triunex/HPVE-Fallen/hardware/master_carrier/renders/pcb_bottom.png

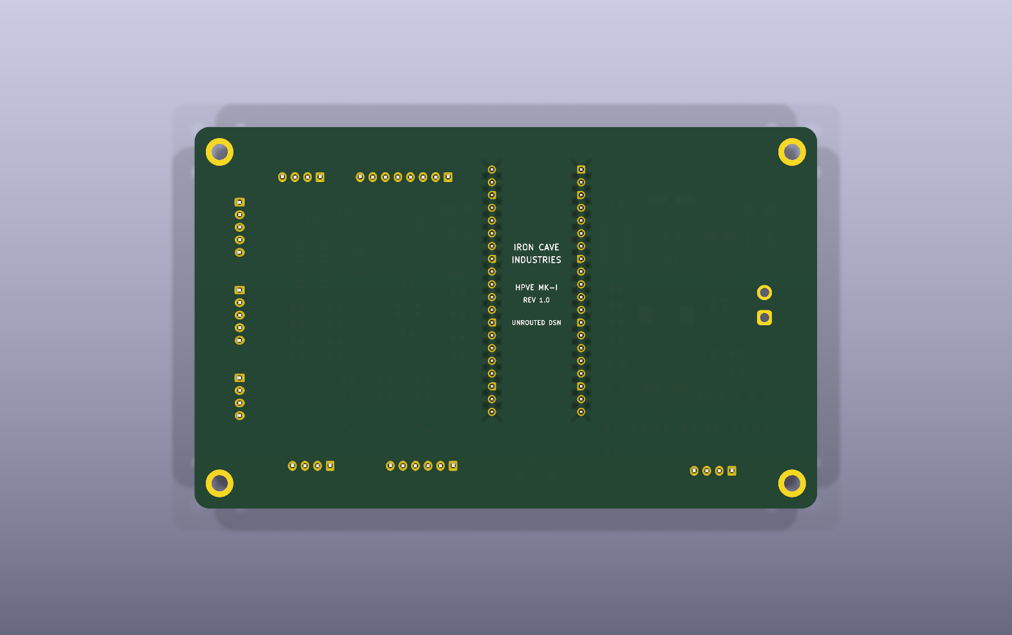
hardware/master_carrier/renders/pcb_bottom.png
