triunex/HPVE-Fallen/hardware/master_carrier/renders/pcb_iso.png

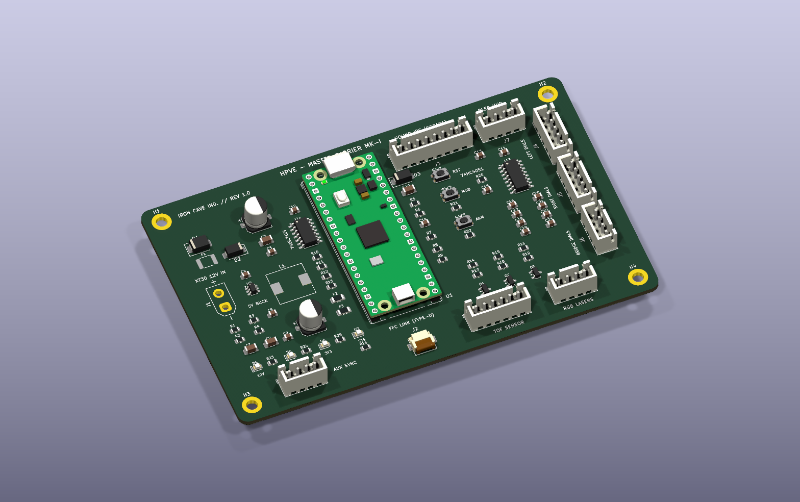
hardware/master_carrier/renders/pcb_iso.png
