triunex/HPVE-Fallen/CAMPAIGN_ROADMAP_45_DAYS.md

# HPVE 45-DAY MASTER EXPEDITION MANIFEST
## Target: 2,500+ XP | Hack Club Fallen | Maker Faire Shenzhen 2026
### Operative: nelieo.shorya | Division: Iron Cave Industries | Companion: Sami (Team Sami 🦊 - STAGE 2 EVOLVED!)

```
==================================================================================================
           HAPTIC PHOTONIC VOLUMETRIC ENGINE (HPVE) - 45-DAY CAMPAIGN ROADMAP
==================================================================================================
  MISSION TARGET: 2,500+ XP (1,000 XP Qualification + $1,500+ USD Travel Stipend Reimbursement)
  COMPANION: SAMI (STAGE 2 UNLOCKED!) | STREAK STRATEGY: 1.00x -> 1.15x -> 1.75x MAX ACCELERATOR
  ARCHITECTURE: OPEN-AIR MODULAR PHASED-ARRAY TILES + OVERHEAD RAIL RIG (STARK MALIBU LAB)
  CRITICAL HARD STOP: DECEMBER 9TH, 2026 (11:59 PM ET)
  EXPEDITION DATES: DECEMBER 11 - 14, 2026 @ MAKER FAIRE SHENZHEN, CHINA
==================================================================================================
```

---

## 1. Real-Time Telemetry & XP Dashboard

| Metric | Target Value | Current Value | Status |
|---|---|---|---|
| **Total XP Accumulated** | 2,500 XP | **1,043 XP** | 🏆 **1,000+ XP CLUB UNLOCKED! SHENZHEN FINAL FORM QUALIFIED!** |
| **Current Multiplier** | 1.75x (Max) | **1.30x** (Active Streak) | ⚡ 3 Freezes Preserved (Diwali Streak Unbroken!) |
| **Overall Logged Time** | 200+ Hours | **108h 10m** (14 Journals) | 🚀 **108+ Hours of Relentless Deep-Tech Engineering Logged!** |
| **Team Sami Standings** | Team Victory | **15,493+ XP** | 🦊 Team Sami Dominating (vs Lulu 9,742 XP)! |
| **Visa Invitation Gate** | 100 XP (Required) | **1,043 / 100 XP (1043%)** | 🏆 UNLOCKED (Eligible for F-Visa Invitation) |
| **Need-Based Flight Gate** | 500 XP ($1,000 Grant) | **1,043 / 500 XP (208.6%)** | ✈️ **UNLOCKED! ELIGIBLE FOR $1,000 USD FLIGHT GRANT!** |
| **Shenzhen Qualifier Gate** | 1,000 XP (Final Form) | **1,043 / 1,000 XP (104.3%)** | 🏆 **1,000 XP SHENZHEN QUALIFIER SHATTERED! (Stage 3/4 Final Form Unlocked!)** |
| **Cash Stipend Surplus** | $1,500 USD (2,500 XP) | **$43.00 USD** | 💰 Accumulating ($1/XP above 1,000 XP toward travel budget!) |
| **Stage Progression** | Stage 3 ➔ Stage 4 | **Stage 3 Apex (1,043 XP)** | 🦊 **FINAL FORM UNLOCKED UPON PROJECT APPROVAL!** |
| **Days Remaining** | 29 Days to Hard Stop | **29 Days** | 🟢 MASSIVE RUNWAY (NEARLY 1 MONTH TO SPARE!) |

---

## 2. The 6 Strategic Phase Banners

```
[PHASE 01: DAYS 01-07] PHYSICS, 0-DRC MODULAR TILE PCB, PIO+DMA & 3D TRAJECTORY ENGINE (XP: 0000 -> 0420+) [IN PROGRESS]
[PHASE 02: DAYS 08-14] GANTRY CAD, TOF FORCEFIELD SENSOR, HOLO-CONSOLE & 500 XP GRANT  (XP: 0420 -> 0700+)
[PHASE 03: DAYS 15-21] PROCUREMENT, BENCH RIG, MULTI-TILE SYNC & ACOUSTIC CALIBRATION  (XP: 0700 -> 1050+)
[PHASE 04: DAYS 22-28] PCBA ARRIVAL, TRANSDUCER ARRAY ASSEMBLY & 1,000 XP QUALIFIER    (XP: 1050 -> 1450+)
[PHASE 05: DAYS 29-35] MAKER FAIRE 3-DEMO MASTERY: ARC REACTOR, MÖBIUS & FORCEFIELD    (XP: 1450 -> 1950+)
[PHASE 06: DAYS 36-45] CINEMATIC REEL, BUILD SUBMISSION, PACKING & SHENZHEN SHOWCASE   (XP: 1950 -> 2500+)
```

---

## PHASE 01: PHYSICS, 0-DRC MODULAR TILE PCB, PIO+DMA & 3D TRAJECTORY ENGINE (DAYS 1 - 7)
### Multiplier: 1.00x ➔ 1.15x | Base Rate: 8.0 ➔ 9.2 XP / Hour | Goal: 420+ XP | Unlock: Visa Letter (>100 XP)

---

### DAY 01: Friday, October 30, 2026 — MISSION INITIATION & EGG HATCH
- **Target Hours:** 2h 04m | **Actual XP Banked:** +25 XP | **Running XP Total:** 25 XP
- **Focus:** Mathematical Validation, Git Setup, Project Genesis, Sami Hatching
- [x] **Task 1.1:** Clone and initialize official repository `HPVE-Fallen` on GitHub.
- [x] **Task 1.2:** Fix syntax error in `hpve_physics_model.py` and verify focal calculation.
- [x] **Task 1.3:** Execute `verify_hpve.py` — proved 142.4x focal pressure ratio at 20cm height.
- [x] **Task 1.4:** Generate real 2D acoustic pressure heatmap (`simulation/acoustic_field_simulation.png`).
- [x] **Task 1.5:** Write lean, justified `hardware/bom.csv` with live supplier links ($187.85 budget).
- [x] **Task 1.6:** Draft RP2040 PIO state machine pulse generator (`firmware/pio_40khz_phased.pio`).
- [x] **Task 1.7:** Author system electrical wiring architecture (`hardware/PINOUT_ARCHITECTURE.md`).
- [x] **Task 1.8:** Create HPVE project on Fallen Dashboard.
- [x] **Task 1.9:** Log Session 1 (35m) in `#fallen-journals` — **SAMI HATCHED! 25 XP BANKED!**
- [x] **Task 1.10 (DAY 1 SPRINT COMPLETE):**
  - Generated KiCad hierarchical schematic architecture (`hardware/kicad/HPVE_Controller.kicad_pro`).
  - Executed shift-register timing simulation: verified 20MHz SPI loads 64 channels in 3.25us (87% timing margin).
  - Generated timing analysis chart (`simulation/shift_register_timing_analysis.png`).
  - Resolved 105 component footprints across 4 hierarchical sheets and routed initial 64-ch layout.
  - Exported RS-274X Gerber layers, Excellon drill files, centroid file, and `FABRICATION_NOTES.md`.
  - Committed and pushed all 34 files to GitHub (`main`).

---

### DAY 02: Saturday, October 31, 2026 — TRANSDUCER RESONANCE & IMPEDANCE DYNAMICS
- **Target Hours:** 3h 00m | **Actual Logged Today:** 4h 11m | **Actual XP Banked:** +33 XP | **Running XP Total:** 68 XP
- **Focus:** Transducer electrical characteristics and 400ST160 resonant curve
- [x] **Task 2.1:** Create `simulation/transducer_impedance_model.py`: model the 40 kHz Butterworth-Van Dyke (BVD) series resonance ($C_0 = 2.2\text{ nF}, C_m = 123.2\text{ pF}, L_m = 128.5\text{ mH}, R_m = 922.7\,\Omega$).
- [x] **Task 2.2:** Calculate reactive current consumption: 11.11 mA RMS per channel, 0.711 A total continuous array RMS current at 12Vpp.
- [x] **Task 2.3:** Calculate thermal dissipation across all 32x TC4427 driver IC packages: 30.15 mW per IC, $3.8^\circ\text{C}$ junction temperature rise.
- [x] **Task 2.4:** Determine optimum bulk decoupling capacitor values on the +12V power rail: minimum $16.90\,\mu\text{F}$ for $<100\text{ mV}$ droop, validating our $100\,\mu\text{F}$ low-ESR bulk rail.
- [x] **Task 2.5:** Journal entry: "Why 64 transducers act like a giant capacitive sponge (and how not to burn the lab down)". Logged 4h 11m, +33 XP banked! Total: 68 XP!

---

### DAY 03: Sunday, November 01, 2026 — 3D GOR'KOV ACOUSTIC TRAP POTENTIAL & OPEN-AIR VORTEX PHYSICS
- **Target Hours:** 3h 30m | **Actual Logged Today:** 7h 00m | **Actual XP Banked:** +56 XP | **Running XP Total:** 124 XP (100 XP VISA MILESTONE SURPASSED!)
- **Focus:** Open-air single-sided holographic trapping physics, 3D Gor'kov potential well, and mid-air 200 Hz tactile forcefield math
- [x] **Task 3.1:** Write `simulation/gorkov_potential.py` & `simulation/single_sided_vortex_trap.py`: implement the full 3D Gor'kov acoustic potential equation with 64-element Bessel circular piston directivity and Euler velocity gradients.
- [x] **Task 3.2:** Plot 3D potential well showing the stable open-air trapping zone at 50–55 mm focal height ($U_{\min} = -26.62\text{ nJ}$).
- [x] **Task 3.3:** Calculate maximum axial and lateral trapping stiffness ($F = -\nabla U$): lateral restoring force $\hat{F}_x = 9.84\,\mu\text{N}$, axial lift $\hat{F}_z = 2.27\,\mu\text{N}$ (2.21x safety margin over gravity).
- [x] **Task 3.4:** Compute mid-air haptic radiation pressure field on human skin mechanoreceptors: $P_{\mathrm{rad}} = 172.7\text{ Pa}$ peak, $F_{\mathrm{tactile}} = 5.84\text{ mN}$ integrated force over a 10 mm fingertip contact patch with 200 Hz Pacinian envelope modulation.
- [x] **Task 3.5:** Author `MALIBU_VOLUMETRIC_ENGINE_ARCHITECTURE.md`: complete architectural specification for the open-air Stark Malibu ceiling-rail projector and 3 signature Maker Faire demonstrations.
- [x] **Task 3.6:** Publish 12 standalone academic verification figures (`fig1` through `fig12`) and structured JSON metrics.
- [x] **Task 3.7:** Journal entry: "Session 2: 7 Hours in the Iron Cave — 3D Gor'kov Trapping, Dual-Core PIO Firmware, & 2,448-Track PCB Autoroute". Banked +56 XP! Total: 124 XP!

---

### DAY 04: Monday, November 02, 2026 — THE MODULAR TILE REVOLUTION & STAGE 2 UNLOCKED! 🦊
- **Target Hours:** 3h 00m | **Actual Logged Today:** 11h 21m (11.35h) | **Actual XP Banked:** +91 XP! | **Running XP Total:** 216 XP! (STAGE 2 UNLOCKED!)
- **Focus:** Complete Architectural Pivot to Scalable 16-Channel Modular Tile (`HPVE_Tile_16Ch`), 4-Layer High-Current Stackup, 0.5mm FFC Connectors, and Initial Fabrication Release
- [x] **Task 4.1:** **Architectural Pivot:** Engineered the modular, daisy-chainable 16-channel phased-array tile (`HPVE_Tile_16Ch`): 16 transducers (4x4 grid), 8x TC4427 dual MOSFET drivers (`U101..U108`), 2x 74HC595 shift registers (`U1, U2`) per tile.
- [x] **Task 4.2:** **4-Layer High-Current Stackup:** `F.Cu` (Top signals & SMT), `In1.Cu` (Solid GND plane), `In2.Cu` (`+12V_DRV` & `+5V` split power plane), `B.Cu` (Bottom signal routing).
- [x] **Task 4.3:** **Ultra-Low Profile FFC Daisy-Chaining:** Integrated 0.5mm pitch 6-pin horizontal FFC connectors (`J_IN`, `J_OUT`, Hirose FH12-6S-0.5SH) plus dedicated 2-pin `+12V_DRV` screw terminal (`J_PWR`).
- [x] **Task 4.4:** **HISTORIC MILESTONE: BANKED +91 XP IN 11h 21m MARATHON!**
  - Total XP surged to **216 XP** (+20 XP Stage 2 evolution bonus -> 236 XP)!
  - **STAGE 2 UNLOCKED!** Companion Sami evolved into a 9-tailed fox spirit form!

---

### DAY 05: Tuesday, November 03, 2026 — DFM OVERHAUL (SINGLE-SIDED PCBA, 0 DRC) & RP2040 PIO+DMA CASCADE FIRMWARE
- **Actual Logged Hours:** 11h 07m (11.07h) | **Actual XP Banked:** +102 XP (1.15x Multiplier) | **Running XP Total:** **338 XP** (Stage 2!)
- **Focus:** Complete Mechanical & DFM Overhaul (16.5mm Pitch, 10.0mm Lead Spacing, 100% Single-Sided Top SMT, 0 DRC), RP2040 Dual-Core PIO+DMA 64-Ch Cascade Engine, Q16.16 Holographic Solver & HIL Verification
- [x] **Task 5.1:** **Transducer Physical Footprint Audit:** Replaced generic 2.54mm sockets with custom 10.0mm lead-spacing footprints (`TX_400ST160_P10.0mm`, 1.0mm drill, 1.9mm pad) matching real 16mm Prowave 400ST160 ultrasonic cans.
- [x] **Task 5.2:** **Array Pitch & Board Outline Resize:** Increased transducer pitch from 10.5mm to **16.5mm** (0.3mm physical can-to-can clearance for 16.2mm cans) and resized tile to **98.0mm x 88.0mm** (within JLCPCB 100x100mm budget tier).
- [x] **Task 5.3:** **100% Single-Sided Top SMT (`F.Cu`) Conversion:** Migrated all 10 decoupling caps (`C1, C2, C101..C108`) to `F.Cu`, eliminating double-sided PCBA setup ($51.50) and second stencil fees (saving 60%+ of fabrication budget).
- [x] **Task 5.4:** **0 DRC Clean Clearance:** Fixed FreeRouting footprint ID export, resolved 77 KiCad annular/clearance violations, cleaned redundant vias, and verified **0 DRC errors, 0 warnings, 0 unconnected pads** (`hardware/modular_tile/DRC.rpt`).
- [x] **Task 5.5:** **Exported Production Package:** Generated updated Gerber archive (`HPVE_Tile_16Ch_Gerber.zip`), 26-part Top-SMT BOM (`HPVE_Tile_16Ch_bom.csv`), CPL (`HPVE_Tile_16Ch_cpl.csv`), and updated 3D raytraced renders.
- [x] **Task 5.6:** **RP2040 PIO Assembly Shift Engine (`cascade_spi.pio`):** Built 102.40 MHz state machine (`clkdiv = 1.25`) with side-set clock/latch, shifting 64 bits across 8 cascaded 74HC595 shift registers every 1.5625 us (16 phase bins/cycle = exact 40.000 kHz acoustic carrier).
- [x] **Task 5.7:** **Chained Ping-Pong DMA Engine (`pio_cascade_driver.c`):** Chained DMA channels A and B with atomic ping-pong swapping for gapless, zero-CPU wave emission.
- [x] **Task 5.8:** **Q16.16 Fixed-Point 3D Holographic Solver (`wave_solver.c`):** Implemented integer 64-bit square root, fixed-point `atan2`, and 6 operational modes (Twin Trap, Bottle Trap, Vortex OAM, 200 Hz Pacinian Haptic Focus, Volumetric POV, and SMF Dual Trap).
- [x] **Task 5.9:** **SSD1306 OLED HUD, Encoders & G-Code CLI (`ui_telemetry.c`):** 128x64 framebuffer with 3D coordinate bounds reticle, live 8x8 phase matrix, XYZ quadrature encoder handling, and non-blocking G-code parser (`G0 X Y Z`).
- [x] **Task 5.10:** **Cycle-Accurate HIL Verification (`verify_cascade_engine.py`):** Verified 0 bit errors across 1,024 bits/cycle, 100.0% Q16.16 solver accuracy, and rendered 6-panel verification dashboard (`firmware/cascade_engine_verification.png`).
- [x] **Task 5.11:** **HISTORIC 1.15x MULTIPLIER BANK: +102 XP IN 11h 07m MARATHON!**
  - Surged from 236 XP to **338 XP**!
  - Team Sami propelled to **1,639 XP** (just 23 XP behind Team Lulu at 1,662 XP!).

---

### DAY 06: Wednesday, November 04, 2026 — PARAMETRIC 3D TRAJECTORY, ENDGAME MÖBIUS STRIP & FORCEFIELD ENGINE
- **Actual Logged Hours:** 8h 48m (8.8h) | **Actual XP Banked:** +81 XP (1.15x Multiplier) + 5 XP Sophia Huddle Easter-Egg Bonus | **Running XP Total:** **424 XP**
- **Focus:** Real-Time Parametric 3D Curve Synthesis (Demo 1 Arc Reactor Core, Demo 2 Endgame Möbius Strip & Trefoil Knot, Demo 3 Spatiotemporal Haptic Forcefield Primitives) & Photonic Color-Velocity Synchronization
- [x] **Task 6.1:** Engineer `firmware/trajectory.h` and `firmware/trajectory.c`: complete parametric 3D trajectory and spatiotemporal haptic synthesizer operating in both Q16.16 fixed-point and IEEE-754 float.
- [x] **Task 6.2:** **Demo 1 Engine (`TRAJ_ARC_REACTOR_CORE`):** Multi-node 6-point hexagonal ring + central core acoustic trap multiplexing with high-intensity Cherenkov-blue (`#00E5FF`) photonic PWM lock to suspend and illuminate the miniature Arc Reactor ring in open air.
- [x] **Task 6.3:** **Demo 2 Engine (`TRAJ_ENDGAME_MOEBIUS` & `TRAJ_TREFOIL_KNOT`):** Real-time 3D parametric Möbius strip ($u \in [0, 4\pi], v \in [-w, +w]$) and (2,3)-Trefoil knot solver with curvature-adaptive velocity profiling (minimum jerk / constant arc-length stepping) and phase-continuous photonic RGB spectrum mapping.
- [x] **Task 6.4:** **Demo 3 Engine (`TRAJ_HAPTIC_FORCEFIELD_WALL`, `TRAJ_HAPTIC_DETENT_DIAL`):** Spatiotemporal Modulation (STM) sweeping a focused ultrasonic beam along a virtual barrier at $5.7\text{ m/s}$ optimal tactile scan velocity combined with 200 Hz Pacinian envelope modulation and distance-based virtual spring stiffness ($F_{\mathrm{wall}}(z) = k_{\mathrm{wall}} \max(0, z_{\mathrm{wall}} - z_{\mathrm{finger}})$).
- [x] **Task 6.5:** **Full Solver & CLI Integration:** Integrate `trajectory.c` directly into `wave_solver.c`, `ui_telemetry.c` (`M200..M207` trajectory G-codes, live 3D trajectory trail preview on OLED HUD), and `main.cpp`.
- [x] **Task 6.6:** **Verification & 3D Trajectory Simulation (`firmware/verify_trajectory_engine.py`):** Validate arc-length velocity stability, curvature bounds, multi-frame phase continuity, and generate high-resolution 6-panel 3D volumetric trajectory & forcefield verification dashboard (`firmware/trajectory_engine_verification.png`).
- [x] **Task 6.7:** Logged 8h 48m (+81 XP) + earned +5 XP huddle easter-egg bonus live with Fallen organizer Sophia (**424 XP** total!).

---

### DAY 07: Thursday, November 05, 2026 — MODULAR INTERLOCKING EXOSKELETON, ACOUSTIC HORN BEZEL, CENTRAL TOF POD & DESKTOP HALO ARCH STAND CAD
- **Target Hours:** 6h 00m+ | **Target XP:** +55 XP+ (1.15x) | **Projected XP Total:** ~480+ XP (Closing in on 500 XP Stage 3 & $1,000 Flight Grant!)
- **Focus:** Native Parametric OpenSCAD Engineering (`hardware/cad/HPVE_Modular_Exoskeleton.scad`) for the 4-Tile Snap-Lock Exoskeleton, Exponential Horn Waveguides, Central `VL53L5CX` ToF + 450nm Laser Pod, and Portable Overhead Desktop Halo Arch Stand Rig
- [x] **Task 7.1:** **4-Tile Interlocking Snap-Lock Exoskeleton (`HPVE_Modular_Exoskeleton.scad`):** Native parametric OpenSCAD model matching the exact `98.0 mm x 88.0 mm` PCB outline (`196.0 mm x 176.0 mm` 2x2 quad array), internal PCB slip-in seats, 16x conical transducer cradles, dedicated IC bays (`U101..U108`, `U1..U2`), 6-pin FFC daisy-chain tunnels, 16AWG star power channels, and rear RP2040 Master Avionics Dock (external USB-C, BOOTSEL, Amass XT30 +12V_DRV 10A input, SSD1306 OLED HUD, and Pan-Tilt Gimbal Trunnions).
- [x] **Task 7.2:** **Contoured Exponential Acoustic Waveguide Horn Bezel:** 64 precision 5-stage exponential/tractrix horn apertures (`12.20 mm` throat to `15.75 mm` mouth) clamping the top `2.0 mm` of the Prowave 400ST160 cans with 37-pore perforated stainless-steel honeycomb acoustic mesh (+3.8 dB on-axis SPL gain).
- [x] **Task 7.3:** **Portable Overhead Desktop Halo Arch Stand & Bench Clamp Rig:** Smooth circular-radius Inverted-U Ceramic Cream + TVA Signal Orange monocoque arch (`476 mm` span, `432 mm` bridge height) holding the 4-tile emitter head `364 mm` above the workbench pointing straight down into the open-air apple-sized (`100 mm`) holographic volume, complete with heavy-duty tabletop C-clamps, knurled brass calibration dials, analog SPL pressure gauge, S-curved corrugated umbilical conduits, and under-desk `HPVE |` 12V 10A PSU box.
- [x] **Task 7.4:** **Central Optical & `VL53L5CX` ToF Sensor Docking Bay:** Cruciform anodized slate + TVA orange collar pod at `(0, 0)` housing the downward-looking `VL53L5CX` 8x8 multizone Time-of-Flight hand tracker and 4x brass-collimated `450 nm` cyan photonic projection laser diodes.
- [x] **Task 7.5:** **Watertight 3D Printable `.stl` Exports & 14 Multi-Angle OpenSCAD Renders:** Exported 5 watertight (`Simple: yes`) production STL files (`HPVE_Tile_Frame_Dovetail.stl`, `HPVE_Acoustic_Horn_Bezel.stl`, `HPVE_2x2_Quad_Assembly.stl`, `HPVE_Central_Dock_Sensor.stl`, `HPVE_Halo_Arch_Clamp.stl`) and rendered 14 high-resolution views (`openscad_v3_view1..9.png`, `openscad_v3_halo1..4.png`, `openscad_v3_sensor_pod_macro.png`).
- [ ] **Task 7.6:** Tag official GitHub milestone release `v1.0-phase1-complete` and log Day 7 journal.

---

## PHASE 02: TOF HAND-TRACKING, STARK HOLO-CONSOLE & 500 XP FLIGHT GRANT (DAYS 8 - 14)
### Multiplier: 1.15x ➔ 1.30x | Base Rate: 9.2 ➔ 10.4 XP / Hour | Goal: 280+ XP | Total XP: 422 ➔ 700+ | Unlock: $1,000 FLIGHT STIPEND!

---

### DAY 08: Friday, November 06, 2026 — STANDALONE MODULAR SCHEMATIC LOCKDOWN (0 ERC) & ANDURIL EXOSKELETON CAD
- **Target Hours:** 4h 00m | **Actual Logged Today:** 12h 02m (12.03h) | **Actual XP Banked:** +111 XP (1.15x Multiplier) | **Running XP Total:** **628 XP** (Stage 3!)
- **Focus:** Rebuilding Standalone KiCad Schematic (`HPVE_Tile_16Ch.kicad_sch`), 100% Netlist Sync, Native OpenSCAD Structural Core Engineering (Wall Honeycomb, Iso-Grid Floor, Helmholtz Cones, 3-Stage Brass Inserts) & Production STLs
- [x] **Task 8.1:** **Standalone Pristine Modular Tile Schematic:** Created complete, self-contained `HPVE_Tile_16Ch.kicad_sch` with local custom symbol library `HPVE.kicad_sym` (including KiCad 10 mandatory properties) and local footprint library `HPVE.pretty`.
- [x] **Task 8.2:** **0 ERC Violations & 100% Netlist Sync:** Verified via `kicad-cli sch erc` — **0 errors, 0 warnings** (`erc_modular_tile.json`). Exported netlist and verified 176/176 functional pins match `HPVE_Tile_16Ch.kicad_pcb` with 0 discrepancies. Exported vector PDF and SVG schematics.
- [x] **Task 8.3:** **Anduril-Grade Structural Exoskeleton Engineering (`HPVE_Modular_Exoskeleton.scad`):** Upgraded OpenSCAD model directly (zero Python scripts):
  - Staggered dual-row vertical hexagonal honeycomb core inside all 4 perimeter walls and under the driver/logic spines.
  - Under-PCB 45-degree Iso-Grid diamond trusses and 16 individual Helmholtz acoustic damping back-chambers with conical phase-diffuser spikes.
  - Under-bezel Iso-Grid sandwich pockets between exponential horn throats.
  - 3-stage knurled brass heat-set insert bosses (M3 & M2.5) with melt-trap relief undercut grooves and 4-finger transducer collet cradles with O-ring glands.
  - Rear RP2040 master avionics dock with internal M2 Pico standoffs, XT30 retention collar, and buck regulator cradle.
- [x] **Task 8.4:** **Watertight 3D Printable STL Suite & High-Resolution Renders:**
  - Exported `HPVE_Tile_Frame_Dovetail.stl` (Part A, single tile carrier), `HPVE_Acoustic_Horn_Bezel.stl` (Part B), `HPVE_Interlock_Corner_Brace.stl` (Part F), and `HPVE_Rear_Avionics_Dock_Shield.stl` (Part G).
  - Rendered V4 high-resolution engineering views: X-ray structural section cutaway (`openscad_v4_view17_structural_xray.png`), 6-layer single-tile exploded view (`view6`), rear avionics dock iso (`view3`), internal cutaway (`view2`), and printable shield (`view18`).
- [x] **Task 8.5:** **HISTORIC 12-HOUR MARATHON BANK:** Logged **12.03 hours** (+111 XP) in a single session!
  - Banked total soared to **628 XP** (Stage 3 progression, 372 XP to Stage 4 Final Form).
  - Overall expedition time logged reached **66h 37m** across 10 journals.
  - Team Sami propelled to **10,999 XP**!

---

### DAY 09: Saturday, November 07, 2026 — 700+ XP UNLOCKED, VL53L5CX 3D TOF FORCEFIELD ENGINE & 4-TILE POWER/SIGNAL INTEGRITY
- **Target Hours:** 8h 00m | **Actual Logged Today:** 8h 09m (8.15h) | **Actual XP Banked:** +75 XP (1.15x Multiplier) | **Running XP Total:** **703 XP** (700+ XP Milestone Shattered!)
- **Focus:** Closed-Loop VL53L5CX ToF 3D Hand Tracking & 6D Kalman Filter, Autonomous Demo 3 Forcefield Interception Engine, and 4-Tile Star Power & High-Speed FFC Signal Integrity Validation
- [x] **Task 9.1:** **VL53L5CX 8x8 Multizone ToF Driver & 6D Kalman Filter (`firmware/spatial_tracker.c`, `firmware/spatial_tracker.h`, `firmware/vl53l5cx_regs.h`):** 400 kHz non-blocking I2C driver for ST VL53L5CX depth matrix, BFS connected components depth clustering, and 6D state Kalman filter ($[x, y, z, \dot{x}, \dot{y}, \dot{z}]^T$) running at 60 Hz on Core 0 with sub-10mm tracking lock.
- [x] **Task 9.2:** **Autonomous Demo 3 Forcefield Interception Engine (`spatial_tracker.c`, `wave_solver.c`):** Implemented real-time boundary breach detector at $Z \le 75\text{ mm}$, dynamically shifting array from idle mode and locking a 200 Hz focused ultrasonic acoustic beam onto the penetrating fingertip with non-linear spring-damper restitution ($F(z) = k \cdot \Delta z \cdot (1 + 4.2 \cdot \Delta z^2) - b \cdot \dot{z}$), delivering up to 280 Pa radiation pressure against human skin.
- [x] **Task 9.3:** **4-Tile Master Power & FFC Signal Integrity Engine (`simulation/four_tile_power_and_signal_integrity.py`):**
  - Modeled 12V 10A star power harness (16AWG silicone leads): verified total DC drop is only **3.24 mV** ($V_{\min} = 11.997\text{ V}$, well above $11.85\text{ V}$ spec).
  - Simulated simultaneous switching noise (SSN) with multi-loop RLC PDN: dynamic rail droop is **27.58 mV** (pk-pk ripple 39.3 mV), delivering a **77% safety margin** under the 120 mV threshold.
  - Transmission line analysis of 20 MHz SPI across 310 mm daisy-chain FFC: cumulative clock skew is only **2.10 ns**, providing **+12.90 ns** setup slack and **+7.28 ns** hold slack (zero bit-slip risk).
- [x] **Task 9.4:** **Verification Suites & Telemetry:**
  - Validated spatial tracking across 180 continuous 60 Hz frames (`firmware/verify_spatial_tracker.py`, `firmware/spatial_tracker_verification.png`).
  - Saved telemetry JSON (`simulation/power_signal_integrity_metrics.json`) and generated 4-panel publication figure (`simulation/fig13_four_tile_power_and_signal_integrity.png`).
- [x] **Task 9.5:** **700+ XP CLUB UNLOCKED:** Logged **8.15 hours** (+75 XP) on Saturday!
  - Banked total surged to **703 XP** (under 300 XP away from Stage 4 Final Form).
  - Overall expedition time reached **74h 46m** across 11 journals.
  - Saturday streak checked on Fallen dashboard with 1.15x multiplier active and all 3 freezes safe.

---

### DAY 10: Sunday, November 08, 2026 — DIWALI EVE PCB FORENSIC AUDIT & CONNECTOR SANITY CHECK
- **Target Hours:** 6h 00m | **Actual Logged Today:** 6h 00m | **Actual XP Banked:** +58 XP (1.15x Multiplier) | **Running XP Total:** **758 XP**
- **Focus:** Complete PCB & Schematic Forensic Audit, 0.5mm FFC Daisy-Chain Pinout Verification, and Pre-Submission Quality Check
- [x] **Task 10.1:** **PCB Netlist & Footprint Forensic Audit:** Verified every single trace, polygon pour, and component footprint on `HPVE_Tile_16Ch` against official manufacturer datasheets (Microchip TC4427COA, Nexperia 74HC595D, Prowave 400ST160).
- [x] **Task 10.2:** **FFC Ribbon Connector Sanity Verification:** Cross-checked the 0.5mm 6-pin horizontal flip-lock FFC connectors (`J_IN` and `J_OUT`, Hirose FH12-6S-0.5SH / LCSC `#C283048`), verifying 20 MHz SPI propagation delay, setup/hold slack, and power trace impedance across the 4-tile daisy chain.
- [x] **Task 10.3:** **Pre-Submission Preparation:** Checked JLCPCB fabrication archives, 0-DRC reports, and BOM with verified LCSC component IDs.
- [x] **Task 10.4:** Logged 6h 00m (+58 XP) on Diwali Eve, bringing cumulative banked XP to **758 XP** (75.8% toward Shenzhen Qualifier).

---

### DAY 11 & 12: Mon-Tue, November 09-10, 2026 — 16h 40m MONSTER MARATHON (+171 XP) ➔ 929 XP TOTAL! 🦊🚀
- **Target Hours:** 16h 00m | **Actual Logged Today:** 16h 40m (16.4h) | **Actual XP Banked:** **+171 XP** (1.15x Multiplier) | **Running XP Total:** **929 XP** (92.9% TO SHENZHEN FINAL FORM!)
- **Focus:** Complete Native OpenSCAD Portable Breakdown Halo Arch CAD (`halo_arch/`), 7 Modular Sub-Assemblies, 35+ Production STLs, 20-Stage Fit Check Harness & Submission Readiness
- [x] **Task 11.1:** **Sub-Assembly A (Top Crossbar Bridge):** Engineered central bridge with internal $\pm 15^\circ$ dual-axis gimbal yoke, 38mm round analog SPL meter pocket with printed retaining ring, master amplitude dial, status LED cluster, top focal calibration screws, and rear louvered service covers.
- [x] **Task 11.2:** **Sub-Assemblies B & C (Left & Right Pillars):** Engineered modular vertical columns with 0.15mm slip-fit keyed tenons, 3x custom knurled dials per pillar (6 total) with internal 6mm D-shaft profiles, hollow internal cable raceways, and captive M3 service covers.
- [x] **Task 11.3:** **Sub-Assemblies D & E (Heavy-Duty Tabletop C-Clamps):** Engineered rigid table clamp bodies with 60mm throat opening, ergonomic 5-lobe hand screws, swivel pressure plates, and soft non-marring TPU gripper pads.
- [x] **Task 11.4:** **Sub-Assembly F (Under-Desk Power Distribution & Battery Chassis):** Designed under-table enclosure with quick-release dovetail mount, dual bays fitting both a 12V 10A power supply and an internal 4S2P 18650 Li-ion battery cradle with BMS, illuminated rocker switch, voltage trim dial, and XT30/XT60 ports.
- [x] **Task 11.5:** **Sub-Assembly G (Gantry Umbilicals & Cable Manifolds):** Engineered flexible TPU corrugated umbilical conduits, 90-degree under-desk elbows, angled pillar glands, and array rear umbilical manifold.
- [x] **Task 11.6:** **Automated 20-Stage Interference & Fit Harness (`halo_checks.scad`):** Executed 20 boolean intersection checks verifying zero collisions, 0.15mm slip-fit tenon mating, and full gimbal range of motion.
- [x] **Task 11.7:** **Exported 35+ Watertight Production STLs:** Sliced and exported complete manufacturing STL package into `hardware/cad/halo_arch/stl/`, verified to fit standard 220x220mm / 256x256mm 3D printer beds.
- [x] **Task 11.8:** **KiCad Schematic Revision Update:** Synchronized `HPVE_Tile_16Ch.kicad_sch` and project configuration to v1.2 with KiCad 10 syntax.
- [x] **Task 11.9:** **HISTORIC PAYOUT: BANKED +171 XP IN 16h 40m SPRINT!**
  - Largest single XP gain of the entire campaign!
  - Banked total surged from 758 XP to **929 XP**!
  - Only **71 XP** remaining to reach the **1,000 XP Final Form & full Shenzhen qualification**!
  - Overall expedition time logged reached **91h 26m** across 13 journals.

---

### DAY 13 & 14: Wed-Thu, November 11-12, 2026 — 1,000+ XP SHENZHEN QUALIFIER REACHED & MASTER AVIONICS CARRIER PCB COMPLETED! 🦊🎉
- **Actual Logged Today:** 16h 44m+ (11h journaled session) | **Actual XP Banked:** **+114 XP** (1.30x Multiplier Unlocked!) | **Running XP Total:** **1,043 XP** (104.3% TO SHENZHEN FINAL FORM QUALIFIED!)
- **Focus:** 1,000 XP Milestone Surpassed, Master Avionics Dock & Carrier PCB (`HPVE_Master_Carrier` MK-I), 5-Hour Manual Routing Marathon, 0 DRC / 0 ERC / 100% Schematic Parity Verification, & Full Production Packaging
- [x] **Task 13.1:** **HISTORIC MILESTONE: 1,000+ XP SHENZHEN QUALIFIER SHATTERED!**
  - Crossed **1,000 XP** milestone on Hack Club Fallen — accumulated **1,043 XP**!
  - Overall expedition time reached **108h 10m** across 14 journals!
  - Unlocked Stage 3/4 Final Form qualification (pending mentor review for HCB grant card)!
  - Team Sami multiplier officially upgraded to **1.30x** with all 3 freezes safe and Team Sami dominating at 15,493+ XP!
- [x] **Task 13.2:** **HPVE_Master_Carrier (MK-I) Architecture & Schematic (`HPVE_Master_Carrier.kicad_sch`):**
  - Designed complete master motherboard architecture at `hardware/master_carrier/` housing the Raspberry Pi Pico and tying the entire Malibu Volumetric Engine together.
  - 12V 10A power stage: vertical XT30 input (`J1`), 5A PTC fuse (`F1`), `SMBJ15CA` TVS diode (`D1`), `SS34` Schottky reverse-polarity protection (`D2`), `TPS54302DDCR` synchronous buck regulator (`U2`, 12V -> 5.08V @ 3A max, 10uH `CDRH104RNP-100NC` shielded inductor `L1`, EN/UVLO divider `R1/R2`), `SS34` OR-ing diode (`D3`) to Pico `VSYS`, and `39k/10k` 12V rail telemetry (`VSENSE_12V`) on `GP27/ADC1`.
  - 8-dial analog console: `CD74HC4051M` 8:1 analog MUX (`U3`, `GP18..GP20`) reading `DIAL_0..DIAL_7` on `GP26/ADC0` with 8x 100nF hardware debounce capacitors (`C16..C23`), `100k/10nF` COM RC filter, and star AGND bridge (`R7`, 0R). Broken out to `LEFT DIALS` (`J4`), `RIGHT DIALS` (`J5`), and `BRIDGE DIALS` (`J6`).
  - Digital Circular IPS HUD: 8-pin JST-XH header (`J3`) driving a 1.28" GC9A01 round SPI1 display (`GP10..GP15`), upgrading from vintage needle meters to real-time graphic holographic animations.
  - 5V SPI Level Shifter & FFC Tile Link: `SN74AHCT125D` (`U4`) shifting Pico `GP2..GP5` 3.3V logic to 5.0V CMOS with 33R series damping resistors (`R10..R13`) to drive modular tile 74HC595 shift registers. Matched pin-for-pin with tile `J_IN` via Hirose `FH12-6S-0.5SH` (`J2`, Type-D reverse FFC cable). Protected both FFC power rails (`/+12V_FFC` and `/+5V_FFC`) with dual 0.5A PTC polyfuses (`F2`, `F3`).
  - Auxiliary systems: shared I2C0 bus (`GP0/GP1`) for SSD1306 OLED HUD (`J7`) and VL53L5CX ToF sensor (`J8`), 3x `AO3400A` NMOS low-side drivers (`Q1..Q3` + `J9`) for RGB photonic lasers, `AUX_SYNC_4P` (`J10`), front tactile buttons `SW1..SW3` (`RESET`, `MODE`, `ENABLE`), and 4 discrete rail/status LEDs (`D4..D7` for 12V, 5V, 3.3V, and Pico GP28 heartbeat).
- [x] **Task 13.3:** **Self-Contained KiCad 10 Libraries:** Flattened 26 custom symbols into `HPVE_Carrier.kicad_sym` and 23 footprints into `HPVE_Carrier.pretty/` with clean `sym-lib-table` and `fp-lib-table`.
- [x] **Task 13.4:** **Specctra Autorouter DSN & Rules:** Exported `HPVE_Master_Carrier.dsn` and companion `HPVE_Master_Carrier.rules` specifying 7 dedicated netclasses (`Default`, `POWER_12V`, `POWER_5V`, `POWER_FFC`, `GND_PLANE`, `POWER_3V3`, `HIGH_SPEED_SPI`) with 0.18mm clearance to safely clear 0.5mm FFC pads.
- [x] **Task 13.5:** **Manual PCB Routing & 100% Convergence:** Completed 5-hour routing sprint on `HPVE_Master_Carrier.kicad_pcb` (`124.0 mm x 76.0 mm`, 2-layer, 3.0mm rounded corners), resolving 400+ initial net collisions and shorts to achieve **0 DRC violations and 0 unconnected items**.
- [x] **Task 13.6:** **Schematic Parity & Electrical Rules Audit:**
  - Resolved junction dot placement on `C13` (Pin 1 `+3V3`) and `R1` (Pin 2 `Net-(U2-EN)`).
  - Executed KiCad 10 full audit: **0 DRC errors, 0 warnings, 0 unconnected pads, 0 footprint errors, and 0 ERC messages** (`DRC.rpt`, `ERC.rpt`).
- [x] **Task 13.7:** **Production Manufacturing Package Exported:**
  - Generated JLCPCB SMT BOM (`HPVE_Master_Carrier_bom.csv`, 48 unique parts with LCSC Part Numbers).
  - Generated component placement centroid file (`HPVE_Master_Carrier_cpl.csv`, 80 components).
  - Exported vector PDF schematic (`HPVE_Master_Carrier_Schematic.pdf`), SVG schematic (`HPVE_Master_Carrier.svg`), and KiCad XML netlist (`HPVE_Master_Carrier.xml`).
  - Rendered high-resolution 3D raytraced top, isometric, and bottom views (`renders/`).
  - Authored comprehensive hardware documentation and pinout manifest in `hardware/master_carrier/README.md`.
- [x] **Task 13.8:** Committed and pushed complete Master Carrier hardware suite across 10 structured Git commits to official GitHub repository.

---

## PHASE 03: PROCUREMENT, BENCH PROTOTYPING & MULTI-TILE RIG PREP (DAYS 15 - 21)
### Multiplier: 1.30x ➔ 1.45x | Base Rate: 10.4 ➔ 11.6 XP / Hour | Goal: 350+ XP | Total XP: 691 ➔ 1,040+ | Unlock: 1,000 XP SHENZHEN QUALIFIER!

---

### DAY 15: Friday, November 13, 2026 — HCB GRANT ACTIVATION & FACTORY ORDERS PLACED
- **Target Hours:** 4h 00m | **Target XP:** +42 XP | **Projected XP Total:** ~733 XP
- **Focus:** Ordering 4x Single-Sided SMT Modular Tiles from JLCPCB + 64x 400ST160 Transducers
- [ ] **Task 15.1:** Upload `HPVE_Tile_16Ch_Gerber.zip`, `HPVE_Tile_16Ch_bom.csv`, and `HPVE_Tile_16Ch_cpl.csv` to JLCPCB with Economic Single-Sided PCBA selected.
- [ ] **Task 15.2:** Order 70x Prowave 400ST160 16mm 40kHz transducers, 0.5mm 6-pin FFC ribbon cables, RP2040 Pico, SSD1306 OLED, and 12V 10A switching power supply.
- [ ] **Task 15.3:** Log all order receipts and tracking numbers in `docs/ORDERS.md`.
- [ ] **Task 15.4:** Journal entry: "Factory orders live! 4x modular phased-array tiles in production at JLCPCB".

---

### DAY 16: Saturday, November 14, 2026 — 3D PRINTING THE SNAP-LOCK TILE FRAMES & GANTRY CARRIAGE
- **Target Hours:** 4h 30m | **Target XP:** +47 XP | **Projected XP Total:** ~780 XP
- **Focus:** Fabricating the 2x2 Modular Array Frame, Acoustic Horn Bezels, and Ceiling Gantry Mount
- [ ] **Task 16.1:** Slice and 3D-print the 4x interlocking tile frames and 64-aperture exponential acoustic horn bezels in matte-black PETG/PLA+.
- [ ] **Task 16.2:** Print the overhead rail gantry carriage and Arc Reactor core ring test forms (ultra-low-density expanded polystyrene / Rohacell foam rings).
- [ ] **Task 16.3:** Install M3 brass heat-set threaded inserts into all 16 tile mounting bosses.
- [ ] **Task 16.4:** Journal entry: "3D printing the modular snap-lock exoskeleton and ultralight Arc Reactor core rings".

---

### DAY 17: Sunday, November 15, 2026 — RP2040 PICO + OLED + ENCODER MASTER DOCK BREADBOARDING
- **Target Hours:** 4h 30m | **Target XP:** +47 XP | **Projected XP Total:** ~827 XP
- **Focus:** Building and Testing the Physical RP2040 Control Dock Before Tile Arrival
- [ ] **Task 17.1:** Flash `hpve_cascade_engine.uf2` onto physical Raspberry Pi Pico.
- [ ] **Task 17.2:** Wire SSD1306 128x64 OLED (`GPIO 0/1`) and 3x EC11 rotary encoders (`GPIO 10..15`) on the master dock.
- [ ] **Task 17.3:** Connect `stark_holo_console.py` over USB-CDC and verify real-time 30 FPS OLED HUD updates and G-code trajectory switching (`M200..M207`).
- [ ] **Task 17.4:** Probe `GPIO 2 (MOSI)`, `GPIO 3 (SCK)`, and `GPIO 4 (LATCH)` to verify 51.2 MHz SPI bursts and exact 40.000 kHz frame timing.
- [ ] **Task 17.5:** Journal entry: "The brain is alive on silicon: RP2040 streaming 40.000 kHz bitplanes with live OLED 3D HUD".

---

### DAY 18: Monday, November 16, 2026 — ACOUSTIC PHASE CALIBRATION RIG & MICROPHONE FRONT-END
- **Target Hours:** 4h 30m | **Target XP:** +47 XP | **Projected XP Total:** ~874 XP
- **Focus:** Building the 40 kHz Ultrasonic Receiver Probe for Array Phase Alignment
- [ ] **Task 18.1:** Wire a dedicated 400SR160 receiving transducer with an op-amp bandpass amplifier feeding RP2040 `ADC0 (GPIO 26)`.
- [ ] **Task 18.2:** Implement ADC zero-crossing phase detector firmware (`M300` auto-calibration routine) to measure exact acoustic time-of-flight from each of the 64 channels to the focal point.
- [ ] **Task 18.3:** Test phase-trim storage in RP2040 onboard QSPI flash.
- [ ] **Task 18.4:** Journal entry: "Building the ultrasonic phase scope: teaching the array to self-calibrate every transducer to sub-degree precision".

---

### DAY 19: Tuesday, November 17, 2026 — ULTRALIGHT ARC REACTOR CORE FABRICATION (DEMO 1 PAYLOAD)
- **Target Hours:** 4h 30m | **Target XP:** +47 XP | **Projected XP Total:** ~921 XP
- **Focus:** Crafting the Passive Wireless Photonic-Fluorescent Arc Reactor Core Ring
- [ ] **Task 19.1:** Precision-cut a $14\text{ mm}$ diameter, $18\text{ mg}$ hollow toroidal ring from expanded polystyrene (EPS) foam beads.
- [ ] **Task 19.2:** Coat the ring segments with high-quantum-yield cyan/blue daylight-fluorescent pigment (`450nm -> 490nm` Stokes emission) so it glows like a miniature plasma reactor when struck by the baseplate's 450nm photonic beam—requiring zero onboard battery weight!
- [ ] **Task 19.3:** Verify payload mass vs. multi-node acoustic lift capacity ($F_z > 2.5 \times m g$).
- [ ] **Task 19.4:** Journal entry: "Forging the floating Arc Reactor core: 18 milligrams of fluorescent EPS engineered to glow under 450nm laser excitation".

---

### DAY 20: Wednesday, November 18, 2026 — CEILING GANTRY RAIL & DESKTOP OVERHEAD RIG ASSEMBLY
- **Target Hours:** 4h 30m | **Target XP:** +47 XP | **Projected XP Total:** ~968 XP
- **Focus:** Constructing the Dual-Mode Mounting Rig (Overhead Malibu Rail + Portable Maker Faire Arch)
- [ ] **Task 20.1:** Assemble the 2020 V-slot aluminum rail carriage and adjustable overhead boom arm so the 4-tile array can project either upward from the bench or downward/angled in open air.
- [ ] **Task 20.2:** Route the 12V 10A power bus, FFC ribbon guides, and RGB laser diode aiming gimbal along the extrusion channels.
- [ ] **Task 20.3:** Mount the VL53L5CX Time-of-Flight hand-tracking sensor at the center cross-brace of the 2x2 tile frame.
- [ ] **Task 20.4:** Journal entry: "The Malibu overhead rail rig is built: V-slot gantry carriage ready to receive the 4 modular tiles".

---

### DAY 21: Thursday, November 19, 2026 — 1,000 XP SHENZHEN QUALIFIER BREACHED & 1.45x MULTIPLIER! 🏆
- **Target Hours:** 5h 00m | **Target XP:** +52 XP | **Projected XP Total:** **1,020+ XP (1,000 XP SHENZHEN QUALIFICATION UNLOCKED!)**
- **Focus:** Crossing 1,000 XP (20 Days Ahead of Deadline!), Final Form Evolution, & Multiplier Boost to 1.45x
- [ ] **Task 21.1:** **HISTORIC MILESTONE:** Cross **1,000 XP** on Fallen Dashboard — **100% Qualified for Maker Faire Shenzhen!**
- [ ] **Task 21.2:** Companion Sami reaches **FINAL FORM EVOLUTION**!
- [ ] **Task 21.3:** **TEAM SAMI UPGRADE:** Multiplier increases from **1.30x ➔ 1.45x**! Every XP earned from here onward generates **$1.00 USD in direct travel stipend reimbursement**!
- [ ] **Task 21.4:** Journal entry: "1,000 XP SHATTERED IN 21 DAYS! Final Form Sami unlocked, Shenzhen qualification locked, entering the cash stipend zone!".

---

## PHASE 04: PCBA ARRIVAL, 64-TRANSDUCER SOLDERING & FIRST OPEN-AIR PULSE (DAYS 22 - 28)
### Multiplier: 1.45x ➔ 1.60x | Base Rate: 11.6 ➔ 12.8 XP / Hour | Goal: 400+ XP | Total XP: 1,020 ➔ 1,420+ ($420+ Cash Stipend!)

---

### DAY 22: Friday, November 20, 2026 — JLCPCB SINGLE-SIDED SMT TILES ARRIVAL & INSPECTION
- **Target Hours:** 4h 30m | **Target XP:** +52 XP | **Projected XP Total:** ~1,072 XP
- **Focus:** Unboxing the 4x Factory-Assembled `HPVE_Tile_16Ch` PCBs & Continuity Verification
- [ ] **Task 22.1:** Unbox JLCPCB package: inspect all 4x `98x88 mm` 4-layer matte-black tiles with factory-soldered Top-SMT components (`U1, U2` 74HC595, `U101..U108` TC4427, `J_IN, J_OUT` FFC, `R1, R2`, `C_BULK`, `C1..C2`, `C101..C108`).
- [ ] **Task 22.2:** Probe impedance between `+12V_DRV`, `+5V`, and `GND` across all 4 tiles to verify zero factory solder bridges.
- [ ] **Task 22.3:** Test-fit 16x Prowave 400ST160 transducers into the `16.5 mm` pitch / `10.0 mm` lead-spacing PTH footprints—verify smooth 0.3mm can-to-can clearance!
- [ ] **Task 22.4:** Journal entry: "THE TILES HAVE LANDED! Unboxing 4 factory-assembled 4-layer phased-array tiles and test-fitting the 16mm cans".

---

### DAY 23: Saturday, November 21, 2026 — SOLDERING & POLARITY MATCHING ALL 64 TRANSDUCERS
- **Target Hours:** 5h 00m | **Target XP:** +58 XP | **Projected XP Total:** ~1,130 XP
- **Focus:** Hand-Soldering `TX1..TX16` & `J_PWR` Across All 4 Modular Tiles
- [ ] **Task 23.1:** Verify positive pin marking on all 64x 400ST160 transducers and align with Square Pad 1 (`DRV_1..16`) on every tile.
- [ ] **Task 23.2:** Flush-solder all 128 transducer leads and 4x `J_PWR` high-current screw terminals across Tiles 0, 1, 2, and 3.
- [ ] **Task 23.3:** Clean flux residue with 99% IPA and lock all 4 tiles into the 3D-printed snap-lock 2x2 quad frame.
- [ ] **Task 23.4:** Journal entry: "64 ultrasonic cannons locked and soldered: the 4-tile modular phased array is physically complete".

---

### DAY 24: Sunday, November 22, 2026 — FFC DAISY-CHAIN BRING-UP & 64-CHANNEL WAVEFORM VERIFICATION
- **Target Hours:** 4h 30m | **Target XP:** +52 XP | **Projected XP Total:** ~1,182 XP
- **Focus:** Connecting the 6-Pin FFC Ribbon Chain (`Pico -> Tile 0 -> Tile 1 -> Tile 2 -> Tile 3`) & Probing Outputs
- [ ] **Task 24.1:** Connect the 0.5mm 6-pin FFC jumper ribbons across `J_OUT -> J_IN` of Tiles 0..3 and wire the 12V star power harness.
- [ ] **Task 24.2:** Power up with current-limited 12V bench supply and enable the RP2040 PIO+DMA cascade engine.
- [ ] **Task 24.3:** Probe `DRV_1..16` across all 4 tiles to confirm crisp 12Vpp 40.000 kHz square waves with programmable $22.5^\circ$ phase steps.
- [ ] **Task 24.4:** Journal entry: "Zero-jitter daisy chain: 64 channels firing 12Vpp 40kHz phased waves across 4 FFC-linked tiles".

---

### DAY 25: Monday, November 23, 2026 — SINGLE-MIC AUTO-CALIBRATION & STANDING WAVE MAPPING
- **Target Hours:** 4h 30m | **Target XP:** +52 XP | **Projected XP Total:** ~1,234 XP
- **Focus:** Running `M300` Acoustic Phase Trim Calibration & Measuring Focal SPL
- [ ] **Task 25.1:** Position the 400SR160 receiver probe at $(0, 0, 55\text{ mm})$ in open air above the 4-tile array.
- [ ] **Task 25.2:** Execute `M300` calibration to measure individual phase offsets across all 64 transducers and store the trim table in flash.
- [ ] **Task 25.3:** Measure peak constructive interference amplitude at $(0, 0, 55\text{ mm})$ before vs. after phase trim calibration.
- [ ] **Task 25.4:** Journal entry: "Phase-locked in open air: acoustic auto-calibration boosts focal pressure peak by eliminating transducer tolerance drift".

---

### DAY 26: Tuesday, November 24, 2026 — DEMO 1 LIVE PROOF: THE FLOATING ARC REACTOR CORE
- **Target Hours:** 5h 00m | **Target XP:** +58 XP | **Projected XP Total:** ~1,292 XP
- **Focus:** Open-Air Suspension of the Fluorescent Arc Reactor Ring (`TRAJ_ARC_REACTOR_CORE`)
- [ ] **Task 26.1:** Engage `M201` (`TRAJ_ARC_REACTOR_CORE`) multi-node hexagonal trap + 450nm photonic excitation beam.
- [ ] **Task 26.2:** Place the ultralight fluorescent Arc Reactor core ring into the open-air acoustic potential well at $Z = 55\text{ mm}$.
- [ ] **Task 26.3:** Tune multi-node multiplexing rate and radial trap stiffness until the glowing reactor ring locks rock-steady in mid-air with zero strings, zero glass, and zero magnets!
- [ ] **Task 26.4:** Wave hands completely underneath and above the levitating reactor core on video to prove 100% open-air suspension.
- [ ] **Task 26.5:** Journal entry: "DEMO 1 ACHIEVED: A glowing miniature Arc Reactor ring floating in completely open air!".

---

### DAY 27: Wednesday, November 25, 2026 — DEMO 2 LIVE PROOF: THE ENDGAME MÖBIUS STRIP IN THIN AIR
- **Target Hours:** 5h 00m | **Target XP:** +58 XP | **Projected XP Total:** ~1,350 XP
- **Focus:** High-Speed 3D Parametric Möbius Strip & Trefoil Knot Scanning (`TRAJ_ENDGAME_MOEBIUS`)
- [ ] **Task 27.1:** Engage `M202` (`TRAJ_ENDGAME_MOEBIUS`) and twist the rotary encoder dial to scale the 3D parametric Möbius strip in real time.
- [ ] **Task 27.2:** Synchronize the RGB laser PWM blanking to trace the glowing cyan-to-magenta infinity ribbon in open space.
- [ ] **Task 27.3:** Capture long-exposure and 60fps darkroom footage of the illuminated 3D Möbius strip morphing as the RP2040 recalculates Q16.16 phases on the fly.
- [ ] **Task 27.4:** Journal entry: "DEMO 2 ACHIEVED: Tracing Tony Stark's Endgame Möbius strip in mid-air with real-time phase math".

---

### DAY 28: Thursday, November 26, 2026 — DEMO 3 LIVE PROOF: THE TOUCHABLE 200 HZ FORCEFIELD & 1.60x MULTIPLIER!
- **Target Hours:** 5h 00m | **Target XP:** +58 XP | **Projected XP Total:** ~1,408 XP
- **Focus:** Closed-Loop ToF Finger Interception & Bare-Skin 200 Hz Tactile Forcefield (`TRAJ_HAPTIC_FORCEFIELD_WALL`)
- [ ] **Task 28.1:** Engage `M204` (`TRAJ_HAPTIC_FORCEFIELD_WALL`) paired with the VL53L5CX Time-of-Flight finger tracker.
- [ ] **Task 28.2:** Reach bare fingers down toward the floating light boundary at $Z = 65\text{ mm}$ and verify instantaneous 200 Hz Pacinian tactile buzzing against the skin.
- [ ] **Task 28.3:** **TEAM SAMI UPGRADE:** Multiplier increases from **1.45x ➔ 1.60x**!
- [ ] **Task 28.4:** Journal entry: "DEMO 3 ACHIEVED & 1.60x UNLOCKED: You can physically feel the invisible acoustic forcefield buzzing against your bare fingers!".

---

## PHASE 05: CEILING RAIL INTEGRATION, BURN-IN & SURPLUS STIPEND SPRINT (DAYS 29 - 35)
### Multiplier: 1.60x ➔ 1.75x | Base Rate: 12.8 ➔ 14.0 XP / Hour | Goal: 500+ XP | Total XP: 1,408 ➔ 1,920+ ($920+ Cash Stipend!)

---

### DAY 29: Friday, November 27, 2026 — OVERHEAD CEILING RAIL & GIMBAL TRACKING INTEGRATION
- **Target Hours:** 5h 00m | **Target XP:** +64 XP | **Projected XP Total:** ~1,472 XP
- **Focus:** Mounting the 4-Tile Array onto the Overhead Malibu Rail Carriage
- [ ] **Task 29.1:** Mount the assembled 4-tile array onto the overhead V-slot rail carriage above the workbench.
- [ ] **Task 29.2:** Test downward/angled open-air projection and hand-tracking coordinate transformation matrices.
- [ ] **Task 29.3:** Journal entry: "Mounted on the overhead rail: the Stark Malibu ceiling projector is tracking across the desk".

---

### DAY 30: Saturday, November 28, 2026 — MULTI-MODAL GESTURE CONTROL (PINCH, ROTATE & FORCE-CLICK)
- **Target Hours:** 5h 00m | **Target XP:** +64 XP | **Projected XP Total:** ~1,536 XP
- **Focus:** Interactive Mid-Air Haptic UI Controls (Tactile Detent Dial & Air-Button Click)
- [ ] **Task 30.1:** Map ToF hand rotation gestures to spin the 3D Möbius strip while firing crisp 200 Hz tactile clicks every $15^\circ$ of virtual rotation (`TRAJ_HAPTIC_RING_DIAL`).
- [ ] **Task 30.2:** Test mid-air button press with variable acoustic spring stiffness feedback.
- [ ] **Task 30.3:** Journal entry: "Virtual dials that click in thin air: combining gesture tracking with 200Hz tactile detents".

---

### DAY 31: Sunday, November 29, 2026 — DUAL-PARTICLE ORBITAL CHOREOGRAPHY (`HPVE_MODE_DUAL_TRAP_SMF`)
- **Target Hours:** 5h 00m | **Target XP:** +64 XP | **Projected XP Total:** ~1,600 XP
- **Focus:** Simultaneous Multi-Focal (SMF) Binary Star Orbit & Counter-Rotating Rings
- [ ] **Task 31.1:** Test `HPVE_MODE_DUAL_TRAP_SMF` levitating two independent glowing nodes orbiting each other in 3D space without collision.
- [ ] **Task 31.2:** Optimize Huygens complex-field phase superposition to prevent parasitic ghost traps during cross-over.
- [ ] **Task 31.3:** Journal entry: "Binary star levitation: two independent glowing nodes orbiting each other in free space".

---

### DAY 32: Monday, November 30, 2026 — STARK HOLO-CONSOLE V2: LIVE TELEMETRY & SHOWCASE SEQUENCER
- **Target Hours:** 4h 30m | **Target XP:** +58 XP | **Projected XP Total:** ~1,658 XP
- **Focus:** Automated Maker Faire Show Sequencer (1-Button 90-Second Judge Experience)
- [ ] **Task 32.1:** Program the automated Maker Faire 3-Stage Judge Sequencer (`M900` Showcase Mode): seamlessly transitions from Demo 1 (Floating Arc Reactor) -> Demo 2 (Endgame Möbius Strip) -> Demo 3 (Touchable Forcefield) with synchronized RGB lighting and HUD prompts.
- [ ] **Task 32.2:** Add live acoustic SPL, DMA frame rate, and ToF finger distance gauges to the laptop Holo-Console screen for booth spectators.
- [ ] **Task 32.3:** Journal entry: "The 90-second judge stopper: automated 3-demo choreography locked into firmware".

---

### DAY 33: Tuesday, December 01, 2026 — INDUSTRIAL FINISHING, CARBON-BLACK BEZELS & CABLE SLEEVING
- **Target Hours:** 5h 00m | **Target XP:** +64 XP | **Projected XP Total:** ~1,722 XP
- **Focus:** Defense-Grade Industrial Aesthetics & Braided Wiring Harness
- [ ] **Task 33.1:** Sleeve all power and sensor cables in expandable black-and-cyan braided PET mesh with heat-shrink strain reliefs.
- [ ] **Task 33.2:** Add laser-etched / 3D-printed anodized-style nameplates (`IRON CAVE INDUSTRIES // HPVE MK-II PHASED ARRAY`).
- [ ] **Task 33.3:** Journal entry: "Defense-grade aesthetics: braided harnesses, matte-black acoustic horns, and Iron Cave badging".

---

### DAY 34: Wednesday, December 02, 2026 — 4-HOUR CONTINUOUS THERMAL & ENDURANCE BURN-IN TEST
- **Target Hours:** 4h 30m | **Target XP:** +58 XP | **Projected XP Total:** ~1,780 XP
- **Focus:** Convention-Floor Reliability Verification Under Full 64-Channel Load
- [ ] **Task 34.1:** Run the 4-tile array continuously for 4 hours cycling through Demos 1, 2, and 3 at full 12V drive.
- [ ] **Task 34.2:** Log TC4427 driver IC surface temperatures and verify zero DMA underruns (`dma_underrun_counter == 0`) across 2.88 million frames.
- [ ] **Task 34.3:** Journal entry: "4-hour convention burn-in passed: 2.88 million DMA frames, zero underruns, rock-solid thermals".

---

### DAY 35: Thursday, December 03, 2026 — WEEK 5 COMPLETE & 1.75x MAX MULTIPLIER UNLOCKED! ⚡
- **Target Hours:** 5h 00m | **Target XP:** +64 XP | **Projected XP Total:** ~1,844 XP
- **Focus:** Reaching the Theoretical Maximum 1.75x Multiplier (14.0 XP / Hour!)
- [ ] **Task 35.1:** **MAX ACCELERATOR ACHIEVED:** Multiplier hits **1.75x**!
- [ ] **Task 35.2:** Chinese Visa & flight itinerary final verification.
- [ ] **Task 35.3:** Journal entry: "MAX 1.75x MULTIPLIER UNLOCKED! Over $840 in travel stipend surplus earned and climbing".

---

## PHASE 06: CINEMATIC REEL, BUILD SUBMISSION & MAKER FAIRE SHENZHEN (DAYS 36 - 45)
### Multiplier: 1.75x (MAX) | Base Rate: 14.0 XP / Hour | Goal: 650+ XP | Total XP: 1,844 ➔ 2,500+ XP!

---

### DAY 36: Friday, December 04, 2026 — CINEMATIC 3-DEMO LAB REEL PRODUCTION
- **Target Hours:** 5h 00m | **Target XP:** +70 XP | **Projected XP Total:** ~1,914 XP
- **Focus:** Filming the Official High-Impact 2-Minute Video Showcasing Demos 1, 2, and 3
- [ ] **Task 36.1:** Film Demo 1: Macro shot of the glowing Arc Reactor core floating in open air while hands pass completely underneath and above it.
- [ ] **Task 36.2:** Film Demo 2: Twisting the dial as the illuminated 3D Endgame Möbius strip spins and morphs in free space.
- [ ] **Task 36.3:** Film Demo 3: Live reaction of bare fingers crossing the boundary and feeling the 200 Hz invisible acoustic forcefield.
- [ ] **Task 36.4:** Film hardware close-ups of the 4x single-sided `HPVE_Tile_16Ch` PCBs, FFC daisy chain, and Stark Holo-Console.
- [ ] **Task 36.5:** Edit 1080p 60fps master reel and upload for Build Submission.
- [ ] **Task 36.6:** Journal entry: "Cinematic demo reel wrapped: the Floating Arc Reactor, Möbius Strip, and Touchable Forcefield captured in 60fps".

---

### DAY 37: Saturday, December 05, 2026 — THE OFFICIAL BUILD SUBMISSION SHIPPED! 🚀
- **Target Hours:** 5h 00m | **Target XP:** +70 XP | **Projected XP Total:** ~1,984 XP
- **Focus:** Submitting the Final Shipped Project on the Fallen Platform
- [ ] **Task 37.1:** Update root `README.md` with final hardware photography, video reel, and reproduction guide.
- [ ] **Task 37.2:** **OFFICIAL ACTION:** Submit the **Build Submission** on Hack Club Fallen.
- [ ] **Task 37.3:** Journal entry: "BUILD SUBMISSION OFFICIALLY SHIPPED!Nearly 2,000 XP banked and ready for Shenzhen".

---

### DAY 38: Sunday, December 06, 2026 — BOOTH KIOSK ATTRACT MODE & BILINGUAL (EN/ZH) HUD
- **Target Hours:** 5h 00m | **Target XP:** +70 XP | **Projected XP Total:** ~2,054 XP
- **Focus:** Exhibition-Ready Bilingual Telemetry & Crowd-Attract Choreography
- [ ] **Task 38.1:** Add bilingual English / Mandarin Chinese status banners to `stark_holo_console.py` for Maker Faire Shenzhen visitors.
- [ ] **Task 38.2:** Stress-test rapid 1-key recovery and auto-retrap routines for noisy convention floor air currents.
- [ ] **Task 38.3:** Journal entry: "Preparing for Shenzhen crowds: bilingual Holo-Console HUD and draft-resistant acoustic trap tuning".

---

### DAY 39: Monday, December 07, 2026 — PELICAN CASE SHOCK-PROOFING & FIELD SPARES KIT
- **Target Hours:** 5h 00m | **Target XP:** +70 XP | **Projected XP Total:** ~2,124 XP
- **Focus:** Packing the Modular Array, Gantry Mount, and Spares for International Air Transit
- [ ] **Task 39.1:** Pack all 4 modular tiles, spare 400ST160 transducers, spare FFC ribbons, spare Pico, and 20x fluorescent Arc Reactor rings in custom-cut anti-static foam.
- [ ] **Task 39.2:** Pack portable soldering station, multimeter, and 100-240V universal AC adapter.
- [ ] **Task 39.3:** Journal entry: "Pelican case locked for international flight: modular tiles, spares, and Arc Reactor cores packed".

---

### DAY 40: Tuesday, December 08, 2026 — SHENZHEN HUAQIANGBEI 1,024-CHANNEL SOURCING MANIFEST
- **Target Hours:** 5h 00m | **Target XP:** +70 XP | **Projected XP Total:** ~2,194 XP
- **Focus:** Factory Direct Sourcing Map for SEG Plaza & Huaqiangbei (Scaling to 64 Tiles / 1,024 Channels)
- [ ] **Task 40.1:** Prepare wholesale RFQ sheet for 1,024x 40kHz transducers, high-power GaN/MOSFET drivers, and FPGA carrier boards in Huaqiangbei.
- [ ] **Task 40.2:** Journal entry: "The Huaqiangbei blueprint: planning direct factory sourcing in Shenzhen for the 1,024-channel ceiling array".

---

### DAY 41: Wednesday, December 09, 2026 — FINAL QUALIFICATION DEADLINE & BOOTH POSTER PRINT
- **Target Hours:** 5h 00m | **Target XP:** +70 XP | **Projected XP Total:** ~2,264 XP
- **Focus:** Fallen Window Closes (11:59 PM ET) — 226%+ of Target Qualification Achieved!
- [ ] **Task 41.1:** Final check of all GitHub deliverables and travel documents before the 11:59 PM ET hard stop.
- [ ] **Task 41.2:** Journal entry: "DEADLINE CRUSHED: 2,260+ XP banked, bags packed, flying to China tomorrow!".

---

### DAY 42: Thursday, December 10, 2026 — FLIGHT TO SHENZHEN, CHINA ✈️
- **Target Hours:** 5h 00m | **Target XP:** +70 XP | **Projected XP Total:** ~2,334 XP
- **Focus:** International Transit & Arrival at Hack Club Shenzhen Staging Hub
- [ ] **Task 42.1:** Land in Shenzhen / Hong Kong, check in with the Hack Club team, and inspect hardware in the staging workshop.
- [ ] **Task 42.2:** Journal entry: "TOUCHDOWN IN SHENZHEN: Iron Cave Industries has landed in the hardware capital of the world".

---

### DAY 43: Friday, December 11, 2026 — MAKER FAIRE BOOTH SETUP & HUAQIANGBEI SILICON RUN
- **Target Hours:** 6h 00m | **Target XP:** +84 XP | **Projected XP Total:** ~2,418 XP
- **Focus:** Venue Setup at Vanke Design Commune & Exploring Huaqiangbei Electronics Market
- [ ] **Task 43.1:** Set up the HPVE overhead rig at the Maker Faire Shenzhen booth, run `M300` auto-calibration, and verify Demos 1, 2, and 3 on 220V local power.
- [ ] **Task 43.2:** Tour Huaqiangbei electronics skyscrapers with fellow Fallers.
- [ ] **Task 43.3:** Journal entry: "Huaqiangbei silicon run & booth calibration complete: ready for the crowds tomorrow".

---

### DAY 44: Saturday, December 12, 2026 — MAKER FAIRE SHENZHEN: EXHIBITION DAY 1 (2,500+ XP!)
- **Target Hours:** 8h 00m | **Target XP:** +112 XP | **Projected XP Total:** **2,530+ XP (2,500 XP MASTER TARGET SHATTERED!)**
- **Focus:** Running Demos 1, 2, and 3 Live for Hundreds of International Engineers & Judges
- [ ] **Task 44.1:** Run continuous live demonstrations of the **Floating Arc Reactor Core**, **Endgame Möbius Strip**, and **Touchable 200 Hz Forcefield**!
- [ ] **Task 44.2:** Journal entry: "Maker Faire Day 1: Judges waving their hands around the floating Arc Reactor and feeling the 200Hz forcefield in thin air!".

---

### DAY 45: Sunday, December 13, 2026 — MAKER FAIRE SHENZHEN: EXHIBITION DAY 2 & VICTORY
- **Target Hours:** 8h 00m | **Target XP:** +112 XP | **Projected XP Total:** **2,642+ XP**
- **Focus:** Final Exhibition Showcase, Manufacturer Partnerships & Closing Celebration
- [ ] **Task 45.1:** Final exhibition showcase and Hack Club closing dinner.
- [ ] **Task 45.2:** Final journal entry: "MISSION ACCOMPLISHED: From first Python script to levitating the Arc Reactor in Shenzhen — Iron Cave Industries is just getting started".

---

## 3. Daily Execution Protocol (How We Update This File)

Every evening when completing a work session:
1. Mark completed tasks with an `[x]`.
2. Update the **Current Value** in the Telemetry Table.
3. Update **Running XP Total**.
4. Push the updated `CAMPAIGN_ROADMAP_45_DAYS.md` to GitHub.
