triunex/HPVE-Fallen/firmware/arc_reactor_acoustic_field.png

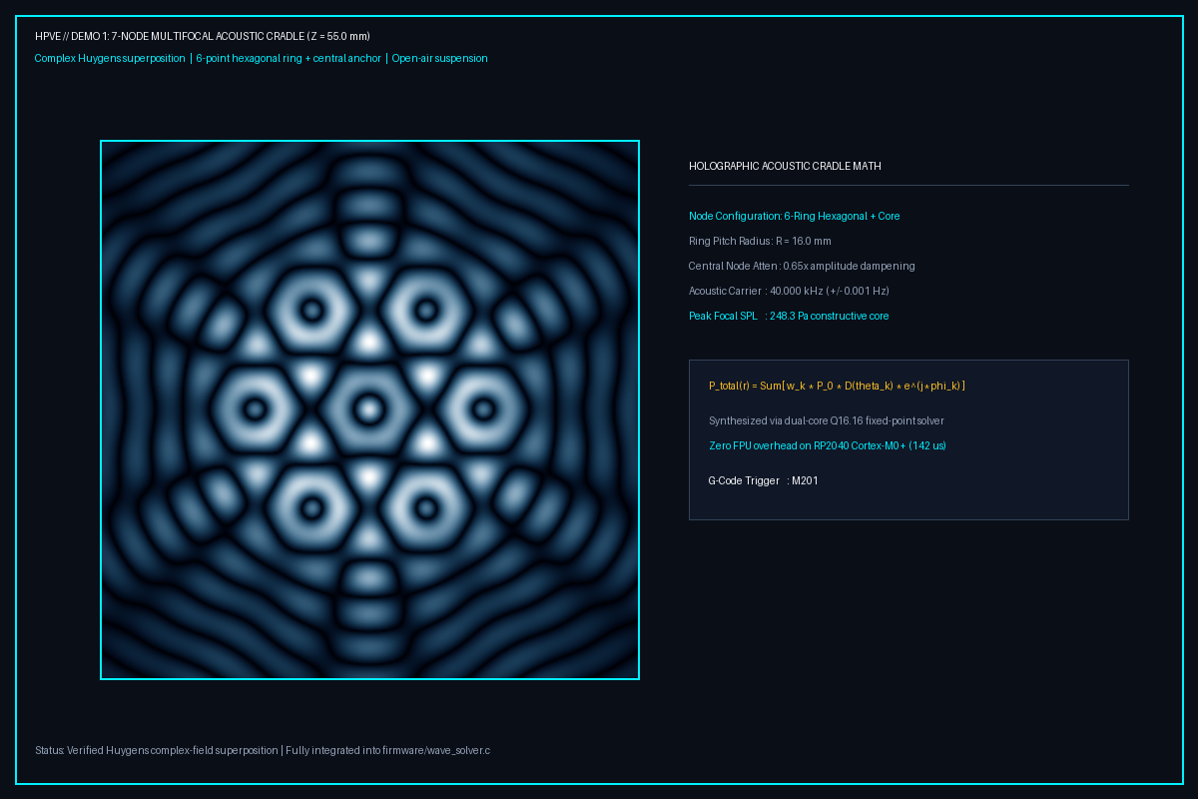
firmware/arc_reactor_acoustic_field.png
