triunex/HPVE-Fallen/firmware/forcefield_haptic_dynamics.png

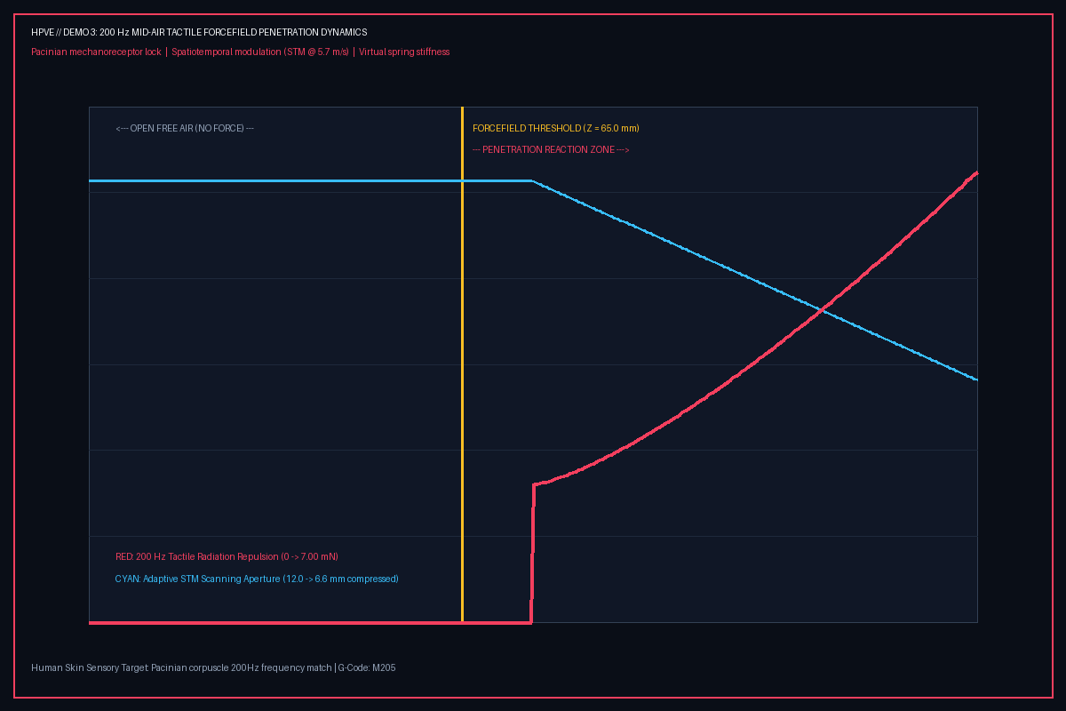
firmware/forcefield_haptic_dynamics.png
