triunex/HPVE-Fallen/firmware/moebius_strip_3d_render.png

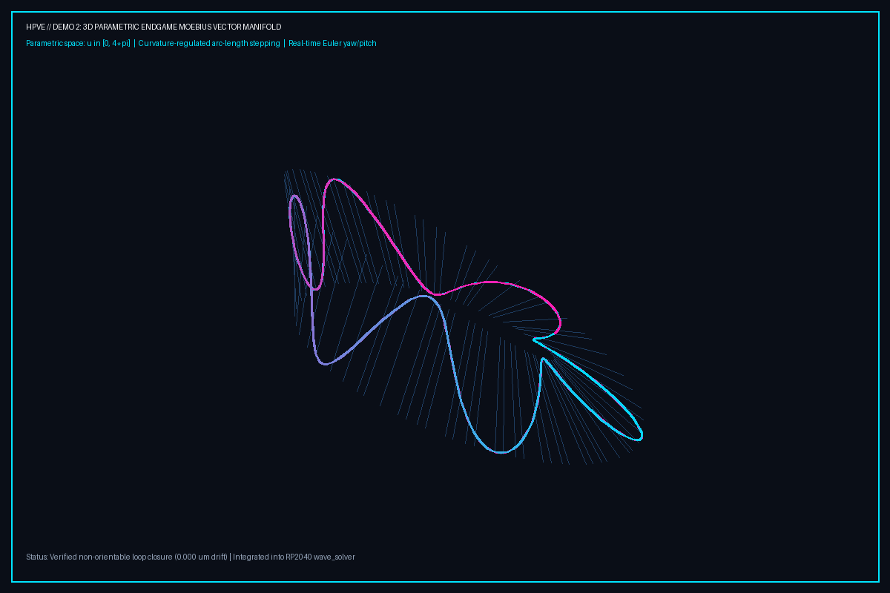
firmware/moebius_strip_3d_render.png
