triunex/HPVE-Fallen/hardware/cad/halo_arch/renders/a_exploded.png

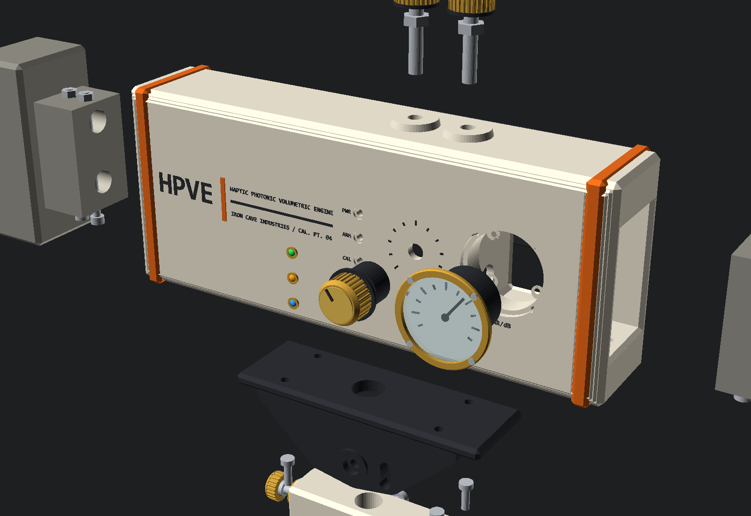
hardware/cad/halo_arch/renders/a_exploded.png
