triunex/HPVE-Fallen/hardware/cad/halo_arch/renders/a_face_macro.png

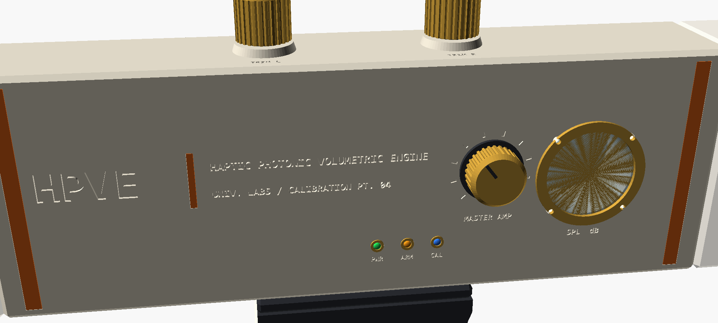
hardware/cad/halo_arch/renders/a_face_macro.png
