triunex/HPVE-Fallen/hardware/cad/halo_arch/renders/a_face_macro_zoom.png

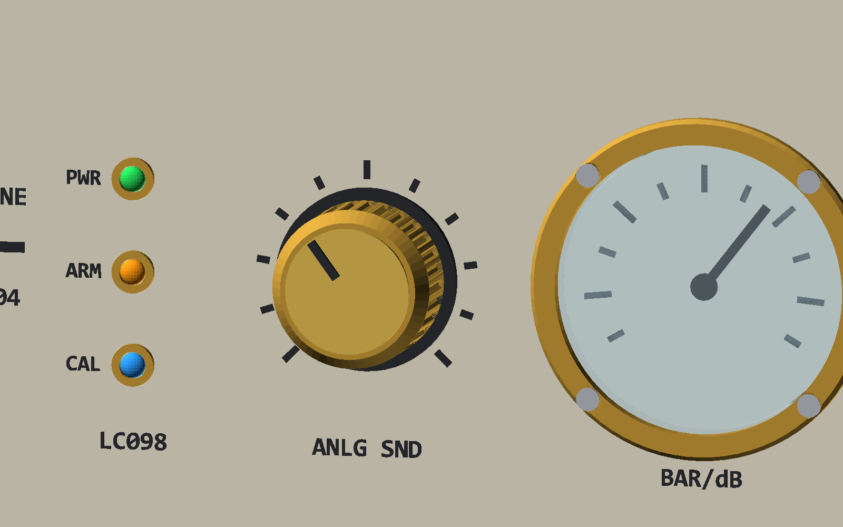
hardware/cad/halo_arch/renders/a_face_macro_zoom.png
