triunex/HPVE-Fallen/hardware/cad/halo_arch/renders/a_front_ortho.png

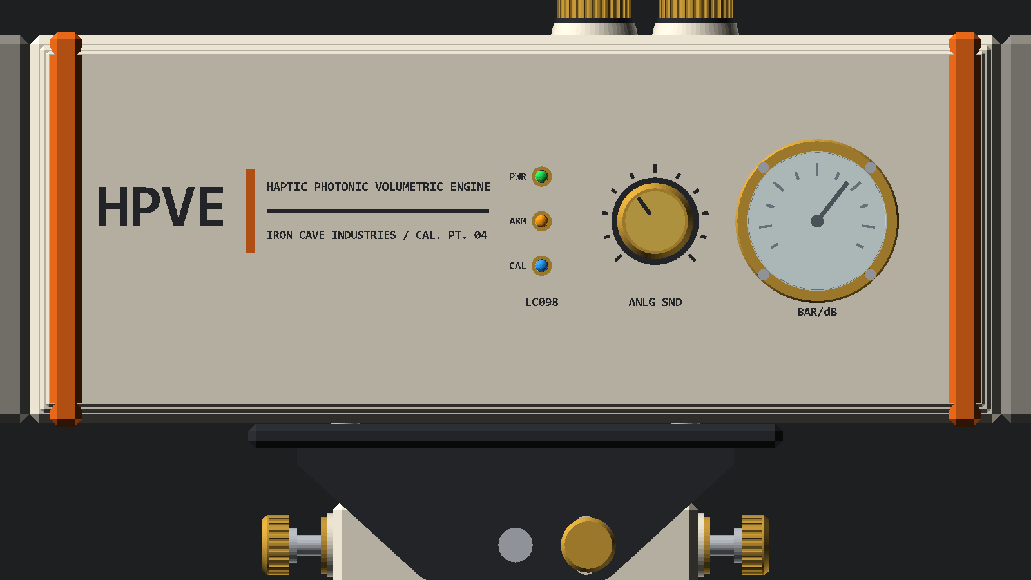
hardware/cad/halo_arch/renders/a_front_ortho.png
