triunex/HPVE-Fallen/hardware/cad/halo_arch/renders/a_gauge_section.png

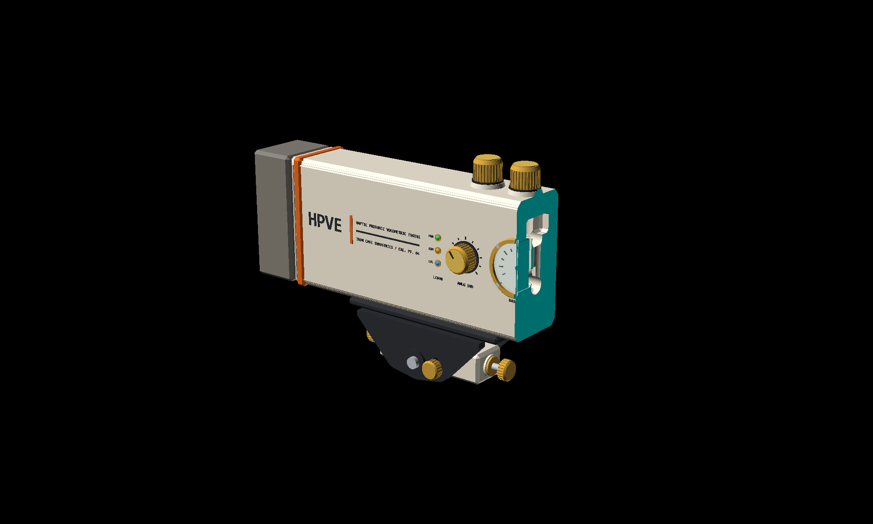
hardware/cad/halo_arch/renders/a_gauge_section.png
