triunex/HPVE-Fallen/hardware/cad/halo_arch/renders/a_inside_front_wall_holes.png

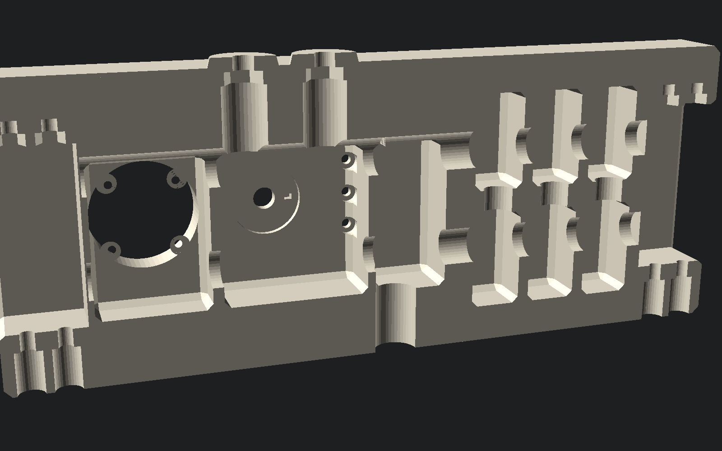
hardware/cad/halo_arch/renders/a_inside_front_wall_holes.png
