triunex/HPVE-Fallen/hardware/cad/halo_arch/renders/a_inside_xray_hardware.png

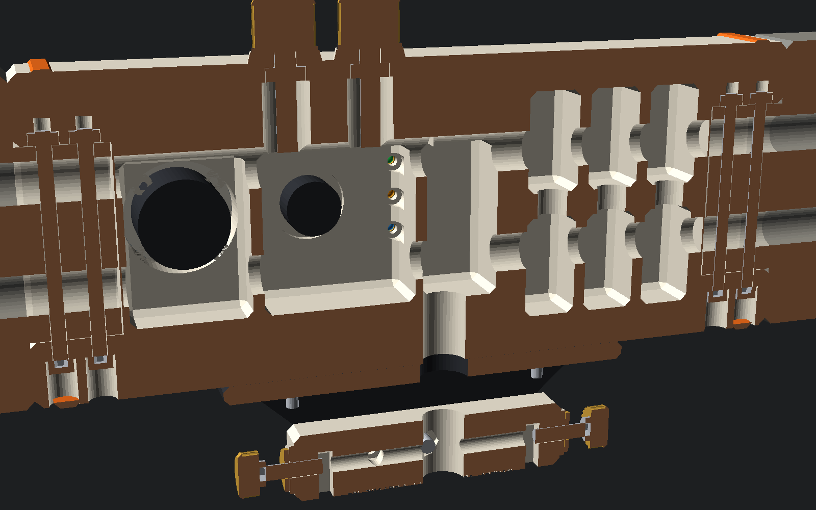
hardware/cad/halo_arch/renders/a_inside_xray_hardware.png
