triunex/HPVE-Fallen/hardware/cad/halo_arch/renders/a_iso_front.png

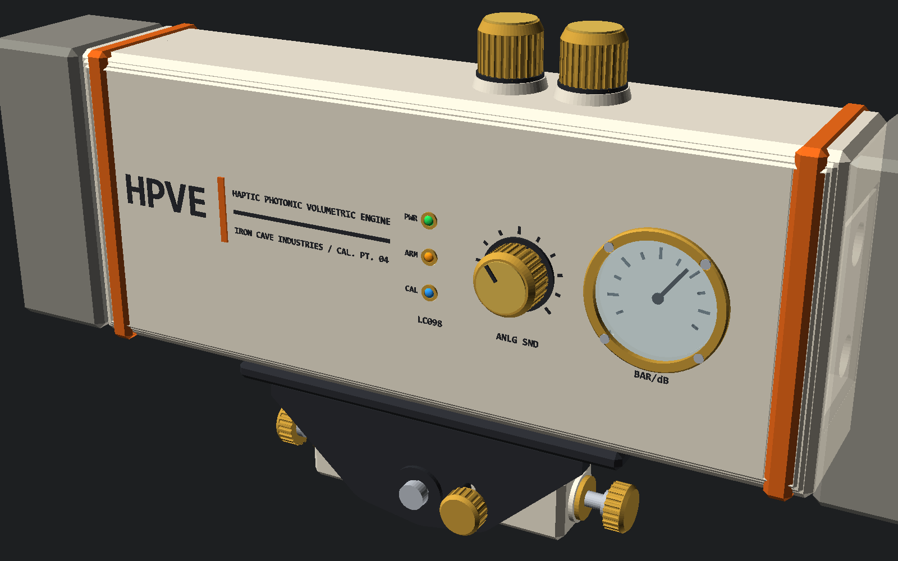
hardware/cad/halo_arch/renders/a_iso_front.png
