triunex/HPVE-Fallen/hardware/cad/halo_arch/renders/a_iso_rear.png

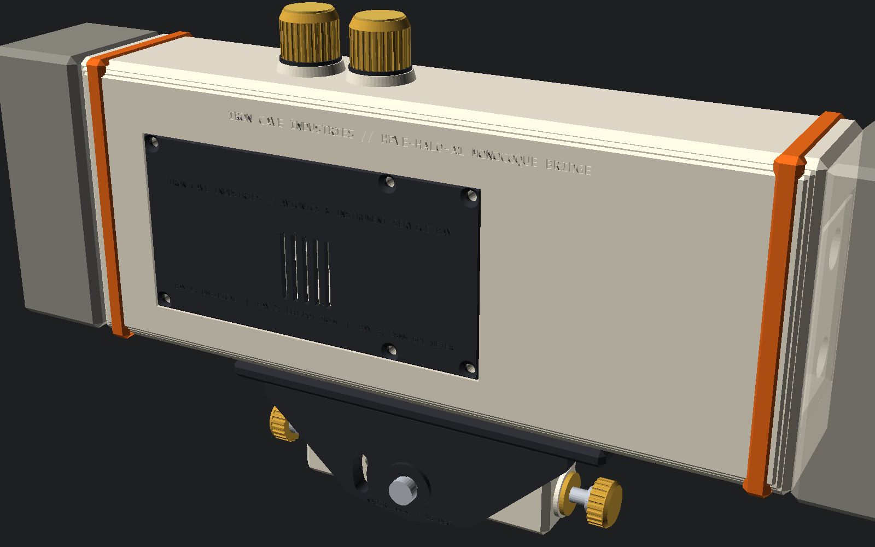
hardware/cad/halo_arch/renders/a_iso_rear.png
