triunex/HPVE-Fallen/hardware/cad/halo_arch/renders/a_rear_open_service_bay.png

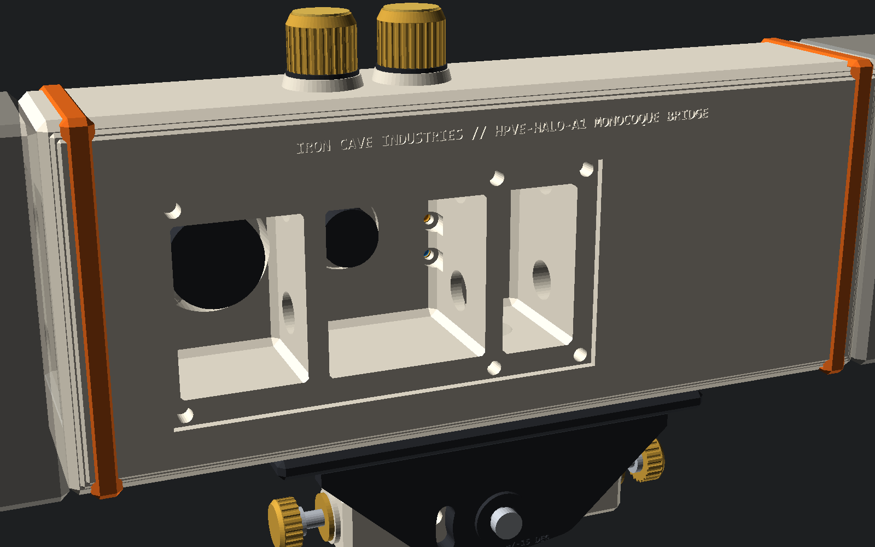
hardware/cad/halo_arch/renders/a_rear_open_service_bay.png
