triunex/HPVE-Fallen/hardware/cad/halo_arch/renders/a_section_body_truss.png

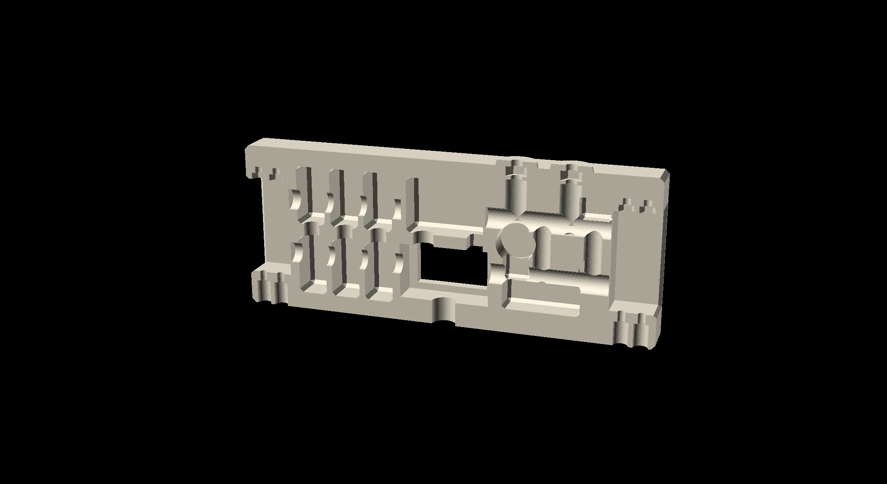
hardware/cad/halo_arch/renders/a_section_body_truss.png
