triunex/HPVE-Fallen/hardware/cad/halo_arch/renders/a_section_y0.png

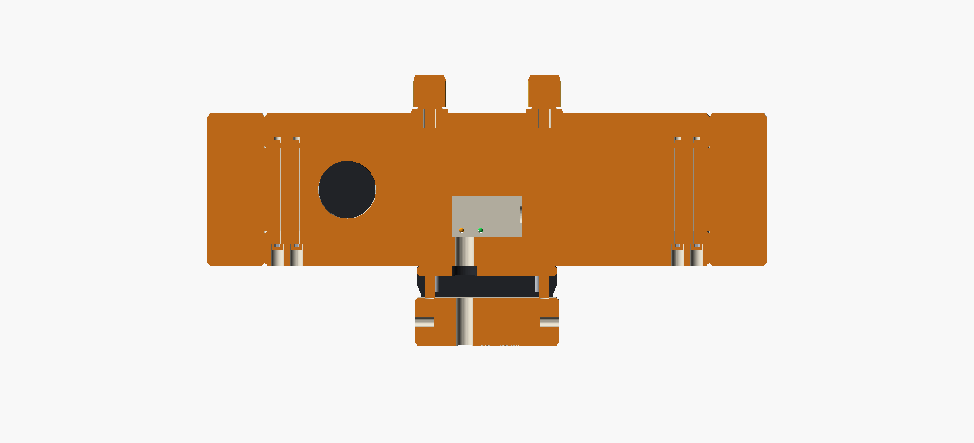
hardware/cad/halo_arch/renders/a_section_y0.png
