triunex/HPVE-Fallen/hardware/cad/halo_arch/renders/a_section_y0_iso.png

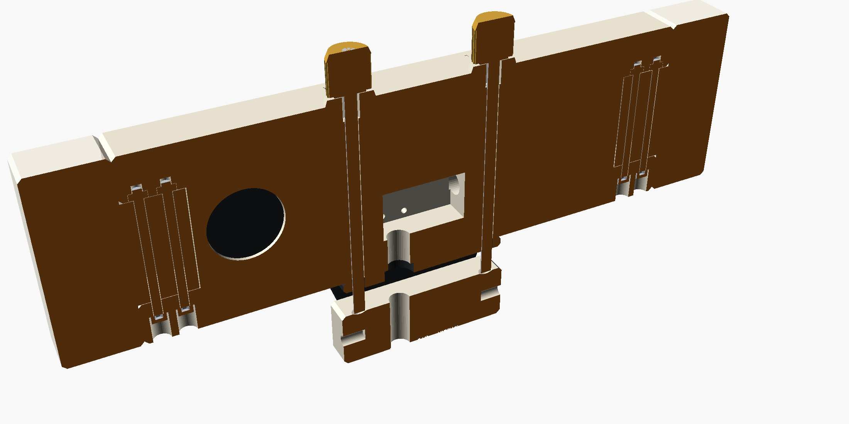
hardware/cad/halo_arch/renders/a_section_y0_iso.png
