triunex/HPVE-Fallen/hardware/cad/halo_arch/renders/bc_pillar_exploded.png

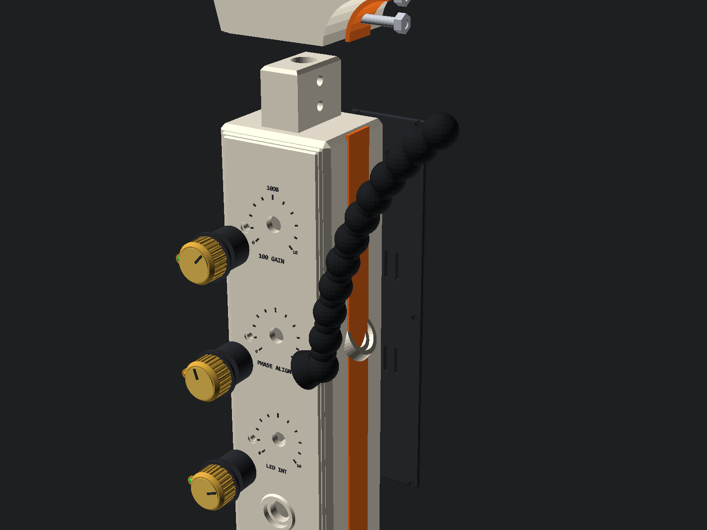
hardware/cad/halo_arch/renders/bc_pillar_exploded.png
