triunex/HPVE-Fallen/hardware/cad/halo_arch/renders/bc_pillar_inside_holes.png

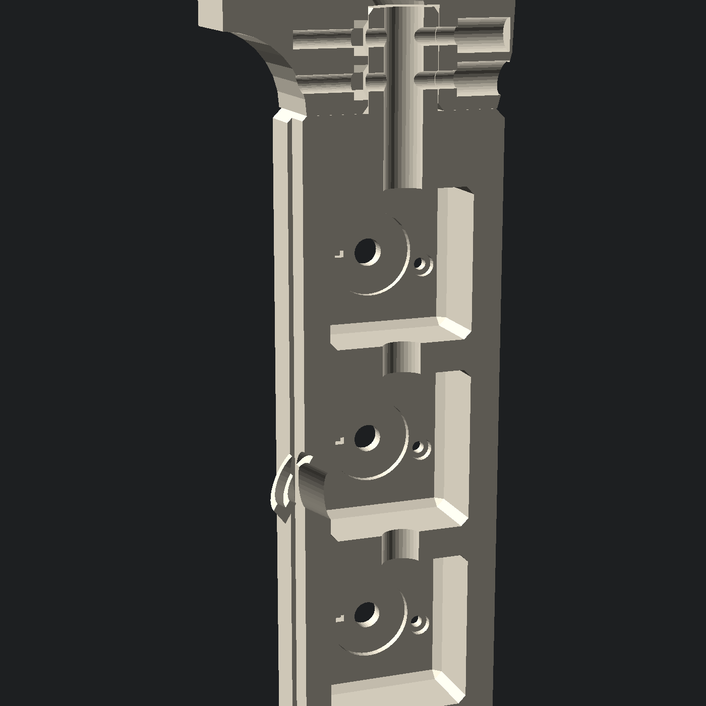
hardware/cad/halo_arch/renders/bc_pillar_inside_holes.png
