triunex/HPVE-Fallen/hardware/cad/halo_arch/renders/bc_pillar_macro_front.png

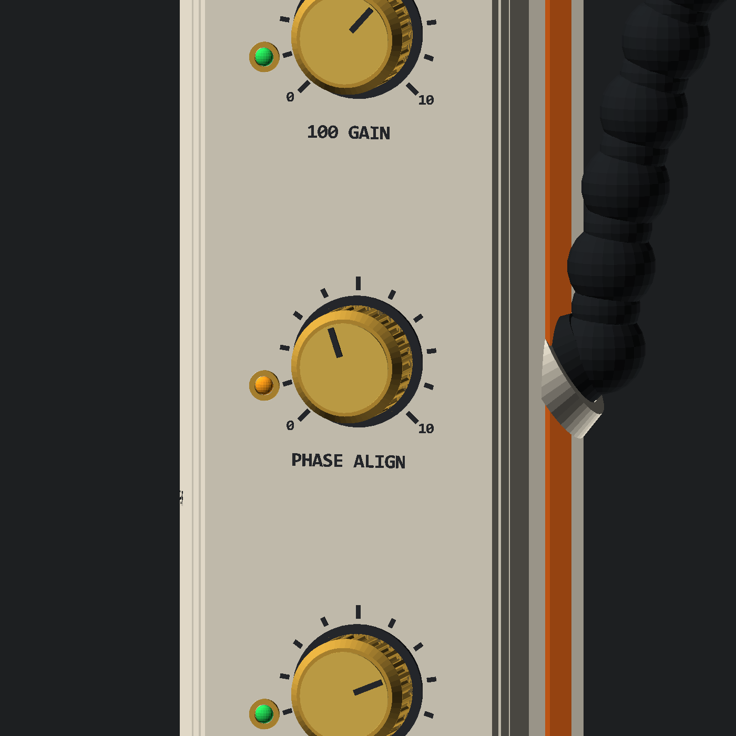
hardware/cad/halo_arch/renders/bc_pillar_macro_front.png
