triunex/HPVE-Fallen/hardware/cad/halo_arch/renders/bc_pillar_rear_open_bays.png

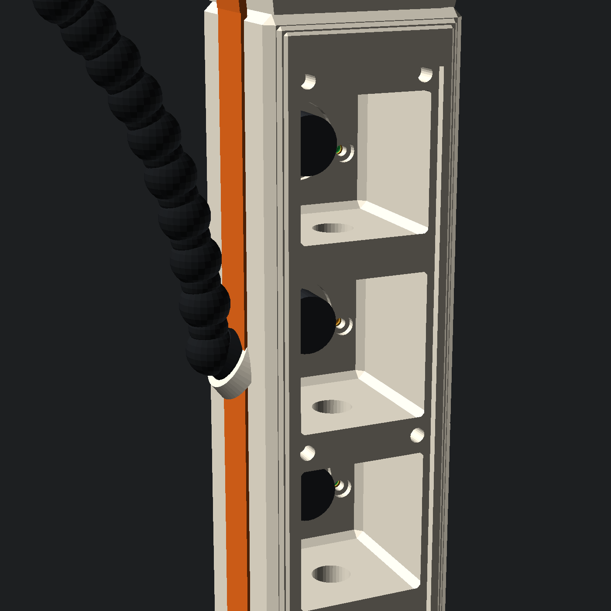
hardware/cad/halo_arch/renders/bc_pillar_rear_open_bays.png
