triunex/HPVE-Fallen/hardware/cad/halo_arch/renders/bc_pillar_xray_cutaway.png

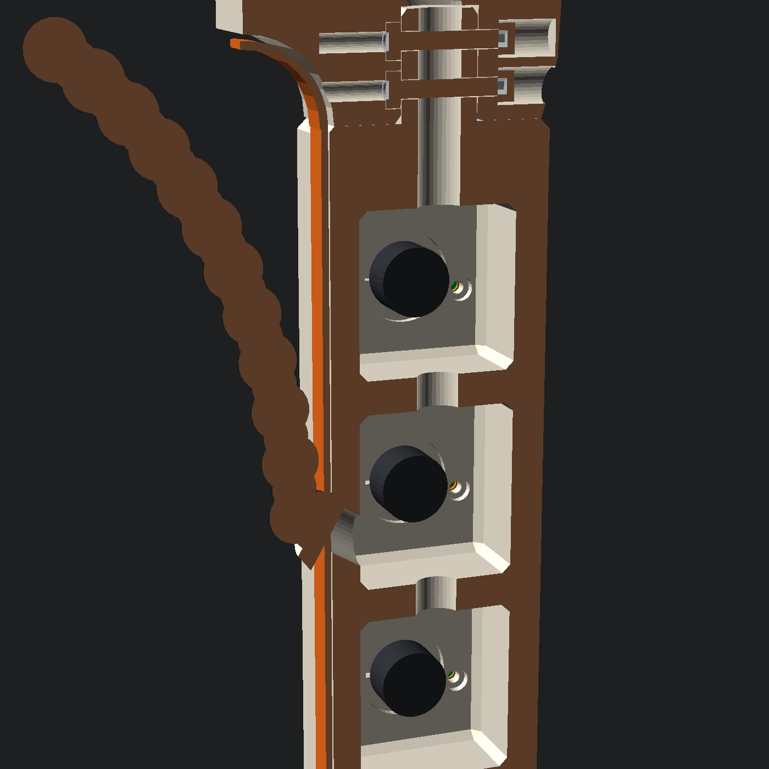
hardware/cad/halo_arch/renders/bc_pillar_xray_cutaway.png
