triunex/HPVE-Fallen/hardware/cad/halo_arch/renders/bc_upper_arch_hero.png

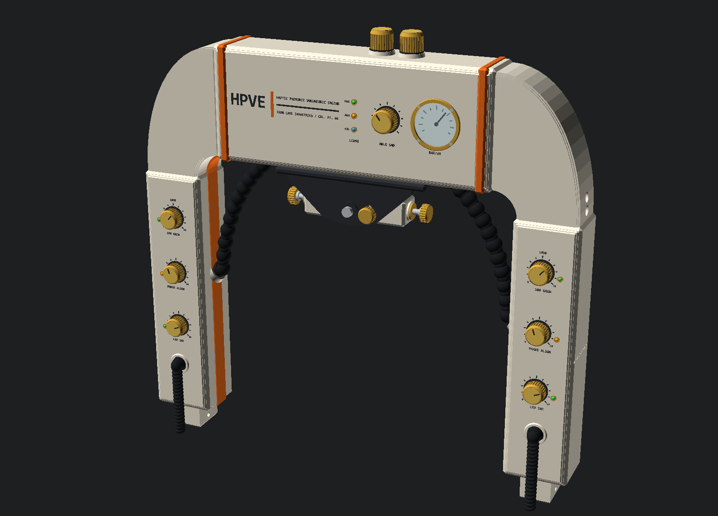
hardware/cad/halo_arch/renders/bc_upper_arch_hero.png
