triunex/HPVE-Fallen/hardware/cad/halo_arch/renders/bc_upper_arch_ortho.png

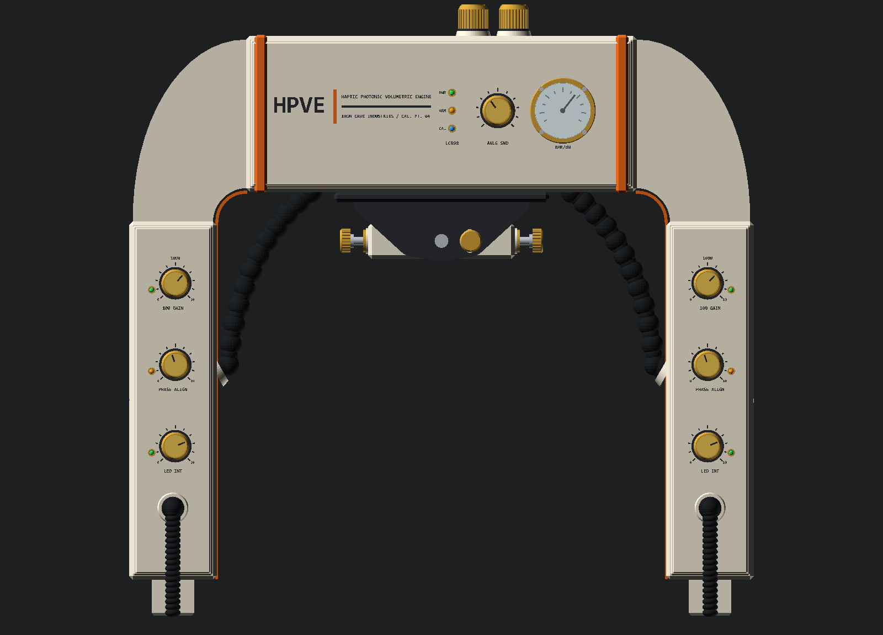
hardware/cad/halo_arch/renders/bc_upper_arch_ortho.png
