triunex/HPVE-Fallen/hardware/cad/halo_arch/renders/de_clamp_exploded.png

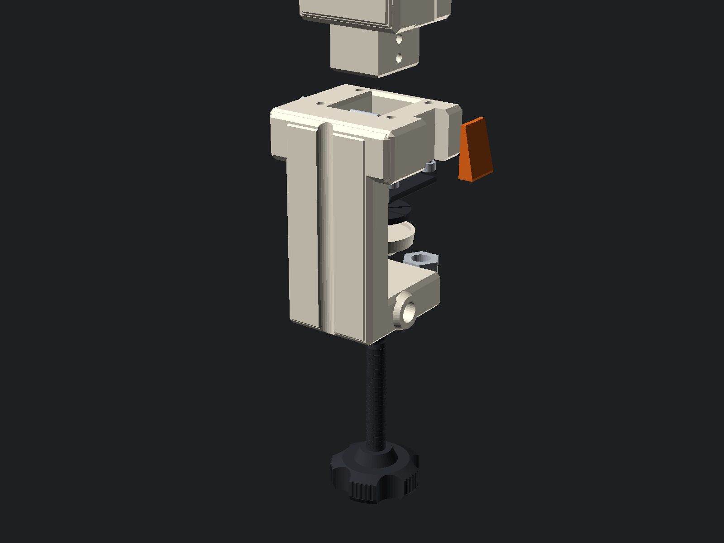
hardware/cad/halo_arch/renders/de_clamp_exploded.png
