triunex/HPVE-Fallen/hardware/cad/halo_arch/renders/de_clamp_inside_holes.png

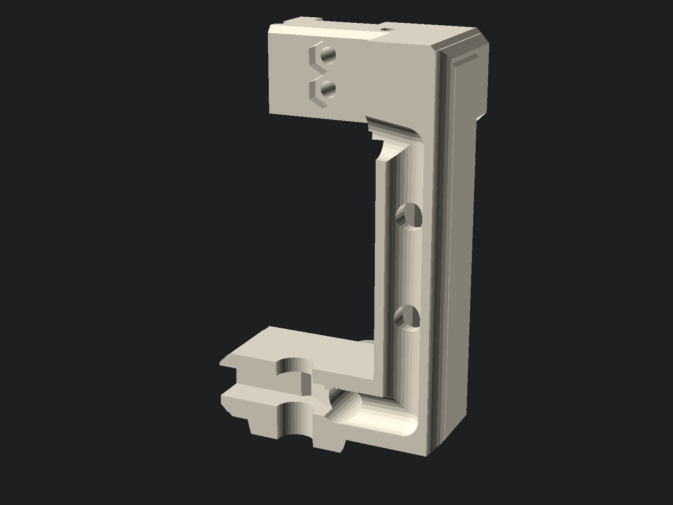
hardware/cad/halo_arch/renders/de_clamp_inside_holes.png
