triunex/HPVE-Fallen/hardware/cad/halo_arch/renders/de_clamp_macro.png

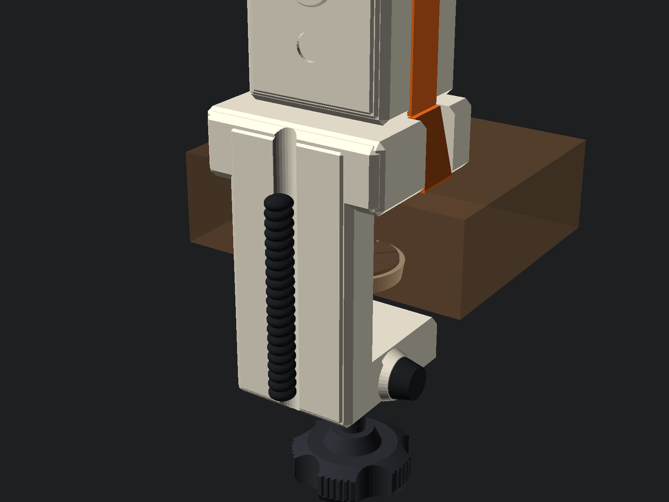
hardware/cad/halo_arch/renders/de_clamp_macro.png
