triunex/HPVE-Fallen/hardware/cad/halo_arch/renders/de_clamp_xray_cutaway.png

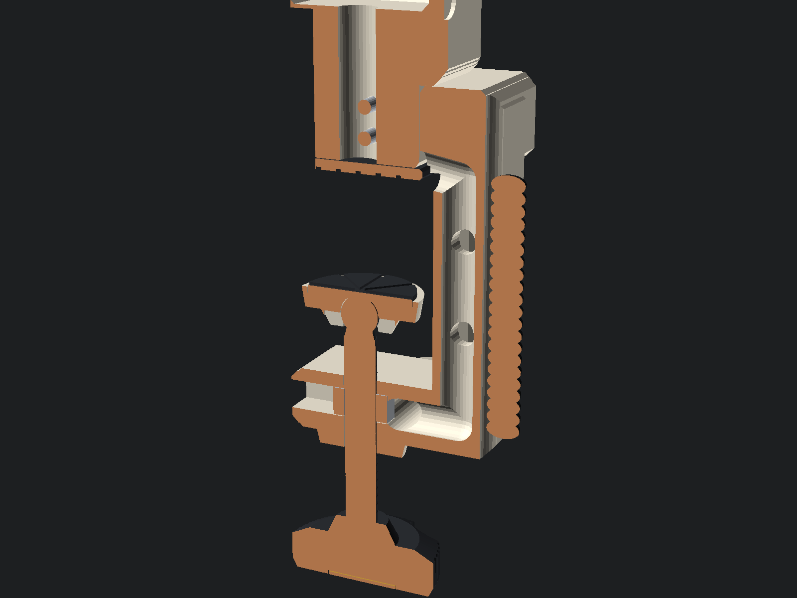
hardware/cad/halo_arch/renders/de_clamp_xray_cutaway.png
