triunex/HPVE-Fallen/hardware/cad/halo_arch/renders/de_full_arch_hero.png

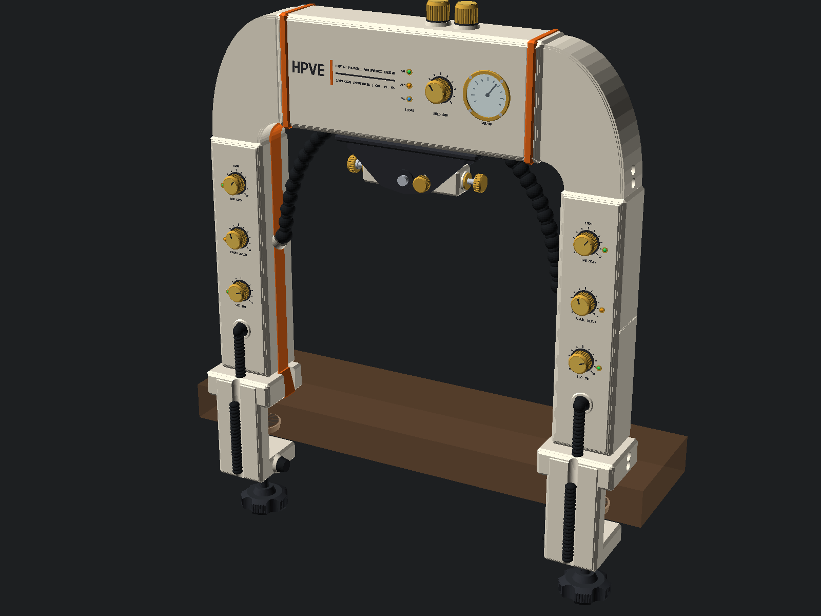
hardware/cad/halo_arch/renders/de_full_arch_hero.png
