triunex/HPVE-Fallen/hardware/cad/halo_arch/renders/de_full_arch_ortho.png

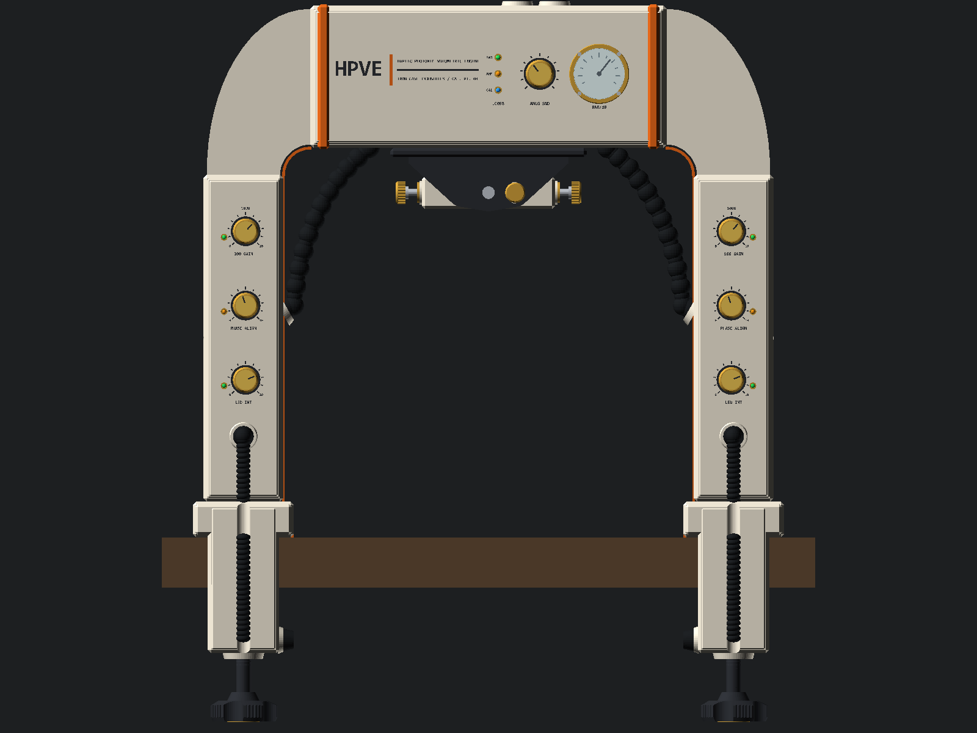
hardware/cad/halo_arch/renders/de_full_arch_ortho.png
