triunex/HPVE-Fallen/hardware/cad/halo_arch/renders/f_full_arch_hero.png

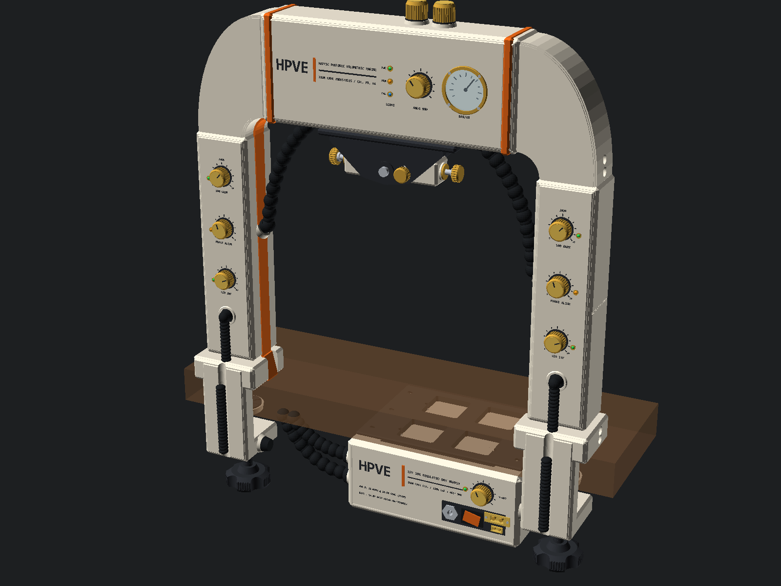
hardware/cad/halo_arch/renders/f_full_arch_hero.png
