triunex/HPVE-Fallen/hardware/cad/halo_arch/renders/f_psu_exploded.png

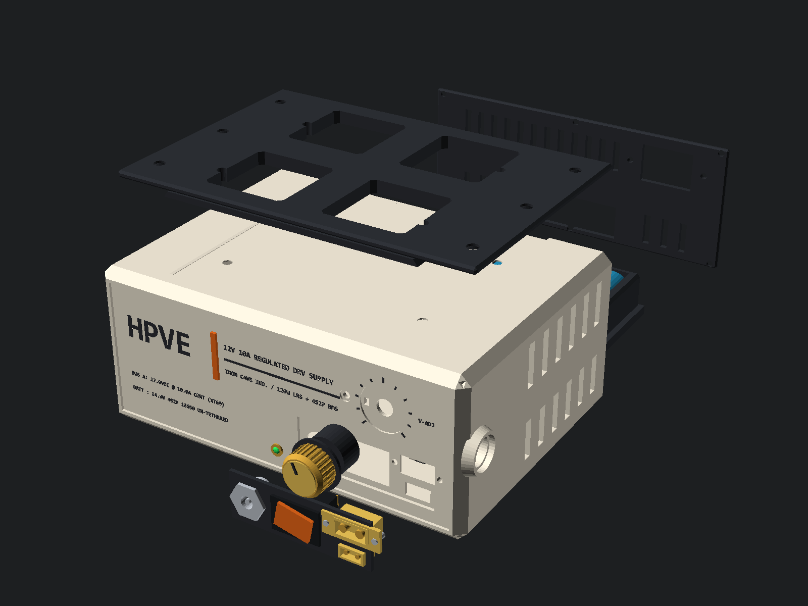
hardware/cad/halo_arch/renders/f_psu_exploded.png
