triunex/HPVE-Fallen/hardware/cad/halo_arch/renders/f_psu_inside_holes.png

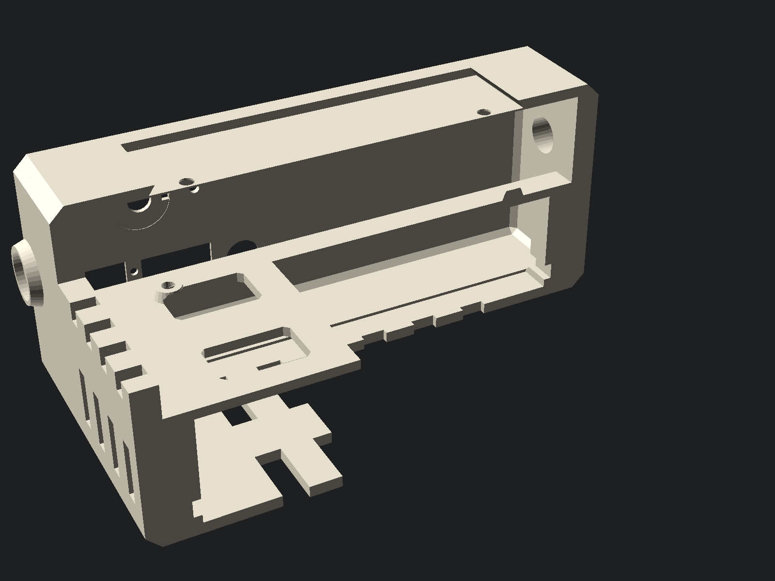
hardware/cad/halo_arch/renders/f_psu_inside_holes.png
