triunex/HPVE-Fallen/hardware/cad/halo_arch/renders/f_psu_macro_hero.png

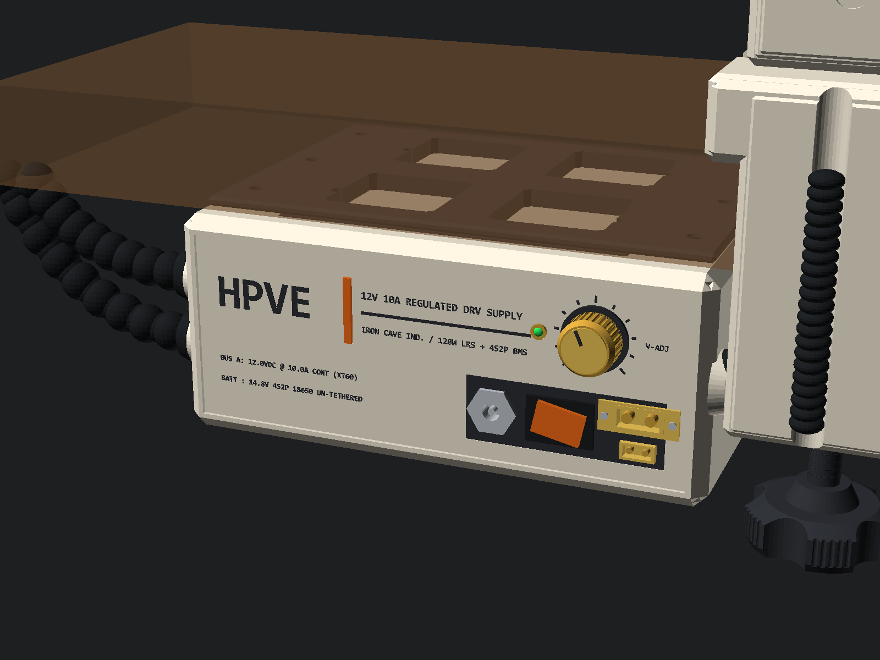
hardware/cad/halo_arch/renders/f_psu_macro_hero.png
