triunex/HPVE-Fallen/hardware/cad/halo_arch/renders/f_psu_rear_open_cradle.png

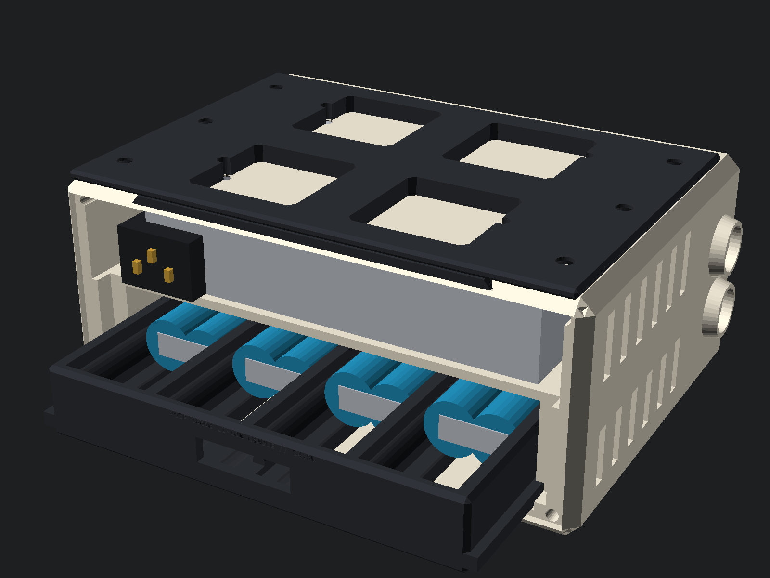
hardware/cad/halo_arch/renders/f_psu_rear_open_cradle.png
