triunex/HPVE-Fallen/hardware/cad/halo_arch/renders/f_psu_xray_cutaway.png

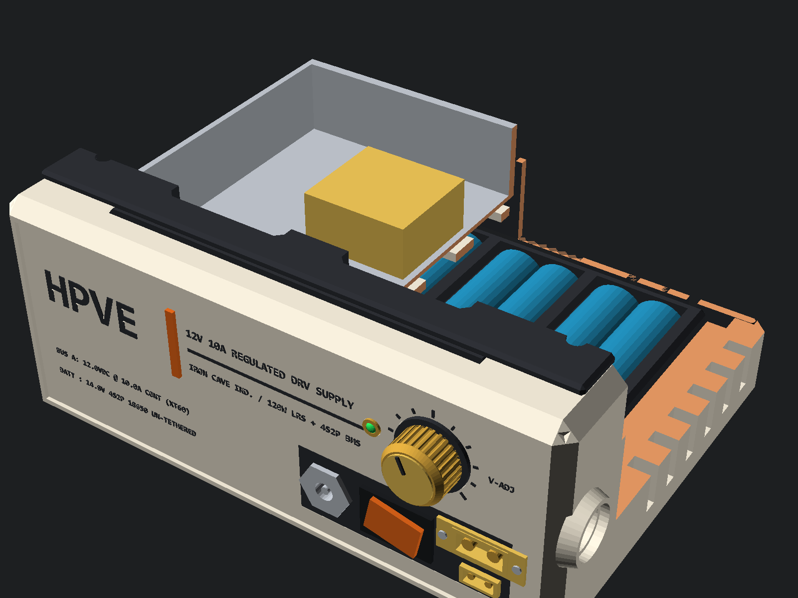
hardware/cad/halo_arch/renders/f_psu_xray_cutaway.png
