triunex/HPVE-Fallen/hardware/cad/halo_arch/renders/g_complete_system_hero.png

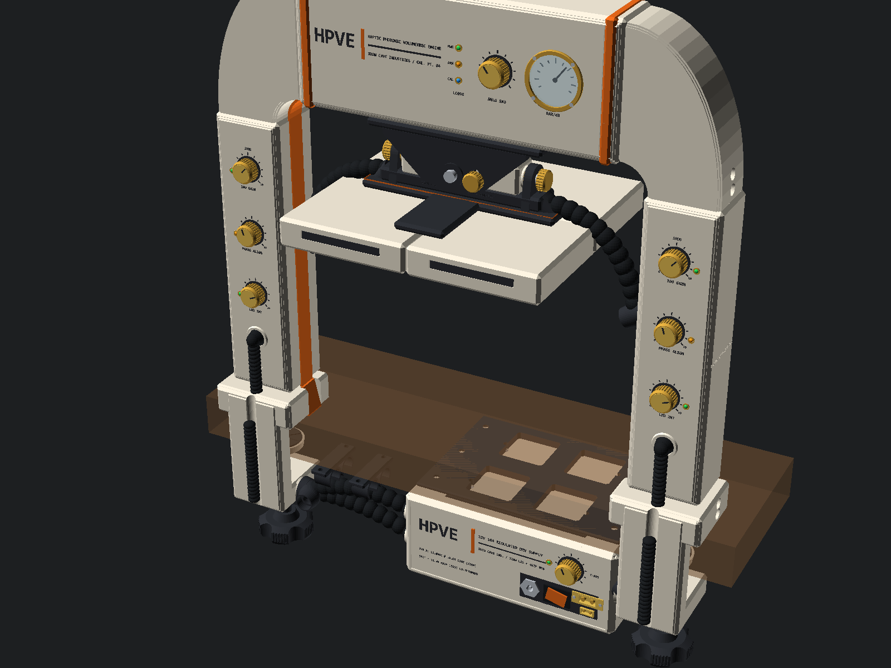
hardware/cad/halo_arch/renders/g_complete_system_hero.png
