triunex/HPVE-Fallen/hardware/cad/halo_arch/renders/g_complete_system_ortho.png

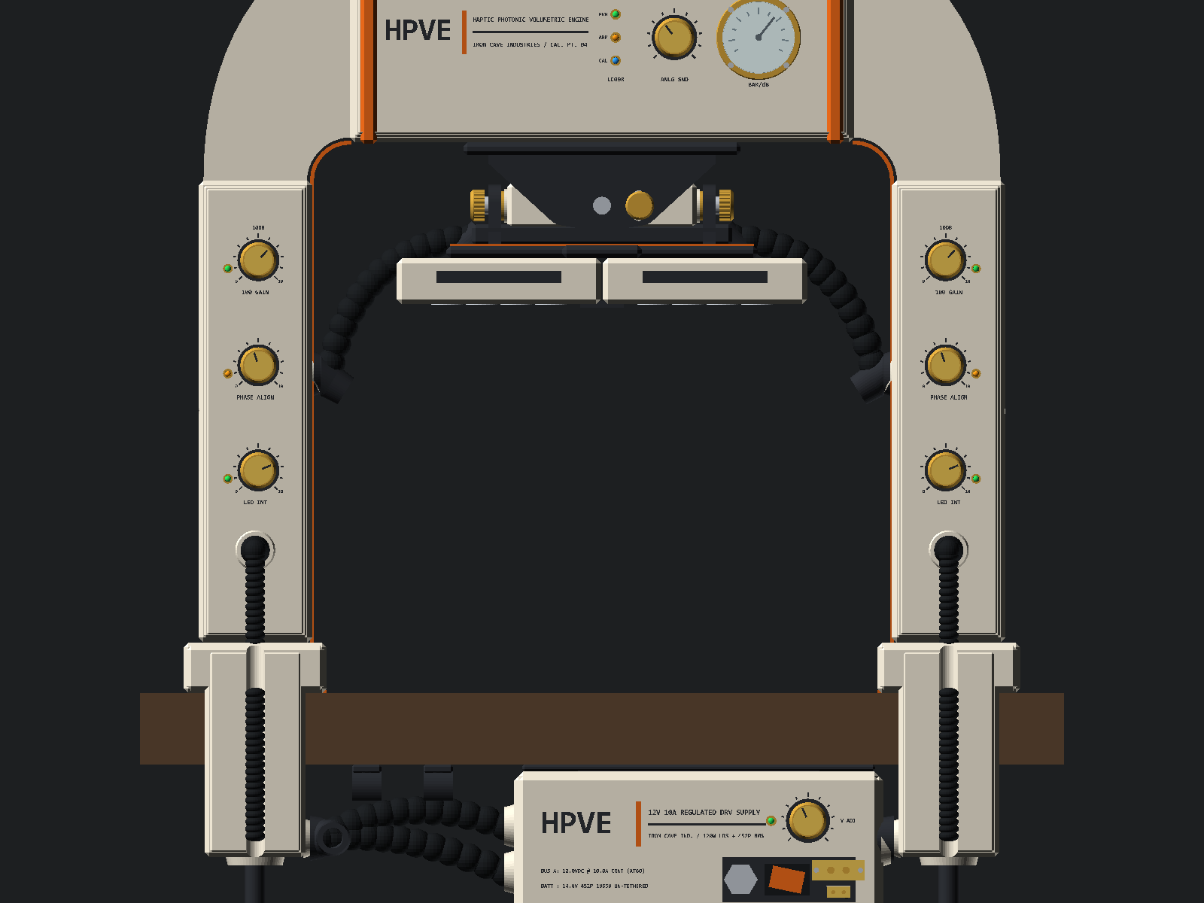
hardware/cad/halo_arch/renders/g_complete_system_ortho.png
