triunex/HPVE-Fallen/hardware/cad/halo_arch/renders/g_exploded_view.png

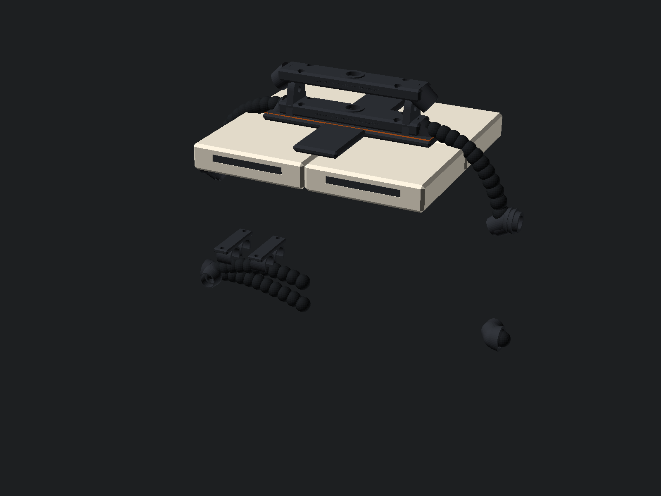
hardware/cad/halo_arch/renders/g_exploded_view.png
