triunex/HPVE-Fallen/hardware/cad/halo_arch/renders/g_gantry_xray_wire_routing.png

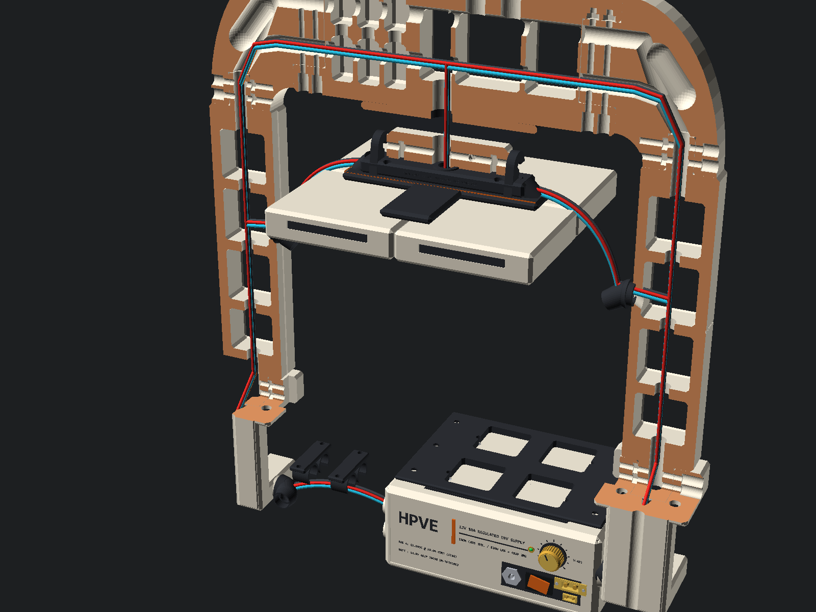
hardware/cad/halo_arch/renders/g_gantry_xray_wire_routing.png
