triunex/HPVE-Fallen/hardware/cad/halo_arch/renders/g_overhead_umbilicals_macro.png

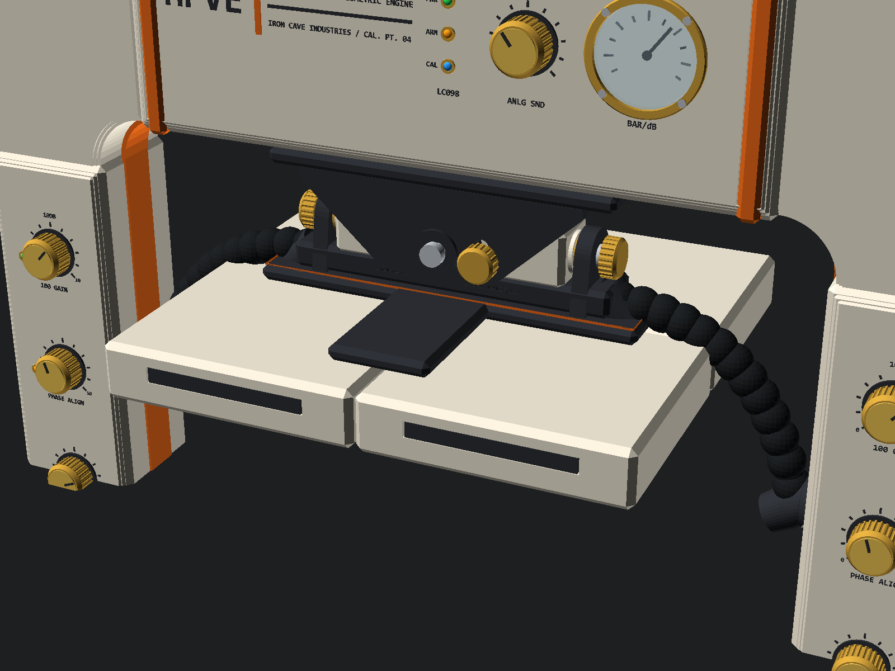
hardware/cad/halo_arch/renders/g_overhead_umbilicals_macro.png
