triunex/HPVE-Fallen/hardware/cad/halo_arch/renders/g_underdesk_link_macro.png

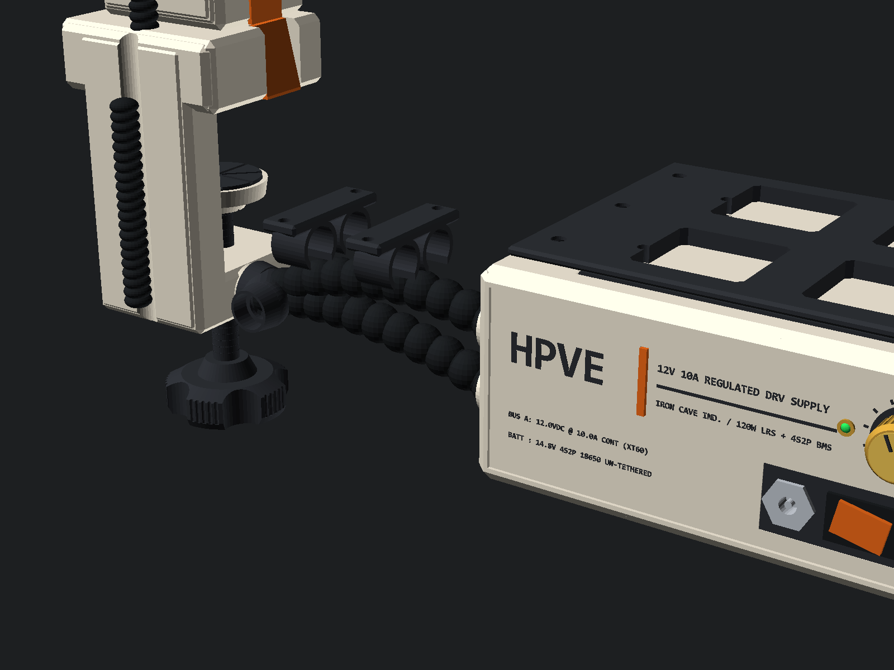
hardware/cad/halo_arch/renders/g_underdesk_link_macro.png
