triunex/HPVE-Fallen/hardware/cad/openscad_v3_halo1_front_hero.png

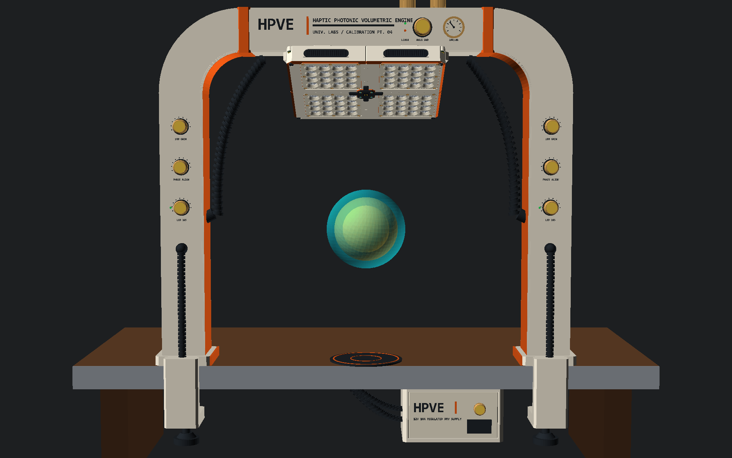
hardware/cad/openscad_v3_halo1_front_hero.png
