triunex/HPVE-Fallen/hardware/cad/openscad_v3_halo2_iso_quarter.png

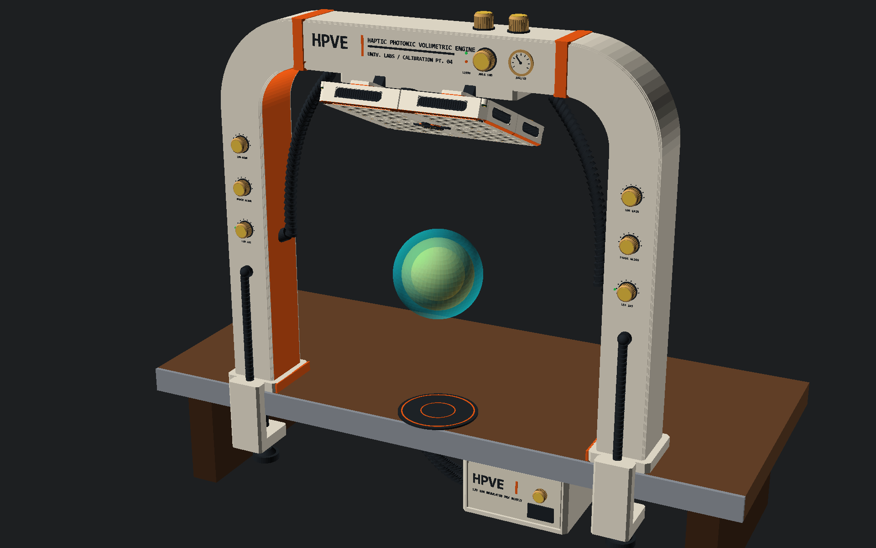
hardware/cad/openscad_v3_halo2_iso_quarter.png
