triunex/HPVE-Fallen/hardware/cad/openscad_v3_halo3_low_upward_emitter.png

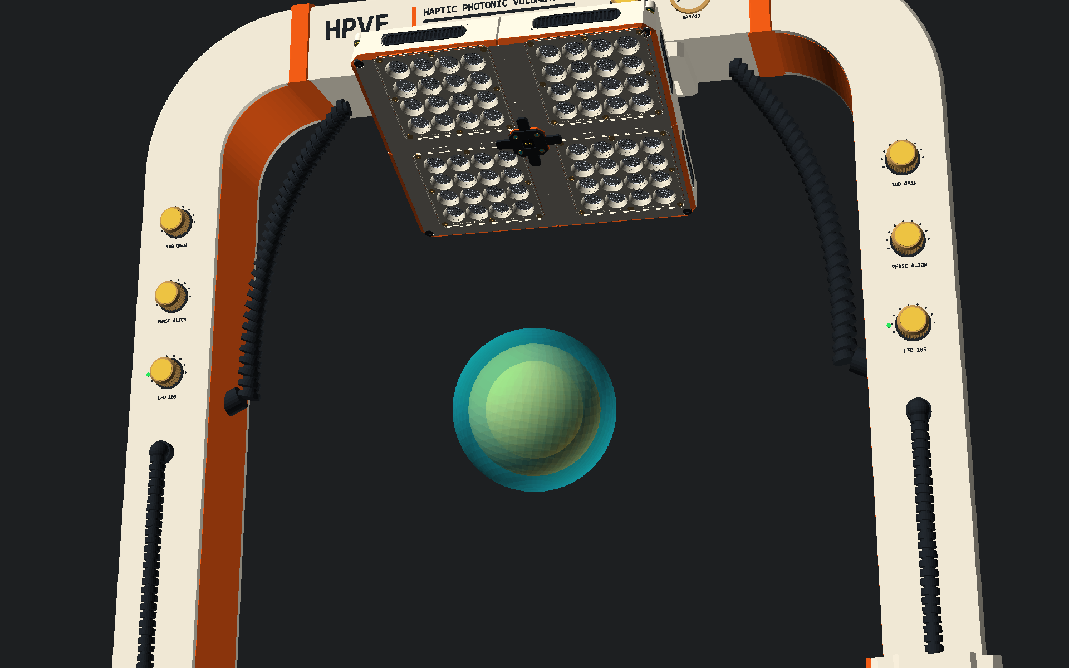
hardware/cad/openscad_v3_halo3_low_upward_emitter.png
