triunex/HPVE-Fallen/hardware/cad/openscad_v3_halo4_rear_gimbal_psu.png

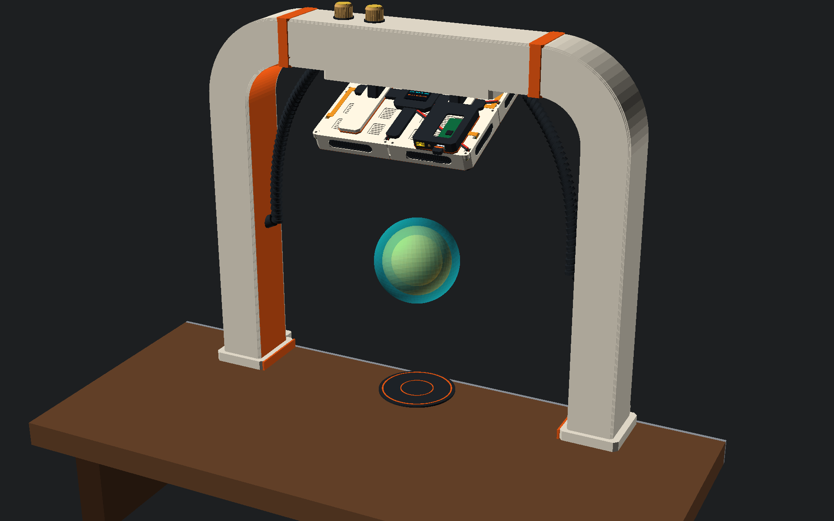
hardware/cad/openscad_v3_halo4_rear_gimbal_psu.png
