triunex/HPVE-Fallen/hardware/cad/openscad_v3_sensor_pod_macro.png

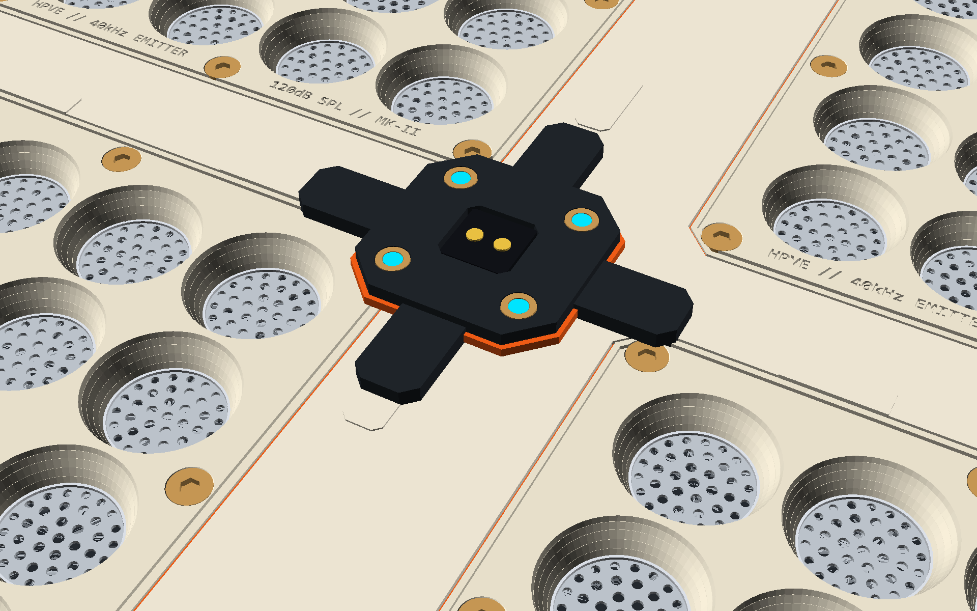
hardware/cad/openscad_v3_sensor_pod_macro.png
