triunex/HPVE-Fallen/hardware/cad/openscad_v3_view1_hero_iso.png

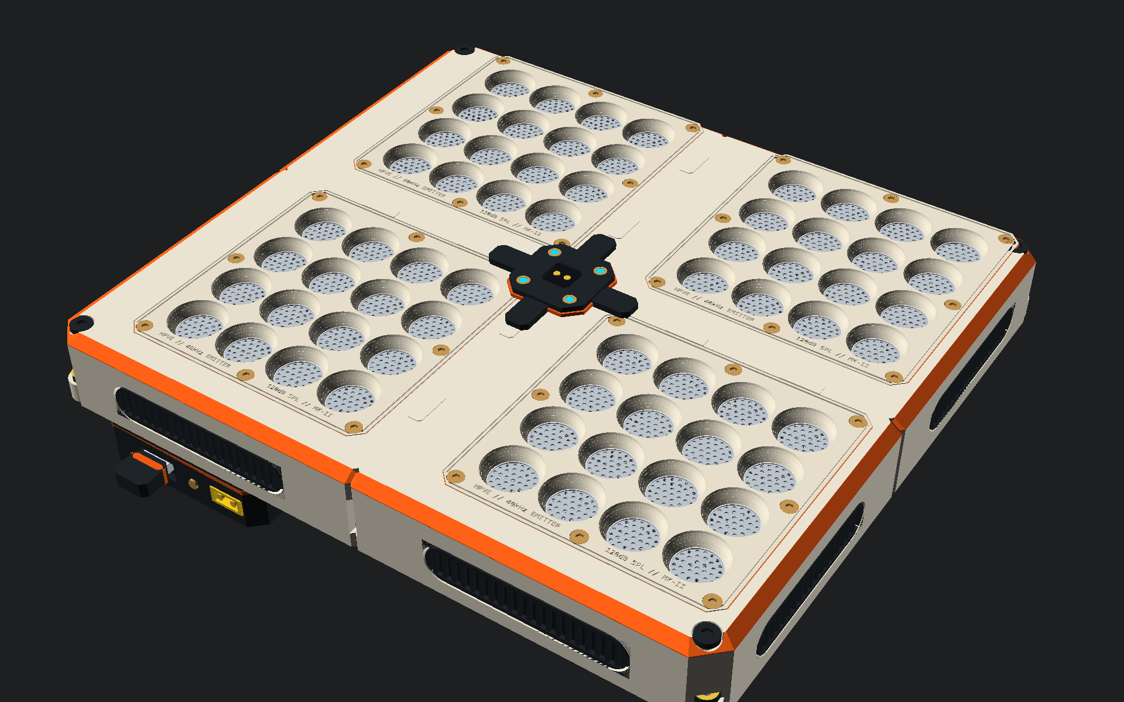
hardware/cad/openscad_v3_view1_hero_iso.png
