triunex/HPVE-Fallen/hardware/cad/openscad_v3_view2_top_ortho.png

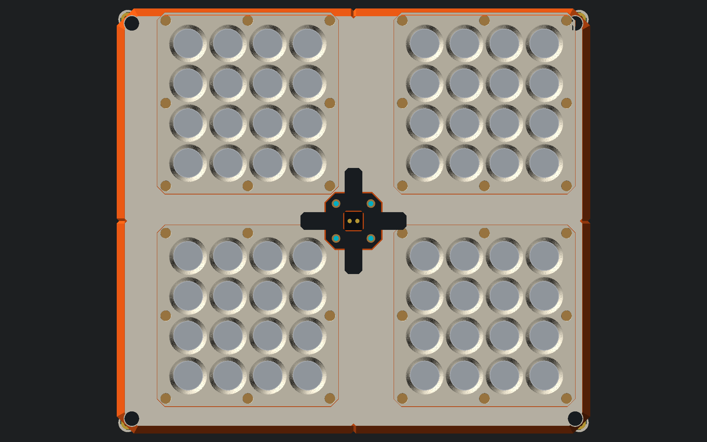
hardware/cad/openscad_v3_view2_top_ortho.png
