triunex/HPVE-Fallen/hardware/cad/openscad_v3_view3_internal_pcb_ffc_cutaway.png

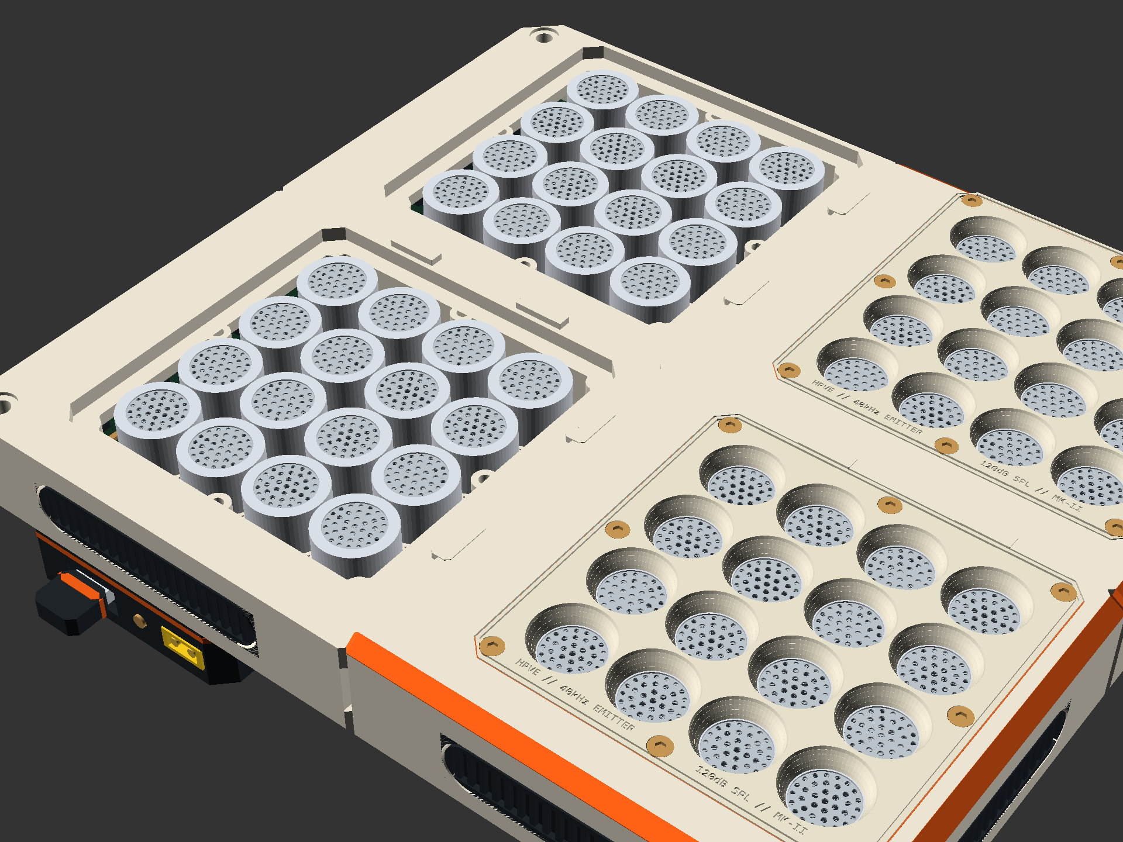
hardware/cad/openscad_v3_view3_internal_pcb_ffc_cutaway.png
