triunex/HPVE-Fallen/hardware/cad/openscad_v3_view4_rear_pico_avionics_iso.png

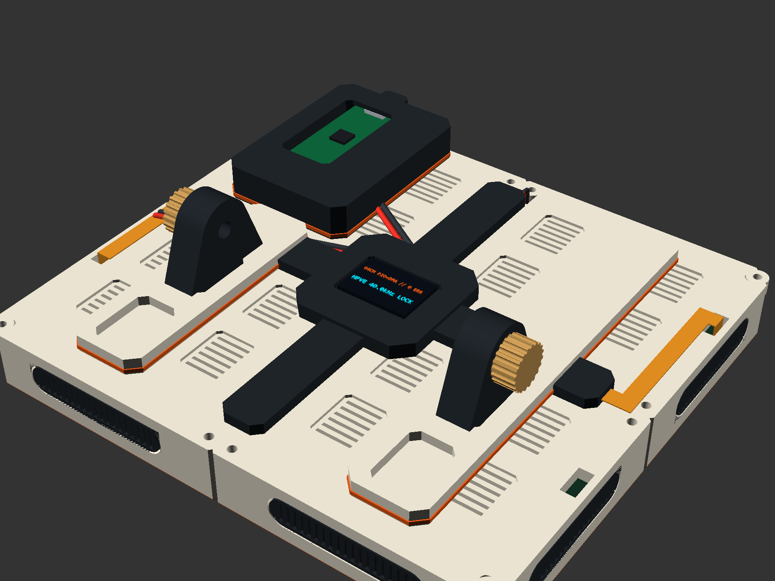
hardware/cad/openscad_v3_view4_rear_pico_avionics_iso.png
