triunex/HPVE-Fallen/hardware/cad/openscad_v3_view5_rear_backplane_ortho.png

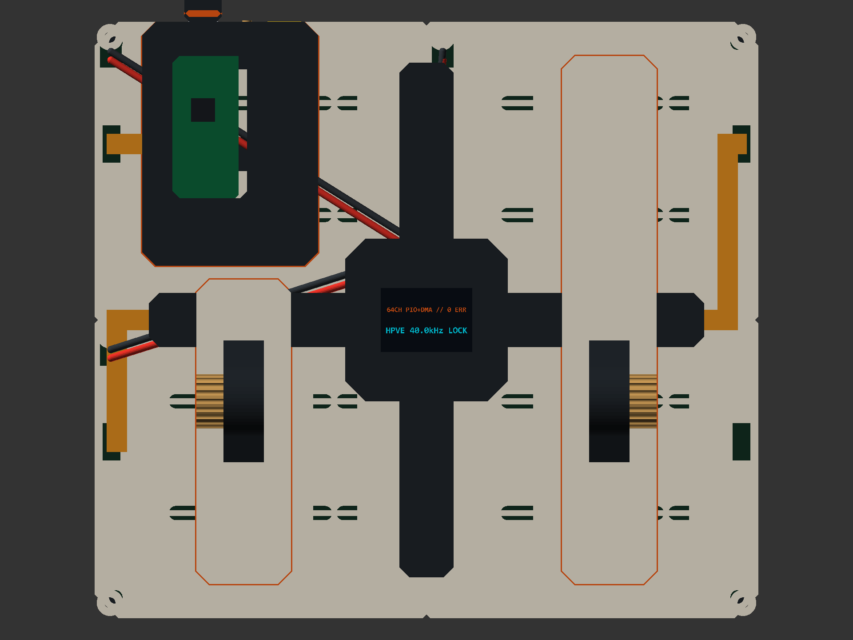
hardware/cad/openscad_v3_view5_rear_backplane_ortho.png
