triunex/HPVE-Fallen/hardware/cad/openscad_v3_view6_external_usbc_xt30_ports.png

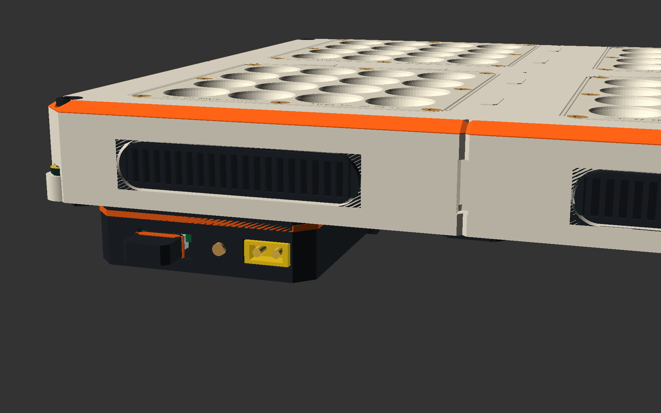
hardware/cad/openscad_v3_view6_external_usbc_xt30_ports.png
