triunex/HPVE-Fallen/hardware/cad/openscad_v3_view7_single_tile_exploded.png

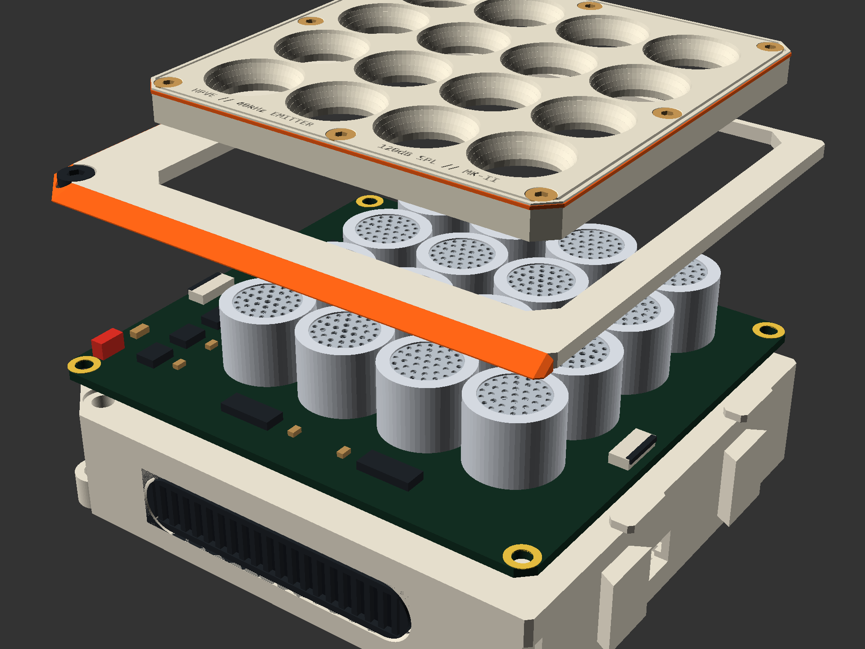
hardware/cad/openscad_v3_view7_single_tile_exploded.png
