triunex/HPVE-Fallen/hardware/cad/openscad_v3_view8_full_quad_exploded.png

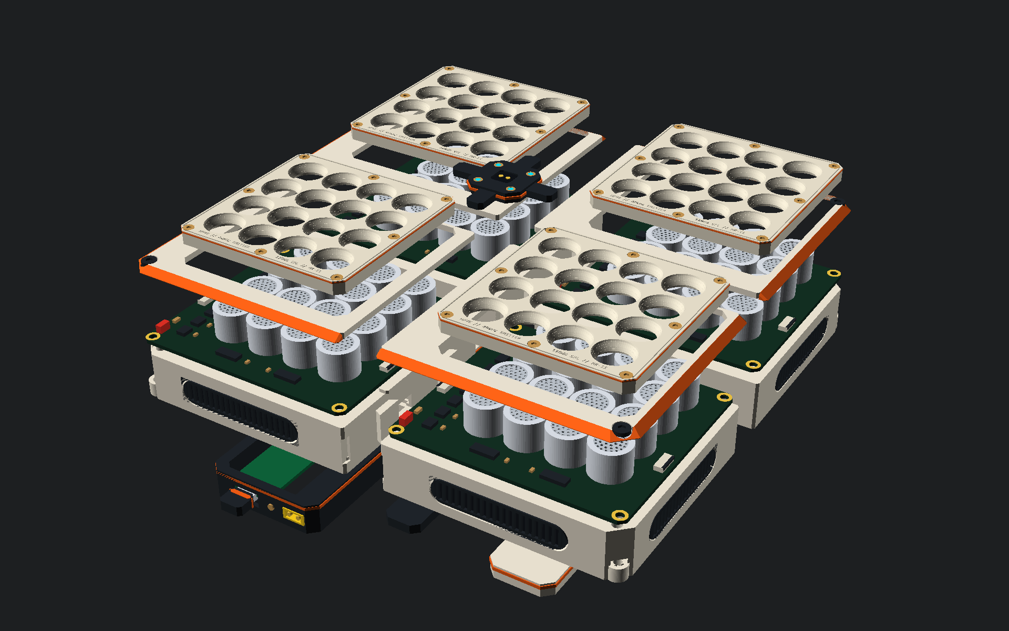
hardware/cad/openscad_v3_view8_full_quad_exploded.png
