triunex/HPVE-Fallen/hardware/cad/openscad_v4_view2_internal_cutaway.png

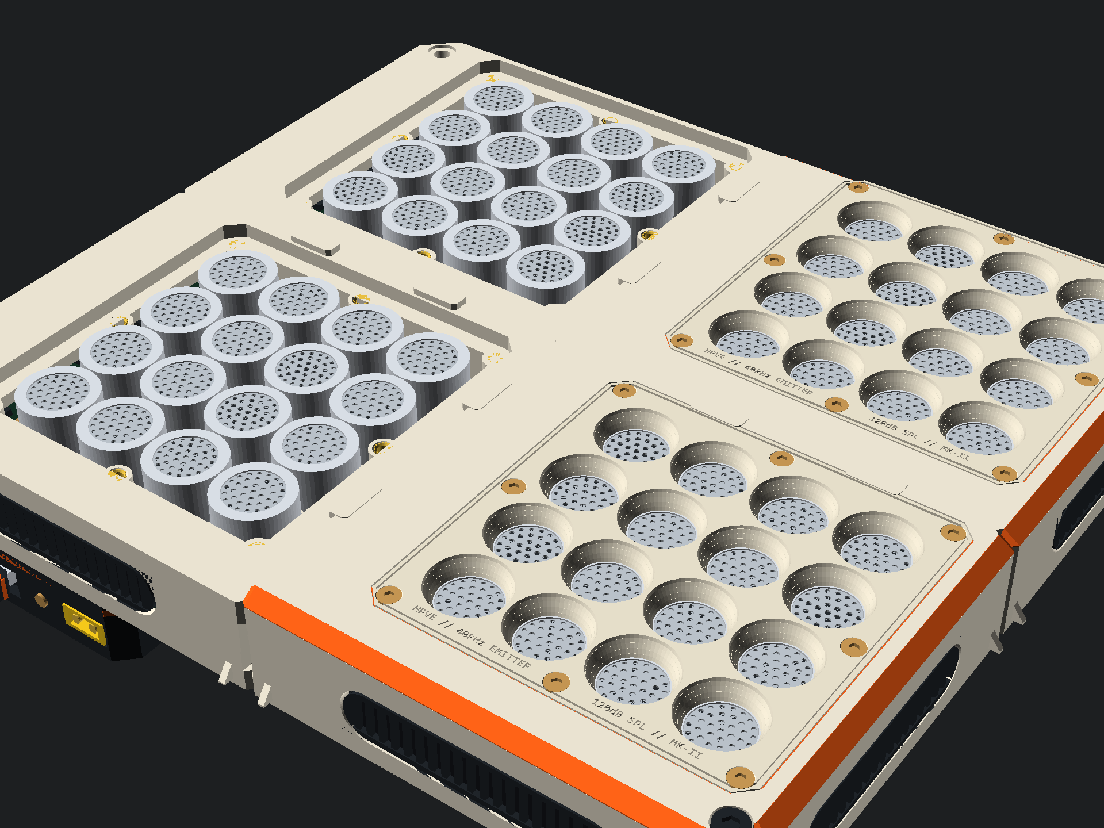
hardware/cad/openscad_v4_view2_internal_cutaway.png
