triunex/HPVE-Fallen/hardware/cad/openscad_v4_view3_rear_avionics_iso.png

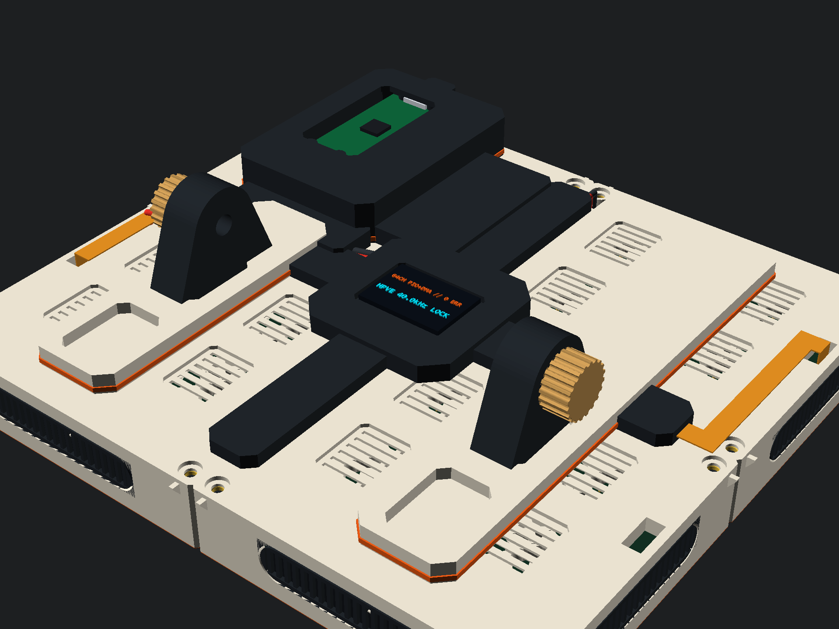
hardware/cad/openscad_v4_view3_rear_avionics_iso.png
