triunex/HPVE-Fallen/hardware/cad/openscad_v4_view6_single_tile_exploded.png

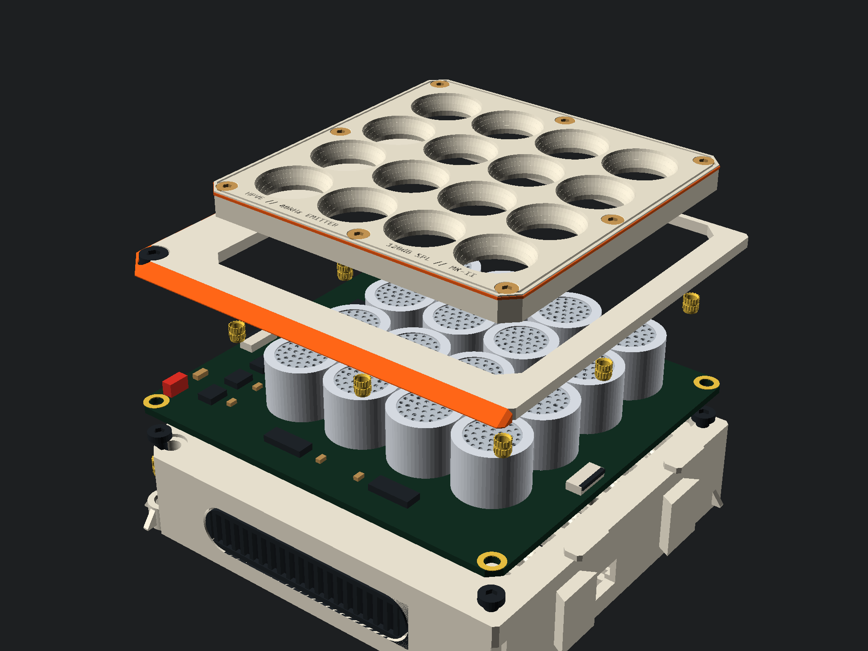
hardware/cad/openscad_v4_view6_single_tile_exploded.png
