triunex/HPVE-Fallen/hardware/cad/openscad_v4_view17_structural_xray.png

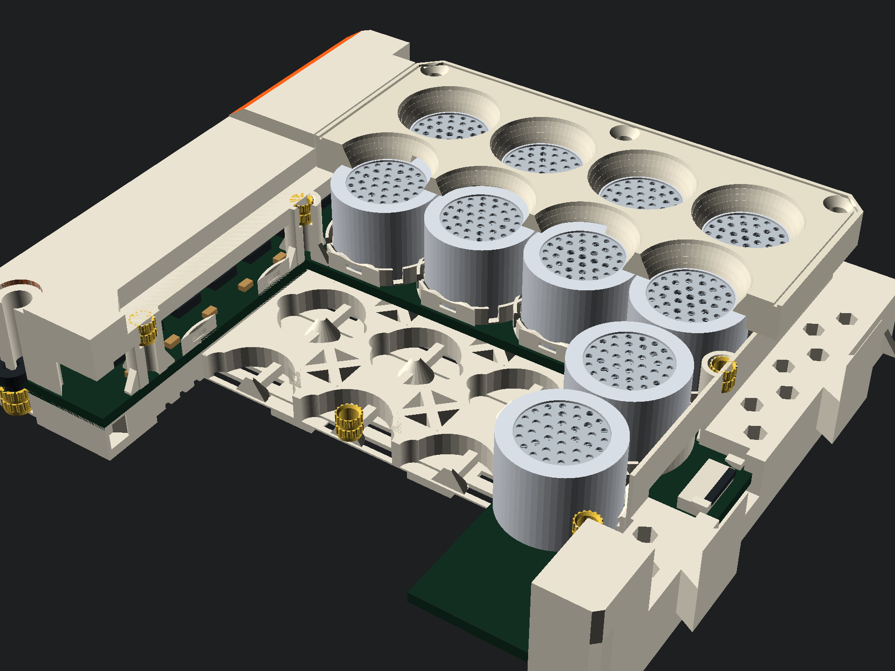
hardware/cad/openscad_v4_view17_structural_xray.png
