triunex/HPVE-Fallen/hardware/cad/openscad_v4_view18_avionics_shield_stl.png

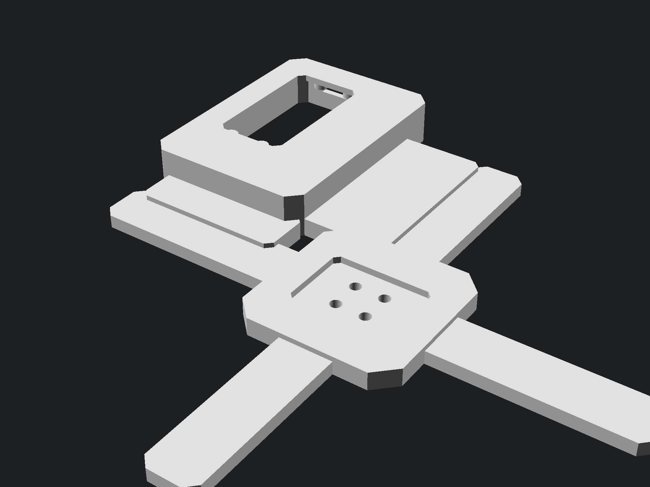
hardware/cad/openscad_v4_view18_avionics_shield_stl.png
