triunex/HPVE-Fallen/hardware/cad/openscad_v5_view0_quad_emitter_hero.png

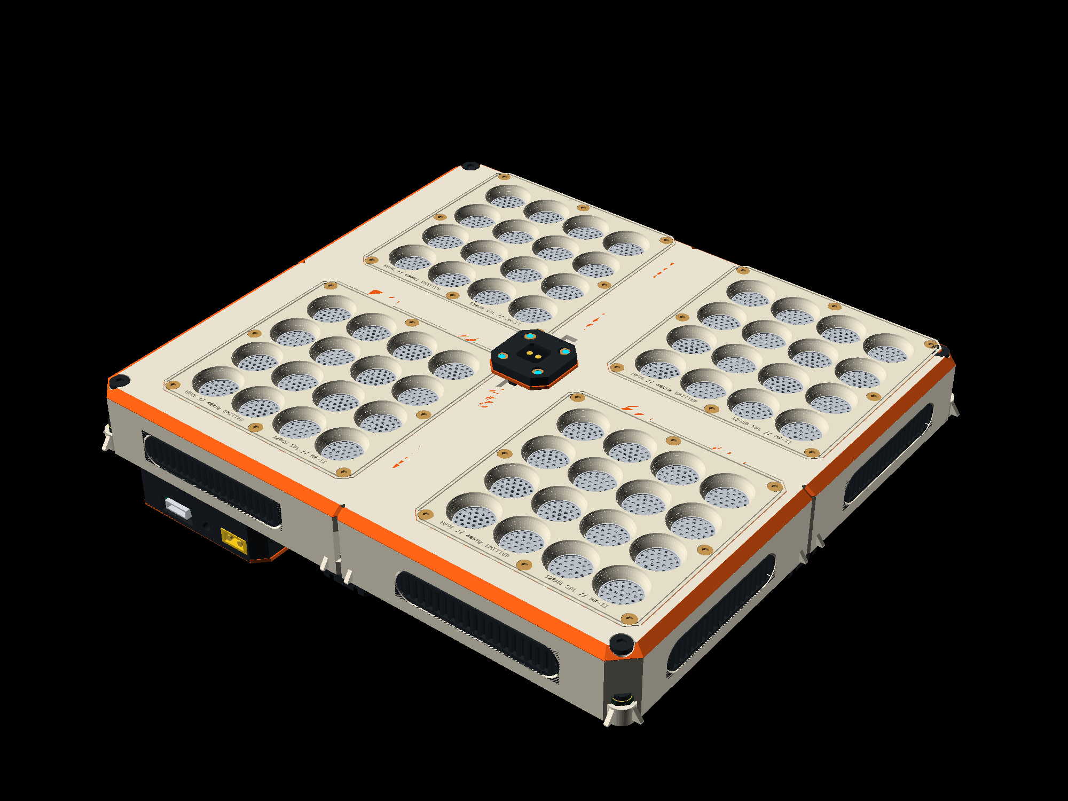
hardware/cad/openscad_v5_view0_quad_emitter_hero.png
