triunex/HPVE-Fallen/hardware/cad/openscad_v5_view3_rear_12bolt_gimbal.png

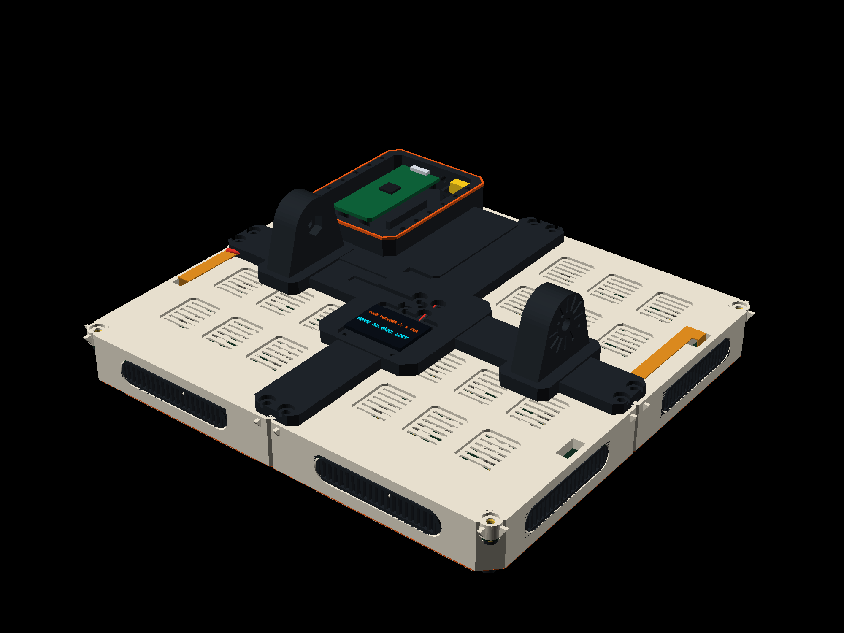
hardware/cad/openscad_v5_view3_rear_12bolt_gimbal.png
