triunex/HPVE-Fallen/hardware/cad/openscad_v5_view17_structural_xray.png

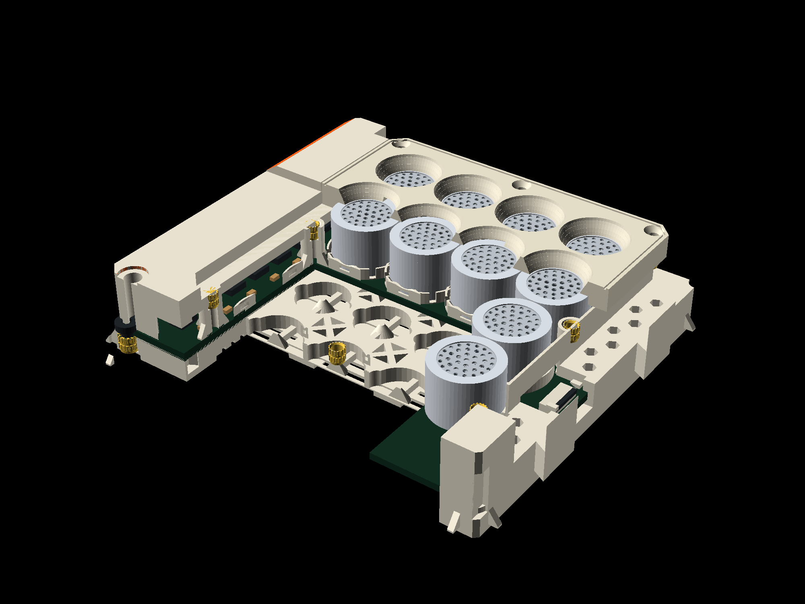
hardware/cad/openscad_v5_view17_structural_xray.png
