triunex/HPVE-Fallen/hardware/cad/openscad_view_1_iso_quad_array.png

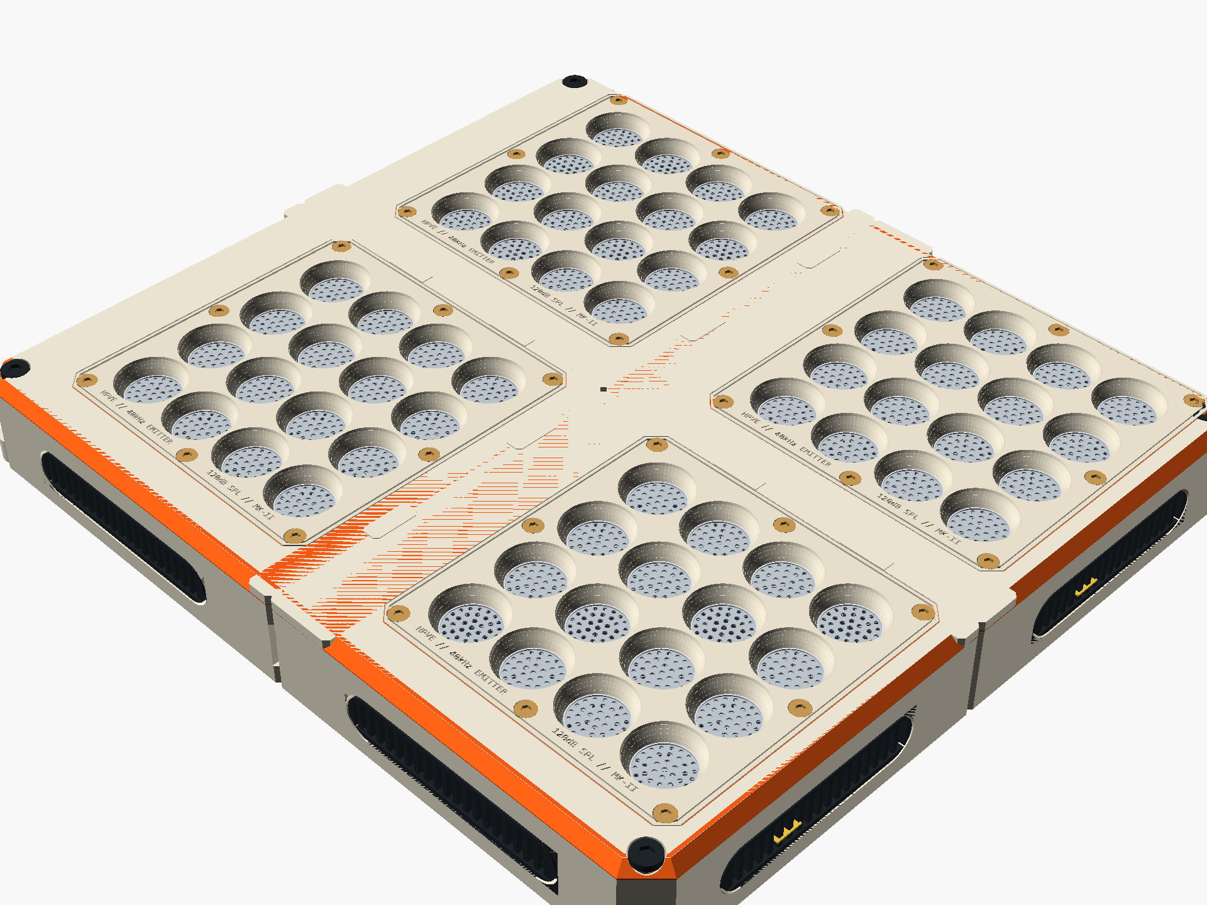
hardware/cad/openscad_view_1_iso_quad_array.png
