triunex/HPVE-Fallen/hardware/cad/openscad_view_2_top_orthographic.png

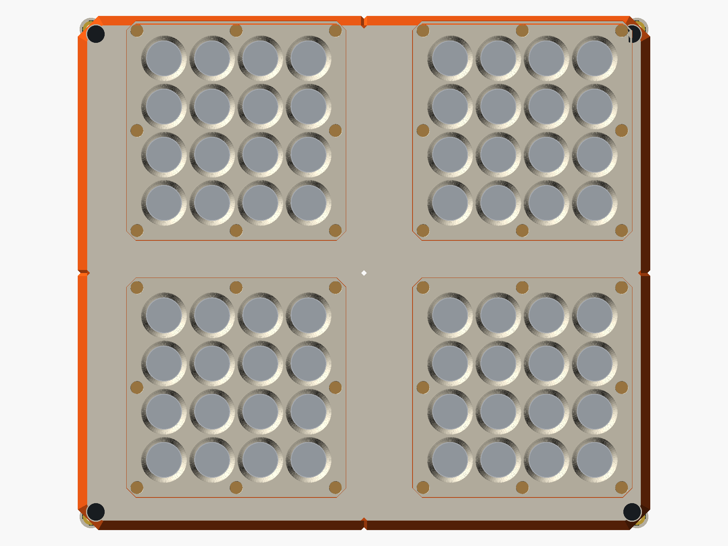
hardware/cad/openscad_view_2_top_orthographic.png
