triunex/HPVE-Fallen/hardware/cad/openscad_view_3_bottom_underbody.png

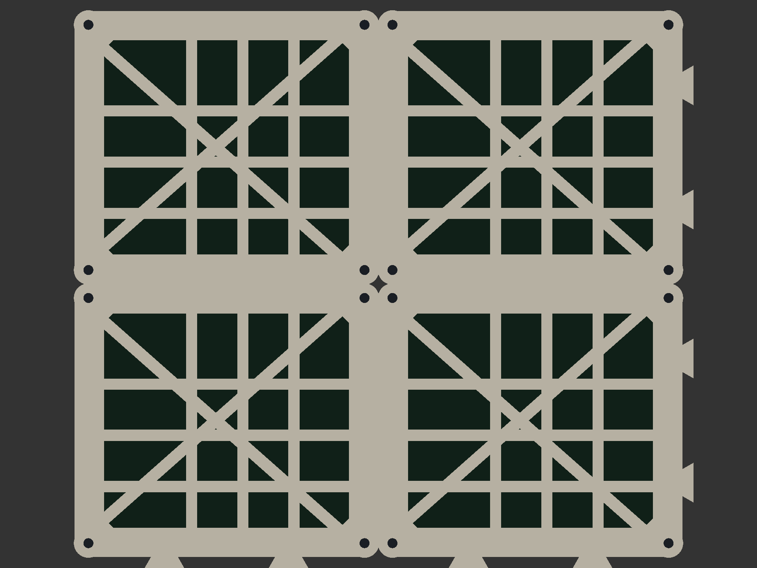
hardware/cad/openscad_view_3_bottom_underbody.png
