triunex/HPVE-Fallen/hardware/cad/openscad_view_3_internal_pcb_cutaway.png

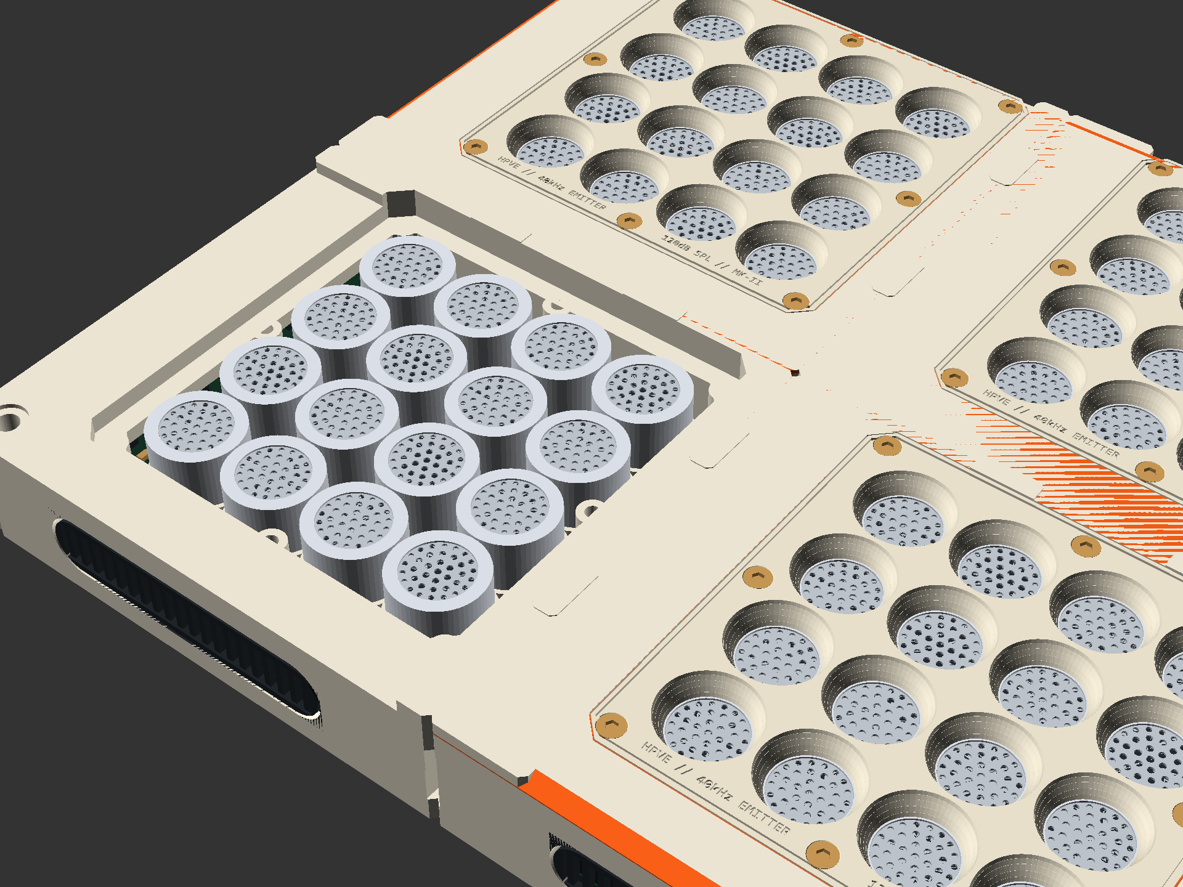
hardware/cad/openscad_view_3_internal_pcb_cutaway.png
