triunex/HPVE-Fallen/hardware/cad/openscad_view_4_halo_arch_mount_rear.png

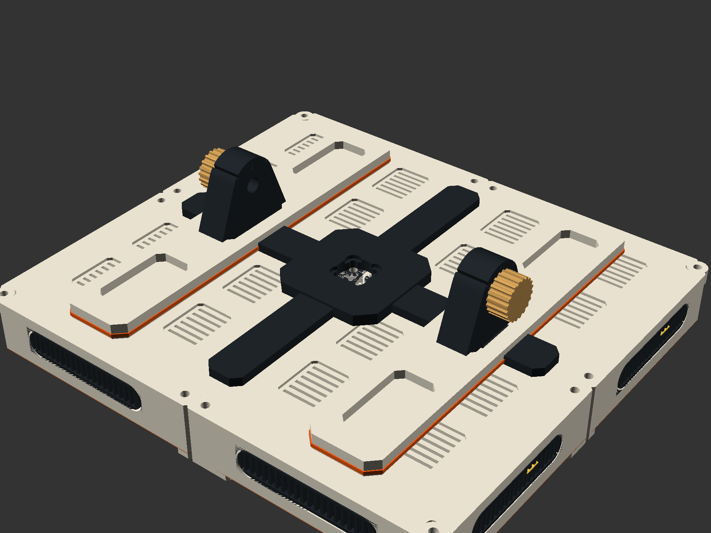
hardware/cad/openscad_view_4_halo_arch_mount_rear.png
