triunex/HPVE-Fallen/hardware/cad/openscad_view_4_side_elevation.png

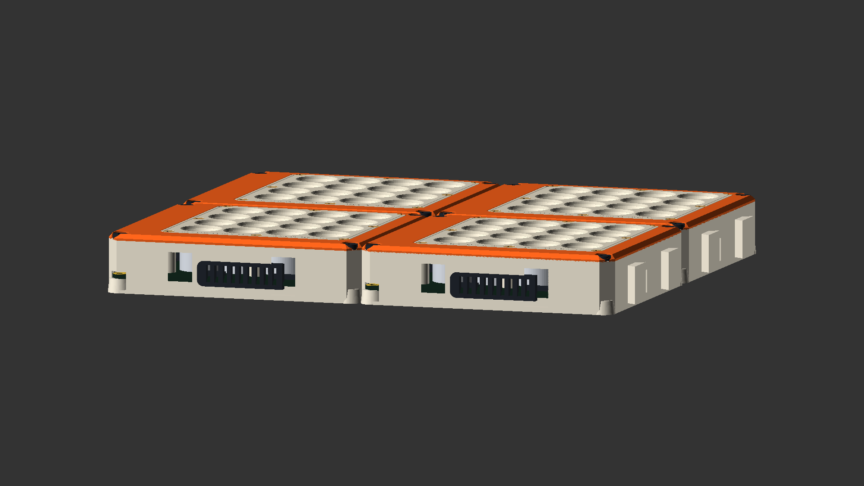
hardware/cad/openscad_view_4_side_elevation.png
