triunex/HPVE-Fallen/hardware/cad/openscad_view_6_single_tile_iso.png

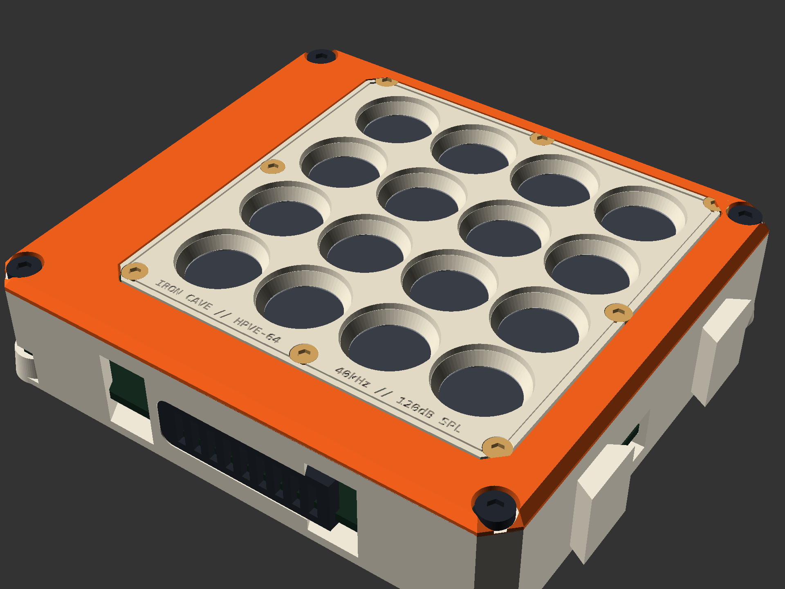
hardware/cad/openscad_view_6_single_tile_iso.png
