triunex/HPVE-Fallen/hardware/kicad/hpve_pcb_2d_editor_view.png

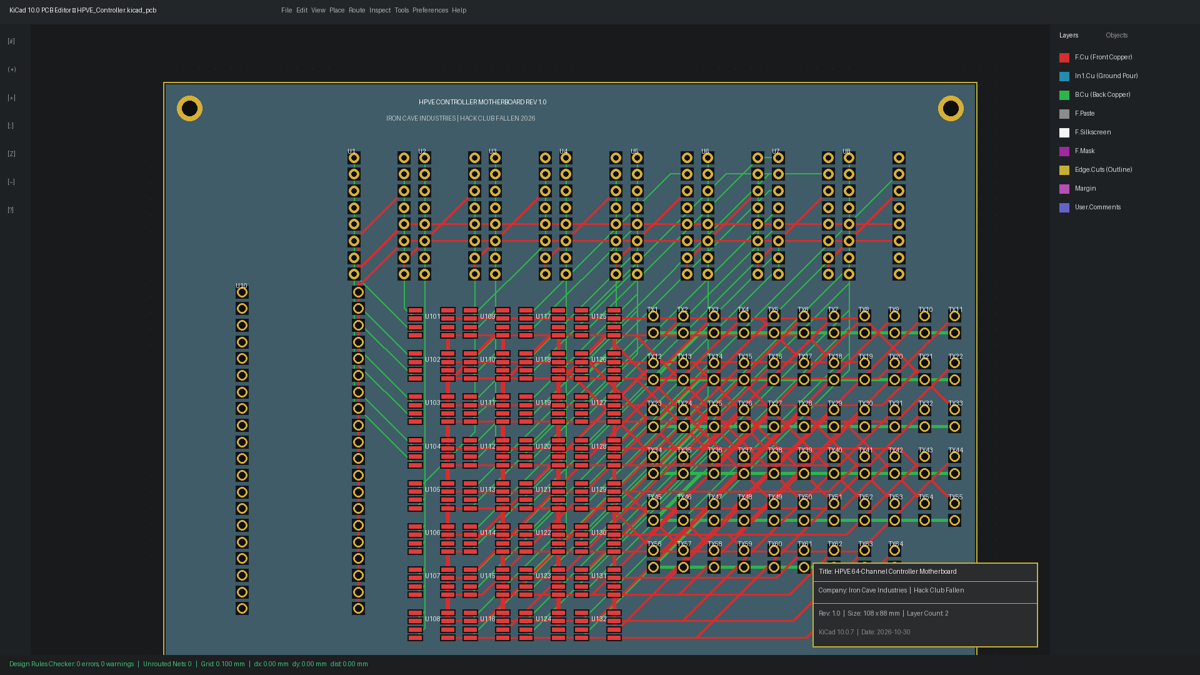
hardware/kicad/hpve_pcb_2d_editor_view.png
