triunex/HPVE-Fallen/hardware/kicad/hpve_pcb_routed_3d.png

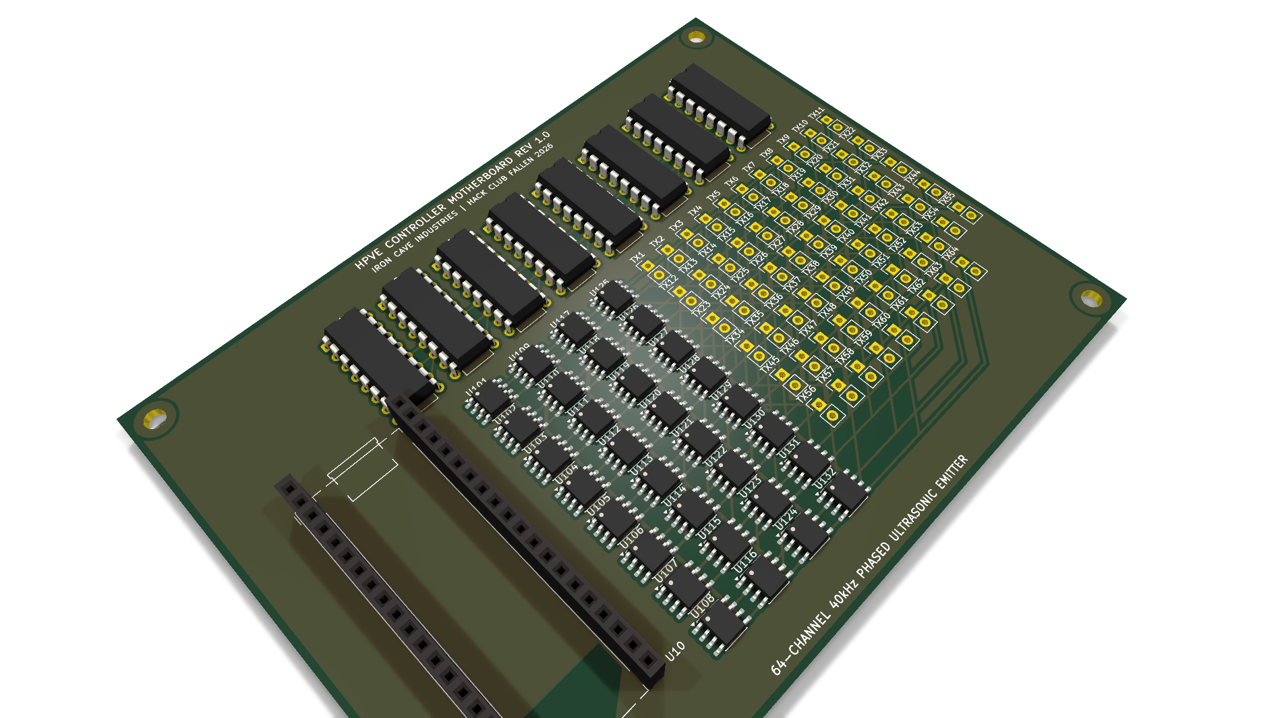
hardware/kicad/hpve_pcb_routed_3d.png
