triunex/HPVE-Fallen/hardware/kicad/hpve_pcb_routed_top.png

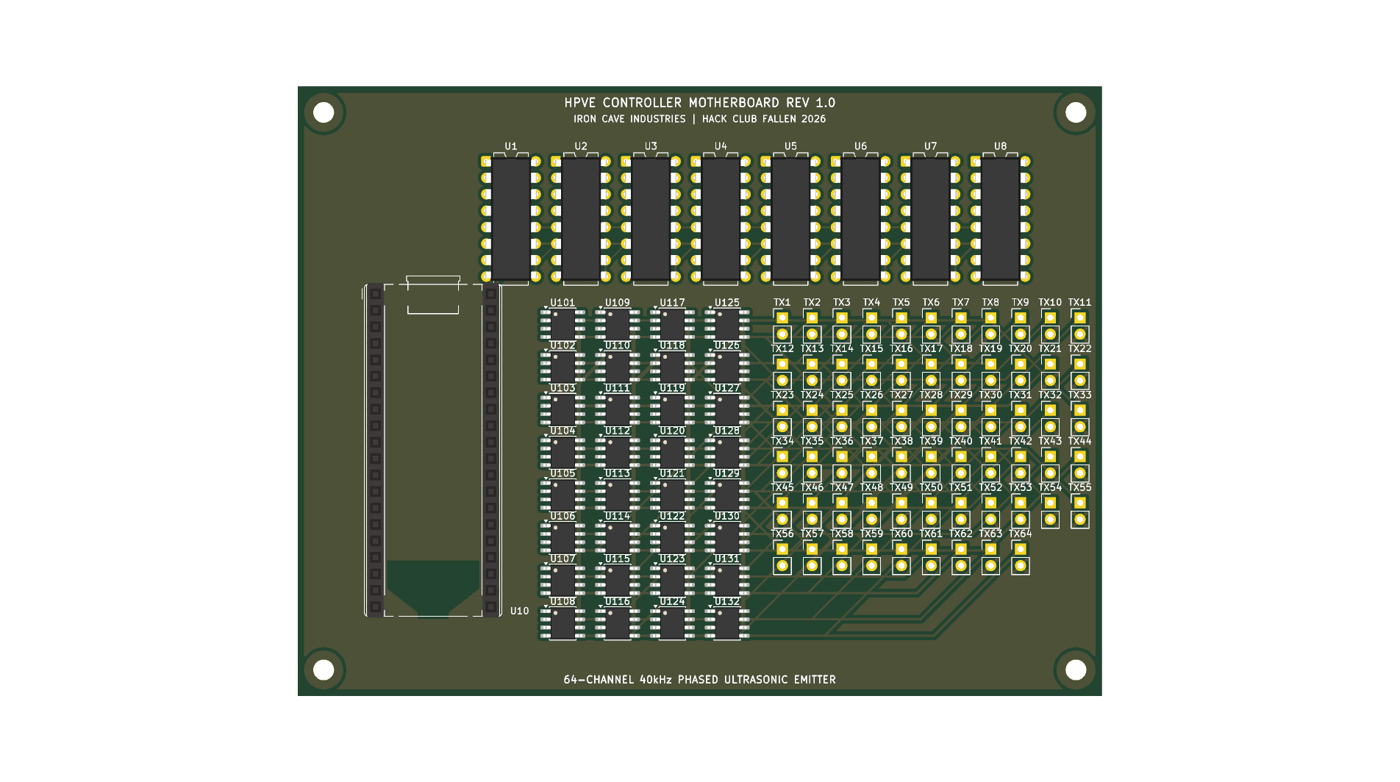
hardware/kicad/hpve_pcb_routed_top.png
