triunex/HPVE-Fallen/hardware/master_carrier/renders/pcb_top.png

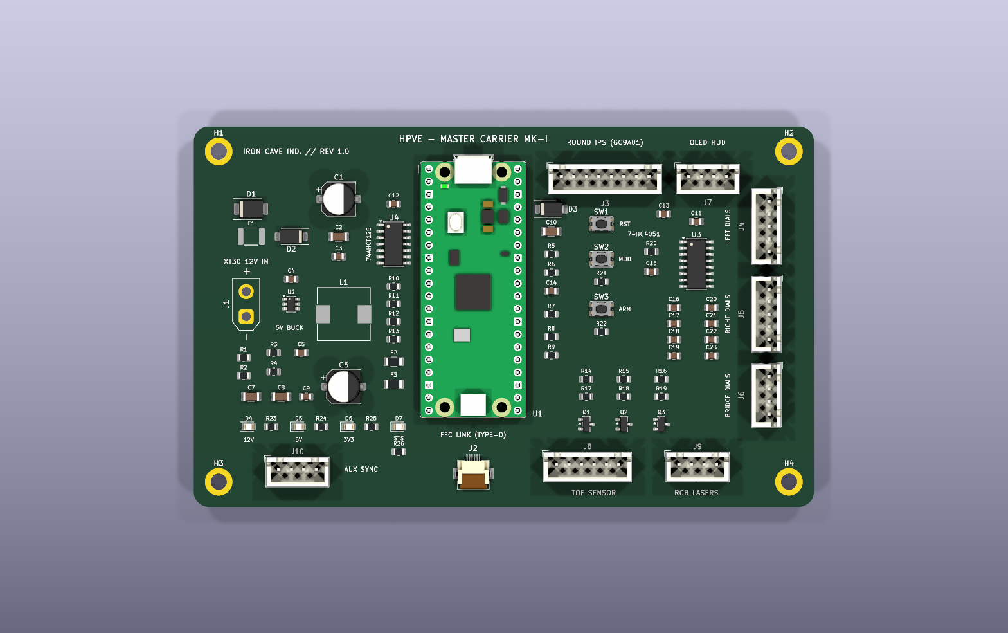
hardware/master_carrier/renders/pcb_top.png
