triunex/HPVE-Fallen/hardware/modular_tile/render_3d_iso.png

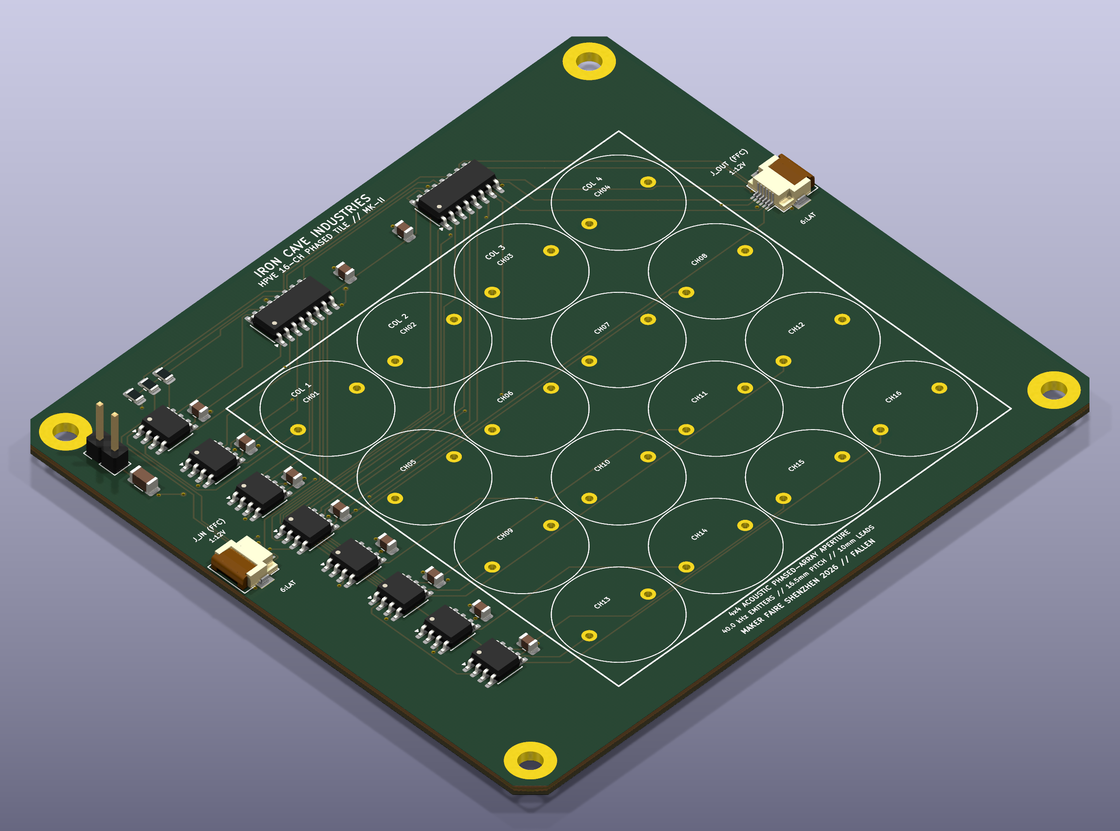
hardware/modular_tile/render_3d_iso.png
