triunex/HPVE-Fallen/hardware/modular_tile/render_3d_with_transducers.png

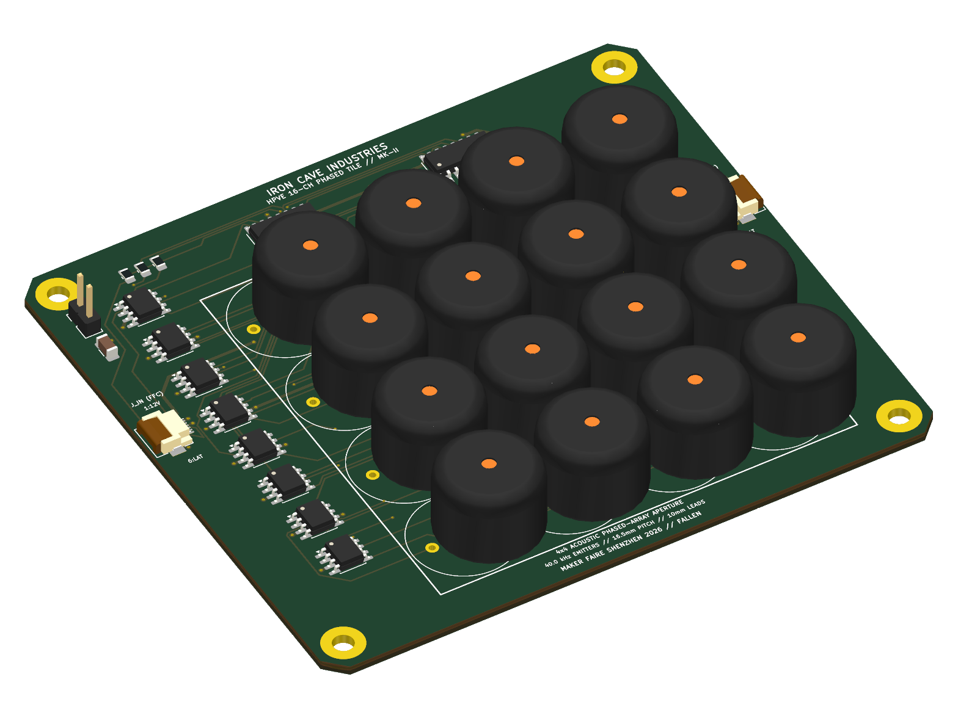
hardware/modular_tile/render_3d_with_transducers.png
