triunex/HPVE-Fallen/hardware/modular_tile/render_bottom.png

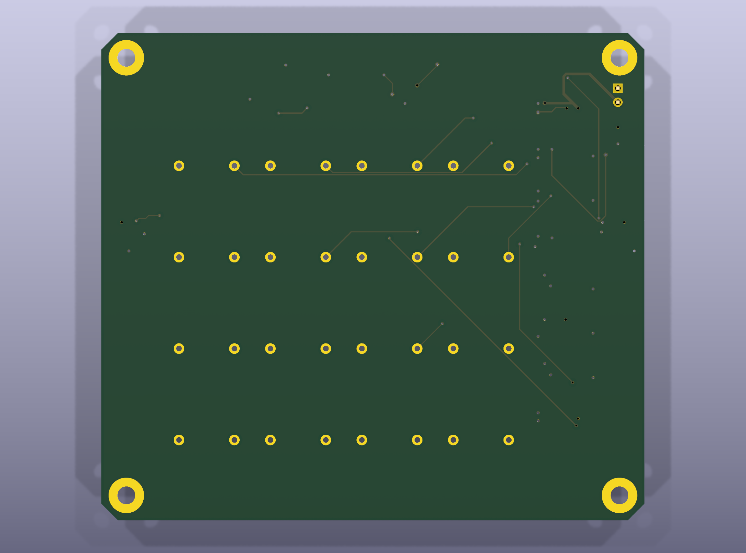
hardware/modular_tile/render_bottom.png
