triunex/HPVE-Fallen/hardware/modular_tile/render_top.png

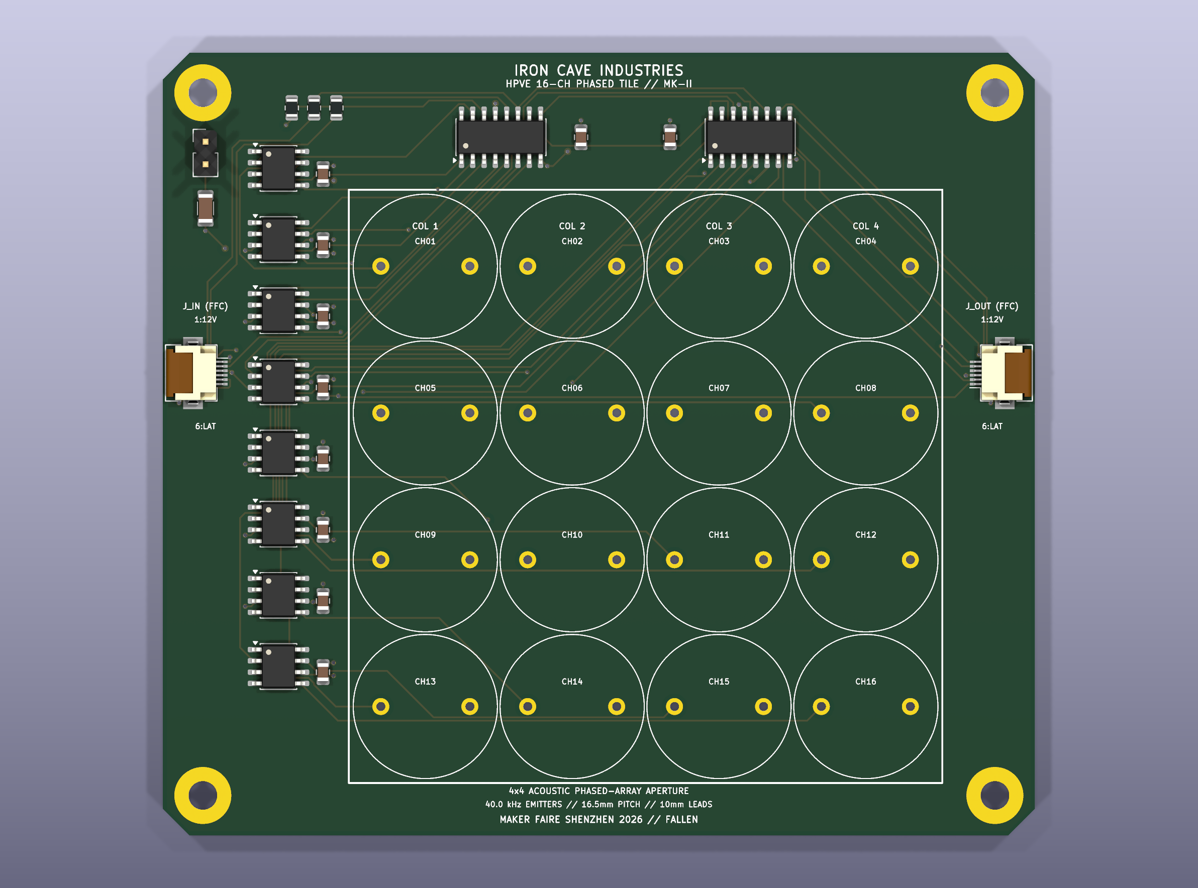
hardware/modular_tile/render_top.png
