triunex/HPVE-Fallen/simulation/acoustic_field_simulation.png

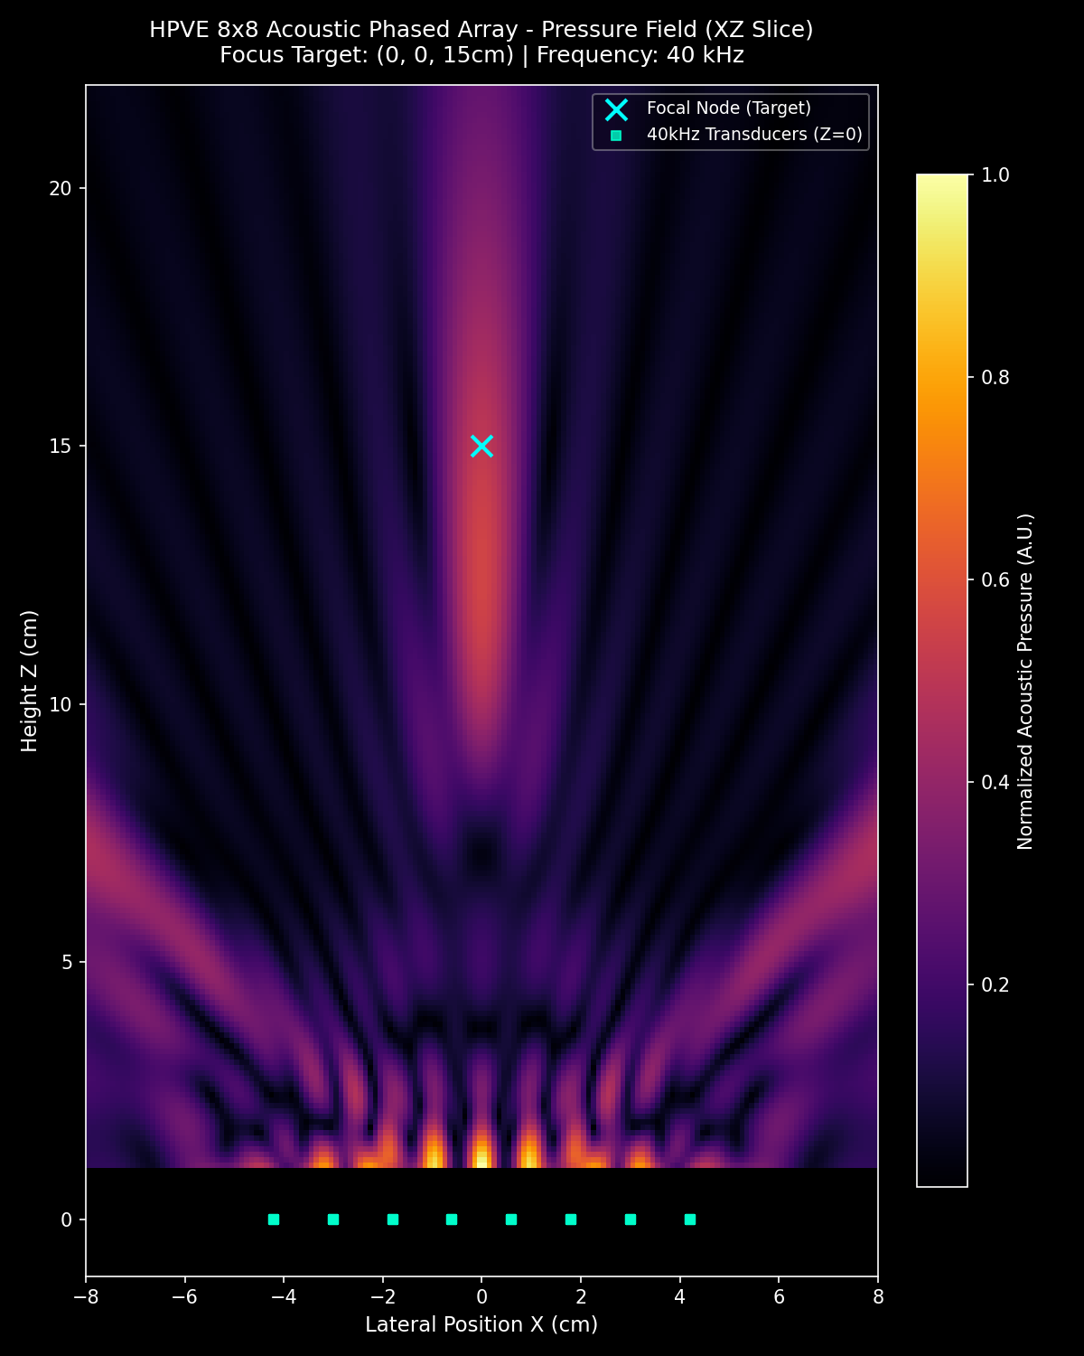
simulation/acoustic_field_simulation.png
