triunex/HPVE-Fallen/simulation/fig1_dynamic_switching_transients.png

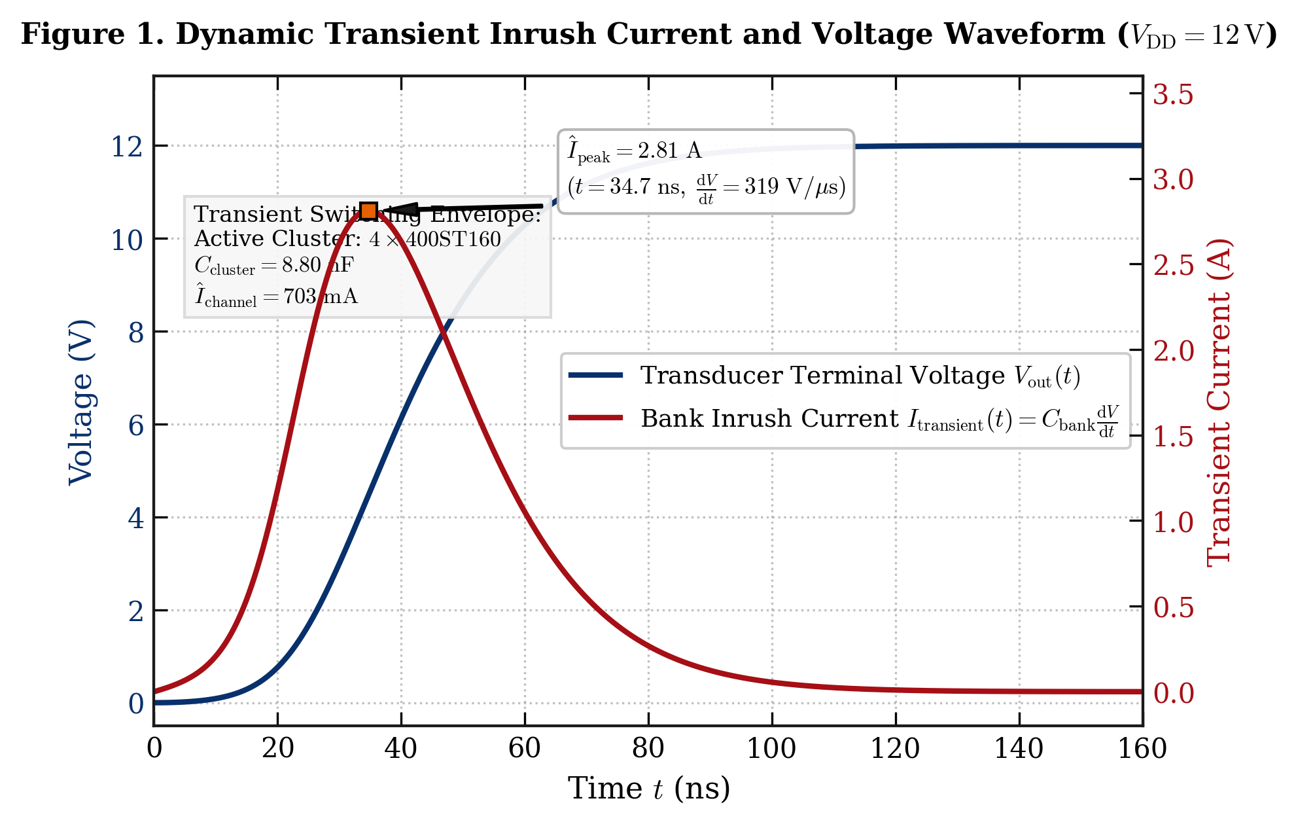
simulation/fig1_dynamic_switching_transients.png
