triunex/HPVE-Fallen/simulation/fig2_power_decoupling_rail_droop.png

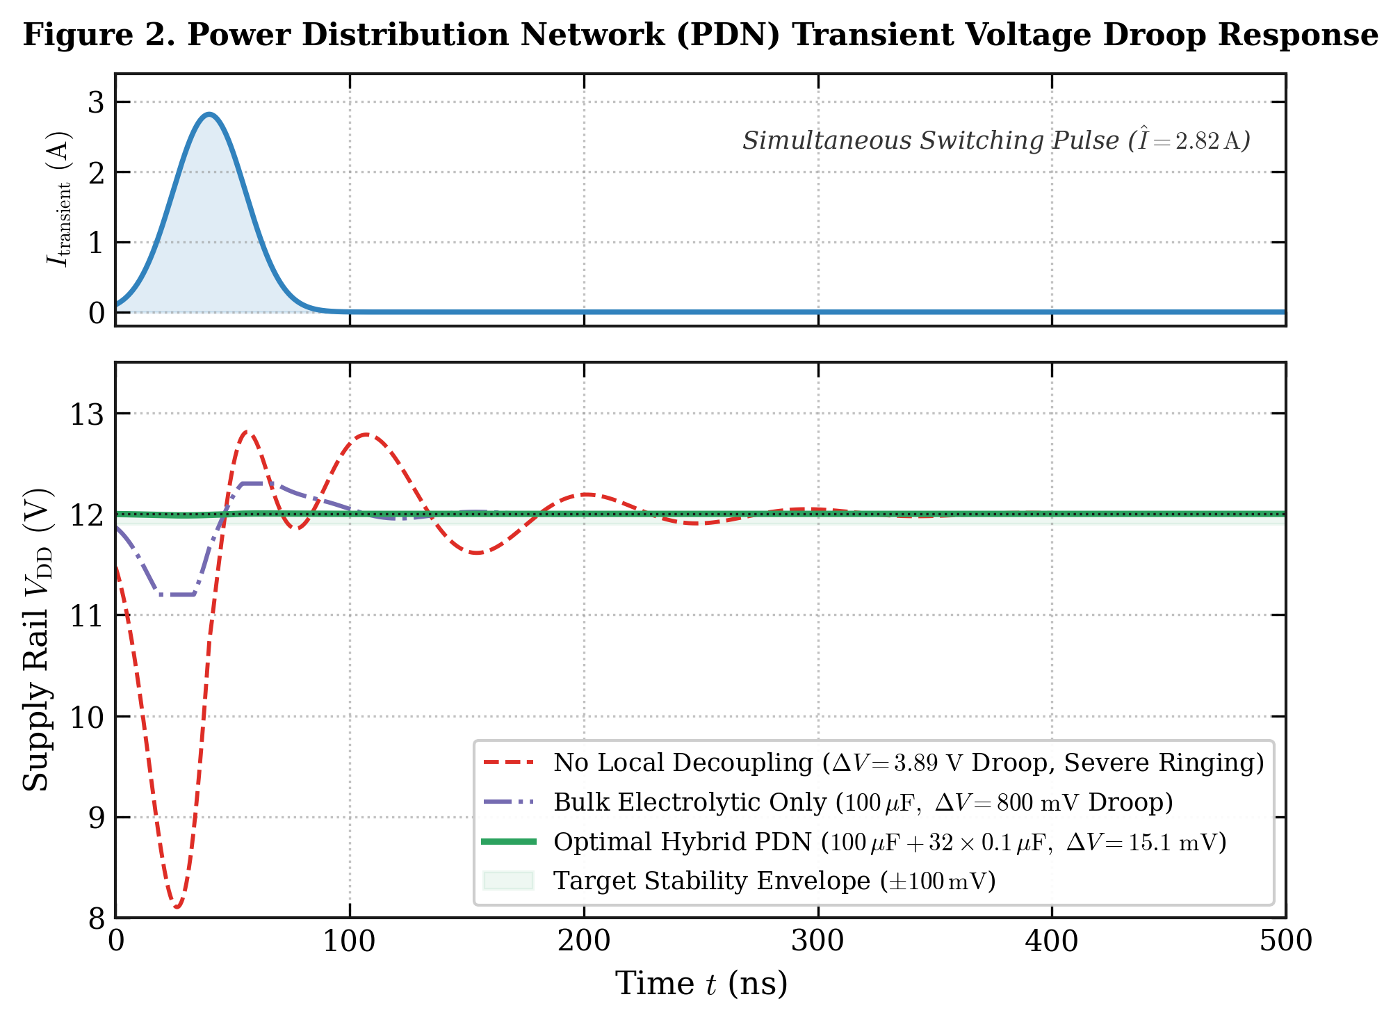
simulation/fig2_power_decoupling_rail_droop.png
