triunex/HPVE-Fallen/simulation/fig3_tc4427_thermal_dissipation_map.png

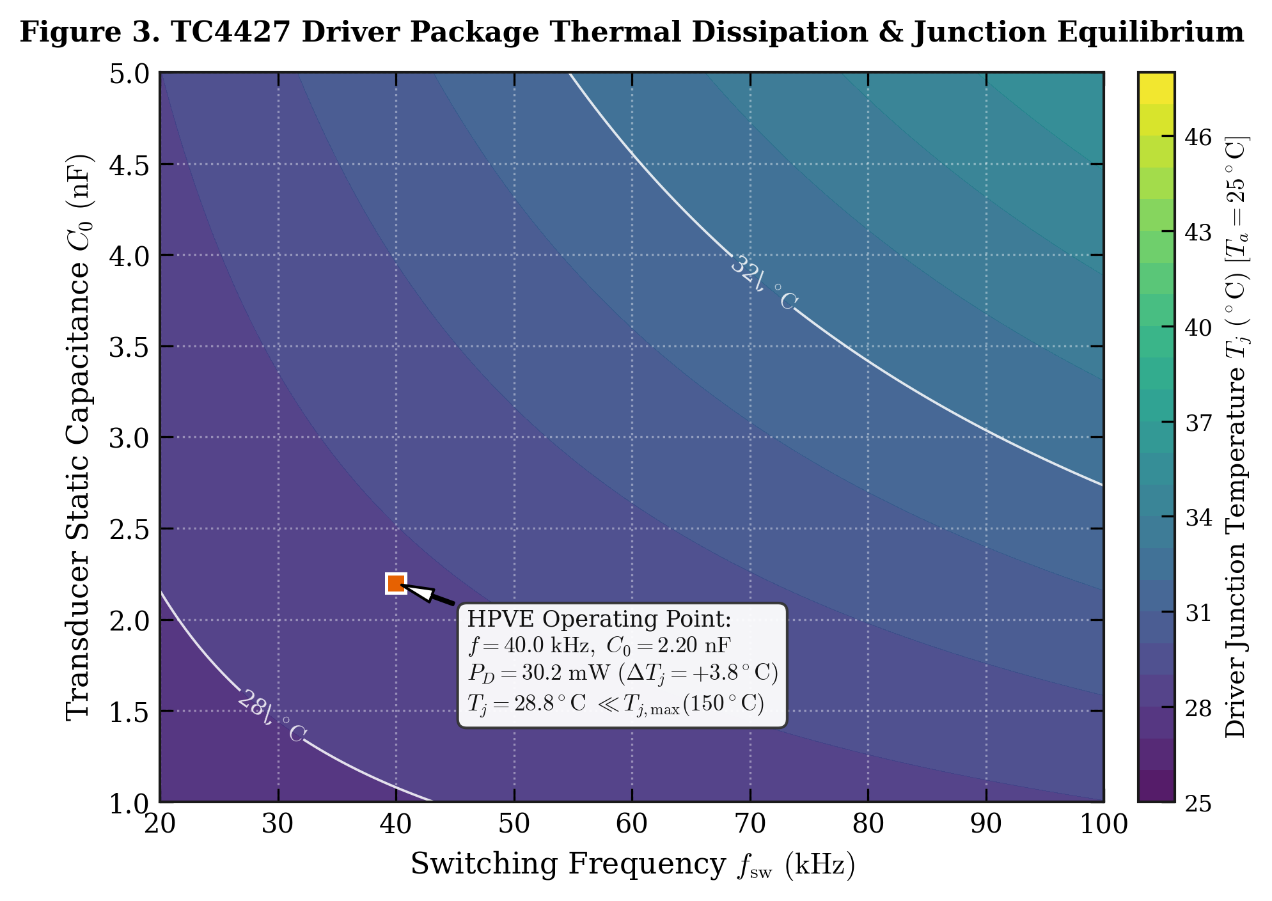
simulation/fig3_tc4427_thermal_dissipation_map.png
