triunex/HPVE-Fallen/simulation/fig4_pio_phase_delay_timing.png

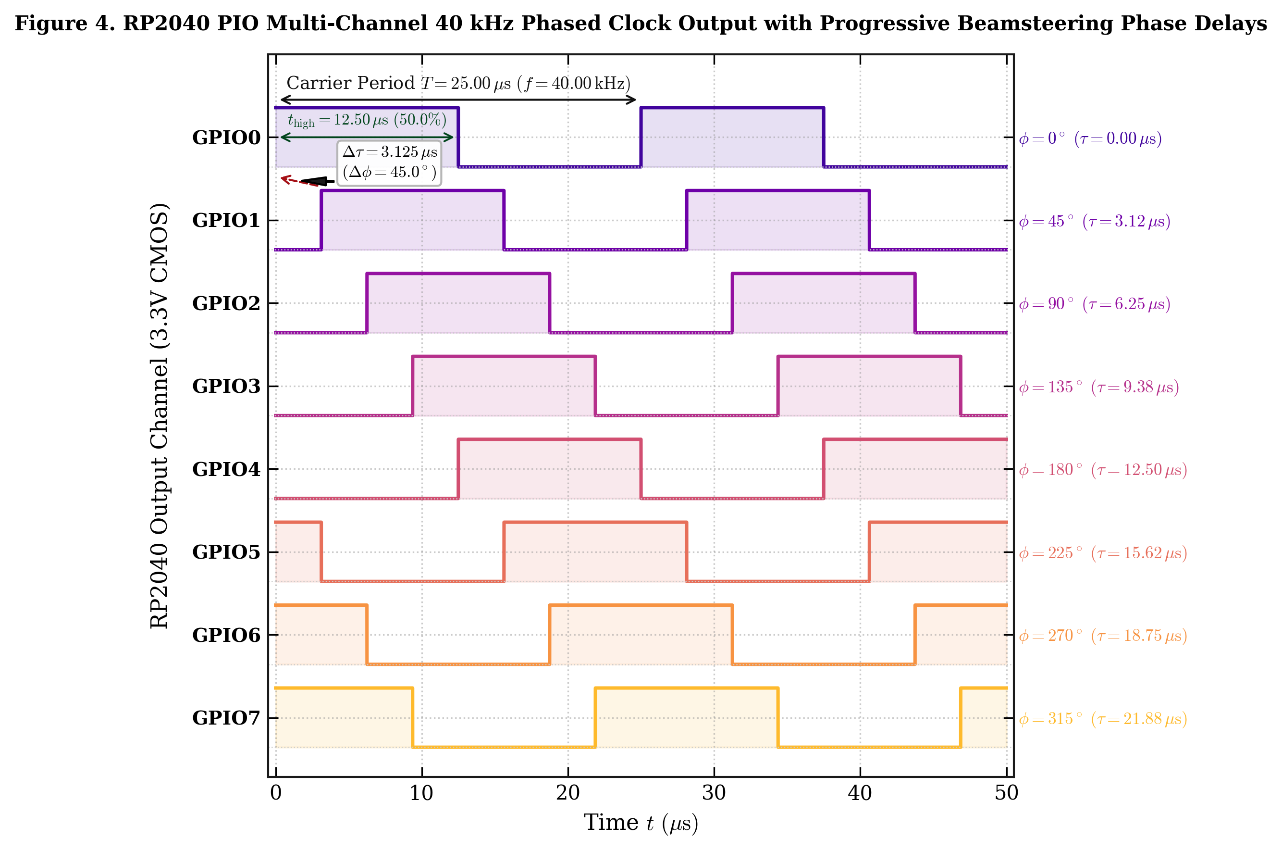
simulation/fig4_pio_phase_delay_timing.png
