triunex/HPVE-Fallen/simulation/fig5_gorkov_3d_potential_well.png

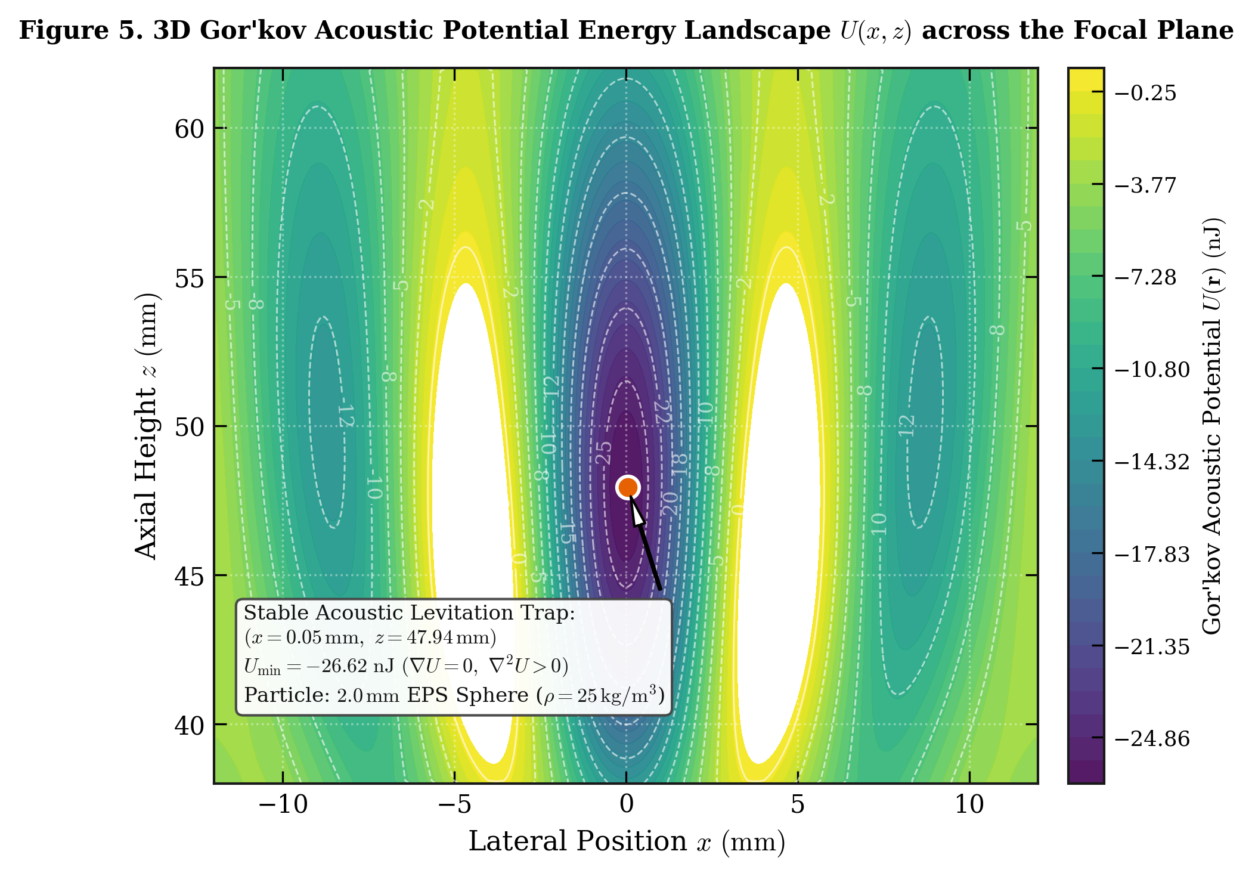
simulation/fig5_gorkov_3d_potential_well.png
