triunex/HPVE-Fallen/simulation/fig6_acoustic_levitation_forces.png

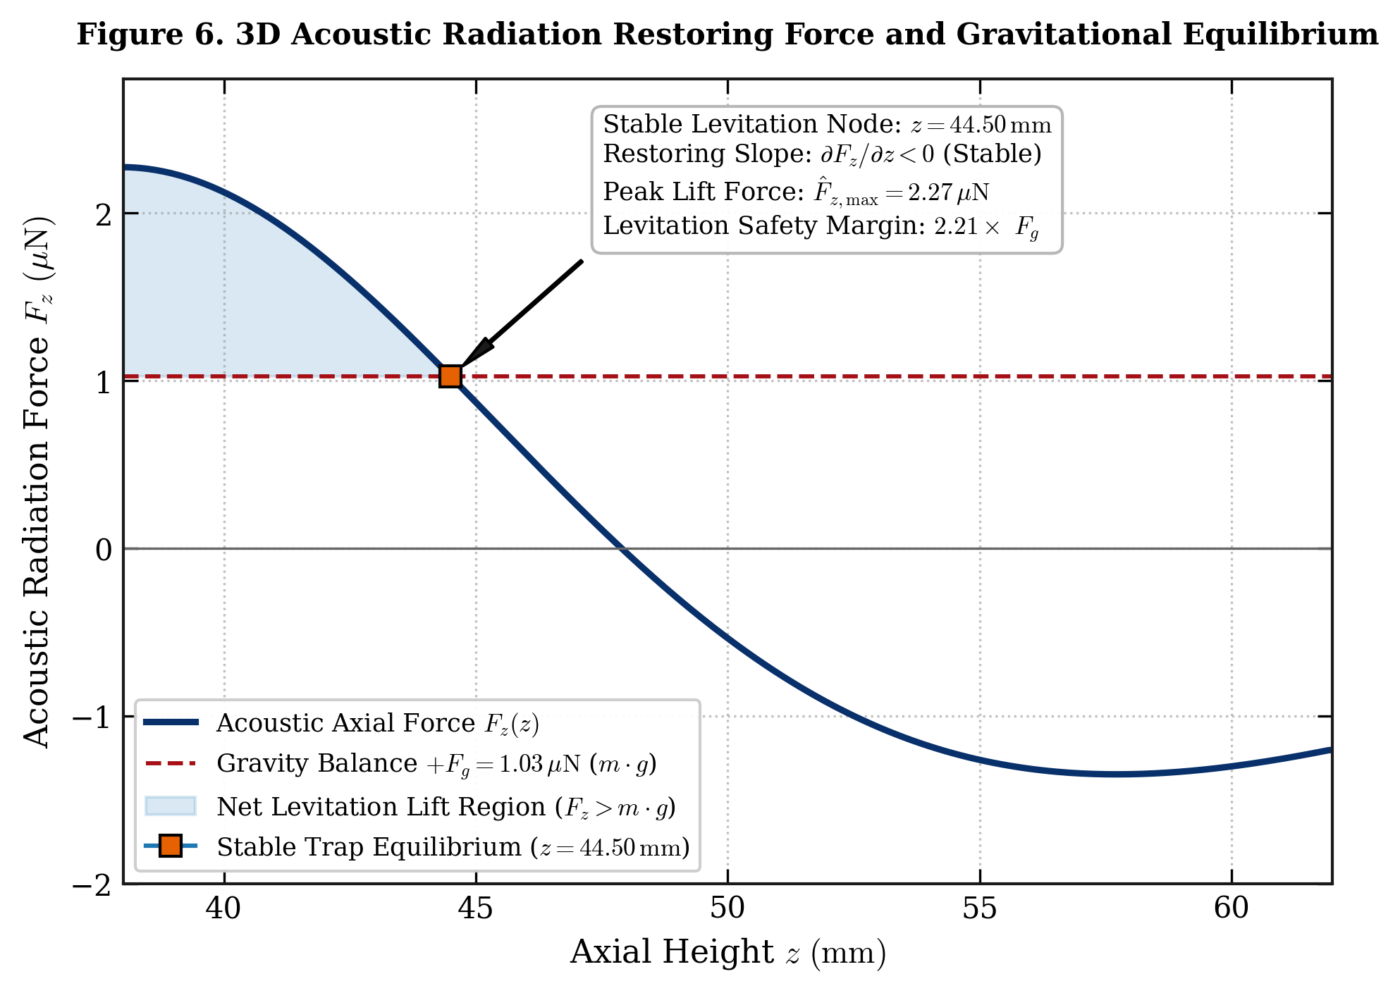
simulation/fig6_acoustic_levitation_forces.png
