triunex/HPVE-Fallen/simulation/fig8_haptic_tactile_radiation_profile.png

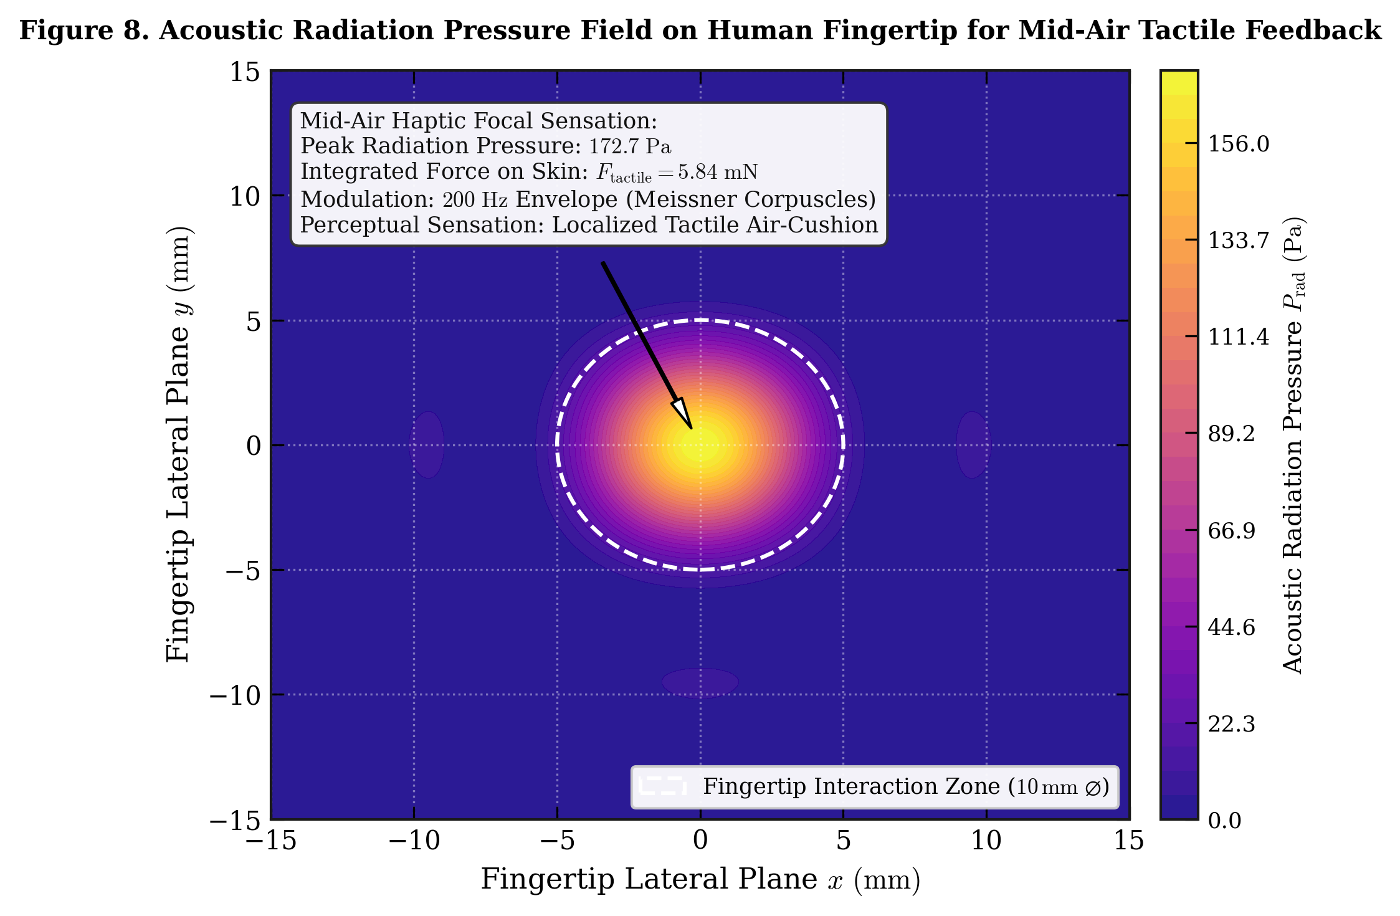
simulation/fig8_haptic_tactile_radiation_profile.png
