triunex/HPVE-Fallen/simulation/fig9_downward_vortex_pressure_bottle.png

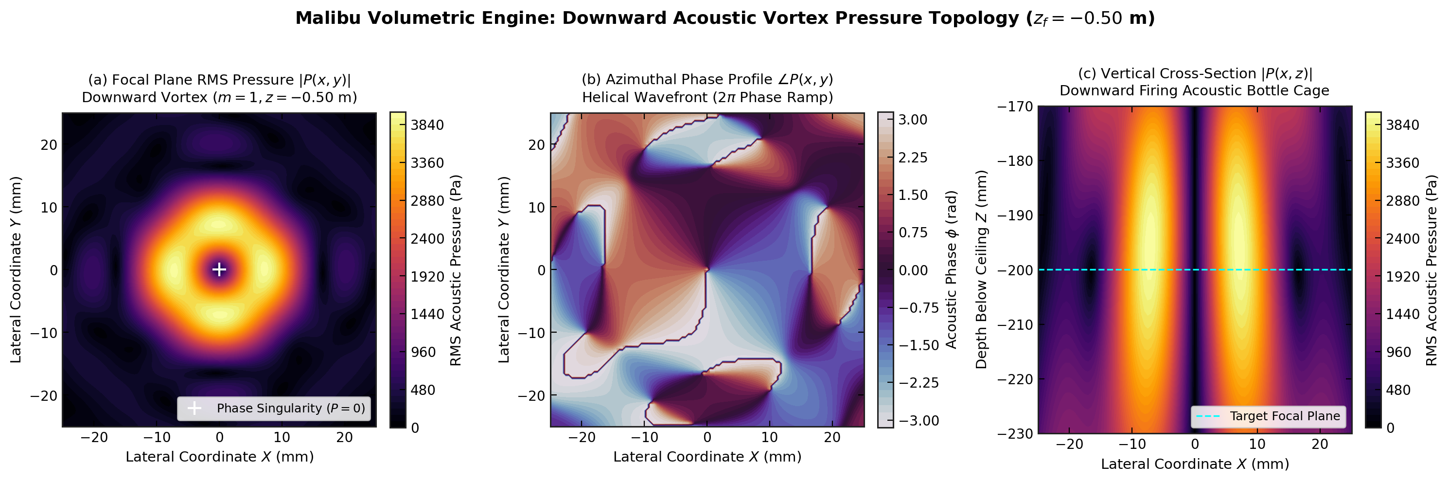
simulation/fig9_downward_vortex_pressure_bottle.png
