triunex/HPVE-Fallen/simulation/fig10_downward_vortex_gorkov_well.png

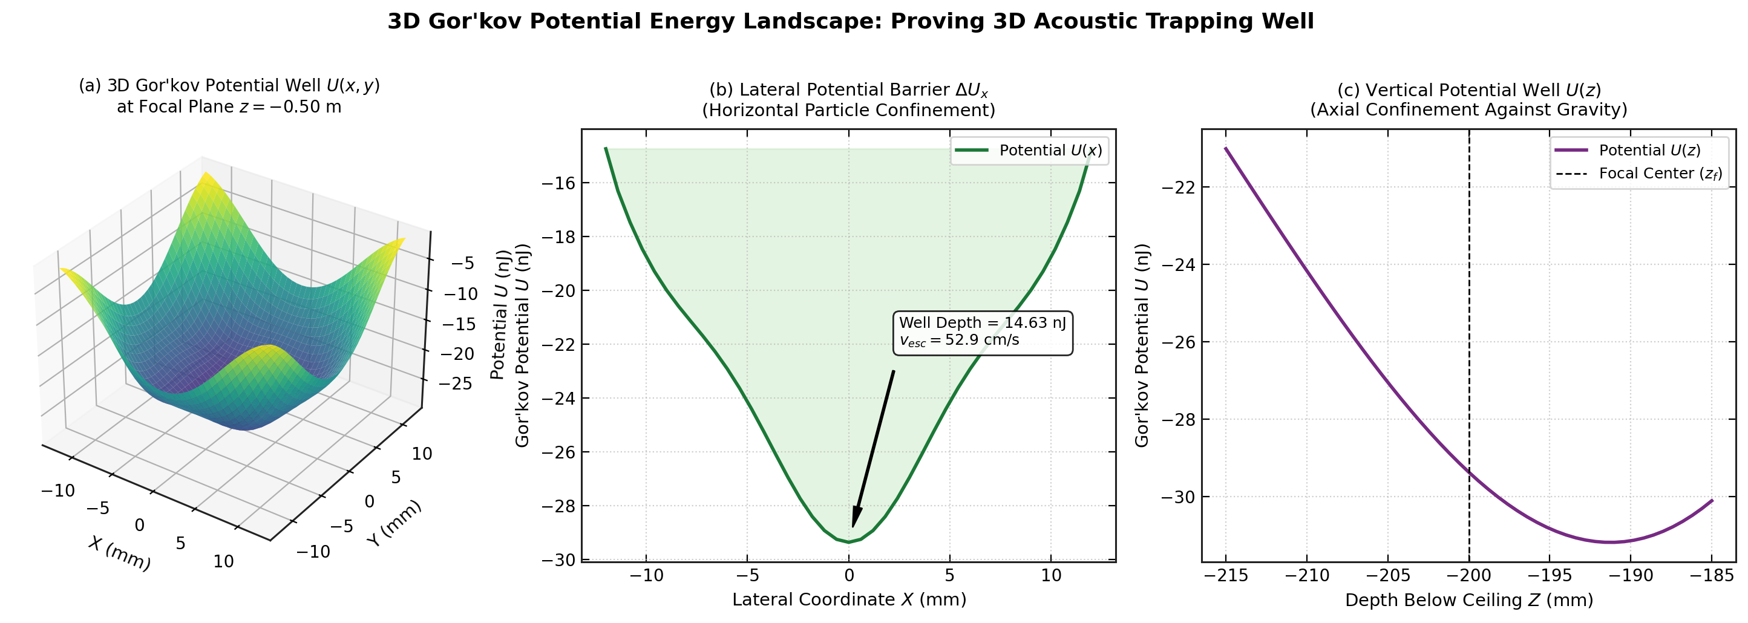
simulation/fig10_downward_vortex_gorkov_well.png
