triunex/HPVE-Fallen/simulation/fig11_downward_radiation_forces.png

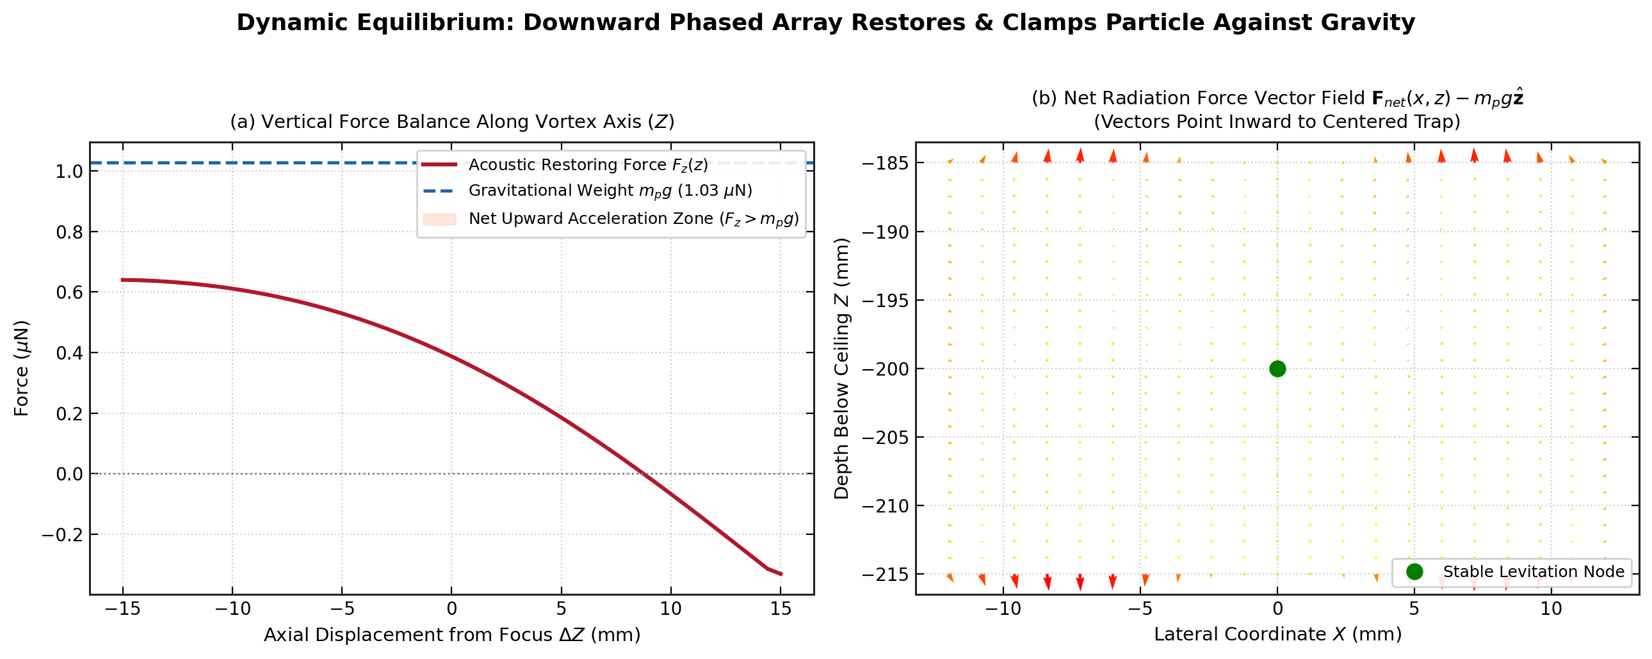
simulation/fig11_downward_radiation_forces.png
