triunex/HPVE-Fallen/simulation/fig12_vortex_vs_twintrap_comparison.png

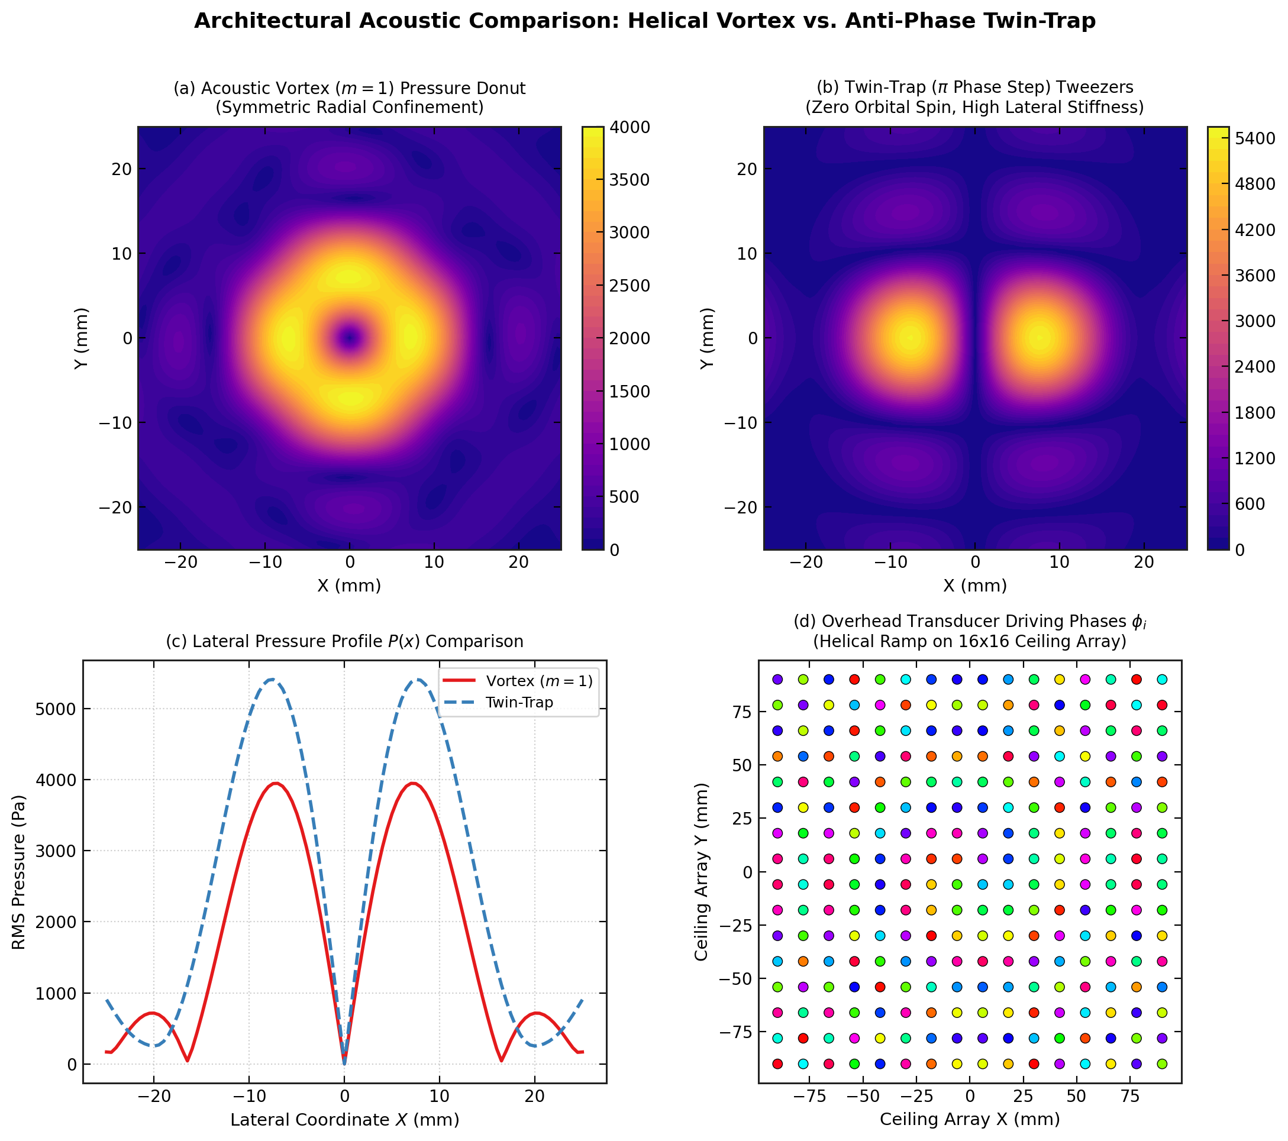
simulation/fig12_vortex_vs_twintrap_comparison.png
