triunex/HPVE-Fallen/simulation/fig13_four_tile_power_and_signal_integrity.png

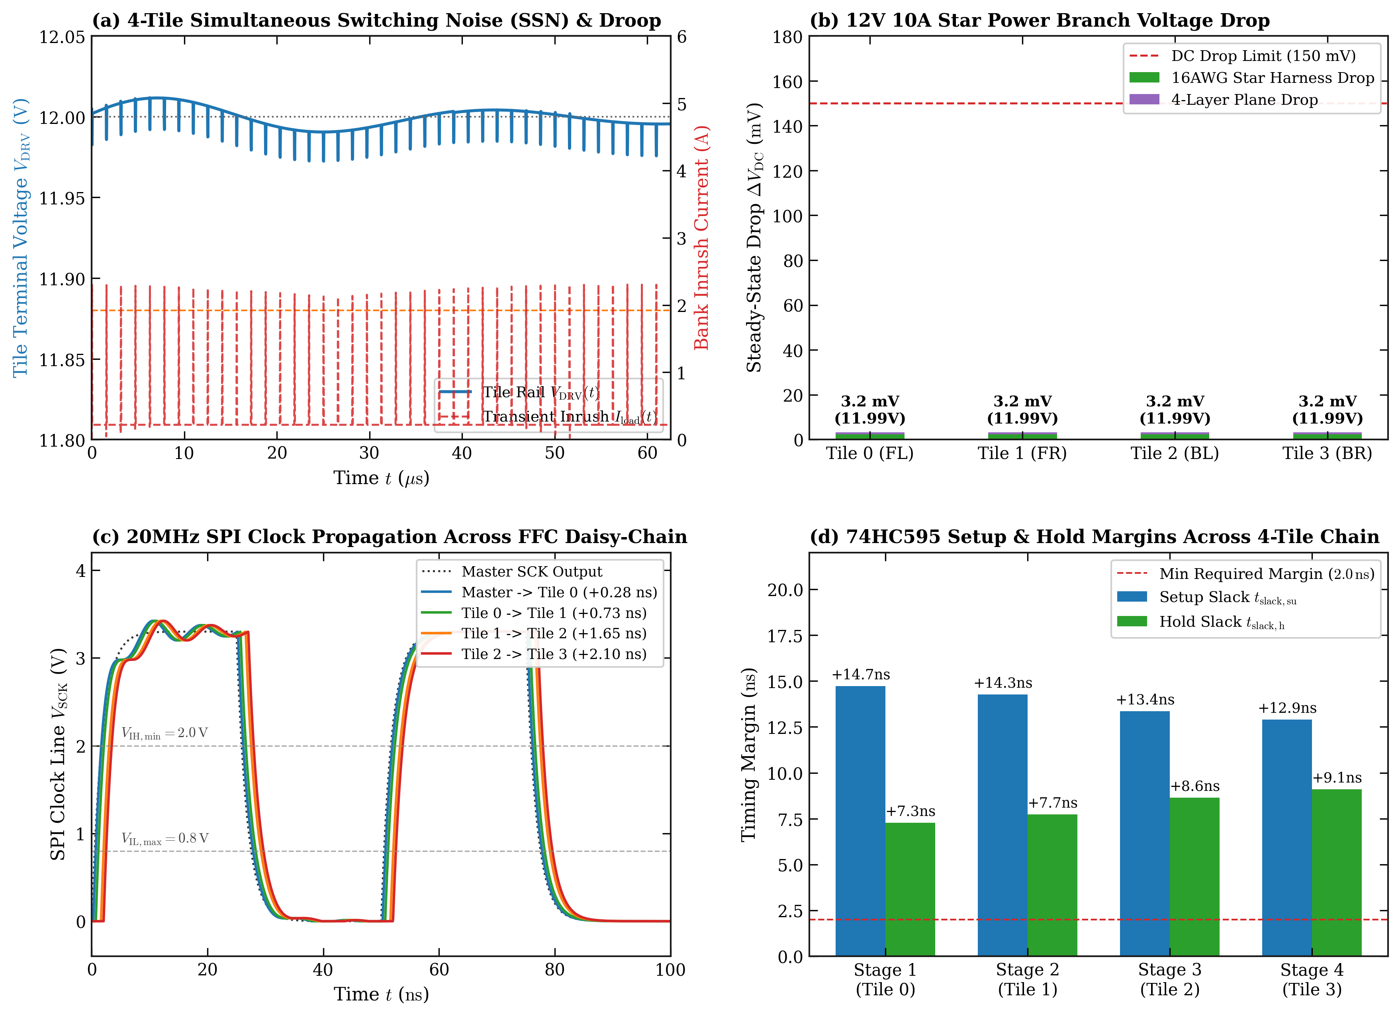
simulation/fig13_four_tile_power_and_signal_integrity.png
