triunex/HPVE-Fallen/simulation/shift_register_timing_analysis.png

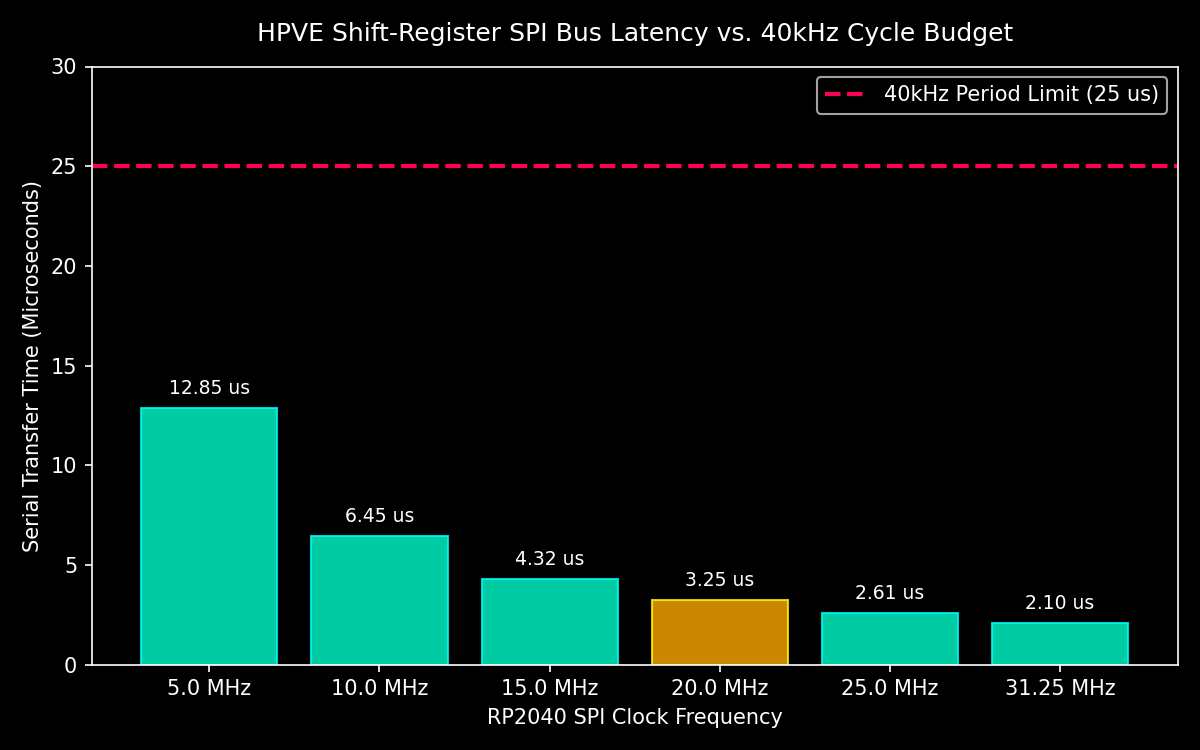
simulation/shift_register_timing_analysis.png
