triunex/HPVE-Fallen/simulation/transducer_bvd_resonance_analysis.png

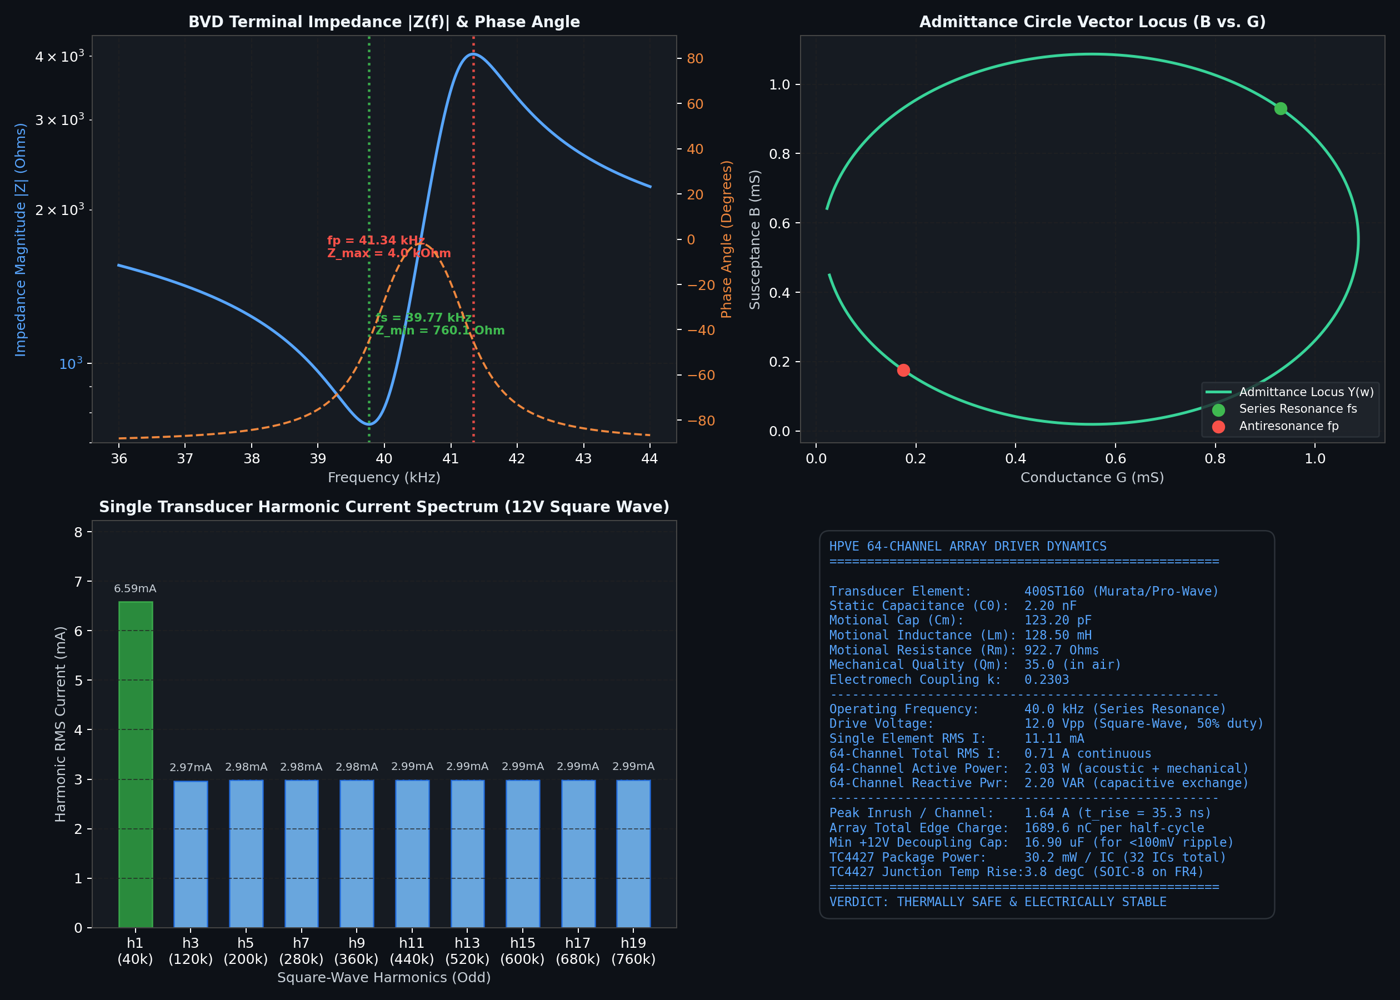
simulation/transducer_bvd_resonance_analysis.png
