triunex/HPVE-Fallen/hardware/HPVE_Tile_16Ch_bom.csv

Comment | Designator | Footprint | LCSC Part #
74HC595D SOIC-16 Shift Register | U1,U2 | SOIC-16_3.9x9.9mm_P1.27mm | C5947
TC4427EOA SOIC-8 Dual Driver | U101,U102,U103,U104,U105,U106,U107,U108 | SOIC-8_3.9x4.9mm_P1.27mm | C636891
0.1uF 50V X7R Ceramic 0805 | C1,C2 | C_0805_2012Metric | C49678
0.1uF 50V X7R Ceramic 0805 | C101,C102,C103,C104,C105,C106,C107,C108 | C_0805_2012Metric | C49678
10uF 25V X7R Ceramic MLCC 1206 | C_BULK | C_1206_3216Metric | C15850
33R 1% 0805 Resistor | R1,R2,R3 | R_0805_2012Metric | C17631
0.5mm FFC 6-Pin Horizontal Connector | J_IN,J_OUT | Hirose_FH12-6S-0.5SH_1x06-1MP_P0.50mm_Horizontal
400ST160 Transducer Female Socket 1x02 | TX1,TX2,TX3,TX4,TX5,TX6,TX7,TX8,TX9,TX10,TX11,TX12,TX13,TX14,TX15,TX16 | PinSocket_1x02_P2.54mm_Vertical
AUX 12V/GND Header 1x02 P2.54mm | J_PWR | PinHeader_1x02_P2.54mm_Vertical
