triunex/HPVE-Fallen/hardware/master_carrier/HPVE_Master_Carrier_bom.csv

Comment | Designator | Footprint | Qty | LCSC Part # | MPN
100uF_35V | C1 | CP_Elec_6.3x7.7 | 1 | C128836 | RVT1V101M0607
10uF_25V | C10,C2 | C_1206_3216Metric | 2 | C13585 | CL31A106KAHNNNE
100nF | C11,C12,C13,C14,C16,C17,C18,C19,C20,C21,C22,C23,C3,C4,C9 | C_0805_2012Metric | 15 | C49678 | CL21B104KBCNNNC
10nF | C15 | C_0805_2012Metric | 1 | C1710 | CL21B103KBANNNC
100pF | C5 | C_0805_2012Metric | 1 | C1791 | CL21C101JBANNNC
100uF_16V | C6 | CP_Elec_6.3x7.7 | 1 | C128835 | RVT1C101M0607
22uF_16V | C7,C8 | C_1206_3216Metric | 2 | C12891 | CL31A226KOHNNNE
SMBJ15CA | D1 | D_SMB | 1 | C116756 | SMBJ15CA
SS34 | D2,D3 | D_SMA | 2 | C8678 | SS34
LED_12V_AMB | D4 | LED_0805_2012Metric | 1 | C2296 | LED_12V_AMB
LED_5V_GRN | D5 | LED_0805_2012Metric | 1 | C2297 | LED_5V_GRN
LED_3V3_CYN | D6 | LED_0805_2012Metric | 1 | C2293 | LED_3V3_CYN
LED_STAT_ORG | D7 | LED_0805_2012Metric | 1 | C2295 | LED_STAT_ORG
5A_PTC | F1 | Fuse_1812_4532Metric | 1 | C69682 | 1812L500/24DR
0.5A_PTC | F2,F3 | Fuse_1206_3216Metric | 2 | C369168 | SMD1206P050TF
XT30_12V_IN | J1 | AMASS_XT30UPB-M_1x02_P5.0mm_Vertical | 1 | C2913283 | AMASS-XT30UPB-M
AUX_SYNC_4P | J10 | JST_XH_B4B-XH-A_1x04_P2.50mm_Vertical | 1 | C158012 | B4B-XH-A
FH12-6S-0.5SH | J2 | Hirose_FH12-6S-0.5SH_1x06-1MP_P0.50mm_Horizontal | 1 | C424667 | FH12-6S-0.5SH(55)
GC9A01_ROUND_IPS | J3 | JST_XH_B8B-XH-A_1x08_P2.50mm_Vertical | 1 | C71698 | B8B-XH-A
LEFT_DIALS_5P | J4 | JST_XH_B5B-XH-A_1x05_P2.50mm_Vertical | 1 | C173752 | B5B-XH-A
RIGHT_DIALS_5P | J5 | JST_XH_B5B-XH-A_1x05_P2.50mm_Vertical | 1 | C173752 | B5B-XH-A
BRIDGE_DIALS_4P | J6 | JST_XH_B4B-XH-A_1x04_P2.50mm_Vertical | 1 | C158012 | B4B-XH-A
SSD1306_OLED_4P | J7 | JST_XH_B4B-XH-A_1x04_P2.50mm_Vertical | 1 | C158012 | B4B-XH-A
VL53L5CX_6P | J8 | JST_XH_B6B-XH-A_1x06_P2.50mm_Vertical | 1 | C158014 | B6B-XH-A
RGB_LASERS_4P | J9 | JST_XH_B4B-XH-A_1x04_P2.50mm_Vertical | 1 | C158012 | B4B-XH-A
10uH_6.5A | L1 | L_10.4x10.4_H4.8 | 1 | C169395 | CDRH104RNP-100NC
AO3400A | Q1,Q2,Q3 | SOT-23 | 3 | C20917 | AO3400A
100k_1% | R1,R3 | R_0805_2012Metric | 2 | C17407 | 0805W8F1003T5E
33R | R10,R11,R12,R13 | R_0805_2012Metric | 4 | C17630 | 0805W8F330JT5E
100R | R14,R15,R16 | R_0805_2012Metric | 3 | C17408 | 0805W8F1000T5E
10k | R17,R18,R19,R21,R22 | R_0805_2012Metric | 5 | C17414 | 0805W8F1002T5E
22k_1% | R2 | R_0805_2012Metric | 1 | C17560 | 0805W8F2202T5E
100k | R20 | R_0805_2012Metric | 1 | C17407 | 0805W8F1003T5E
4.7k | R23 | R_0805_2012Metric | 1 | C17673 | 4.7k
1k | R24 | R_0805_2012Metric | 1 | C17513 | 1k
470R | R25,R26 | R_0805_2012Metric | 2 | C17710 | 470R
13.3k_1% | R4 | R_0805_2012Metric | 1 | C17451 | 0805W8F1332T5E
39k_1% | R5 | R_0805_2012Metric | 1 | C17651 | 0805W8F3902T5E
10k_1% | R6 | R_0805_2012Metric | 1 | C17414 | 0805W8F1002T5E
0R_STAR_GND | R7 | R_0805_2012Metric | 1 | C17477 | 0805W8F0000T5E
4.7k | R8,R9 | R_0805_2012Metric | 2 | C17673 | 0805W8F4701T5E
SW_RESET | SW1 | SW_Push_1P1T_NO_CK_KMR2 | 1 | C115356 | KMR231GLFS
SW_MODE | SW2 | SW_Push_1P1T_NO_CK_KMR2 | 1 | C115356 | KMR231GLFS
SW_ENABLE | SW3 | SW_Push_1P1T_NO_CK_KMR2 | 1 | C115356 | KMR231GLFS
RaspberryPi_Pico | U1 | RaspberryPi_Pico_Common_THT | 1 |  | RPI-PICO
TPS54302DDCR | U2 | SOT-23-6 | 1 | C314440 | TPS54302DDCR
CD74HC4051M | U3 | SOIC-16_3.9x9.9mm_P1.27mm | 1 | C7430 | CD74HC4051M96
SN74AHCT125D | U4 | SOIC-14_3.9x8.7mm_P1.27mm | 1 | C5440 | SN74AHCT125DR
