triunex/HPVE-Fallen/hardware/modular_tile/production/HPVE_Tile_16Ch_bom.csv

Comment | Designator | Footprint | LCSC Part #
0.1uF 50V X7R 0805 | C1,C2,C101,C102,C103,C104,C105,C106,C107,C108 | C_0805_2012Metric | C49678
10uF 25V X5R/X7R 1206 | C_BULK | C_1206_3216Metric | C15850
FH12-6S-0.5SH(55) FFC 6P 0.5mm horizontal | J_IN,J_OUT | Hirose_FH12-6S-0.5SH_1x06-1MP_P0.50mm_Horizontal | C283048
33R 1% 0805 | R1,R2,R3 | R_0805_2012Metric | C17631
74HC595D SOIC-16 Shift Register | U1,U2 | SOIC-16_3.9x9.9mm_P1.27mm | C5947
TC4427EOA SOIC-8 Dual MOSFET Driver | U101,U102,U103,U104,U105,U106,U107,U108 | SOIC-8_3.9x4.9mm_P1.27mm | C636891
