triunex/HPVE-Fallen/hardware/cad/halo_arch/renders/g_bare_parts_inside_cutaway.png

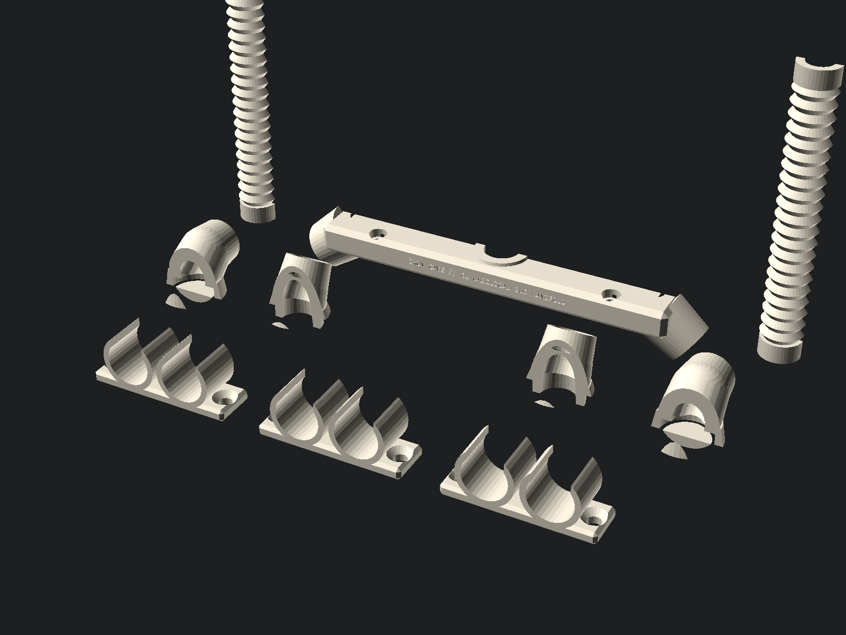
hardware/cad/halo_arch/renders/g_bare_parts_inside_cutaway.png
