triunex/HPVE-Fallen/hardware/cad/HPVE_2x2_Quad_Assembly.stl

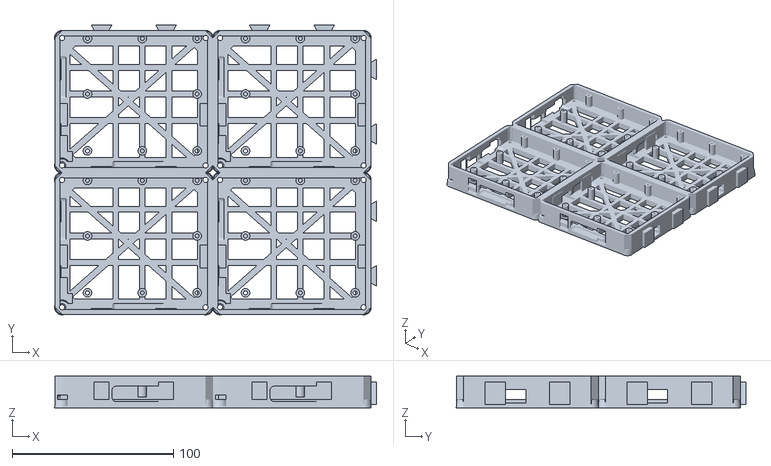
[picture p97: CAD file, 2026-11-05]
hardware/cad/HPVE_2x2_Quad_Assembly.stl
199.7 x 179.7 x 19.8
