triunex/HPVE-Fallen/hardware/cad/halo_arch/stl/HPVE_Halo_F5_PSU_Knurled_Dial_And_Orange_Trim_Set.stl

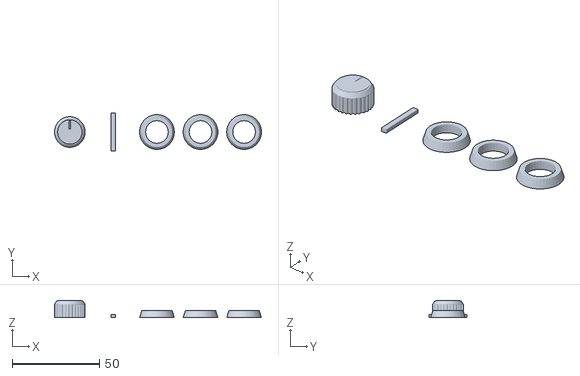
[picture p98: CAD file, 2026-11-10]
hardware/cad/halo_arch/stl/HPVE_Halo_F5_PSU_Knurled_Dial_And_Orange_Trim_Set.stl
118.8 x 21.6 x 10.0
