triunex/HPVE-Fallen/hardware/cad/HPVE_Rear_Avionics_Dock_Shield.stl

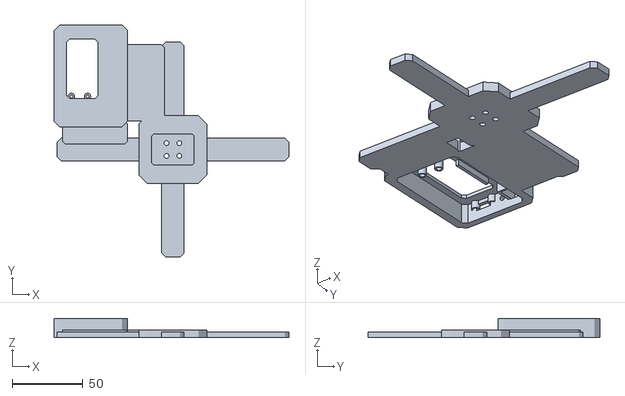
[picture p99: CAD file, 2026-11-05]
hardware/cad/HPVE_Rear_Avionics_Dock_Shield.stl
166.0 x 164.0 x 13.5
