triunex/HPVE-Fallen/hardware/cad/print_shop_stls/10_Halo_Arch_Right_Pillar_x1.stl

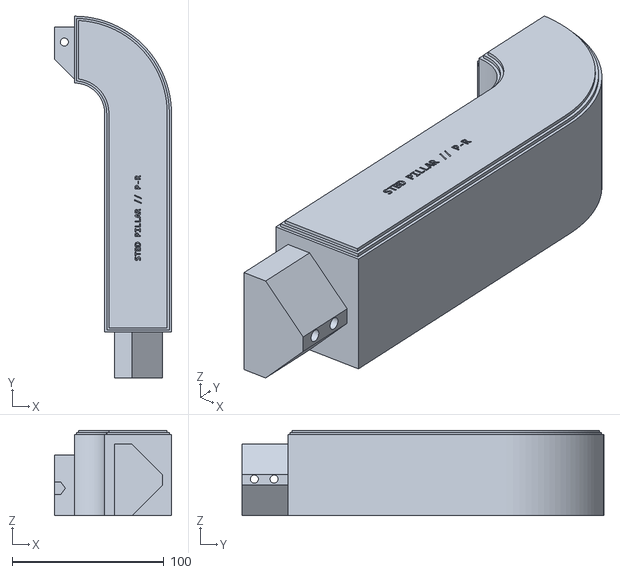
[picture p100: CAD file, 2026-11-10]
hardware/cad/print_shop_stls/10_Halo_Arch_Right_Pillar_x1.stl
77.0 x 238.0 x 56.0
