triunex/HPVE-Fallen/hardware/cad/halo_arch/stl/HPVE_Halo_A2_Dock_Yoke.stl

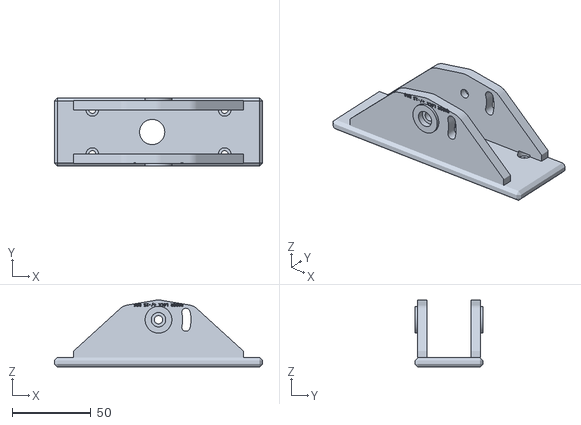
[picture p101: CAD file, 2026-11-10]
hardware/cad/halo_arch/stl/HPVE_Halo_A2_Dock_Yoke.stl
132.0 x 43.0 x 42.5
