triunex/HPVE-Fallen/hardware/cad/HPVE_Tile_Frame_Dovetail.stl

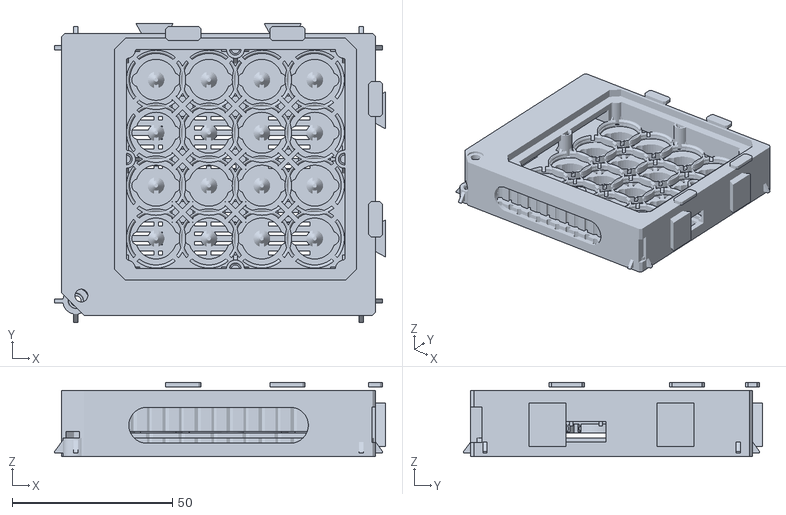
[picture p102: CAD file, 2026-11-05]
hardware/cad/HPVE_Tile_Frame_Dovetail.stl
103.3 x 93.3 x 23.2
