triunex/HPVE-Fallen/hardware/cad/print_shop_stls/06_Rear_Avionics_Gimbal_Backplane_x1.stl

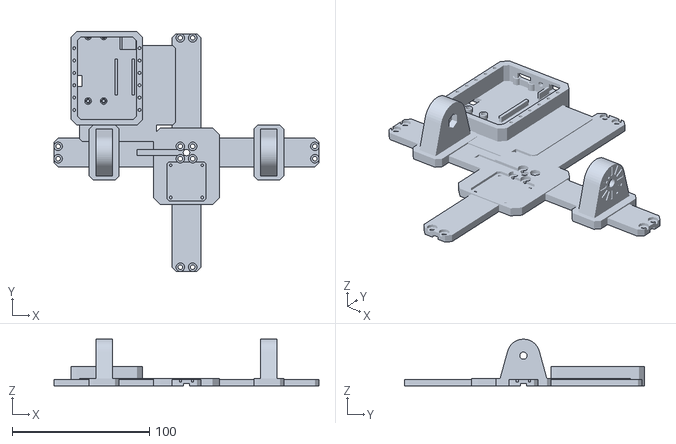
[picture p103: CAD file, 2026-11-10]
hardware/cad/print_shop_stls/06_Rear_Avionics_Gimbal_Backplane_x1.stl
193.0 x 174.5 x 34.0
