triunex/HPVE-Fallen/hardware/cad/halo_arch/stl/HPVE_Halo_G1_Array_Rear_Umbilical_Manifold.stl

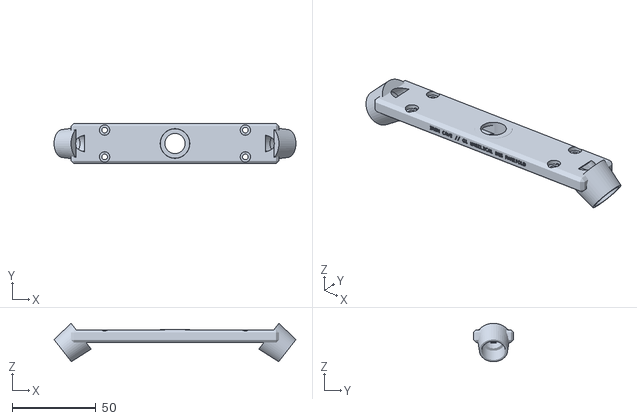
[picture p104: CAD file, 2026-11-10]
hardware/cad/halo_arch/stl/HPVE_Halo_G1_Array_Rear_Umbilical_Manifold.stl
144.4 x 24.0 x 22.9
