triunex/HPVE-Fallen/hardware/cad/HPVE_Interlock_Corner_Brace.stl

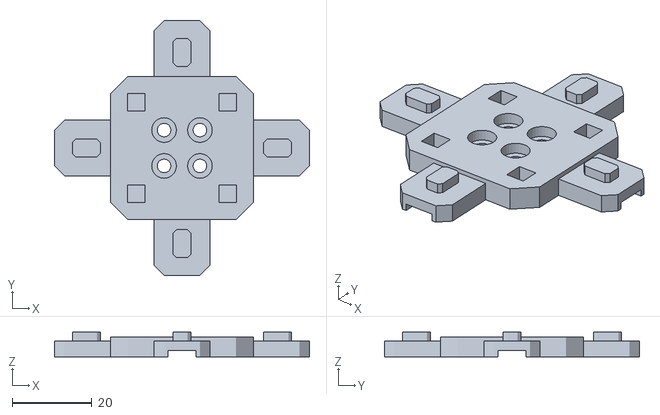
[picture p105: CAD file, 2026-11-05]
hardware/cad/HPVE_Interlock_Corner_Brace.stl
64.0 x 64.0 x 6.20
