triunex/HPVE-Fallen/hardware/cad/print_shop_stls/11_Halo_Arch_Top_Bridge_x1.stl

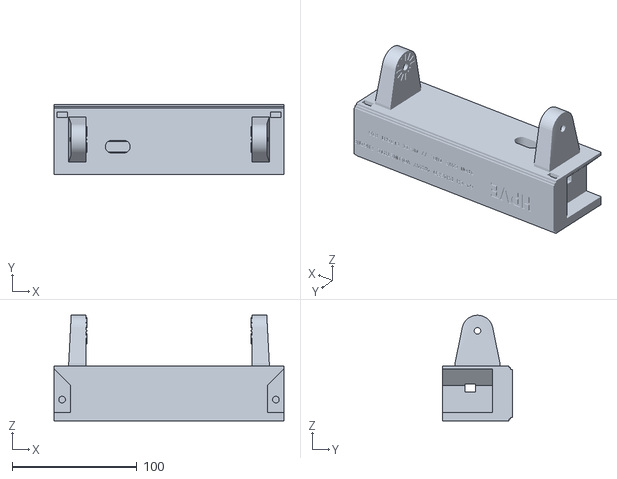
[picture p106: CAD file, 2026-11-10]
hardware/cad/print_shop_stls/11_Halo_Arch_Top_Bridge_x1.stl
184.0 x 56.0 x 84.5
