triunex/HPVE-Fallen/hardware/cad/halo_arch/stl/HPVE_Halo_G5_TPU_Corrugated_Umbilical_Conduits_Set.stl

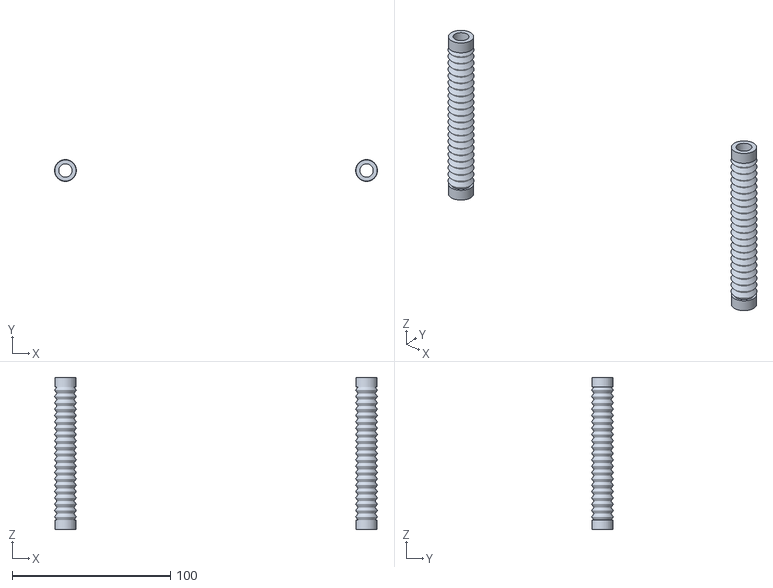
[picture p107: CAD file, 2026-11-10]
hardware/cad/halo_arch/stl/HPVE_Halo_G5_TPU_Corrugated_Umbilical_Conduits_Set.stl
203.8 x 13.8 x 96.0
