triunex/HPVE-Fallen/hardware/cad/HPVE_Acoustic_Horn_Bezel.stl

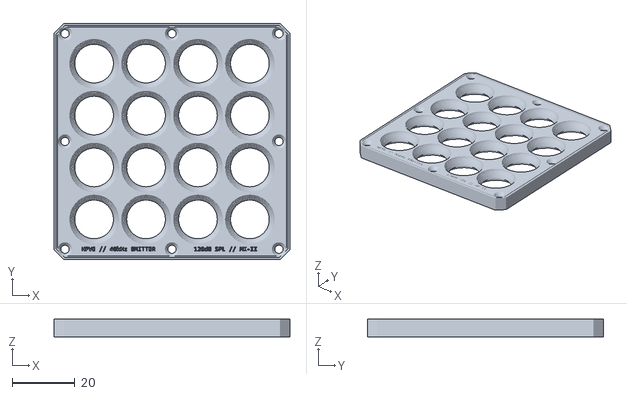
[picture p108: CAD file, 2026-11-05]
hardware/cad/HPVE_Acoustic_Horn_Bezel.stl
75.0 x 75.0 x 5.60
