triunex/HPVE-Fallen/hardware/cad/print_shop_stls/01_Tile_Frame_Q0_FrontLeft_x1.stl

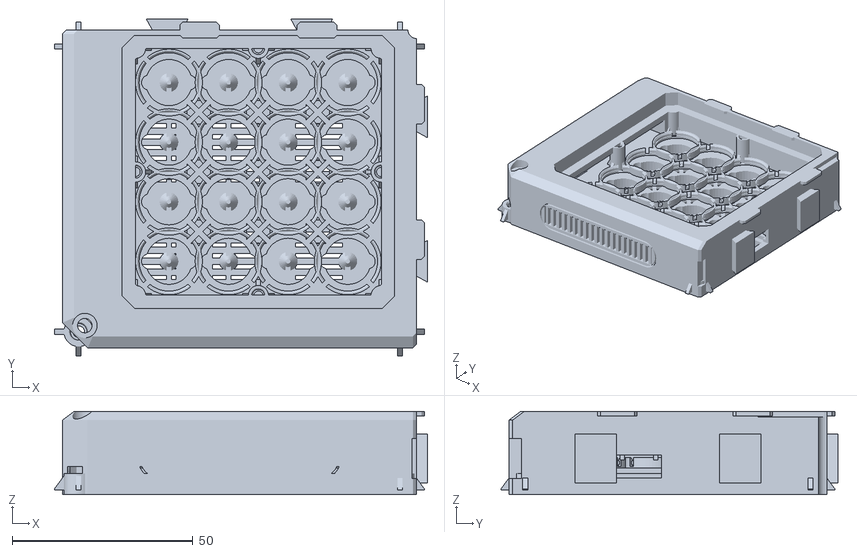
[picture p109: CAD file, 2026-11-10]
hardware/cad/print_shop_stls/01_Tile_Frame_Q0_FrontLeft_x1.stl
103.3 x 93.3 x 23.0
