triunex/HPVE-Fallen/hardware/cad/halo_arch/stl/HPVE_Halo_B4_Left_Pillar_3x_Knurled_Dials_Set.stl

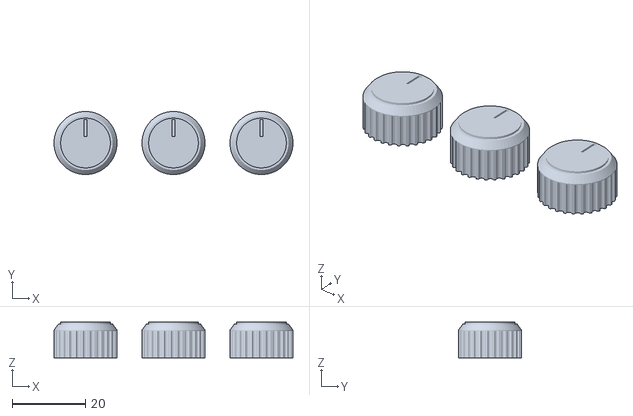
[picture p110: CAD file, 2026-11-10]
hardware/cad/halo_arch/stl/HPVE_Halo_B4_Left_Pillar_3x_Knurled_Dials_Set.stl
65.2 x 17.2 x 9.70
