triunex/HPVE-Fallen/hardware/cad/print_shop_stls/13_Optional_Cross_Seam_Shear_Clip_x1.stl

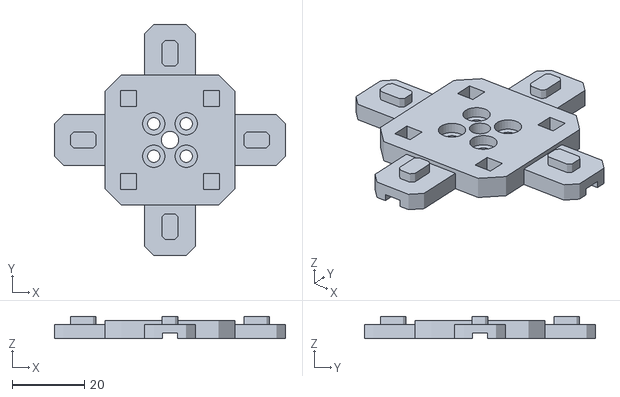
[picture p111: CAD file, 2026-11-10]
hardware/cad/print_shop_stls/13_Optional_Cross_Seam_Shear_Clip_x1.stl
64.0 x 64.0 x 6.20
