triunex/HPVE-Fallen/hardware/cad/halo_arch/stl/HPVE_Halo_A1_Bridge_Body.stl

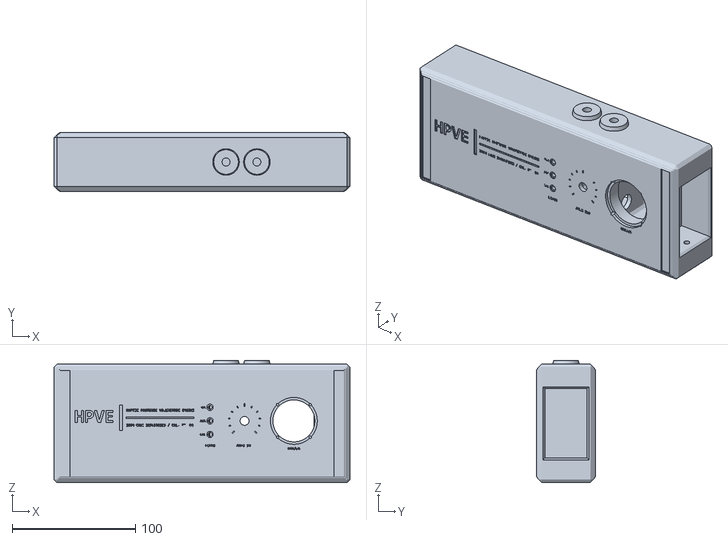
[picture p112: CAD file, 2026-11-10]
hardware/cad/halo_arch/stl/HPVE_Halo_A1_Bridge_Body.stl
240.0 x 48.0 x 99.0
