triunex/HPVE-Fallen/hardware/cad/HPVE_Halo_Arch_Clamp.stl

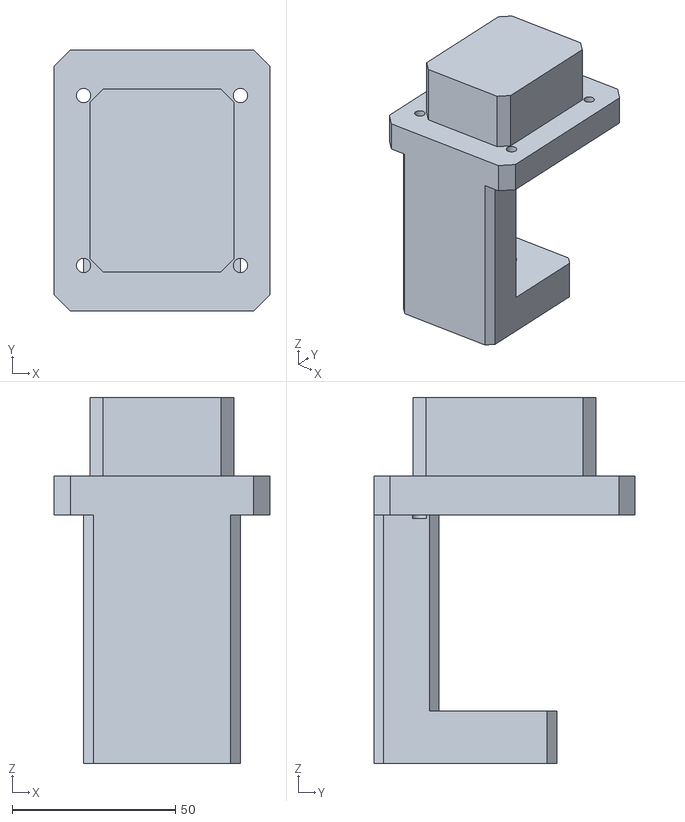
[picture p113: CAD file, 2026-11-05]
hardware/cad/HPVE_Halo_Arch_Clamp.stl
66.0 x 80.0 x 112.0
