triunex/HPVE-Fallen/hardware/cad/halo_arch/stl/HPVE_Halo_C2_Right_Arch_Knee.stl

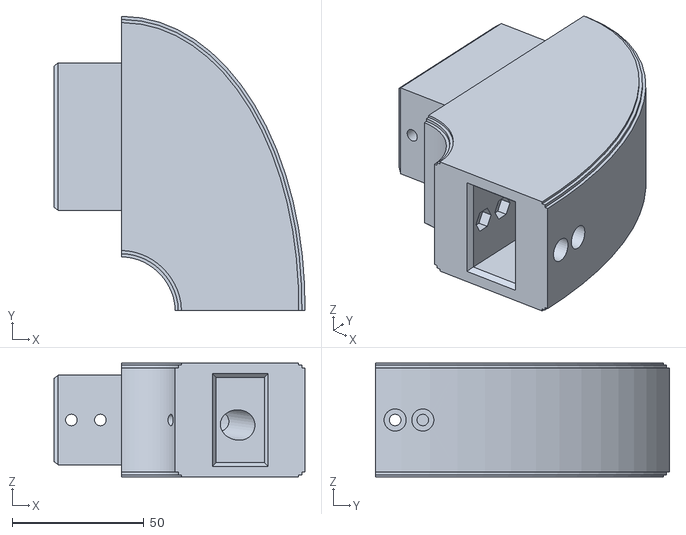
[picture p114: CAD file, 2026-11-10]
hardware/cad/halo_arch/stl/HPVE_Halo_C2_Right_Arch_Knee.stl
95.2 x 111.6 x 43.2
