triunex/HPVE-Fallen/hardware/cad/HPVE_Central_Dock_Sensor.stl

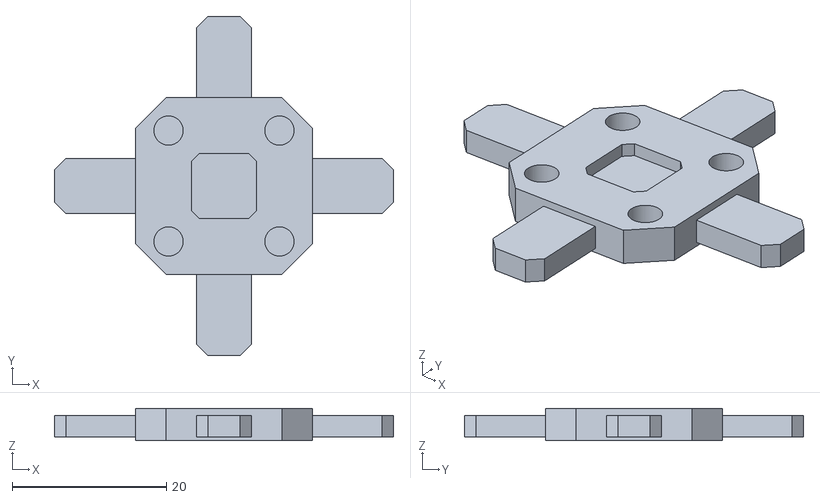
[picture p115: CAD file, 2026-11-05]
hardware/cad/HPVE_Central_Dock_Sensor.stl
44.0 x 44.0 x 4.20
