triunex/HPVE-Fallen/hardware/cad/print_shop_stls/12_Knurled_Knobs_SwivelPads_Target_Kit_x1.stl

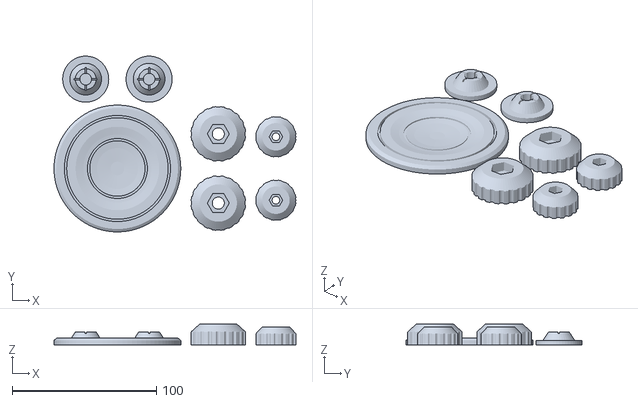
[picture p116: CAD file, 2026-11-10]
hardware/cad/print_shop_stls/12_Knurled_Knobs_SwivelPads_Target_Kit_x1.stl
167.9 x 122.0 x 14.5
