triunex/HPVE-Fallen/hardware/cad/halo_arch/stl/HPVE_Halo_E5_Right_C_Clamp_Orange_Wedge.stl

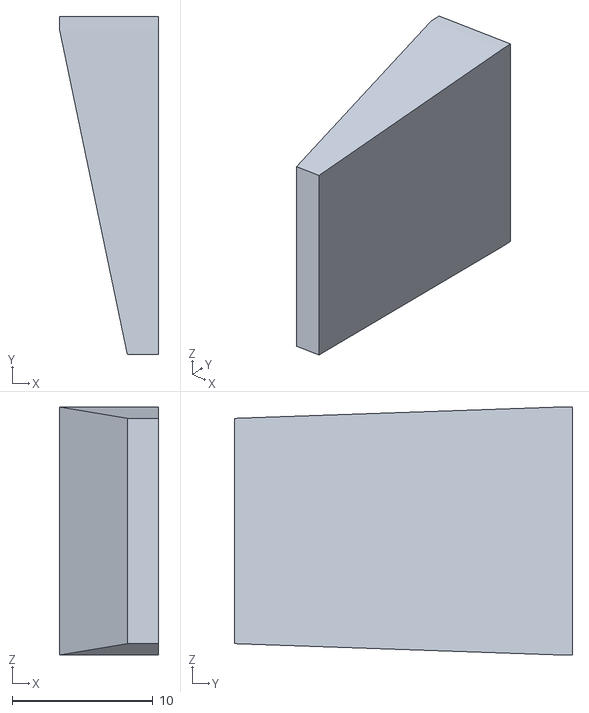
[picture p117: CAD file, 2026-11-10]
hardware/cad/halo_arch/stl/HPVE_Halo_E5_Right_C_Clamp_Orange_Wedge.stl
7.00 x 24.0 x 17.6
