triunex/HPVE-Fallen/hardware/cad/halo_arch/stl/HPVE_Halo_G2_Pillar_Inner_Angled_Hose_Glands_Pair.stl

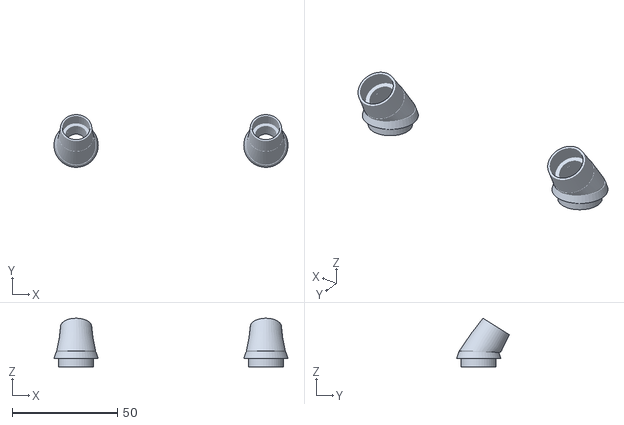
[picture p118: CAD file, 2026-11-10]
hardware/cad/halo_arch/stl/HPVE_Halo_G2_Pillar_Inner_Angled_Hose_Glands_Pair.stl
111.0 x 25.0 x 23.1
