triunex/HPVE-Fallen/hardware/cad/print_shop_stls/07_Central_VL53L5CX_ToF_Laser_Pod_x1.stl

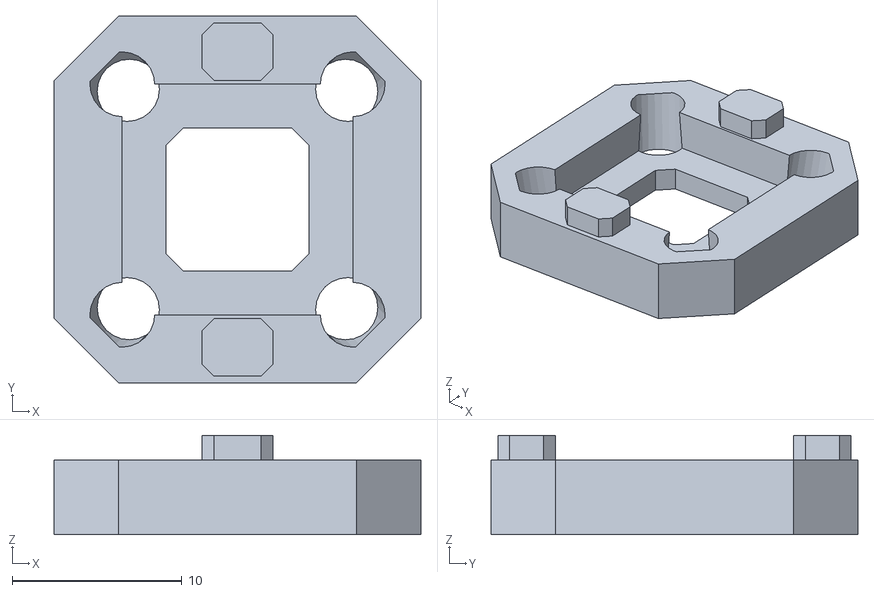
[picture p119: CAD file, 2026-11-10]
hardware/cad/print_shop_stls/07_Central_VL53L5CX_ToF_Laser_Pod_x1.stl
21.6 x 21.6 x 5.85
