triunex/HPVE-Fallen/hardware/cad/halo_arch/stl/HPVE_Halo_F2_4S2P_18650_Battery_Cradle_Tray.stl

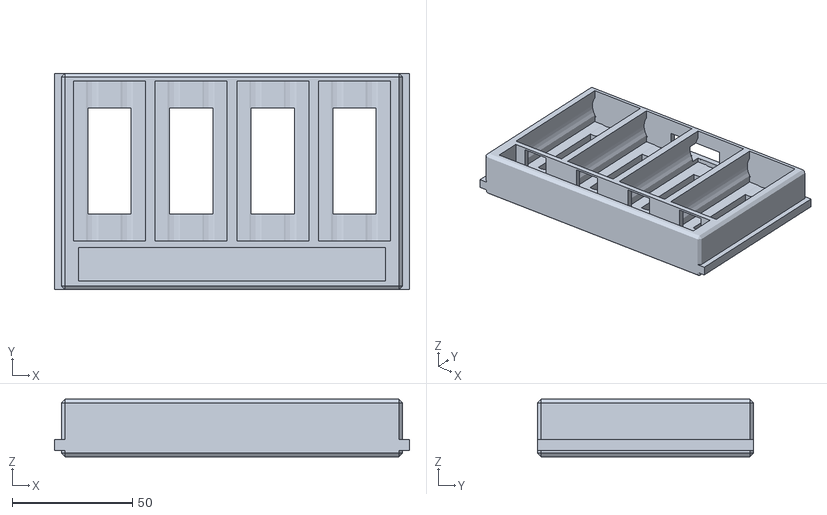
[picture p120: CAD file, 2026-11-10]
hardware/cad/halo_arch/stl/HPVE_Halo_F2_4S2P_18650_Battery_Cradle_Tray.stl
147.8 x 90.0 x 24.0
