triunex/HPVE-Fallen/hardware/cad/print_shop_stls/08_Halo_Arch_C_Clamp_Pedestal_x2.stl

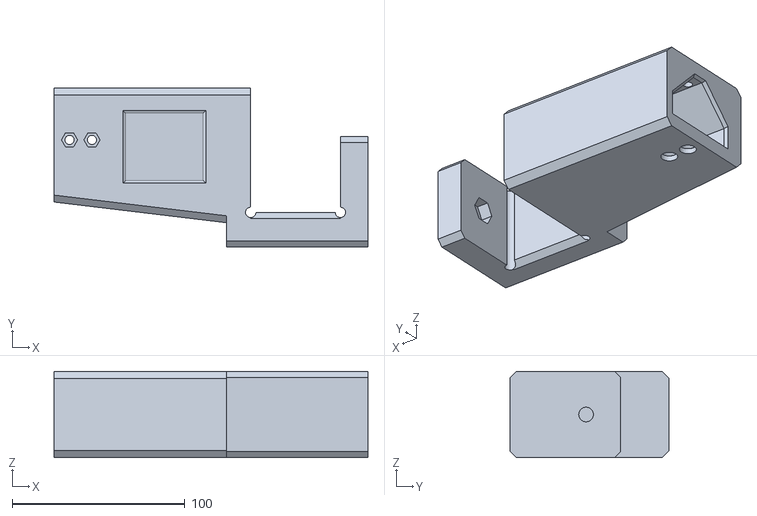
[picture p121: CAD file, 2026-11-10]
hardware/cad/print_shop_stls/08_Halo_Arch_C_Clamp_Pedestal_x2.stl
182.0 x 92.0 x 50.0
