triunex/HPVE-Fallen/hardware/cad/halo_arch/stl/HPVE_Halo_F4_Rear_Louvered_Service_Door.stl

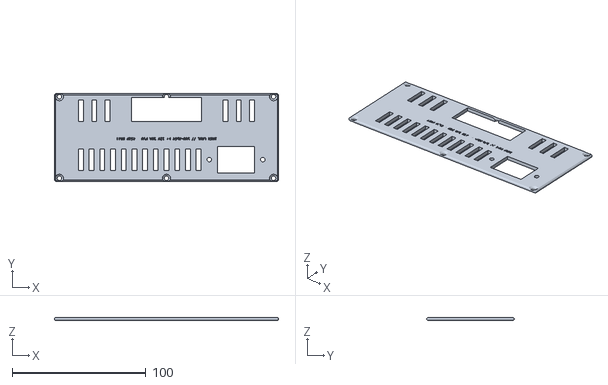
[picture p122: CAD file, 2026-11-10]
hardware/cad/halo_arch/stl/HPVE_Halo_F4_Rear_Louvered_Service_Door.stl
167.4 x 65.4 x 2.60
