triunex/HPVE-Fallen/hardware/cad/halo_arch/stl/HPVE_Halo_B1_Left_Pillar_Body.stl

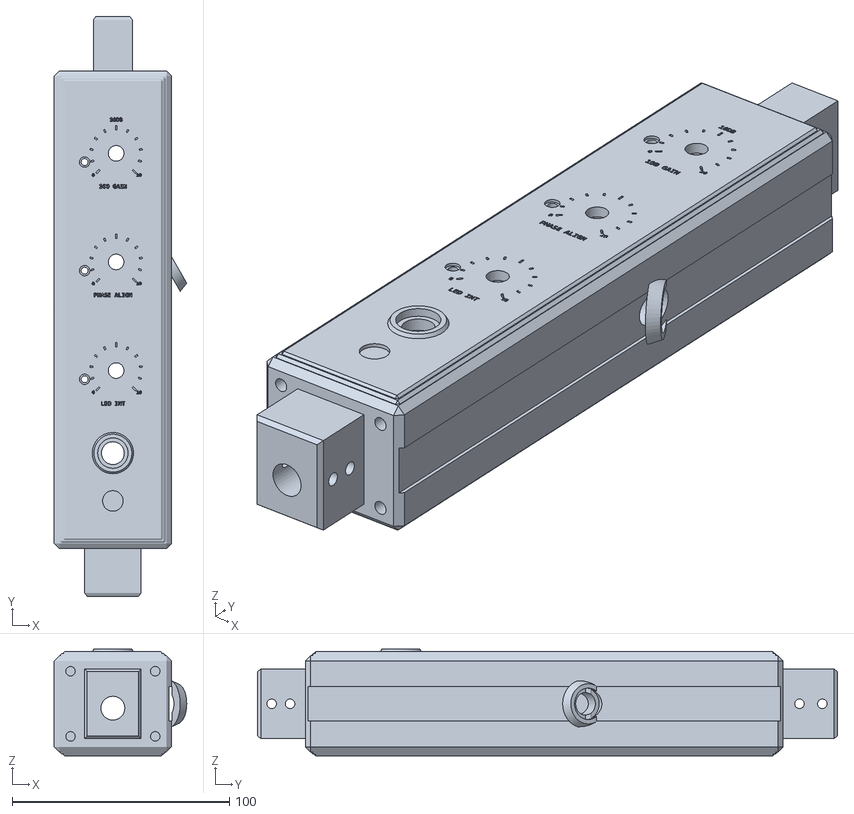
[picture p123: CAD file, 2026-11-10]
hardware/cad/halo_arch/stl/HPVE_Halo_B1_Left_Pillar_Body.stl
61.0 x 267.0 x 49.2
