triunex/HPVE-Fallen/hardware/cad/halo_arch/stl/HPVE_Halo_G4_UnderDesk_Dual_Conduit_Retainer_Clips_Set.stl

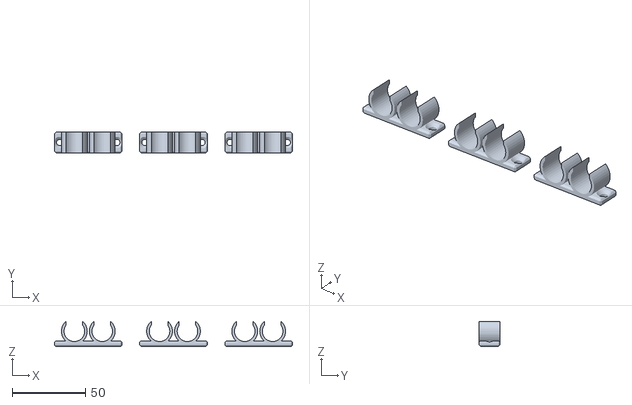
[picture p124: CAD file, 2026-11-10]
hardware/cad/halo_arch/stl/HPVE_Halo_G4_UnderDesk_Dual_Conduit_Retainer_Clips_Set.stl
162.0 x 14.0 x 17.3
