triunex/HPVE-Fallen/hardware/cad/halo_arch/stl/HPVE_Halo_F3_Under_Desk_Dovetail_Mount_Bracket.stl

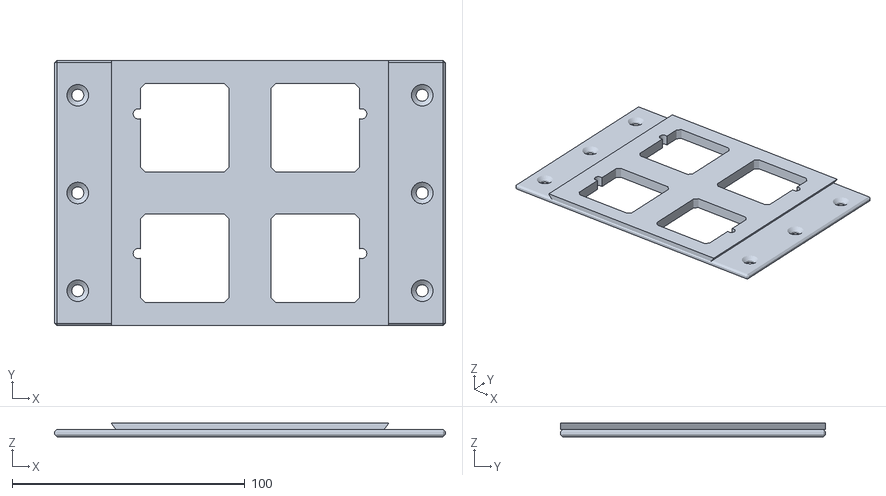
[picture p125: CAD file, 2026-11-10]
hardware/cad/halo_arch/stl/HPVE_Halo_F3_Under_Desk_Dovetail_Mount_Bracket.stl
168.0 x 114.0 x 5.85
