triunex/HPVE-Fallen/hardware/cad/halo_arch/stl/HPVE_Halo_E1_Right_C_Clamp_Body.stl

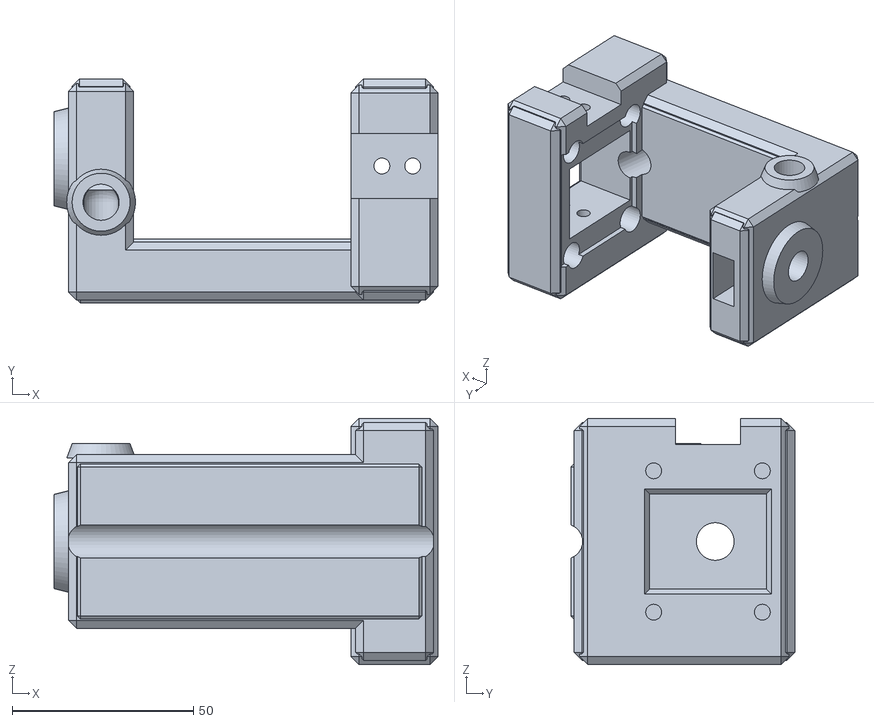
[picture p126: CAD file, 2026-11-10]
hardware/cad/halo_arch/stl/HPVE_Halo_E1_Right_C_Clamp_Body.stl
106.0 x 61.8 x 68.0
