triunex/HPVE-Fallen/hardware/cad/halo_arch/stl/HPVE_Halo_A4_Service_Cover.stl

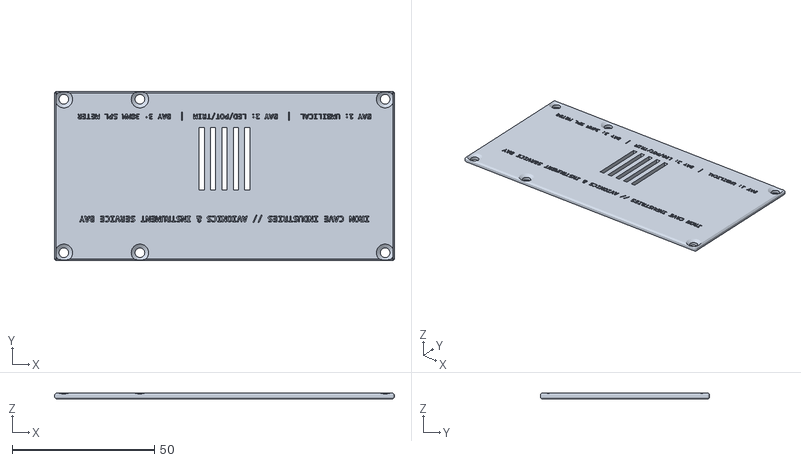
[picture p127: CAD file, 2026-11-10]
hardware/cad/halo_arch/stl/HPVE_Halo_A4_Service_Cover.stl
119.6 x 59.6 x 2.20
