triunex/HPVE-Fallen/hardware/cad/halo_arch/stl/HPVE_Halo_B3_Pillar_Service_Cover.stl

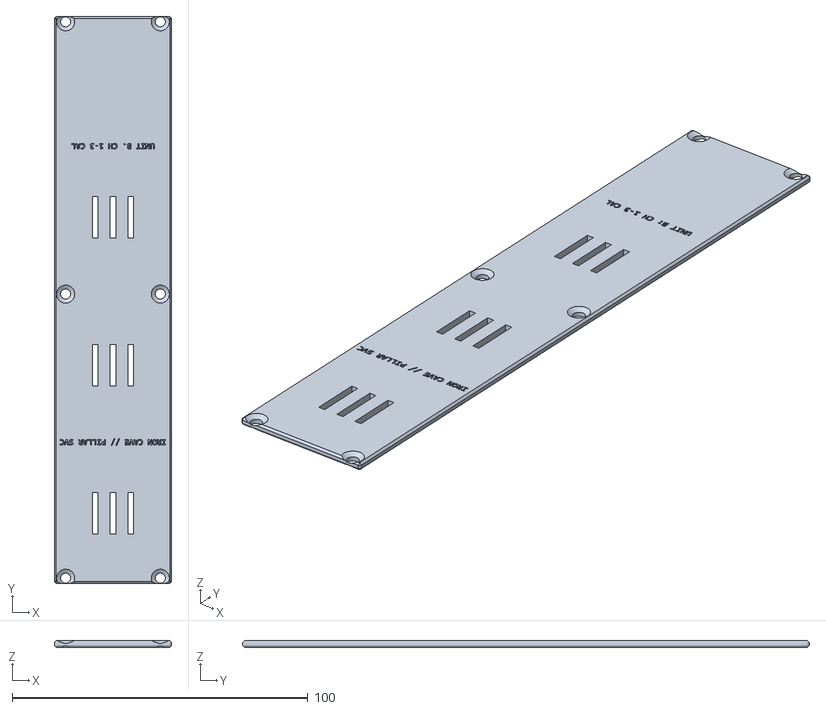
[picture p128: CAD file, 2026-11-10]
hardware/cad/halo_arch/stl/HPVE_Halo_B3_Pillar_Service_Cover.stl
39.6 x 191.6 x 2.20
