triunex/HPVE-Fallen/hardware/cad/halo_arch/stl/HPVE_Halo_A5_Gauge_Retaining_Ring.stl

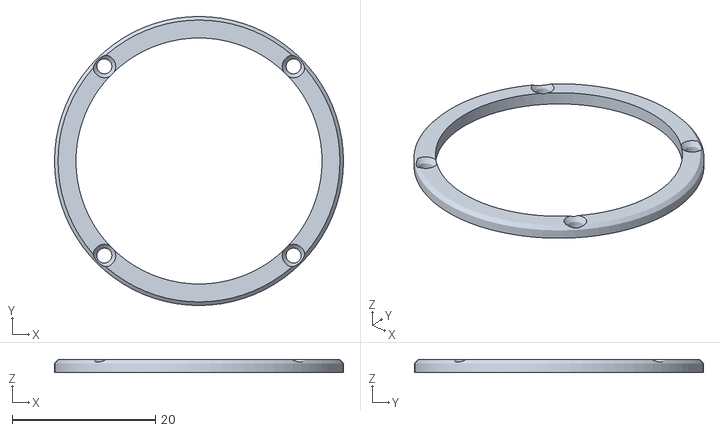
[picture p129: CAD file, 2026-11-10]
hardware/cad/halo_arch/stl/HPVE_Halo_A5_Gauge_Retaining_Ring.stl
40.4 x 40.4 x 1.80
