triunex/HPVE-Fallen/hardware/cad/halo_arch/stl/HPVE_Halo_C5_Right_Pillar_And_Knee_Orange_Trim_Set.stl

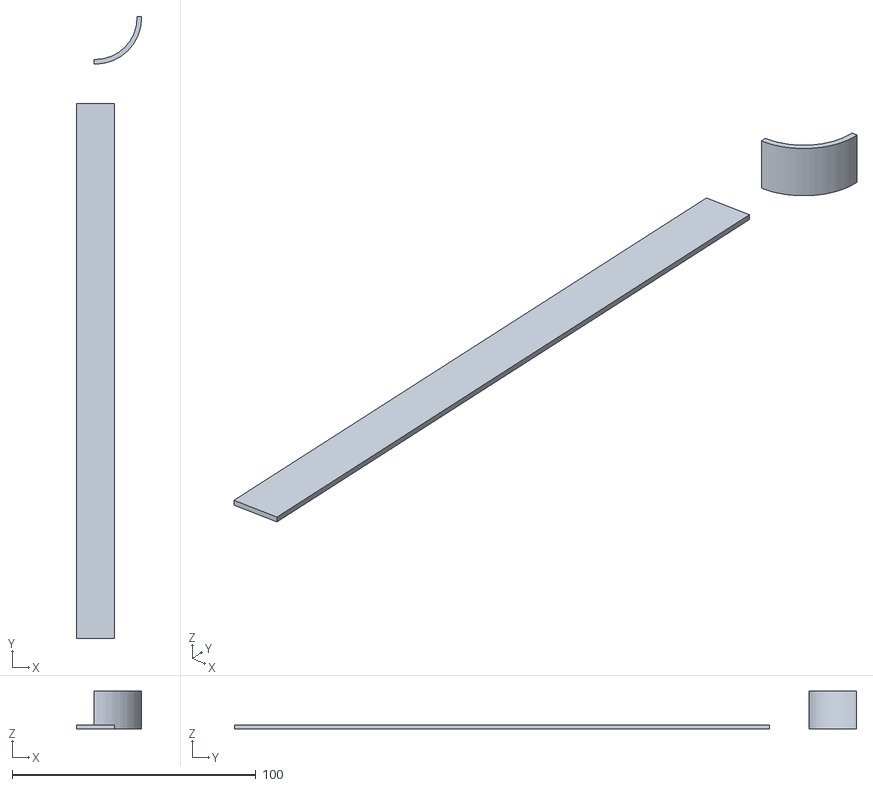
[picture p130: CAD file, 2026-11-10]
hardware/cad/halo_arch/stl/HPVE_Halo_C5_Right_Pillar_And_Knee_Orange_Trim_Set.stl
26.7 x 255.4 x 15.6
