triunex/HPVE-Fallen/hardware/cad/halo_arch/stl/HPVE_Halo_A7_Bridge_Orange_Seam_Collars_Pair.stl

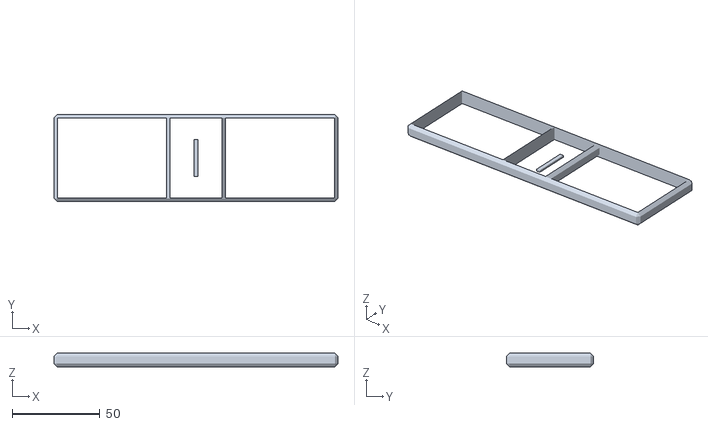
[picture p131: CAD file, 2026-11-10]
hardware/cad/halo_arch/stl/HPVE_Halo_A7_Bridge_Orange_Seam_Collars_Pair.stl
161.4 x 49.4 x 7.80
