triunex/HPVE-Fallen/hardware/cad/halo_arch/stl/HPVE_Halo_D3_Swivel_Pressure_Plate.stl

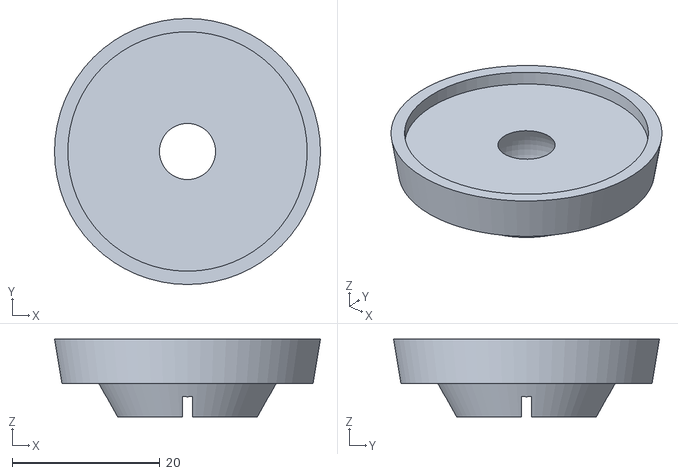
[picture p132: CAD file, 2026-11-10]
hardware/cad/halo_arch/stl/HPVE_Halo_D3_Swivel_Pressure_Plate.stl
36.0 x 36.0 x 10.5
