triunex/HPVE-Fallen/hardware/cad/halo_arch/stl/HPVE_Halo_F1_PSU_And_Battery_Box_Chassis.stl

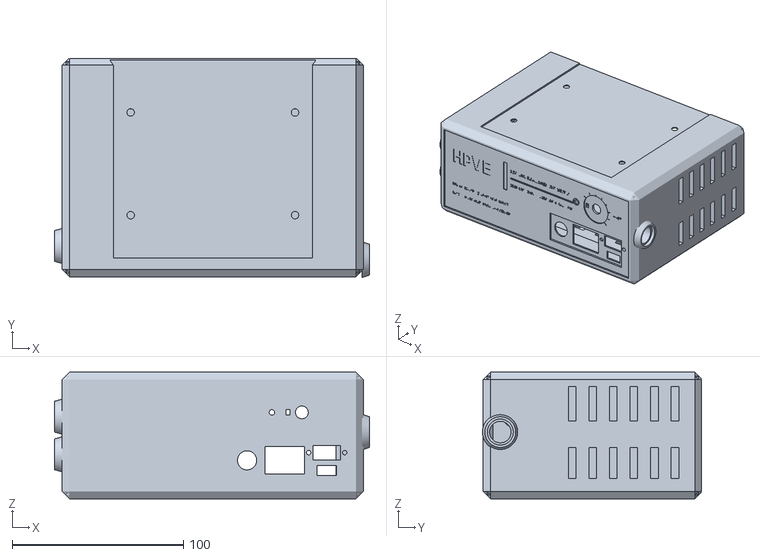
[picture p133: CAD file, 2026-11-10]
hardware/cad/halo_arch/stl/HPVE_Halo_F1_PSU_And_Battery_Box_Chassis.stl
184.0 x 128.1 x 74.0
