triunex/HPVE-Fallen/hardware/cad/halo_arch/stl/HPVE_Halo_G3_Clamp_UnderDesk_90Deg_Hose_Elbows_Pair.stl

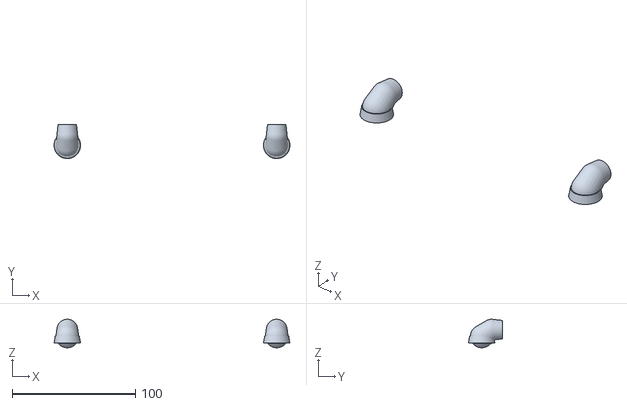
[picture p134: CAD file, 2026-11-10]
hardware/cad/halo_arch/stl/HPVE_Halo_G3_Clamp_UnderDesk_90Deg_Hose_Elbows_Pair.stl
191.6 x 27.8 x 23.2
