triunex/HPVE-Fallen/hardware/cad/halo_arch/stl/HPVE_Halo_A3_Gimbal_Block.stl

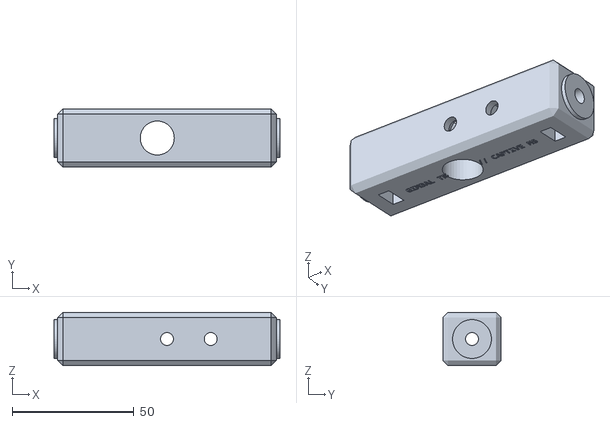
[picture p135: CAD file, 2026-11-10]
hardware/cad/halo_arch/stl/HPVE_Halo_A3_Gimbal_Block.stl
93.0 x 24.0 x 22.0
