triunex/HPVE-Fallen/hardware/cad/halo_arch/stl/HPVE_Halo_E4_Right_NonMarring_TPU_Gripper_Pads.stl

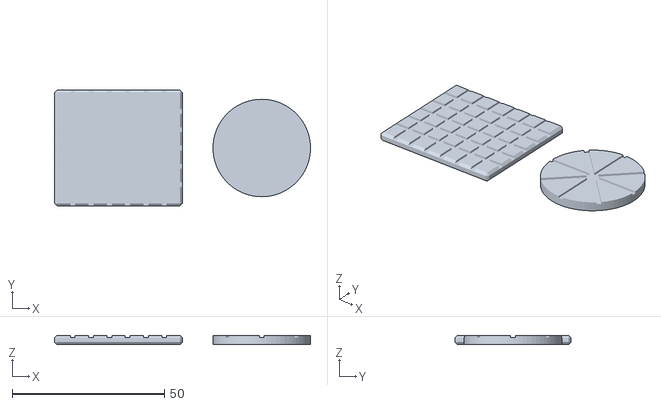
[picture p136: CAD file, 2026-11-10]
hardware/cad/halo_arch/stl/HPVE_Halo_E4_Right_NonMarring_TPU_Gripper_Pads.stl
84.0 x 38.0 x 3.00
