triunex/HPVE-Fallen/(list of files, cad)

Other CAD files:
hardware/cad/print_shop_stls/09_Halo_Arch_Left_Pillar_x1.stl
hardware/cad/print_shop_stls/05_Acoustic_Horn_Bezel_16Ch_x4.stl
hardware/cad/halo_arch/stl/HPVE_Halo_C1_Right_Pillar_Body.stl
hardware/cad/halo_arch/stl/HPVE_Halo_B5_Left_Pillar_And_Knee_Orange_Trim_Set.stl
hardware/cad/halo_arch/stl/HPVE_Halo_B2_Left_Arch_Knee.stl
hardware/cad/halo_arch/stl/HPVE_Halo_C4_Right_Pillar_3x_Knurled_Dials_Set.stl
hardware/cad/halo_arch/stl/HPVE_Halo_C3_Right_Pillar_Service_Cover.stl
hardware/cad/halo_arch/stl/HPVE_Halo_D5_Left_C_Clamp_Orange_Wedge.stl
hardware/cad/halo_arch/stl/HPVE_Halo_E3_Right_Swivel_Pressure_Plate.stl
hardware/cad/halo_arch/stl/HPVE_Halo_D1_Left_C_Clamp_Body.stl
hardware/cad/halo_arch/stl/HPVE_Halo_D4_NonMarring_TPU_Gripper_Pads.stl
hardware/cad/halo_arch/stl/HPVE_Halo_A6_Bridge_Knurled_Dials_And_Thumbscrews_Set.stl
hardware/cad/halo_arch/stl/HPVE_Halo_D2_5Lobe_Clamp_Knob_Screw.stl
hardware/cad/halo_arch/stl/HPVE_Halo_E2_Right_5Lobe_Clamp_Knob_Screw.stl
