triunex/HPVE-Fallen/hardware/cad/halo_arch/renders/a_print_bed_plate.png

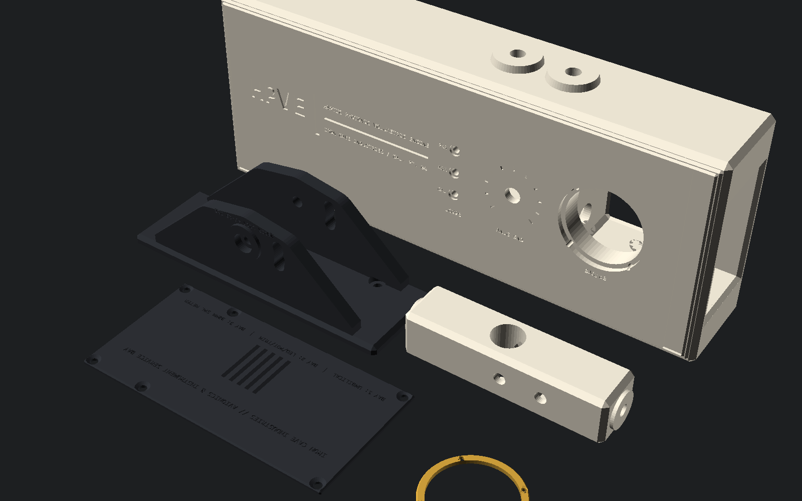
hardware/cad/halo_arch/renders/a_print_bed_plate.png
