triunex/HPVE-Fallen/hardware/cad/halo_arch/renders/bc_print_bed_plate.png

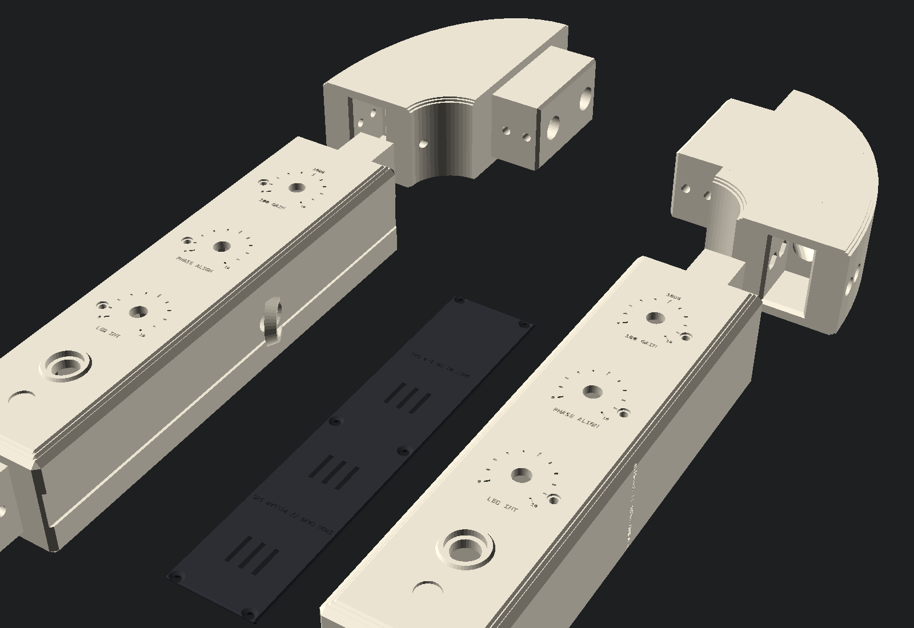
hardware/cad/halo_arch/renders/bc_print_bed_plate.png
