triunex/HPVE-Fallen/hardware/cad/halo_arch/renders/de_print_bed_plate.png

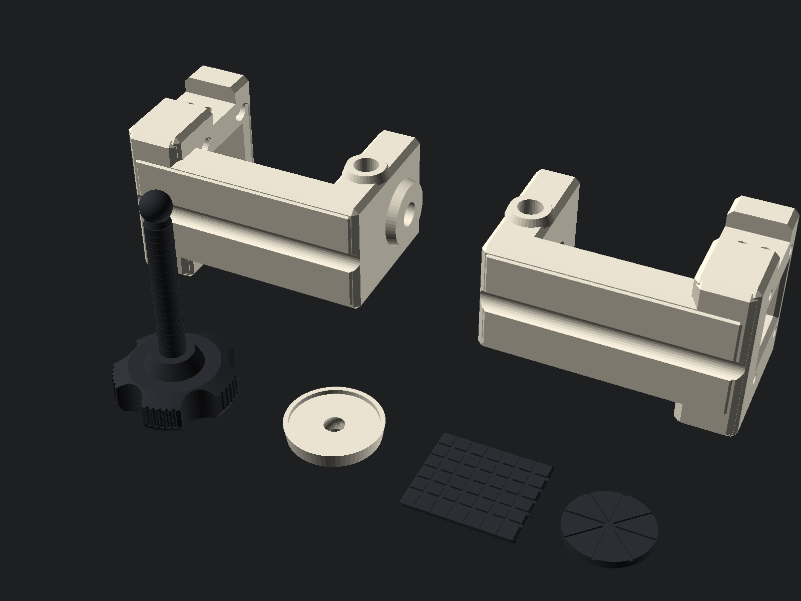
hardware/cad/halo_arch/renders/de_print_bed_plate.png
