triunex/HPVE-Fallen/hardware/cad/halo_arch/renders/g_print_bed_plate.png

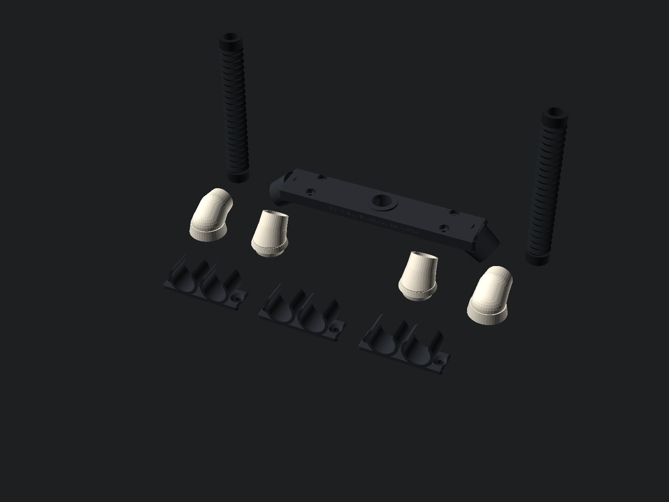
hardware/cad/halo_arch/renders/g_print_bed_plate.png
