triunex/HPVE-Fallen/hardware/cad/openscad_v3_view9_macro_horn_waveguide.png

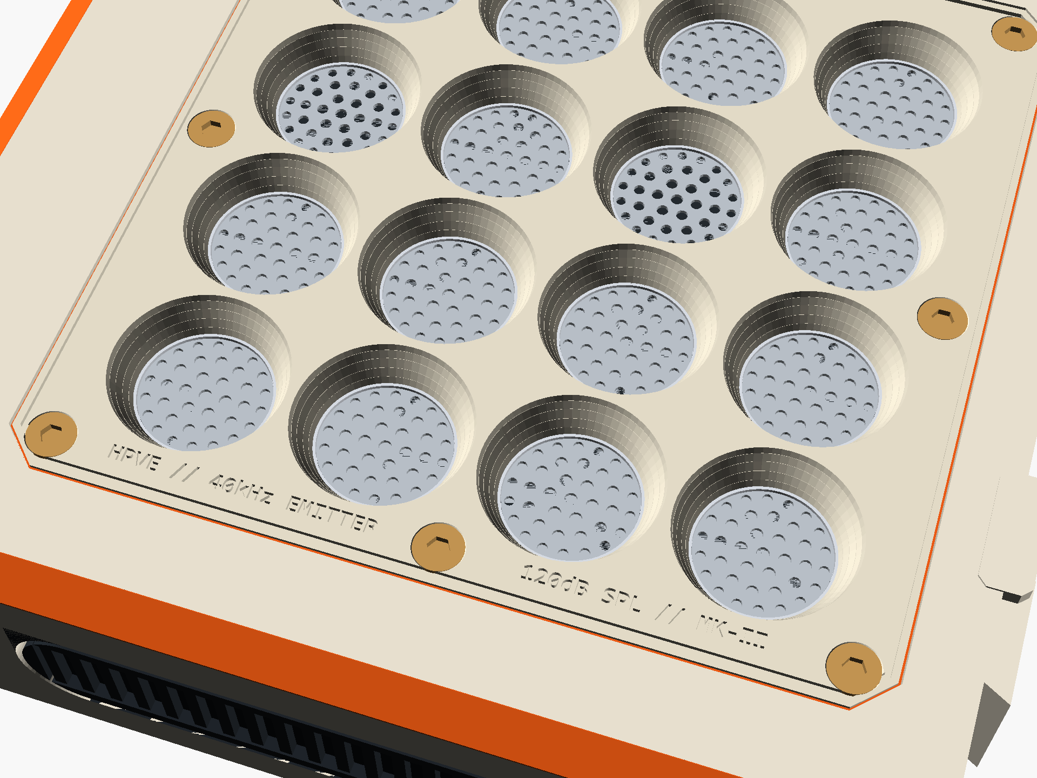
hardware/cad/openscad_v3_view9_macro_horn_waveguide.png
