triunex/HPVE-Fallen/hardware/cad/openscad_v5_view20_250mm_print_plates.png

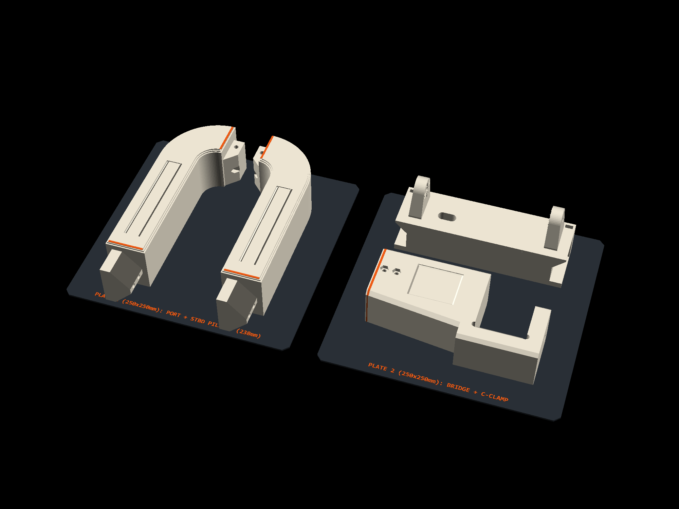
hardware/cad/openscad_v5_view20_250mm_print_plates.png
