triunex/HPVE-Fallen/firmware/cascade_engine_verification.png

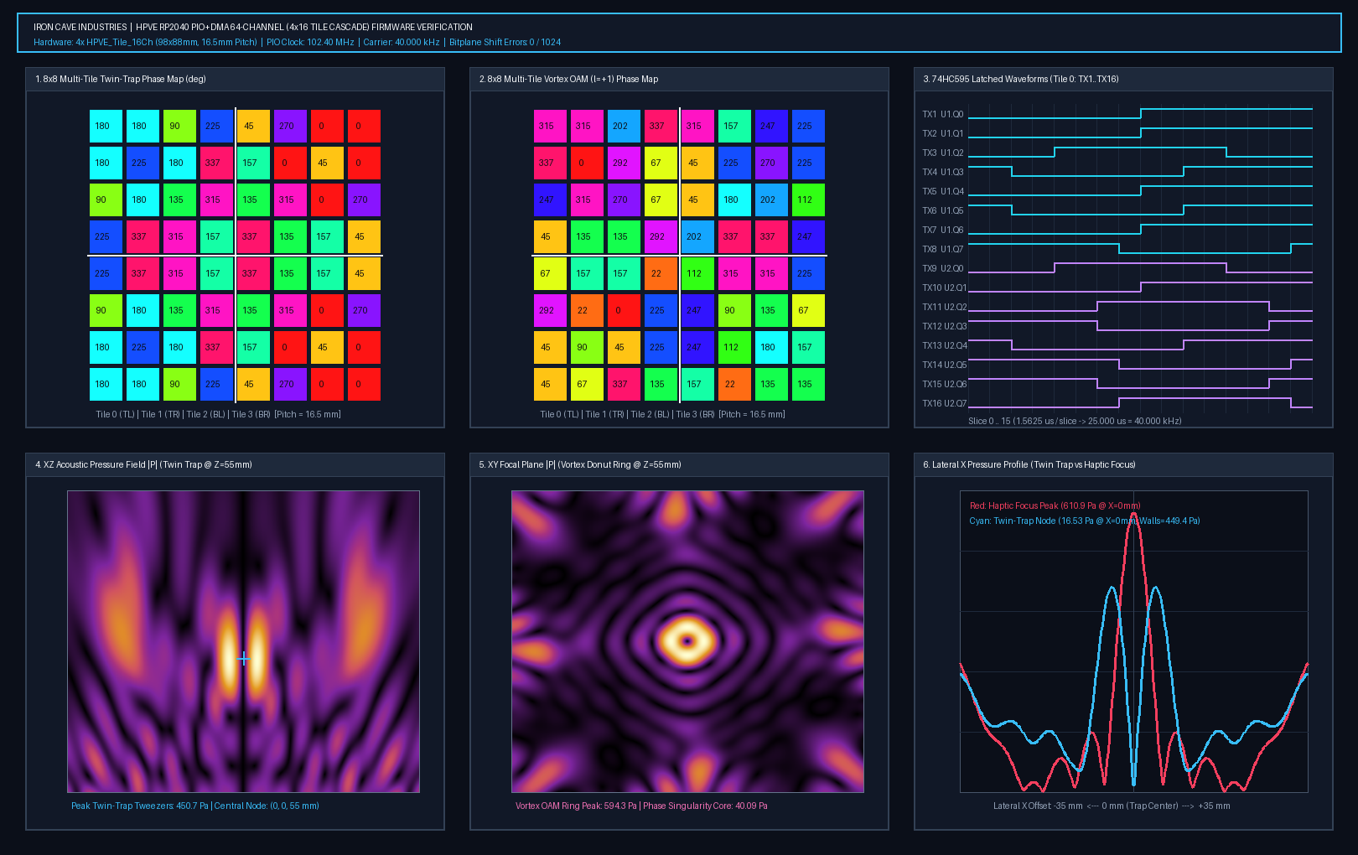
firmware/cascade_engine_verification.png
