triunex/HPVE-Fallen/firmware/spatial_tracker_verification.png

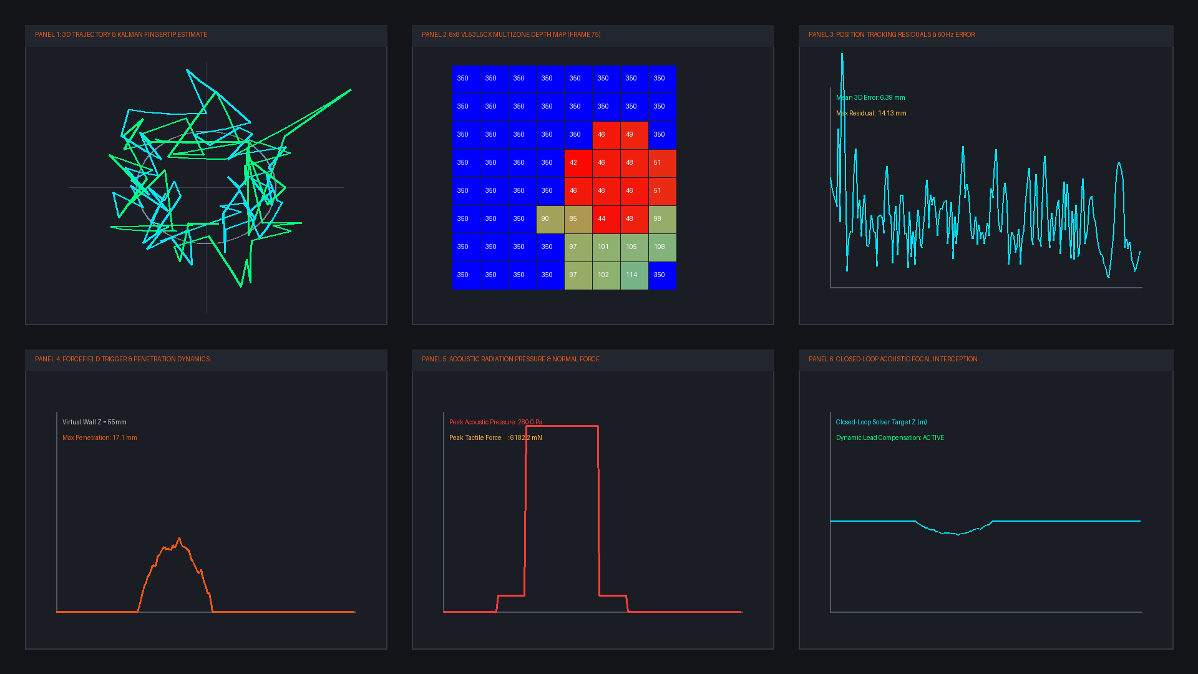
firmware/spatial_tracker_verification.png
