triunex/HPVE-Fallen/firmware/trajectory_engine_verification.png

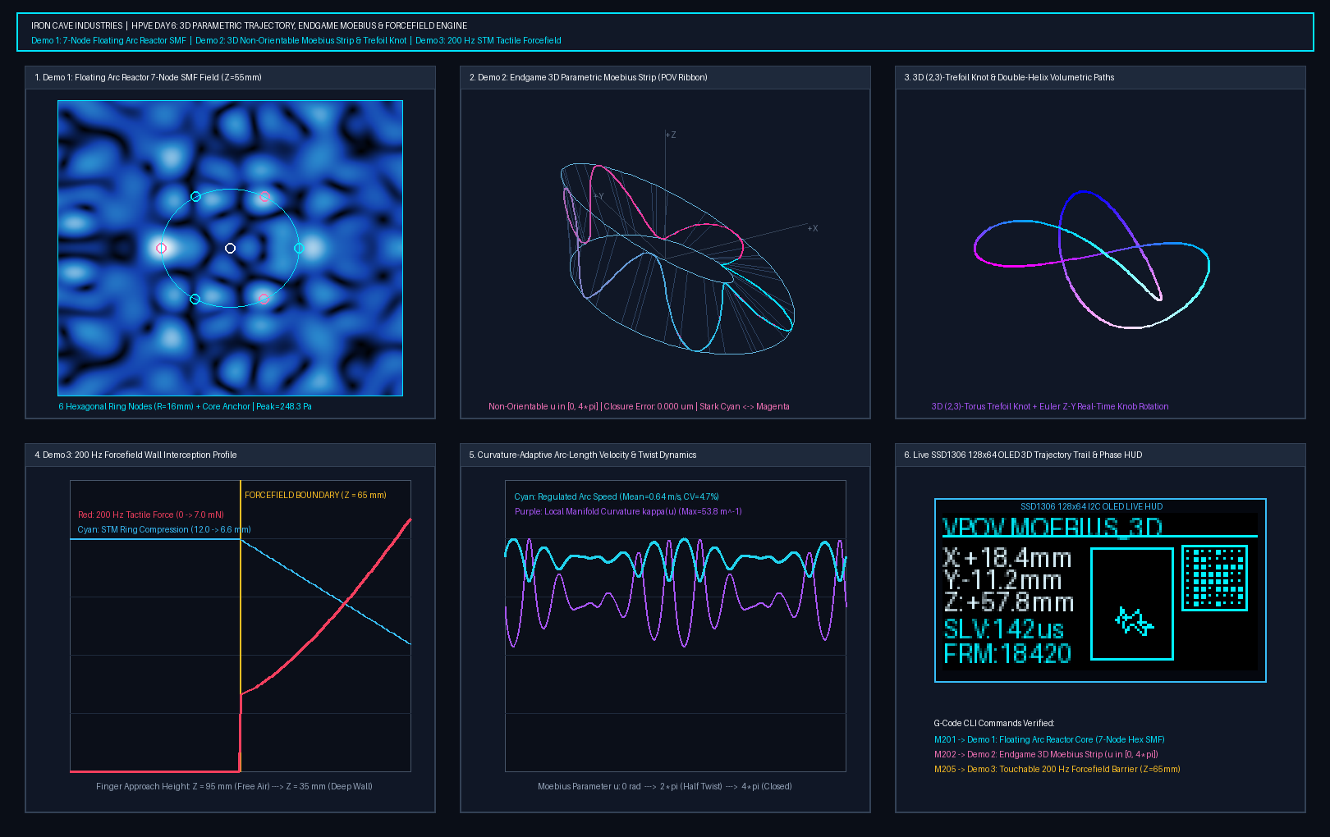
firmware/trajectory_engine_verification.png
