triunex/HPVE-Fallen/hardware/kicad/test_follow_pcb.png

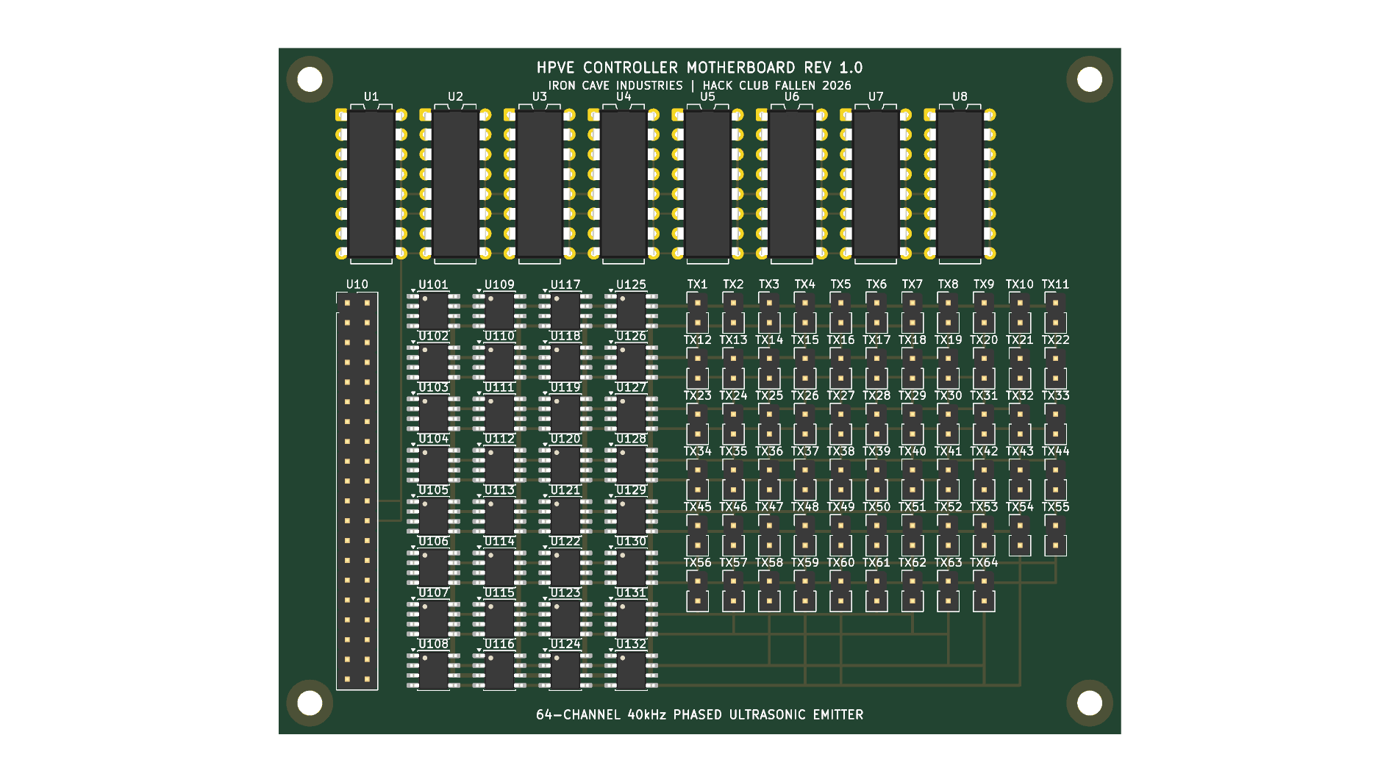
hardware/kicad/test_follow_pcb.png
