triunex/HPVE-Fallen/hardware/master_carrier/HPVE_Master_Carrier_Schematic.pdf

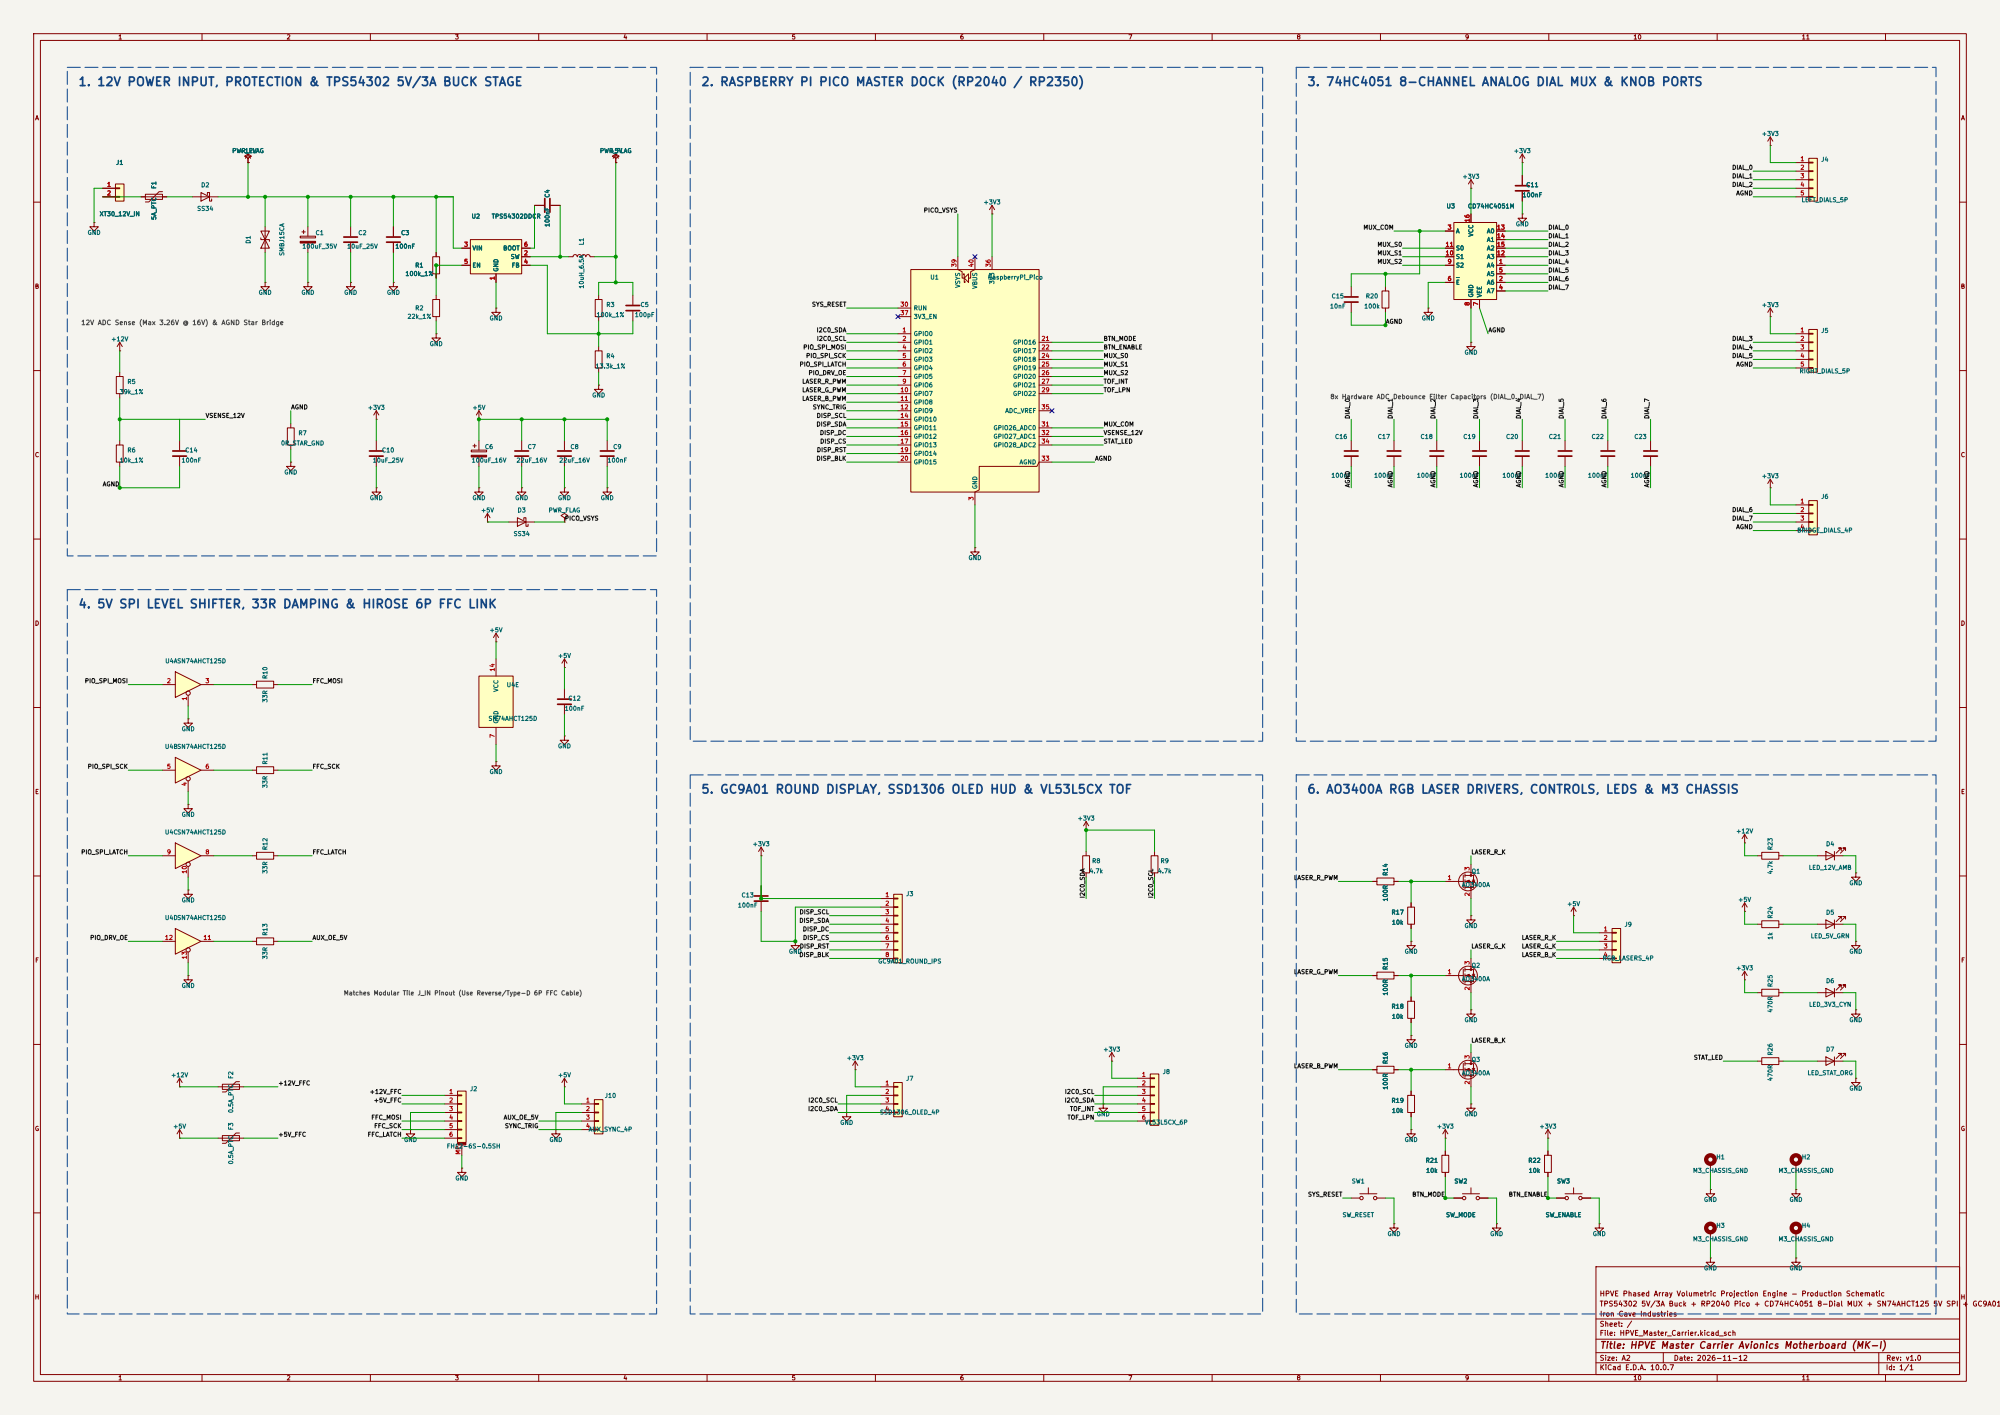
[picture p148: page 1]

2. RASPBERRY PI PICO MASTER DOCK (RP2040 / RP2350)

8x Hardware ADC Debounce Filter Capacitors (DIAL_0..DIAL_7) 12V ADC Sense (Max 3.26V @ 16V) & AGND Star Bridge

4. 5V SPI LEVEL SHIFTER, 33R DAMPING & HIROSE 6P FFC LINK

5. GC9A01 ROUND DISPLAY, SSD1306 OLED HUD & VL53L5CX TOF

6. AO3400A RGB LASER DRIVERS, CONTROLS, LEDS & M3 CHASSIS

Matches Modular Tile J_IN Pinout (Use Reverse/Type-D 6P FFC Cable)

HPVE Phased Array Volumetric Projection Engine - Production Schematic
Iron Cave Industries
Sheet: /
File: HPVE_Master_Carrier.kicad_sch
Title: HPVE Master Carrier Avionics Motherboard (MK-I)

Size: A2 | Rev: v1.0
KiCad E.D.A. 10.0.7 | Id: 1/1
