triunex/HPVE-Fallen/hardware/modular_tile/HPVE_Tile_16Ch_Schematic.pdf

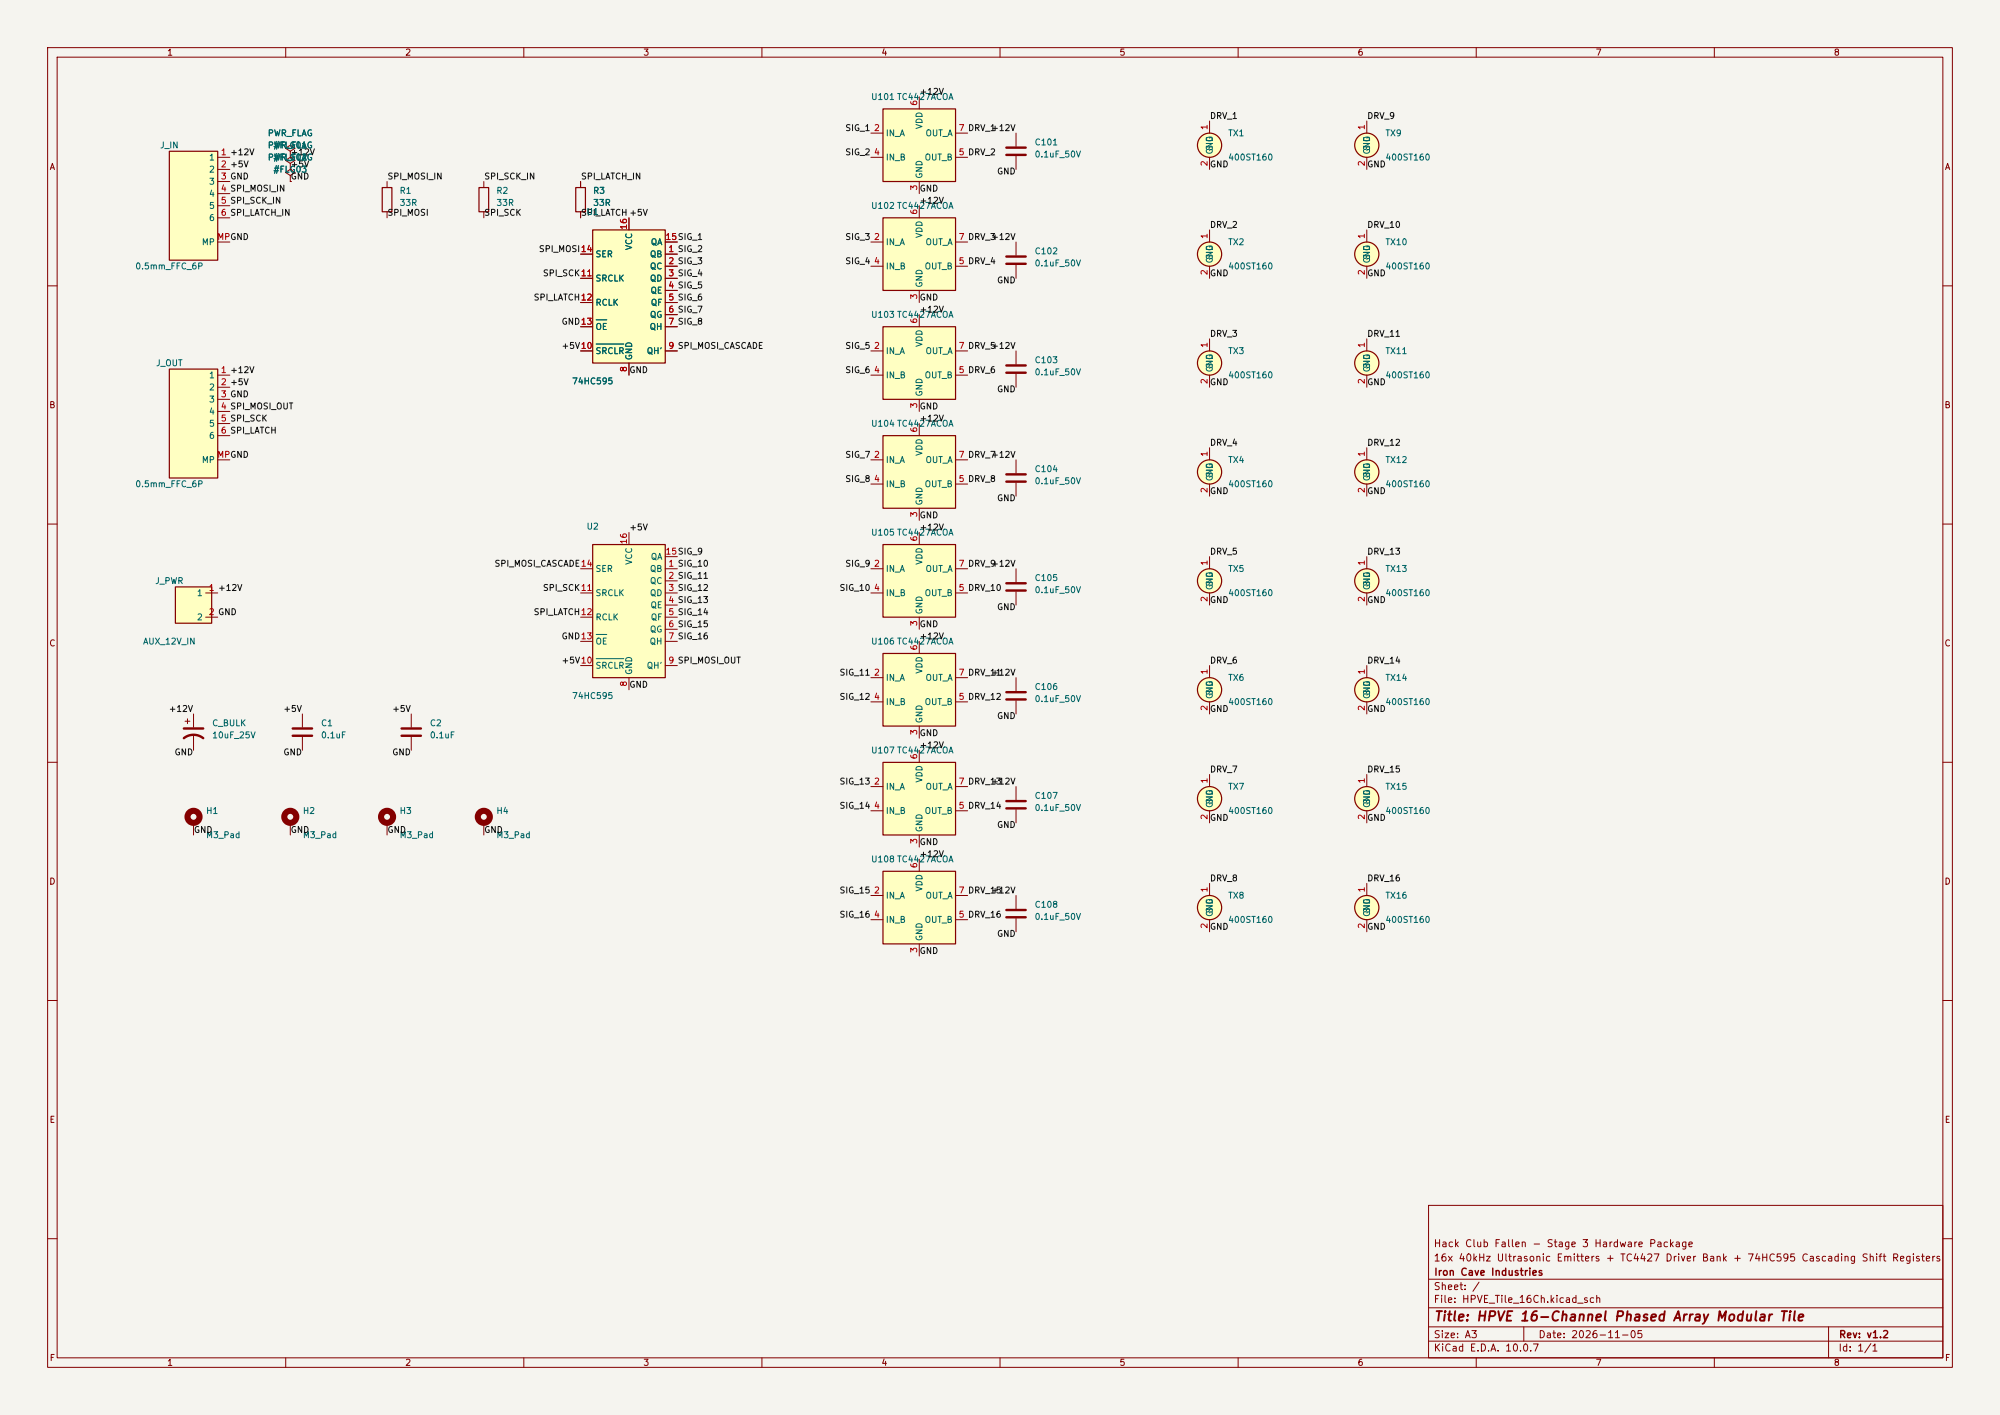
[picture p149: page 1]

1 GND
400ST160 SIG
Hack Club Fallen - Stage 3 Hardware Package SIG

16x 40kHz Ultrasonic Emitters + TC4427 Driver Bank + 74HC595 Cascading Shift Registers
Iron Cave Industries
Sheet: /
File: HPVE_Tile_16Ch.kicad_sch
Title: HPVE 16-Channel Phased Array Modular Tile

Size: A3 | Rev: v1.2 | F Date: 2026-11-05
KiCad E.D.A. 10.0.7 | Id: 1/1
