triunex/HPVE-Fallen/hardware/kicad/hpve_pcb_editor_view.pdf

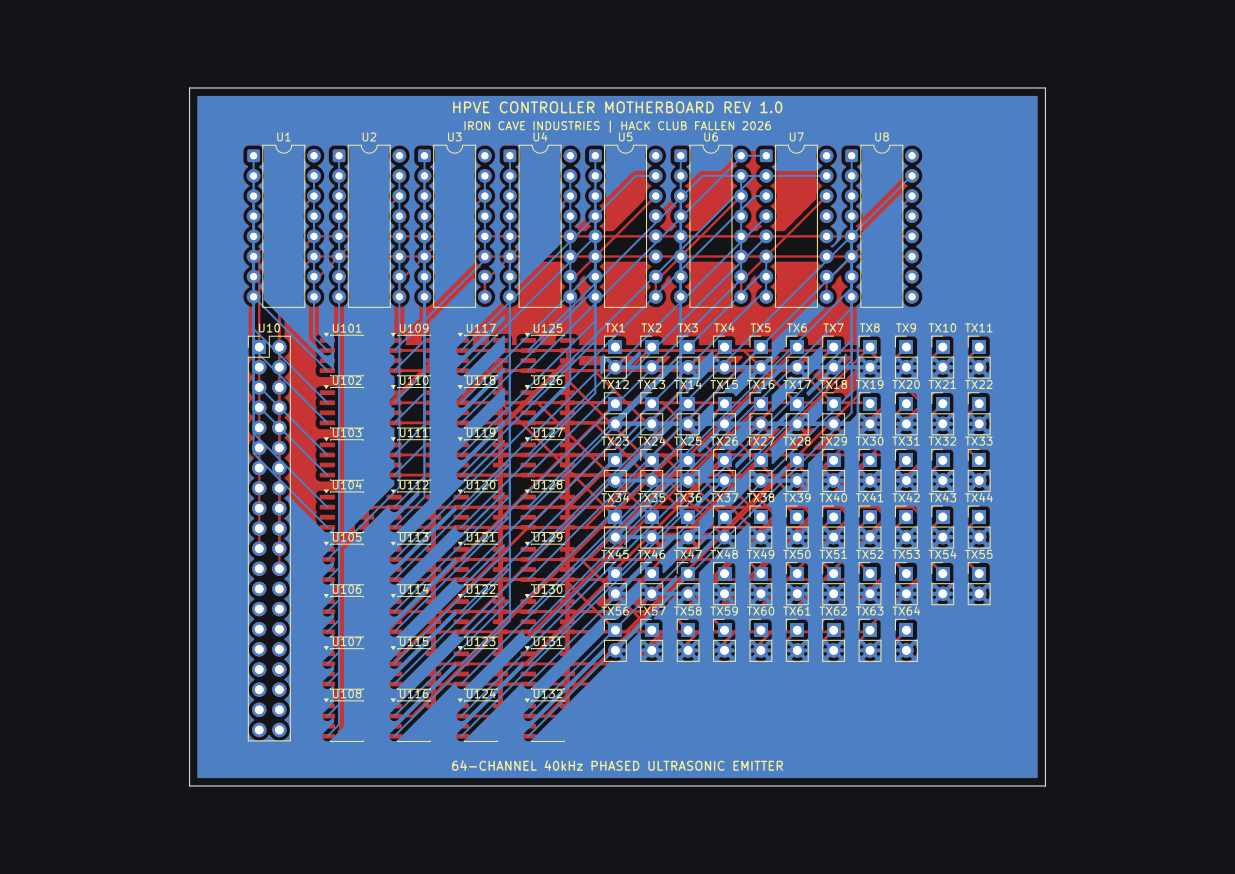
[picture p150: page 1]

HPVE CONTROLLER MOTHERBOARD REV 1.0
IRON CAVE INDUSTRIES | HACK CLUB FALLEN 2026

64-CHANNEL 40kHz PHASED ULTRASONIC EMITTER
