triunex/HPVE-Fallen/(list of files, drawings)

Other design files:
hardware/kicad/HPVE_Controller.dsn
hardware/master_carrier/HPVE_Master_Carrier.dsn
hardware/modular_tile/HPVE_Tile_16Ch.dsn
