triunex/HPVE-Fallen/hardware/master_carrier/HPVE_Master_Carrier.kicad_pcb

## KiCad design hardware/master_carrier/HPVE_Master_Carrier.kicad_pcb (2026-11-12)

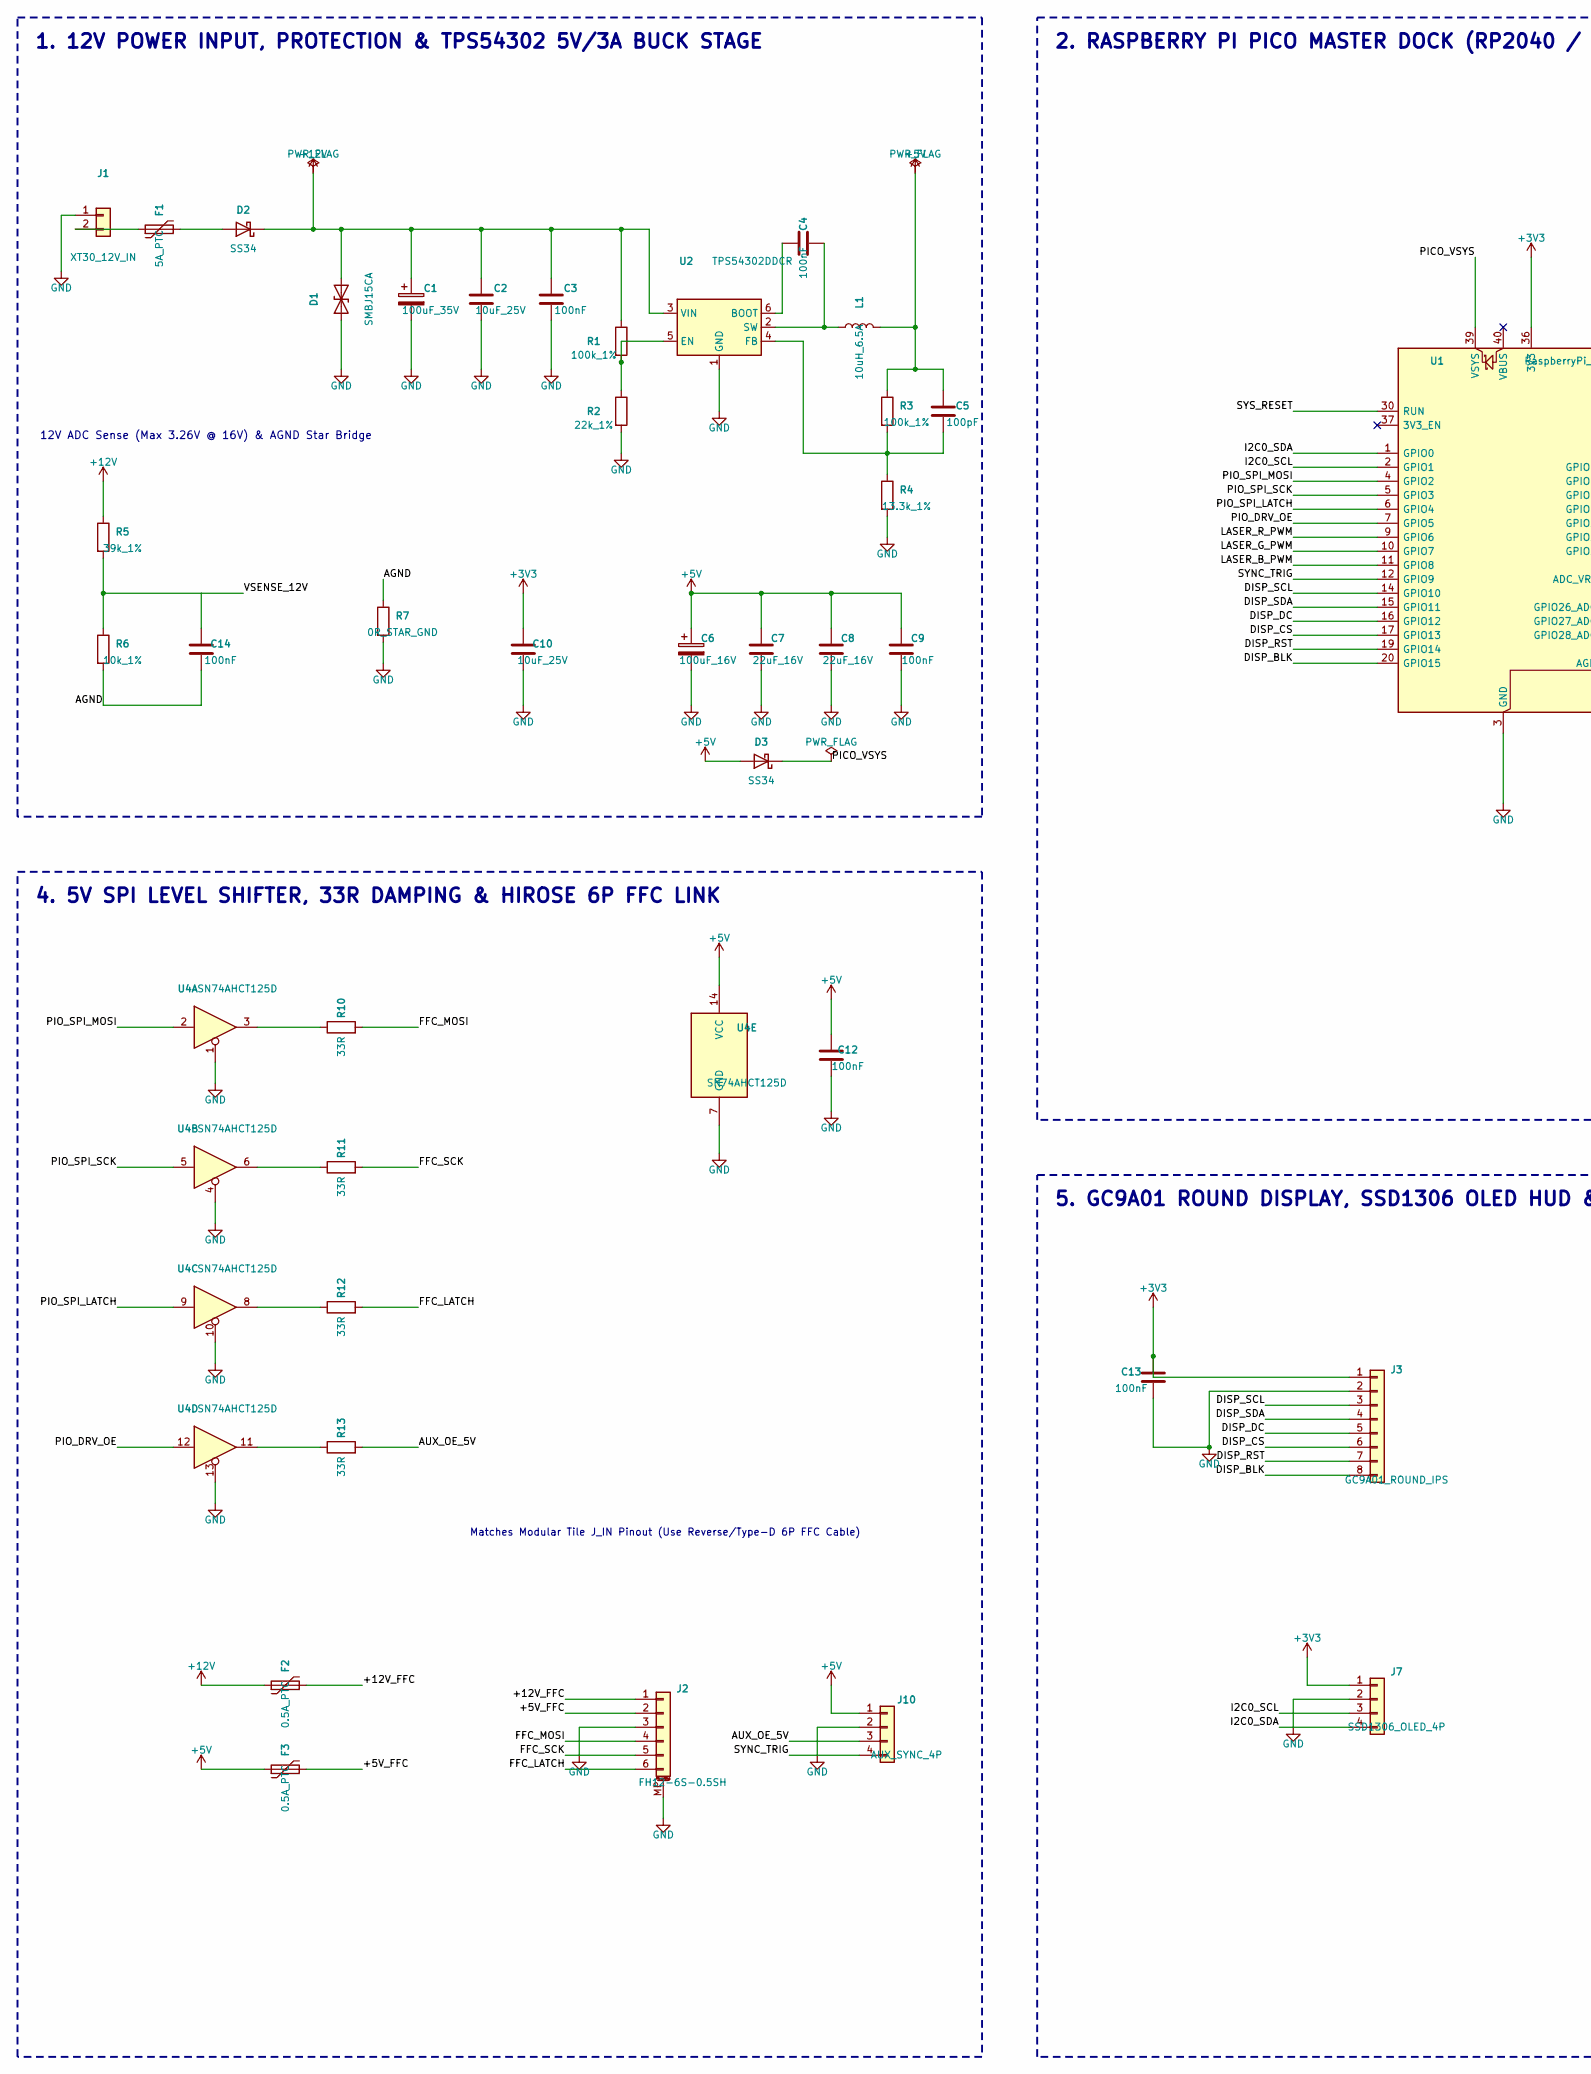
[picture p151: schematic HPVE_Master_Carrier.kicad_sch, HPVE Master Carrier Avionics Motherboard (MK-I), part in row 1, column 1]

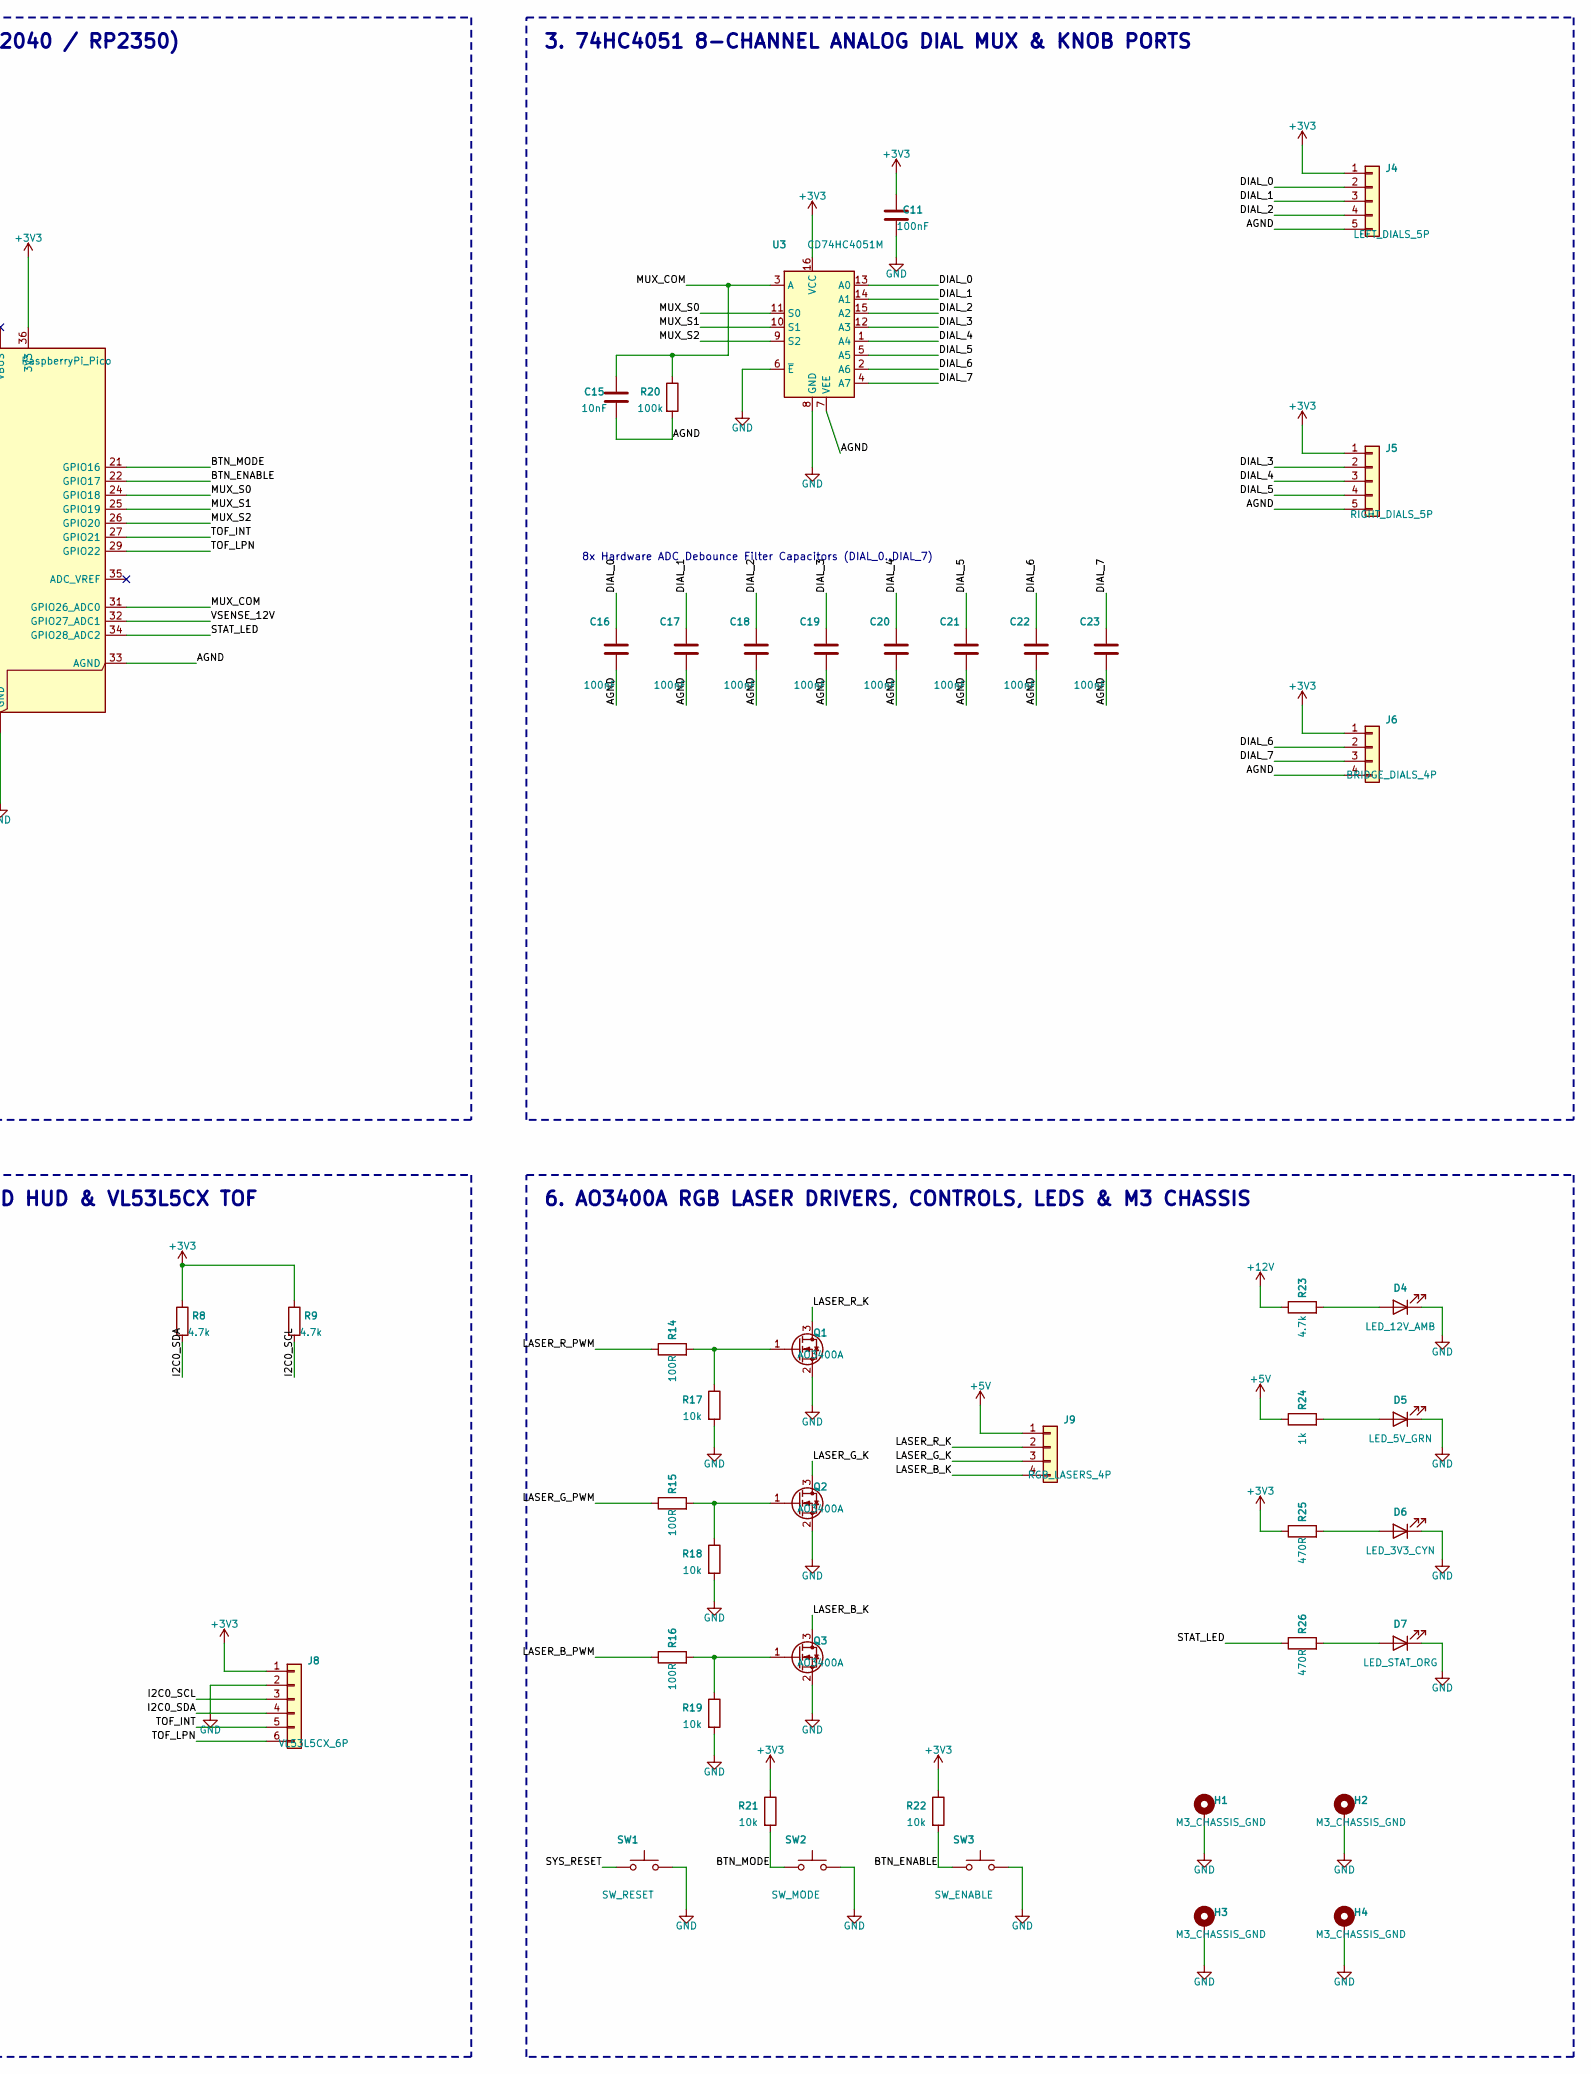
[picture p152: schematic HPVE_Master_Carrier.kicad_sch, HPVE Master Carrier Avionics Motherboard (MK-I), part in row 1, column 2]

Parts:
C1: 100uF_35V; CP_Elec_6.3x7.7; MPN RVT1V101M0607; LCSC C128836
C2, C10: 10uF_25V; C_1206_3216Metric; MPN CL31A106KAHNNNE; LCSC C13585
C3, C4, C9, C11, C12, C13, C14, C16, C17, C18, C19, C20, C21, C22, C23: 100nF; C_0805_2012Metric; MPN CL21B104KBCNNNC; LCSC C49678
C5: 100pF; C_0805_2012Metric; MPN CL21C101JBANNNC; LCSC C1791
C6: 100uF_16V; CP_Elec_6.3x7.7; MPN RVT1C101M0607; LCSC C128835
C7, C8: 22uF_16V; C_1206_3216Metric; MPN CL31A226KOHNNNE; LCSC C12891
C15: 10nF; C_0805_2012Metric; MPN CL21B103KBANNNC; LCSC C1710
D1: SMBJ15CA; D_SMB; MPN SMBJ15CA; LCSC C116756
D2, D3: SS34; D_SMA; MPN SS34; LCSC C8678
D4: LED_12V_AMB; LED_0805_2012Metric; MPN LED_12V_AMB; LCSC C2296
D5: LED_5V_GRN; LED_0805_2012Metric; MPN LED_5V_GRN; LCSC C2297
D6: LED_3V3_CYN; LED_0805_2012Metric; MPN LED_3V3_CYN; LCSC C2293
D7: LED_STAT_ORG; LED_0805_2012Metric; MPN LED_STAT_ORG; LCSC C2295
F1: 5A_PTC; Fuse_1812_4532Metric; MPN 1812L500/24DR; LCSC C69682
F2, F3: 0.5A_PTC; Fuse_1206_3216Metric; MPN SMD1206P050TF; LCSC C369168
H1, H2, H3, H4: M3_CHASSIS_GND; MountingHole_3.2mm_M3_ISO14580_Pad_TopBottom; MPN M3_NPTH_PAD
J1: XT30_12V_IN; AMASS_XT30UPB-M_1x02_P5.0mm_Vertical; MPN AMASS-XT30UPB-M; LCSC C2913283
J2: FH12-6S-0.5SH; Hirose_FH12-6S-0.5SH_1x06-1MP_P0.50mm_Horizontal; MPN FH12-6S-0.5SH(55); LCSC C424667
J3: GC9A01_ROUND_IPS; JST_XH_B8B-XH-A_1x08_P2.50mm_Vertical; MPN B8B-XH-A; LCSC C71698
J4: LEFT_DIALS_5P; JST_XH_B5B-XH-A_1x05_P2.50mm_Vertical; MPN B5B-XH-A; LCSC C173752
J5: RIGHT_DIALS_5P; JST_XH_B5B-XH-A_1x05_P2.50mm_Vertical; MPN B5B-XH-A; LCSC C173752
J6: BRIDGE_DIALS_4P; JST_XH_B4B-XH-A_1x04_P2.50mm_Vertical; MPN B4B-XH-A; LCSC C158012
J7: SSD1306_OLED_4P; JST_XH_B4B-XH-A_1x04_P2.50mm_Vertical; MPN B4B-XH-A; LCSC C158012
J8: VL53L5CX_6P; JST_XH_B6B-XH-A_1x06_P2.50mm_Vertical; MPN B6B-XH-A; LCSC C158014
J9: RGB_LASERS_4P; JST_XH_B4B-XH-A_1x04_P2.50mm_Vertical; MPN B4B-XH-A; LCSC C158012
J10: AUX_SYNC_4P; JST_XH_B4B-XH-A_1x04_P2.50mm_Vertical; MPN B4B-XH-A; LCSC C158012
L1: 10uH_6.5A; L_10.4x10.4_H4.8; MPN CDRH104RNP-100NC; LCSC C169395
Q1, Q2, Q3: AO3400A; SOT-23; MPN AO3400A; LCSC C20917
R1, R3: 100k_1%; R_0805_2012Metric; MPN 0805W8F1003T5E; LCSC C17407
R2: 22k_1%; R_0805_2012Metric; MPN 0805W8F2202T5E; LCSC C17560
R4: 13.3k_1%; R_0805_2012Metric; MPN 0805W8F1332T5E; LCSC C17451
R5: 39k_1%; R_0805_2012Metric; MPN 0805W8F3902T5E; LCSC C17651
R6: 10k_1%; R_0805_2012Metric; MPN 0805W8F1002T5E; LCSC C17414
R7: 0R_STAR_GND; R_0805_2012Metric; MPN 0805W8F0000T5E; LCSC C17477
R8, R9: 4.7k; R_0805_2012Metric; MPN 0805W8F4701T5E; LCSC C17673
R10, R11, R12, R13: 33R; R_0805_2012Metric; MPN 0805W8F330JT5E; LCSC C17630
R14, R15, R16: 100R; R_0805_2012Metric; MPN 0805W8F1000T5E; LCSC C17408
R17, R18, R19, R21, R22: 10k; R_0805_2012Metric; MPN 0805W8F1002T5E; LCSC C17414
R20: 100k; R_0805_2012Metric; MPN 0805W8F1003T5E; LCSC C17407
R23: 4.7k; R_0805_2012Metric; MPN 4.7k; LCSC C17673
R24: 1k; R_0805_2012Metric; MPN 1k; LCSC C17513
R25, R26: 470R; R_0805_2012Metric; MPN 470R; LCSC C17710
SW1: SW_RESET; SW_Push_1P1T_NO_CK_KMR2; MPN KMR231GLFS; LCSC C115356
SW2: SW_MODE; SW_Push_1P1T_NO_CK_KMR2; MPN KMR231GLFS; LCSC C115356
SW3: SW_ENABLE; SW_Push_1P1T_NO_CK_KMR2; MPN KMR231GLFS; LCSC C115356
U1: RaspberryPi_Pico; RaspberryPi_Pico_Common_THT; MPN RPI-PICO
U2: TPS54302DDCR; SOT-23-6; MPN TPS54302DDCR; LCSC C314440
U3: CD74HC4051M; SOIC-16_3.9x9.9mm_P1.27mm; MPN CD74HC4051M96; LCSC C7430
U4: SN74AHCT125D; SOIC-14_3.9x8.7mm_P1.27mm; MPN SN74AHCT125DR; LCSC C5440

Connections:
+3V3: C10.1, C11.1, C13.1, J3.1, J4.1, J5.1, J6.1, J7.1, J8.1, R8.1, R9.1, R21.1, R22.1, R25.1, U1.36 (3V3), U3.16 (VCC)
+5V: C5.1, C6.1, C7.1, C8.1, C9.1, C12.1, D3.2 (A), F3.1, J9.1, J10.1, L1.2, R3.1, R24.1, U4.14 (VCC)
+12V: C1.1, C2.1, C3.1, D1.2 (A2), D2.1 (K), F2.1, R1.1, R5.1, R23.1, U2.3 (VIN)
/+5V_FFC: F3.2, J2.2
/+12V_FFC: F2.2, J2.1
/AGND: C14.2, C15.2, C16.2, C17.2, C18.2, C19.2, C20.2, C21.2, C22.2, C23.2, J4.5, J5.5, J6.4, R6.2, R7.1, R20.2, U1.33 (AGND), U3.7 (VEE)
/AUX_OE_5V: J10.3, R13.2
/BTN_ENABLE: R22.2, SW3.1, U1.22 (GPIO17)
/BTN_MODE: R21.2, SW2.1, U1.21 (GPIO16)
/DIAL_0: C16.1, J4.2, U3.13 (A0)
/DIAL_1: C17.1, J4.3, U3.14 (A1)
/DIAL_2: C18.1, J4.4, U3.15 (A2)
/DIAL_3: C19.1, J5.2, U3.12 (A3)
/DIAL_4: C20.1, J5.3, U3.1 (A4)
/DIAL_5: C21.1, J5.4, U3.5 (A5)
/DIAL_6: C22.1, J6.2, U3.2 (A6)
/DIAL_7: C23.1, J6.3, U3.4 (A7)
/DISP_BLK: J3.8, U1.20 (GPIO15)
/DISP_CS: J3.6, U1.17 (GPIO13)
/DISP_DC: J3.5, U1.16 (GPIO12)
/DISP_RST: J3.7, U1.19 (GPIO14)
/DISP_SCL: J3.3, U1.14 (GPIO10)
/DISP_SDA: J3.4, U1.15 (GPIO11)
/FFC_LATCH: J2.6, R12.2
/FFC_MOSI: J2.4, R10.2
/I2C0_SCL: J7.3, J8.3, R9.2, U1.2 (GPIO1)
/LASER_B_K: J9.4, Q3.3 (D)
/LASER_B_PWM: R16.1, U1.11 (GPIO8)
/LASER_G_K: J9.3, Q2.3 (D)
/LASER_G_PWM: R15.1, U1.10 (GPIO7)
/LASER_R_K: J9.2, Q1.3 (D)
/LASER_R_PWM: R14.1, U1.9 (GPIO6)
/MUX_COM: C15.1, R20.1, U1.31 (GPIO26_ADC0), U3.3 (A)
/MUX_S0: U1.24 (GPIO18), U3.11 (S0)
/MUX_S1: U1.25 (GPIO19), U3.10 (S1)
/MUX_S2: U1.26 (GPIO20), U3.9 (S2)
/PICO_VSYS: D3.1 (K), U1.39 (VSYS)
/PIO_DRV_OE: U1.7 (GPIO5), U4.12
/PIO_SPI_LATCH: U1.6 (GPIO4), U4.9
/PIO_SPI_MOSI: U1.4 (GPIO2), U4.2
/PIO_SPI_SCK: U1.5 (GPIO3), U4.5
/STAT_LED: R26.1, U1.34 (GPIO28_ADC2)
/SYS_RESET: SW1.1, U1.30 (RUN)
/TOF_INT: J8.5, U1.27 (GPIO21)
/TOF_LPN: J8.6, U1.29 (GPIO22)
/VSENSE_12V: C14.1, R5.2, R6.1, U1.32 (GPIO27_ADC1)
unnamed: D2.2 (A), F1.2
unnamed: D4.2 (A), R23.2
unnamed: D5.2 (A), R24.2
unnamed: D6.2 (A), R25.2
unnamed: D7.2 (A), R26.2
unnamed: F1.1, J1.2
unnamed: Q1.1 (G), R14.2, R17.1
unnamed: Q2.1 (G), R15.2, R18.1
unnamed: Q3.1 (G), R16.2, R19.1
unnamed: R10.1, U4.3
unnamed: R11.1, U4.6
unnamed: R12.1, U4.8
unnamed: R13.1, U4.11
unnamed: C4.1, U2.6 (BOOT)
unnamed: R1.2, R2.1, U2.5 (EN)
unnamed: C5.2, R3.2, R4.1, U2.4 (FB)
unnamed: C4.2, L1.1, U2.2 (SW)

Notes on the sheet:
12V ADC Sense (Max 3.26V @ 16V) & AGND Star Bridge
Matches Modular Tile J_IN Pinout (Use Reverse/Type-D 6P FFC Cable)
2. RASPBERRY PI PICO MASTER DOCK (RP2040 / RP2350)
8x Hardware ADC Debounce Filter Capacitors (DIAL_0..DIAL_7)
5. GC9A01 ROUND DISPLAY, SSD1306 OLED HUD & VL53L5CX TOF
3. 74HC4051 8-CHANNEL ANALOG DIAL MUX & KNOB PORTS
1. 12V POWER INPUT, PROTECTION & TPS54302 5V/3A BUCK STAGE
4. 5V SPI LEVEL SHIFTER, 33R DAMPING & HIROSE 6P FFC LINK
6. AO3400A RGB LASER DRIVERS, CONTROLS, LEDS & M3 CHASSIS

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
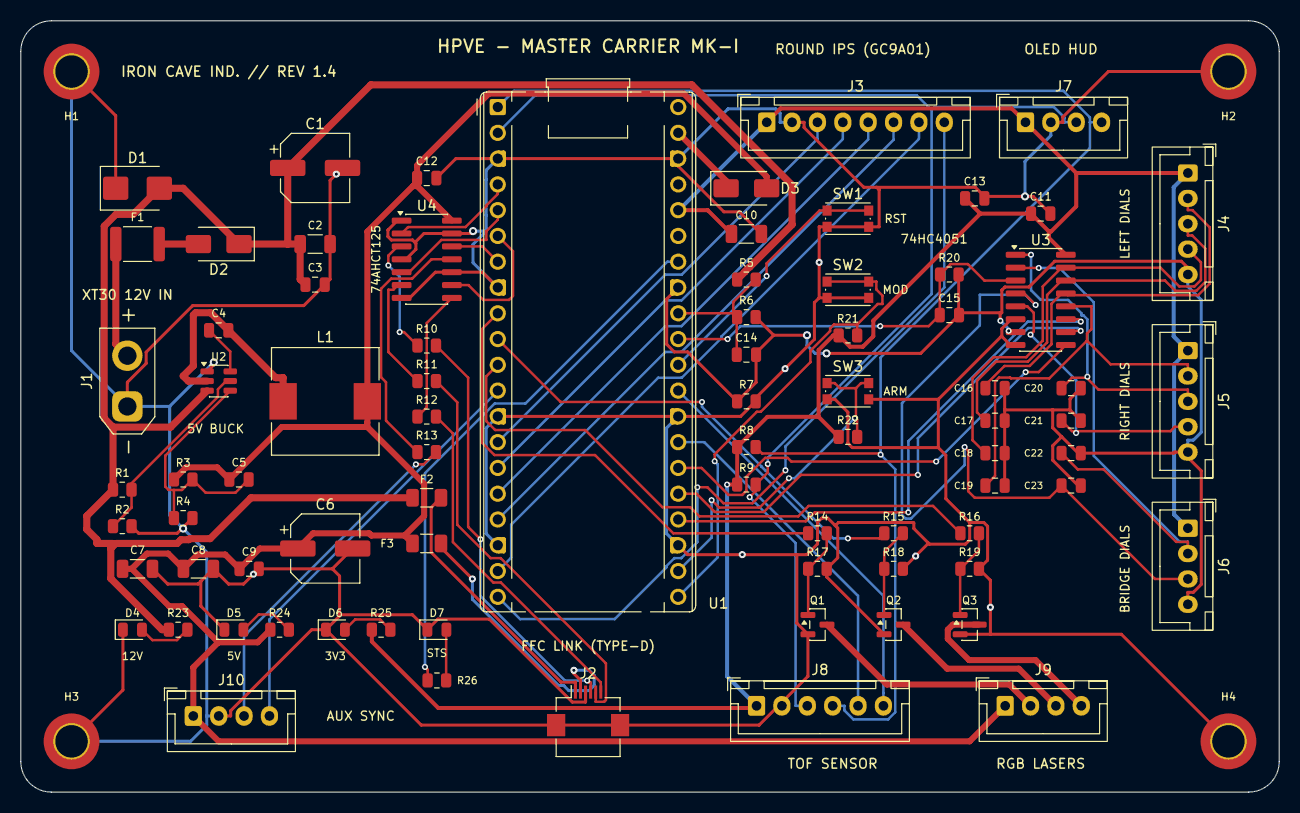
[picture p153: board HPVE_Master_Carrier.kicad_pcb from above]

Board: 2 copper layers, 124.0 x 76.0 mm, 84 parts (0 on the bottom side), 67 nets.
