triunex/HPVE-Fallen/hardware/modular_tile/HPVE_Tile_16Ch.kicad_pcb

## KiCad design hardware/modular_tile/HPVE_Tile_16Ch.kicad_pcb (2026-11-05)

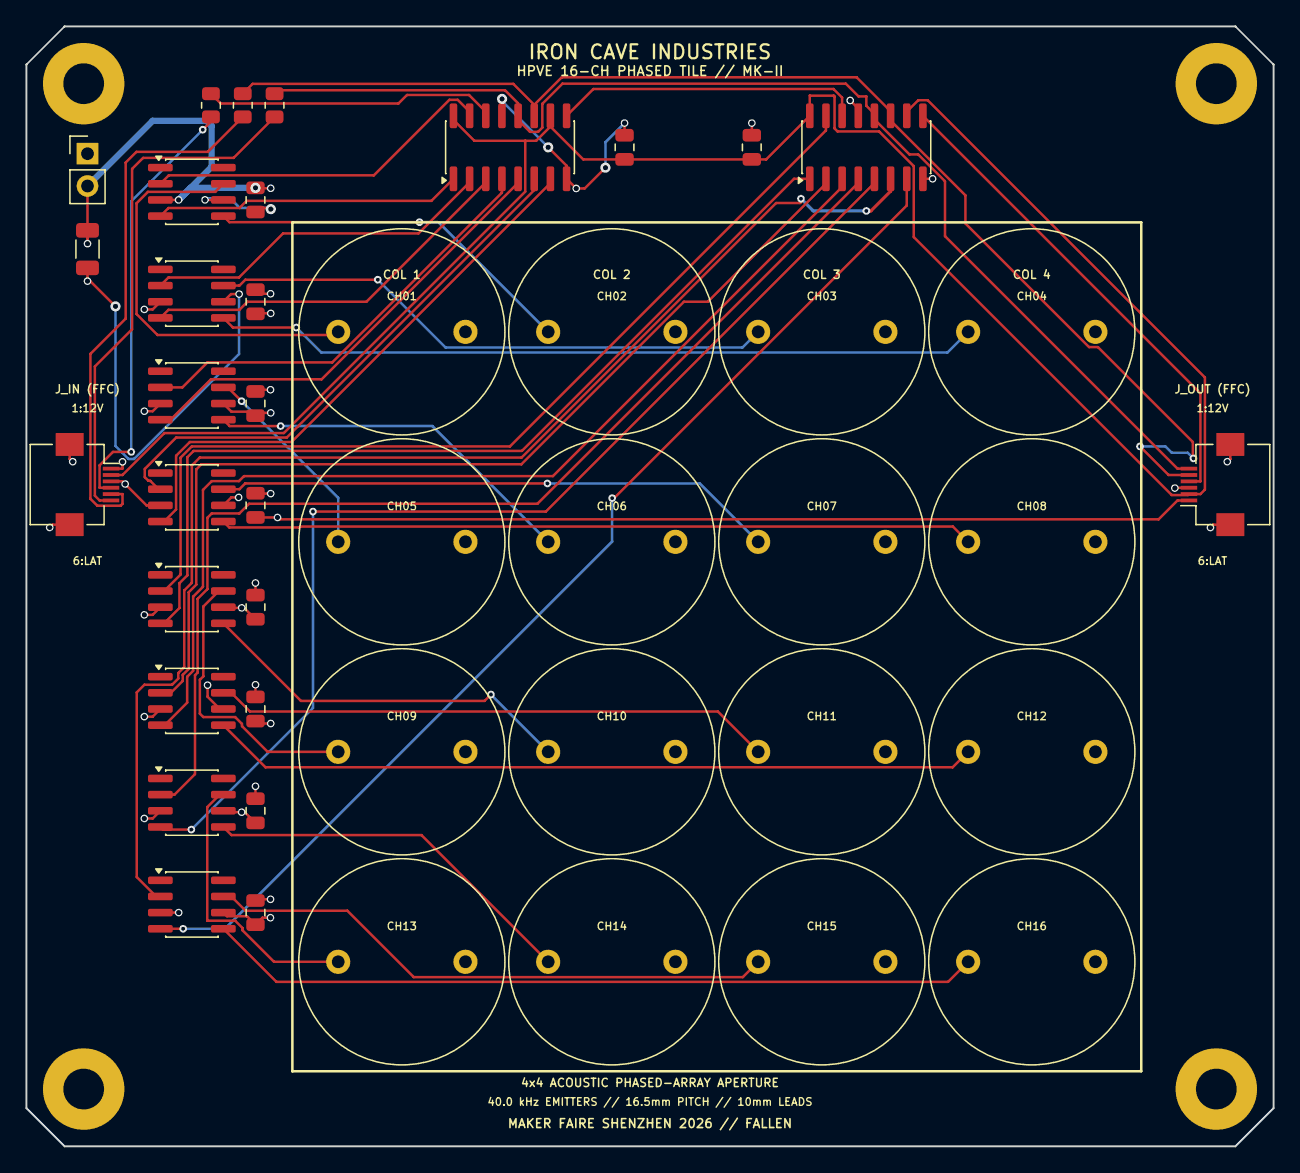
[picture p154: board HPVE_Tile_16Ch.kicad_pcb from above]

Board: 4 copper layers, 98.0 x 88.0 mm, 47 parts (0 on the bottom side), 43 nets.

Parts:
C1, C2: 0.1uF; C_0805_2012Metric
C101, C102, C103, C104, C105, C106, C107, C108: 0.1uF_50V; C_0805_2012Metric
C_BULK: 10uF_25V; C_1206_3216Metric
H1, H2, H3, H4: M3_Pad; MountingHole_3.2mm_M3_Pad
J_IN: 0.5mm_FFC_6P; Hirose_FH12-6S-0.5SH_1x06-1MP_P0.50mm_Horizontal
J_OUT: 0.5mm_FFC_6P; Hirose_FH12-6S-0.5SH_1x06-1MP_P0.50mm_Horizontal
J_PWR: AUX_12V_IN; PinHeader_1x02_P2.54mm_Vertical
R1, R2, R3: 33R; R_0805_2012Metric
TX1, TX2, TX3, TX4, TX5, TX6, TX7, TX8, TX9, TX10, TX11, TX12, TX13, TX14, TX15, TX16: 400ST160_FEMALE_SOCKET; TX_400ST160_P10.0mm
U1, U2: 74HC595; SOIC-16_3.9x9.9mm_P1.27mm
U101, U102, U103, U104, U105, U106, U107, U108: TC4427ACOA; SOIC-8_3.9x4.9mm_P1.27mm

Connections:
+5V: C1.1, C2.1, J_IN.2, J_OUT.2, U1.10, U1.16, U2.10, U2.16
+12V: C101.1, C102.1, C103.1, C104.1, C105.1, C106.1, C107.1, C108.1, C_BULK.1, J_IN.1, J_OUT.1, J_PWR.1, U101.6, U102.6, U103.6, U104.6, U105.6, U106.6, U107.6, U108.6
DRV_1: TX1.1, U101.7
DRV_2: TX2.1, U101.5
DRV_3: TX3.1, U102.7
DRV_4: TX4.1, U102.5
DRV_5: TX5.1, U103.7
DRV_6: TX6.1, U103.5
DRV_7: TX7.1, U104.7
DRV_8: TX8.1, U104.5
DRV_9: TX9.1, U105.7
DRV_10: TX10.1, U105.5
DRV_11: TX11.1, U106.7
DRV_12: TX12.1, U106.5
DRV_13: TX13.1, U107.7
DRV_14: TX14.1, U107.5
DRV_15: TX15.1, U108.7
DRV_16: TX16.1, U108.5
GND: C1.2, C2.2, C101.2, C102.2, C103.2, C104.2, C105.2, C106.2, C107.2, C108.2, C_BULK.2, H1.1, H2.1, H3.1, H4.1, J_IN.3, J_IN.MP, J_OUT.3, J_OUT.MP, J_PWR.2, TX1.2, TX2.2, TX3.2, TX4.2, TX5.2, TX6.2, TX7.2, TX8.2, TX9.2, TX10.2, TX11.2, TX12.2, TX13.2, TX14.2, TX15.2, TX16.2, U1.8, U1.13, U2.8, U2.13, U101.3, U102.3, U103.3, U104.3, U105.3, U106.3, U107.3, U108.3
SIG_1: U1.15, U101.2
SIG_2: U1.1, U101.4
SIG_3: U1.2, U102.2
SIG_4: U1.3, U102.4
SIG_5: U1.4, U103.2
SIG_6: U1.5, U103.4
SIG_7: U1.6, U104.2
SIG_8: U1.7, U104.4
SIG_9: U2.15, U105.2
SIG_10: U2.1, U105.4
SIG_11: U2.2, U106.2
SIG_12: U2.3, U106.4
SIG_13: U2.4, U107.2
SIG_14: U2.5, U107.4
SIG_15: U2.6, U108.2
SIG_16: U2.7, U108.4
SPI_LATCH: J_OUT.6, R3.2, U1.12, U2.12
SPI_LATCH_IN: J_IN.6, R3.1
SPI_MOSI: R1.2, U1.14
SPI_MOSI_CASCADE: U1.9, U2.14
SPI_MOSI_IN: J_IN.4, R1.1
SPI_MOSI_OUT: J_OUT.4, U2.9
SPI_SCK: J_OUT.5, R2.2, U1.11, U2.11
SPI_SCK_IN: J_IN.5, R2.1
