triunex/HPVE-Fallen/hardware/kicad/HPVE_Controller.kicad_pcb

## KiCad design hardware/kicad/HPVE_Controller.kicad_pcb (2026-10-31)

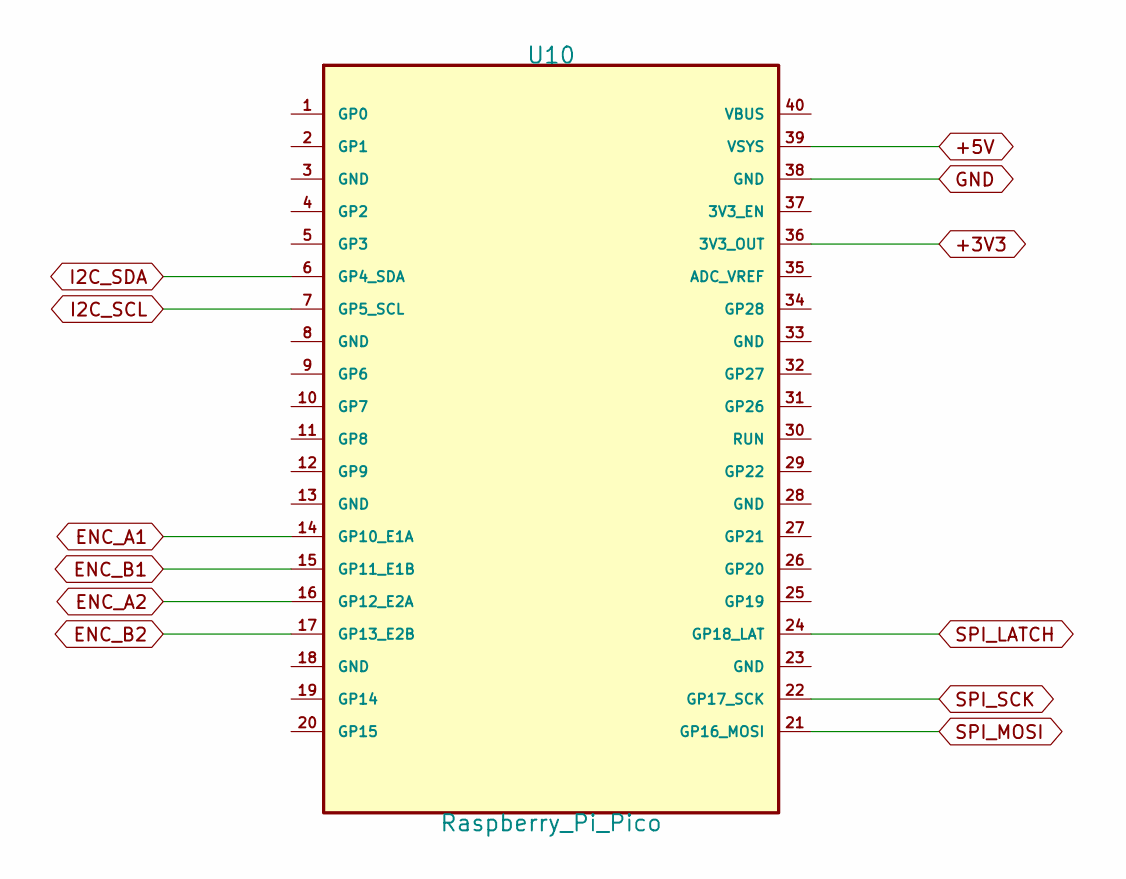
[picture p155: schematic sheet1_mcu_core.kicad_sch, Sheet 1: RP2040 Pico Core, Power & I2C UI]

Parts:
U10: Raspberry_Pi_Pico; PinHeader_2x20_P2.54mm_Vertical

Connections:
/RP2040_Core_UI/+5V: U10.39 (VSYS)
/RP2040_Core_UI/SPI_MOSI: U10.36 (3V3_OUT)
GND: U10.38 (GND); also elsewhere on the board
SPI_LATCH: U10.24 (GP18_LAT); also elsewhere on the board
SPI_MOSI: U10.21 (GP16_MOSI); also elsewhere on the board
SPI_SCK: U10.22 (GP17_SCK); also elsewhere on the board

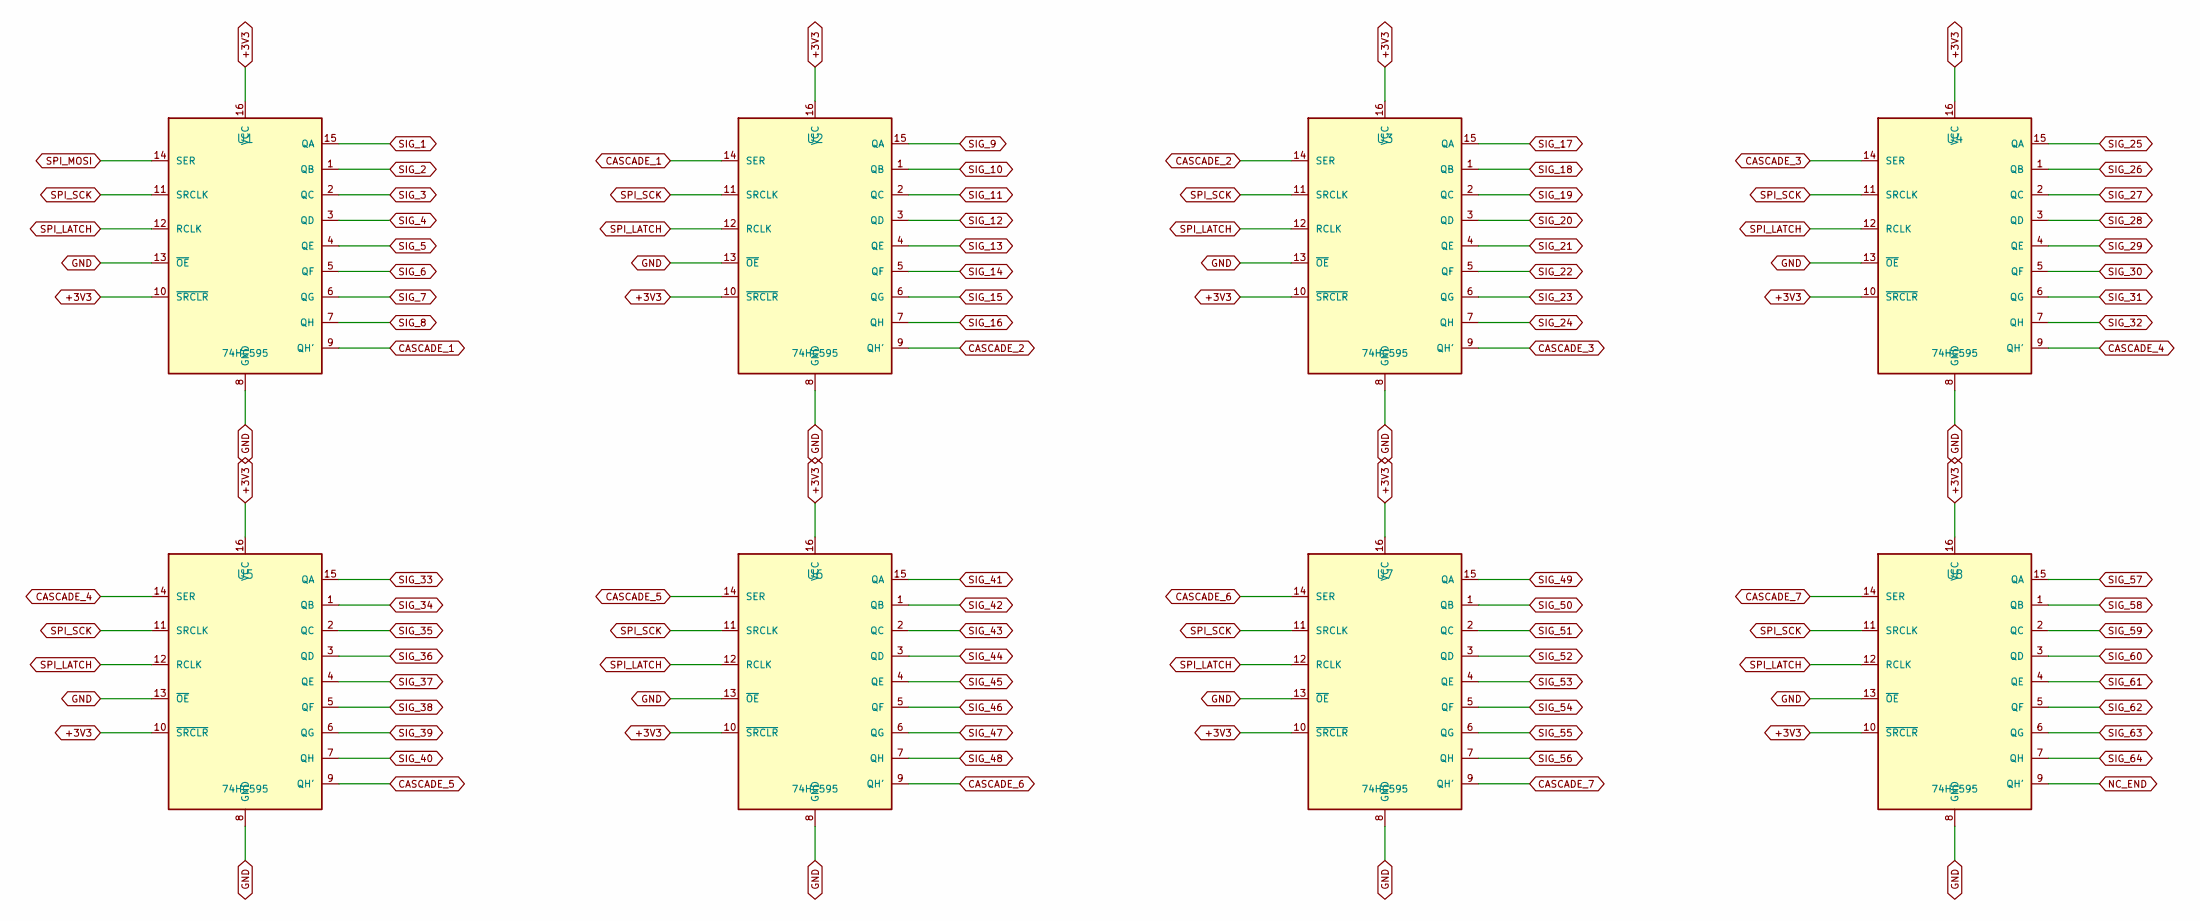
[picture p156: schematic sheet2_shift_registers.kicad_sch, Sheet 2: 74HC595 High-Speed Shift Register Cascade (8 Stage…]

Parts:
U1, U2, U3, U4, U5, U6, U7, U8: 74HC595; DIP-16_W7.62mm

Connections:
/Shift_Register_Cascade/SPI_SCK: U1.8 (GND), U1.13 (~OE), U2.8 (GND), U2.13 (~OE), U3.8 (GND), U3.13 (~OE), U4.8 (GND), U4.13 (~OE), U5.8 (GND), U5.13 (~OE), U6.8 (GND), U6.13 (~OE), U7.8 (GND), U7.13 (~OE), U8.8 (GND), U8.13 (~OE)
CASCADE_1: U1.9 (QH'), U2.14 (SER)
CASCADE_2: U2.9 (QH'), U3.14 (SER)
CASCADE_3: U3.9 (QH'), U4.14 (SER)
CASCADE_4: U4.9 (QH'), U5.14 (SER)
CASCADE_5: U5.9 (QH'), U6.14 (SER)
CASCADE_6: U6.9 (QH'), U7.14 (SER)
CASCADE_7: U7.9 (QH'), U8.14 (SER)
SIG_1: U1.15 (QA); also elsewhere on the board
SIG_2: U1.1 (QB); also elsewhere on the board
SIG_3: U1.2 (QC); also elsewhere on the board
SIG_4: U1.3 (QD); also elsewhere on the board
SIG_5: U1.4 (QE); also elsewhere on the board
SIG_6: U1.5 (QF); also elsewhere on the board
SIG_7: U1.6 (QG); also elsewhere on the board
SIG_8: U1.7 (QH); also elsewhere on the board
SIG_9: U2.15 (QA); also elsewhere on the board
SIG_10: U2.1 (QB); also elsewhere on the board
SIG_11: U2.2 (QC); also elsewhere on the board
SIG_12: U2.3 (QD); also elsewhere on the board
SIG_13: U2.4 (QE); also elsewhere on the board
SIG_14: U2.5 (QF); also elsewhere on the board
SIG_15: U2.6 (QG); also elsewhere on the board
SIG_16: U2.7 (QH); also elsewhere on the board
SIG_17: U3.15 (QA); also elsewhere on the board
SIG_18: U3.1 (QB); also elsewhere on the board
SIG_19: U3.2 (QC); also elsewhere on the board
SIG_20: U3.3 (QD); also elsewhere on the board
SIG_21: U3.4 (QE); also elsewhere on the board
SIG_22: U3.5 (QF); also elsewhere on the board
SIG_23: U3.6 (QG); also elsewhere on the board
SIG_24: U3.7 (QH); also elsewhere on the board
SIG_25: U4.15 (QA); also elsewhere on the board
SIG_26: U4.1 (QB); also elsewhere on the board
SIG_27: U4.2 (QC); also elsewhere on the board
SIG_28: U4.3 (QD); also elsewhere on the board
SIG_29: U4.4 (QE); also elsewhere on the board
SIG_30: U4.5 (QF); also elsewhere on the board
SIG_31: U4.6 (QG); also elsewhere on the board
SIG_32: U4.7 (QH); also elsewhere on the board
SIG_33: U5.15 (QA); also elsewhere on the board
SIG_34: U5.1 (QB); also elsewhere on the board
SIG_35: U5.2 (QC); also elsewhere on the board
SIG_36: U5.3 (QD); also elsewhere on the board
SIG_37: U5.4 (QE); also elsewhere on the board
SIG_38: U5.5 (QF); also elsewhere on the board
SIG_39: U5.6 (QG); also elsewhere on the board
SIG_40: U5.7 (QH); also elsewhere on the board
SIG_41: U6.15 (QA); also elsewhere on the board
SIG_42: U6.1 (QB); also elsewhere on the board
SIG_43: U6.2 (QC); also elsewhere on the board
SIG_44: U6.3 (QD); also elsewhere on the board
SIG_45: U6.4 (QE); also elsewhere on the board
SIG_46: U6.5 (QF); also elsewhere on the board
SIG_47: U6.6 (QG); also elsewhere on the board
SIG_48: U6.7 (QH); also elsewhere on the board
SIG_49: U7.15 (QA); also elsewhere on the board
SIG_50: U7.1 (QB); also elsewhere on the board
SIG_51: U7.2 (QC); also elsewhere on the board
SIG_52: U7.3 (QD); also elsewhere on the board
SIG_53: U7.4 (QE); also elsewhere on the board
SIG_54: U7.5 (QF); also elsewhere on the board
SIG_55: U7.6 (QG); also elsewhere on the board
SIG_56: U7.7 (QH); also elsewhere on the board
SIG_57: U8.15 (QA); also elsewhere on the board
SIG_58: U8.1 (QB); also elsewhere on the board
SIG_59: U8.2 (QC); also elsewhere on the board
SIG_60: U8.3 (QD); also elsewhere on the board
SIG_61: U8.4 (QE); also elsewhere on the board
SIG_62: U8.5 (QF); also elsewhere on the board
SIG_63: U8.6 (QG); also elsewhere on the board
SIG_64: U8.7 (QH); also elsewhere on the board
SPI_LATCH: U1.12 (RCLK), U2.12 (RCLK), U3.12 (RCLK), U4.12 (RCLK), U5.12 (RCLK), U6.12 (RCLK), U7.12 (RCLK), U8.12 (RCLK); also elsewhere on the board
SPI_MOSI: U1.14 (SER); also elsewhere on the board
SPI_SCK: U1.11 (SRCLK), U2.11 (SRCLK), U3.11 (SRCLK), U4.11 (SRCLK), U5.11 (SRCLK), U6.11 (SRCLK), U7.11 (SRCLK), U8.11 (SRCLK); also elsewhere on the board
