triunex/HPVE-Fallen/hardware/kicad/HPVE_Controller.kicad_pcb

## KiCad design hardware/kicad/HPVE_Controller.kicad_pcb (continued)

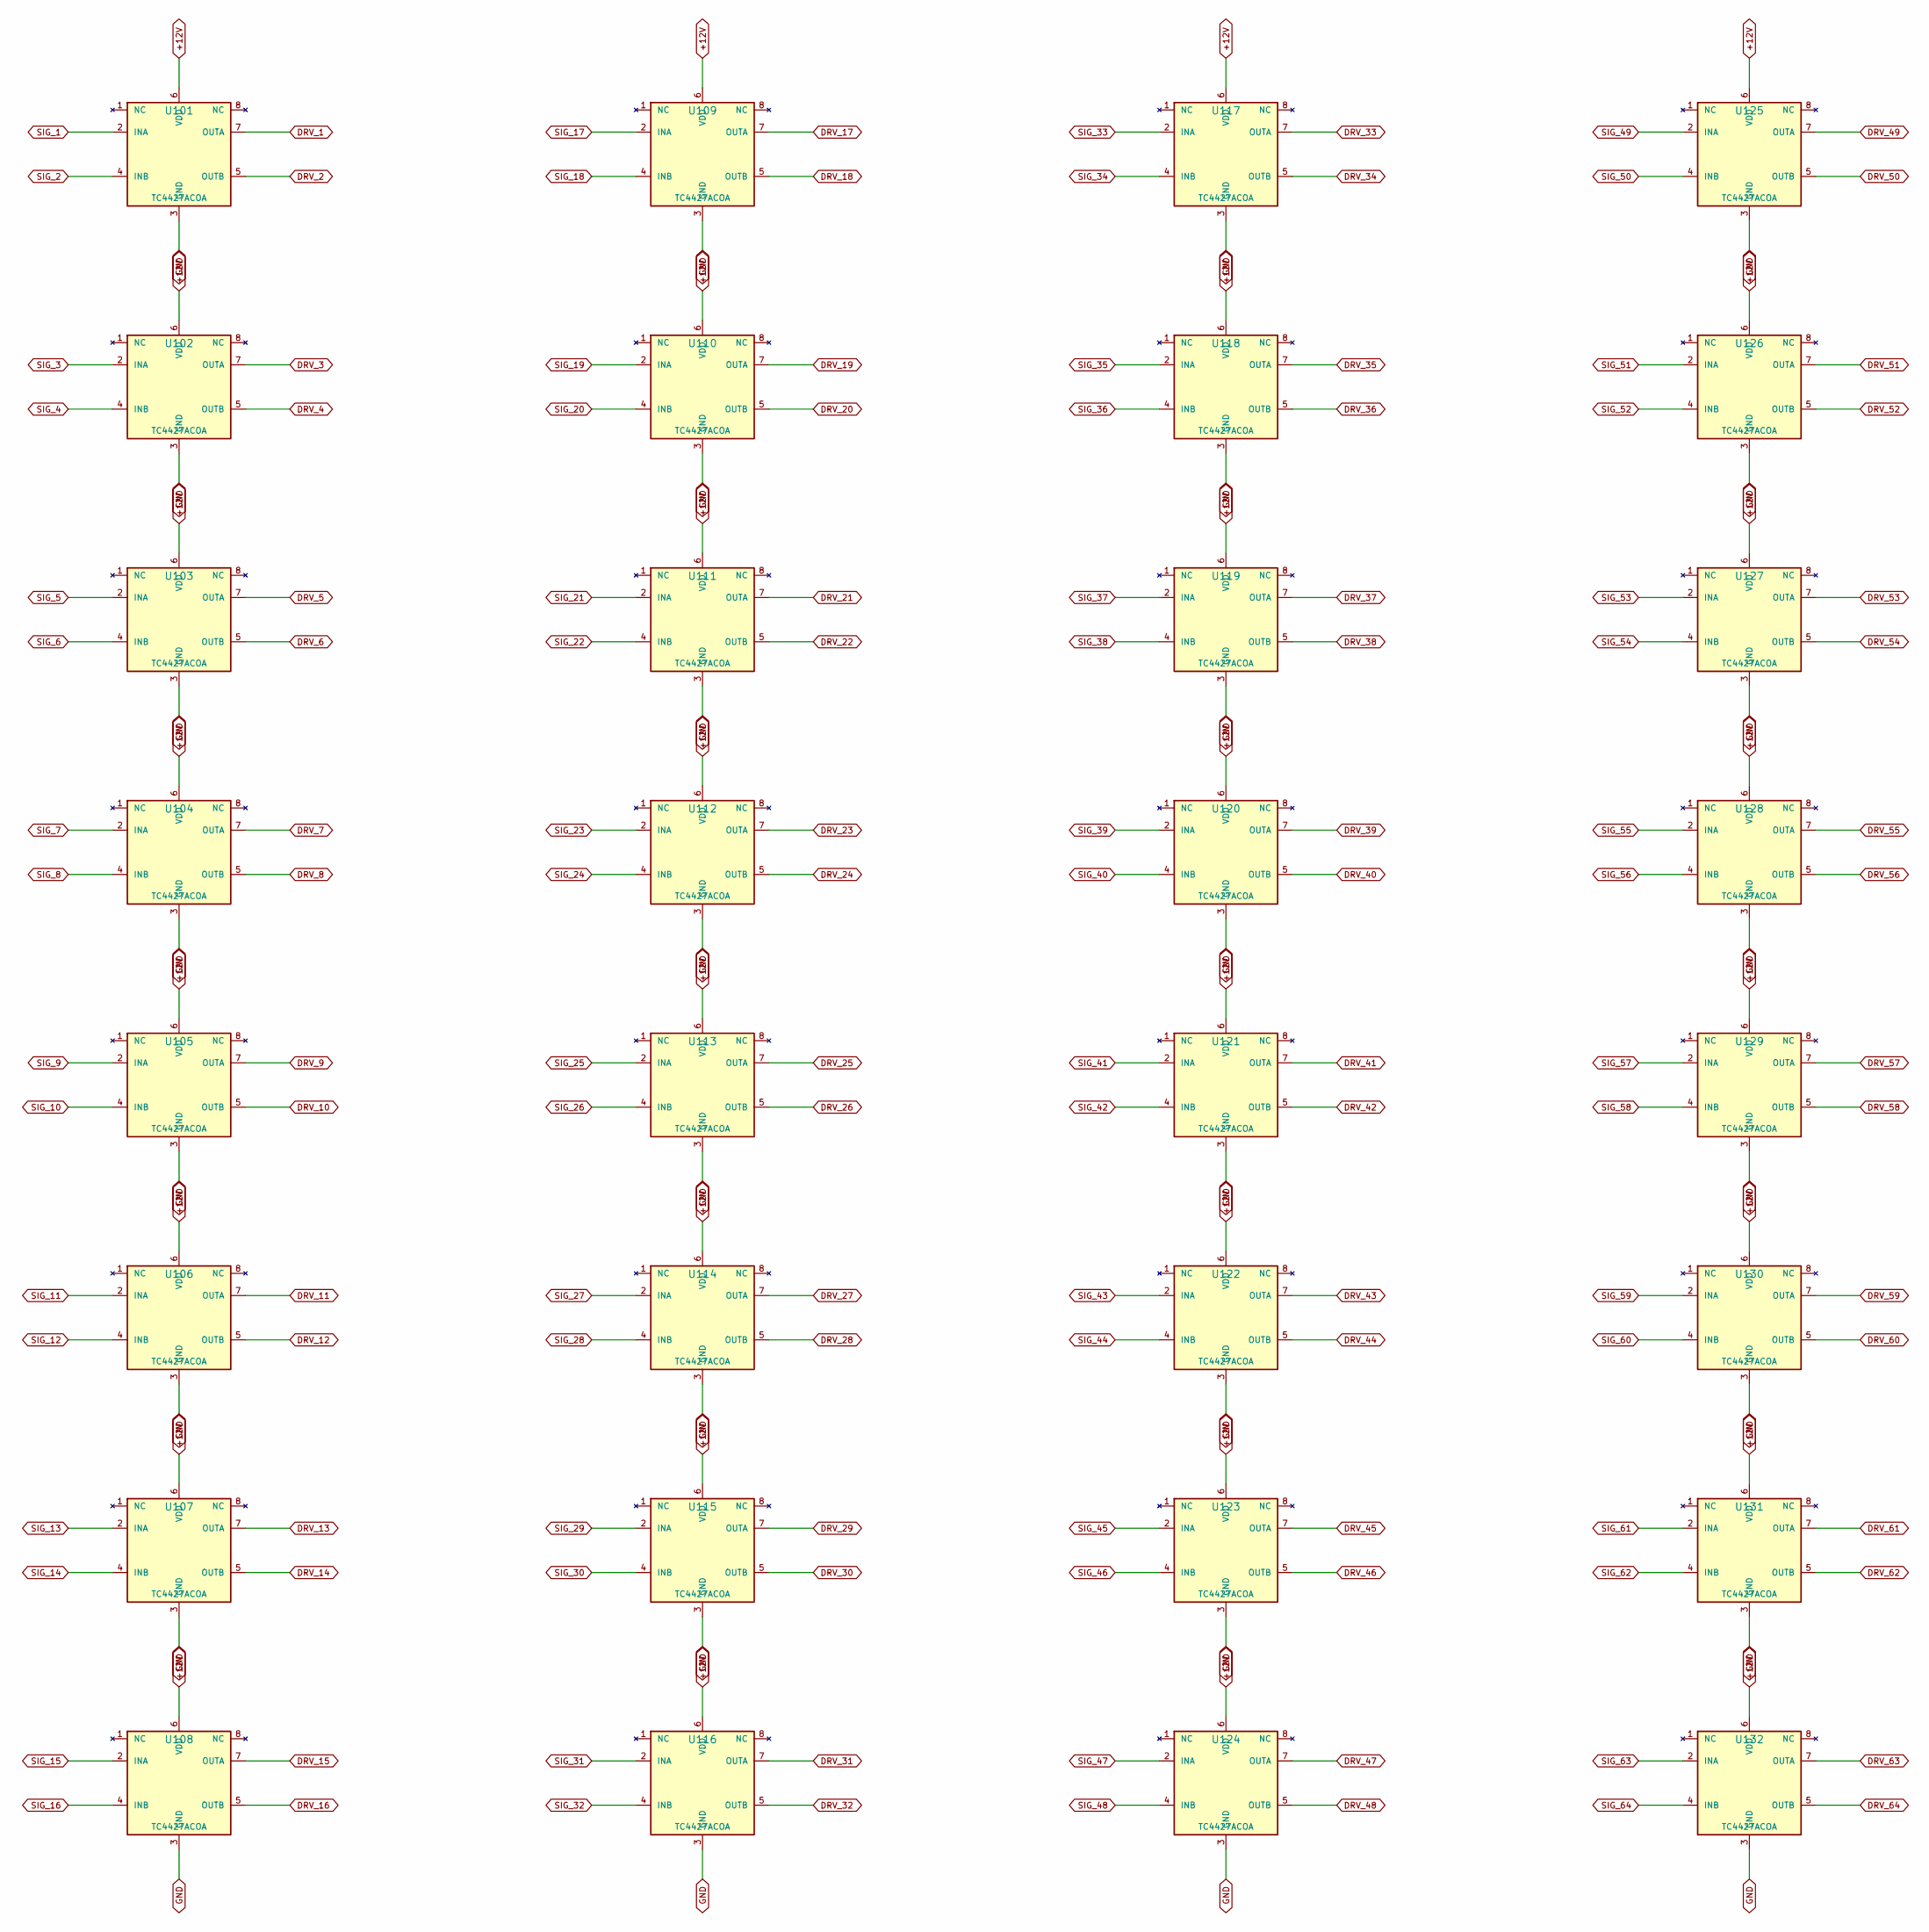
[picture p157: schematic sheet3_driver_bank.kicad_sch, Sheet 3: TC4427 Dual High-Speed Driver Bank (32 ICs / 64 Ch…]

Parts:
U101, U102, U103, U104, U105, U106, U107, U108, U109, U110, U111, U112, U113, U114, U115, U116, U117, U118, U119, U120, U121, U122, U123, U124, U125, U126, U127, U128, U129, U130, U131, U132: TC4427ACOA; SOIC-8_3.9x4.9mm_P1.27mm

Connections:
+12V: U101.6 (VDD), U102.6 (VDD), U103.6 (VDD), U104.6 (VDD), U105.6 (VDD), U106.6 (VDD), U107.6 (VDD), U108.6 (VDD), U109.6 (VDD), U110.6 (VDD), U111.6 (VDD), U112.6 (VDD), U113.6 (VDD), U114.6 (VDD), U115.6 (VDD), U116.6 (VDD), U117.6 (VDD), U118.6 (VDD), U119.6 (VDD), U120.6 (VDD), U121.6 (VDD), U122.6 (VDD), U123.6 (VDD), U124.6 (VDD), U125.6 (VDD), U126.6 (VDD), U127.6 (VDD), U128.6 (VDD), U129.6 (VDD), U130.6 (VDD), U131.6 (VDD), U132.6 (VDD)
/TC4427_Driver_Bank/GND: U101.3 (GND), U102.3 (GND), U103.3 (GND), U104.3 (GND), U105.3 (GND), U106.3 (GND), U107.3 (GND), U108.3 (GND), U109.3 (GND), U110.3 (GND), U111.3 (GND), U112.3 (GND), U113.3 (GND), U114.3 (GND), U115.3 (GND), U116.3 (GND), U117.3 (GND), U118.3 (GND), U119.3 (GND), U120.3 (GND), U121.3 (GND), U122.3 (GND), U123.3 (GND), U124.3 (GND), U125.3 (GND), U126.3 (GND), U127.3 (GND), U128.3 (GND), U129.3 (GND), U130.3 (GND), U131.3 (GND), U132.3 (GND)
DRV_1: U101.7 (OUTA); also elsewhere on the board
DRV_2: U101.5 (OUTB); also elsewhere on the board
DRV_3: U102.7 (OUTA); also elsewhere on the board
DRV_4: U102.5 (OUTB); also elsewhere on the board
DRV_5: U103.7 (OUTA); also elsewhere on the board
DRV_6: U103.5 (OUTB); also elsewhere on the board
DRV_7: U104.7 (OUTA); also elsewhere on the board
DRV_8: U104.5 (OUTB); also elsewhere on the board
DRV_9: U105.7 (OUTA); also elsewhere on the board
DRV_10: U105.5 (OUTB); also elsewhere on the board
DRV_11: U106.7 (OUTA); also elsewhere on the board
DRV_12: U106.5 (OUTB); also elsewhere on the board
DRV_13: U107.7 (OUTA); also elsewhere on the board
DRV_14: U107.5 (OUTB); also elsewhere on the board
DRV_15: U108.7 (OUTA); also elsewhere on the board
DRV_16: U108.5 (OUTB); also elsewhere on the board
DRV_17: U109.7 (OUTA); also elsewhere on the board
DRV_18: U109.5 (OUTB); also elsewhere on the board
DRV_19: U110.7 (OUTA); also elsewhere on the board
DRV_20: U110.5 (OUTB); also elsewhere on the board
DRV_21: U111.7 (OUTA); also elsewhere on the board
DRV_22: U111.5 (OUTB); also elsewhere on the board
DRV_23: U112.7 (OUTA); also elsewhere on the board
DRV_24: U112.5 (OUTB); also elsewhere on the board
DRV_25: U113.7 (OUTA); also elsewhere on the board
DRV_26: U113.5 (OUTB); also elsewhere on the board
DRV_27: U114.7 (OUTA); also elsewhere on the board
DRV_28: U114.5 (OUTB); also elsewhere on the board
DRV_29: U115.7 (OUTA); also elsewhere on the board
DRV_30: U115.5 (OUTB); also elsewhere on the board
DRV_31: U116.7 (OUTA); also elsewhere on the board
DRV_32: U116.5 (OUTB); also elsewhere on the board
DRV_33: U117.7 (OUTA); also elsewhere on the board
DRV_34: U117.5 (OUTB); also elsewhere on the board
DRV_35: U118.7 (OUTA); also elsewhere on the board
DRV_36: U118.5 (OUTB); also elsewhere on the board
DRV_37: U119.7 (OUTA); also elsewhere on the board
DRV_38: U119.5 (OUTB); also elsewhere on the board
DRV_39: U120.7 (OUTA); also elsewhere on the board
DRV_40: U120.5 (OUTB); also elsewhere on the board
DRV_41: U121.7 (OUTA); also elsewhere on the board
DRV_42: U121.5 (OUTB); also elsewhere on the board
DRV_43: U122.7 (OUTA); also elsewhere on the board
DRV_44: U122.5 (OUTB); also elsewhere on the board
DRV_45: U123.7 (OUTA); also elsewhere on the board
DRV_46: U123.5 (OUTB); also elsewhere on the board
DRV_47: U124.7 (OUTA); also elsewhere on the board
DRV_48: U124.5 (OUTB); also elsewhere on the board
DRV_49: U125.7 (OUTA); also elsewhere on the board
DRV_50: U125.5 (OUTB); also elsewhere on the board
DRV_51: U126.7 (OUTA); also elsewhere on the board
DRV_52: U126.5 (OUTB); also elsewhere on the board
DRV_53: U127.7 (OUTA); also elsewhere on the board
DRV_54: U127.5 (OUTB); also elsewhere on the board
DRV_55: U128.7 (OUTA); also elsewhere on the board
DRV_56: U128.5 (OUTB); also elsewhere on the board
DRV_57: U129.7 (OUTA); also elsewhere on the board
DRV_58: U129.5 (OUTB); also elsewhere on the board
DRV_59: U130.7 (OUTA); also elsewhere on the board
DRV_60: U130.5 (OUTB); also elsewhere on the board
DRV_61: U131.7 (OUTA); also elsewhere on the board
DRV_62: U131.5 (OUTB); also elsewhere on the board
DRV_63: U132.7 (OUTA); also elsewhere on the board
DRV_64: U132.5 (OUTB); also elsewhere on the board
SIG_1: U101.2 (INA); also elsewhere on the board
SIG_2: U101.4 (INB); also elsewhere on the board
SIG_3: U102.2 (INA); also elsewhere on the board
SIG_4: U102.4 (INB); also elsewhere on the board
SIG_5: U103.2 (INA); also elsewhere on the board
SIG_6: U103.4 (INB); also elsewhere on the board
SIG_7: U104.2 (INA); also elsewhere on the board
SIG_8: U104.4 (INB); also elsewhere on the board
SIG_9: U105.2 (INA); also elsewhere on the board
SIG_10: U105.4 (INB); also elsewhere on the board
SIG_11: U106.2 (INA); also elsewhere on the board
SIG_12: U106.4 (INB); also elsewhere on the board
SIG_13: U107.2 (INA); also elsewhere on the board
SIG_14: U107.4 (INB); also elsewhere on the board
SIG_15: U108.2 (INA); also elsewhere on the board
SIG_16: U108.4 (INB); also elsewhere on the board
SIG_17: U109.2 (INA); also elsewhere on the board
SIG_18: U109.4 (INB); also elsewhere on the board
SIG_19: U110.2 (INA); also elsewhere on the board
SIG_20: U110.4 (INB); also elsewhere on the board
SIG_21: U111.2 (INA); also elsewhere on the board
SIG_22: U111.4 (INB); also elsewhere on the board
SIG_23: U112.2 (INA); also elsewhere on the board
SIG_24: U112.4 (INB); also elsewhere on the board
SIG_25: U113.2 (INA); also elsewhere on the board
SIG_26: U113.4 (INB); also elsewhere on the board
SIG_27: U114.2 (INA); also elsewhere on the board
SIG_28: U114.4 (INB); also elsewhere on the board
SIG_29: U115.2 (INA); also elsewhere on the board
SIG_30: U115.4 (INB); also elsewhere on the board
SIG_31: U116.2 (INA); also elsewhere on the board
SIG_32: U116.4 (INB); also elsewhere on the board
SIG_33: U117.2 (INA); also elsewhere on the board
SIG_34: U117.4 (INB); also elsewhere on the board
SIG_35: U118.2 (INA); also elsewhere on the board
SIG_36: U118.4 (INB); also elsewhere on the board
SIG_37: U119.2 (INA); also elsewhere on the board
SIG_38: U119.4 (INB); also elsewhere on the board
SIG_39: U120.2 (INA); also elsewhere on the board
SIG_40: U120.4 (INB); also elsewhere on the board
SIG_41: U121.2 (INA); also elsewhere on the board
SIG_42: U121.4 (INB); also elsewhere on the board
SIG_43: U122.2 (INA); also elsewhere on the board
SIG_44: U122.4 (INB); also elsewhere on the board
SIG_45: U123.2 (INA); also elsewhere on the board
SIG_46: U123.4 (INB); also elsewhere on the board
SIG_47: U124.2 (INA); also elsewhere on the board
SIG_48: U124.4 (INB); also elsewhere on the board
SIG_49: U125.2 (INA); also elsewhere on the board
SIG_50: U125.4 (INB); also elsewhere on the board
SIG_51: U126.2 (INA); also elsewhere on the board
SIG_52: U126.4 (INB); also elsewhere on the board
SIG_53: U127.2 (INA); also elsewhere on the board
SIG_54: U127.4 (INB); also elsewhere on the board
SIG_55: U128.2 (INA); also elsewhere on the board
SIG_56: U128.4 (INB); also elsewhere on the board
SIG_57: U129.2 (INA); also elsewhere on the board
SIG_58: U129.4 (INB); also elsewhere on the board
SIG_59: U130.2 (INA); also elsewhere on the board
SIG_60: U130.4 (INB); also elsewhere on the board
SIG_61: U131.2 (INA); also elsewhere on the board
SIG_62: U131.4 (INB); also elsewhere on the board
SIG_63: U132.2 (INA); also elsewhere on the board
SIG_64: U132.4 (INB); also elsewhere on the board

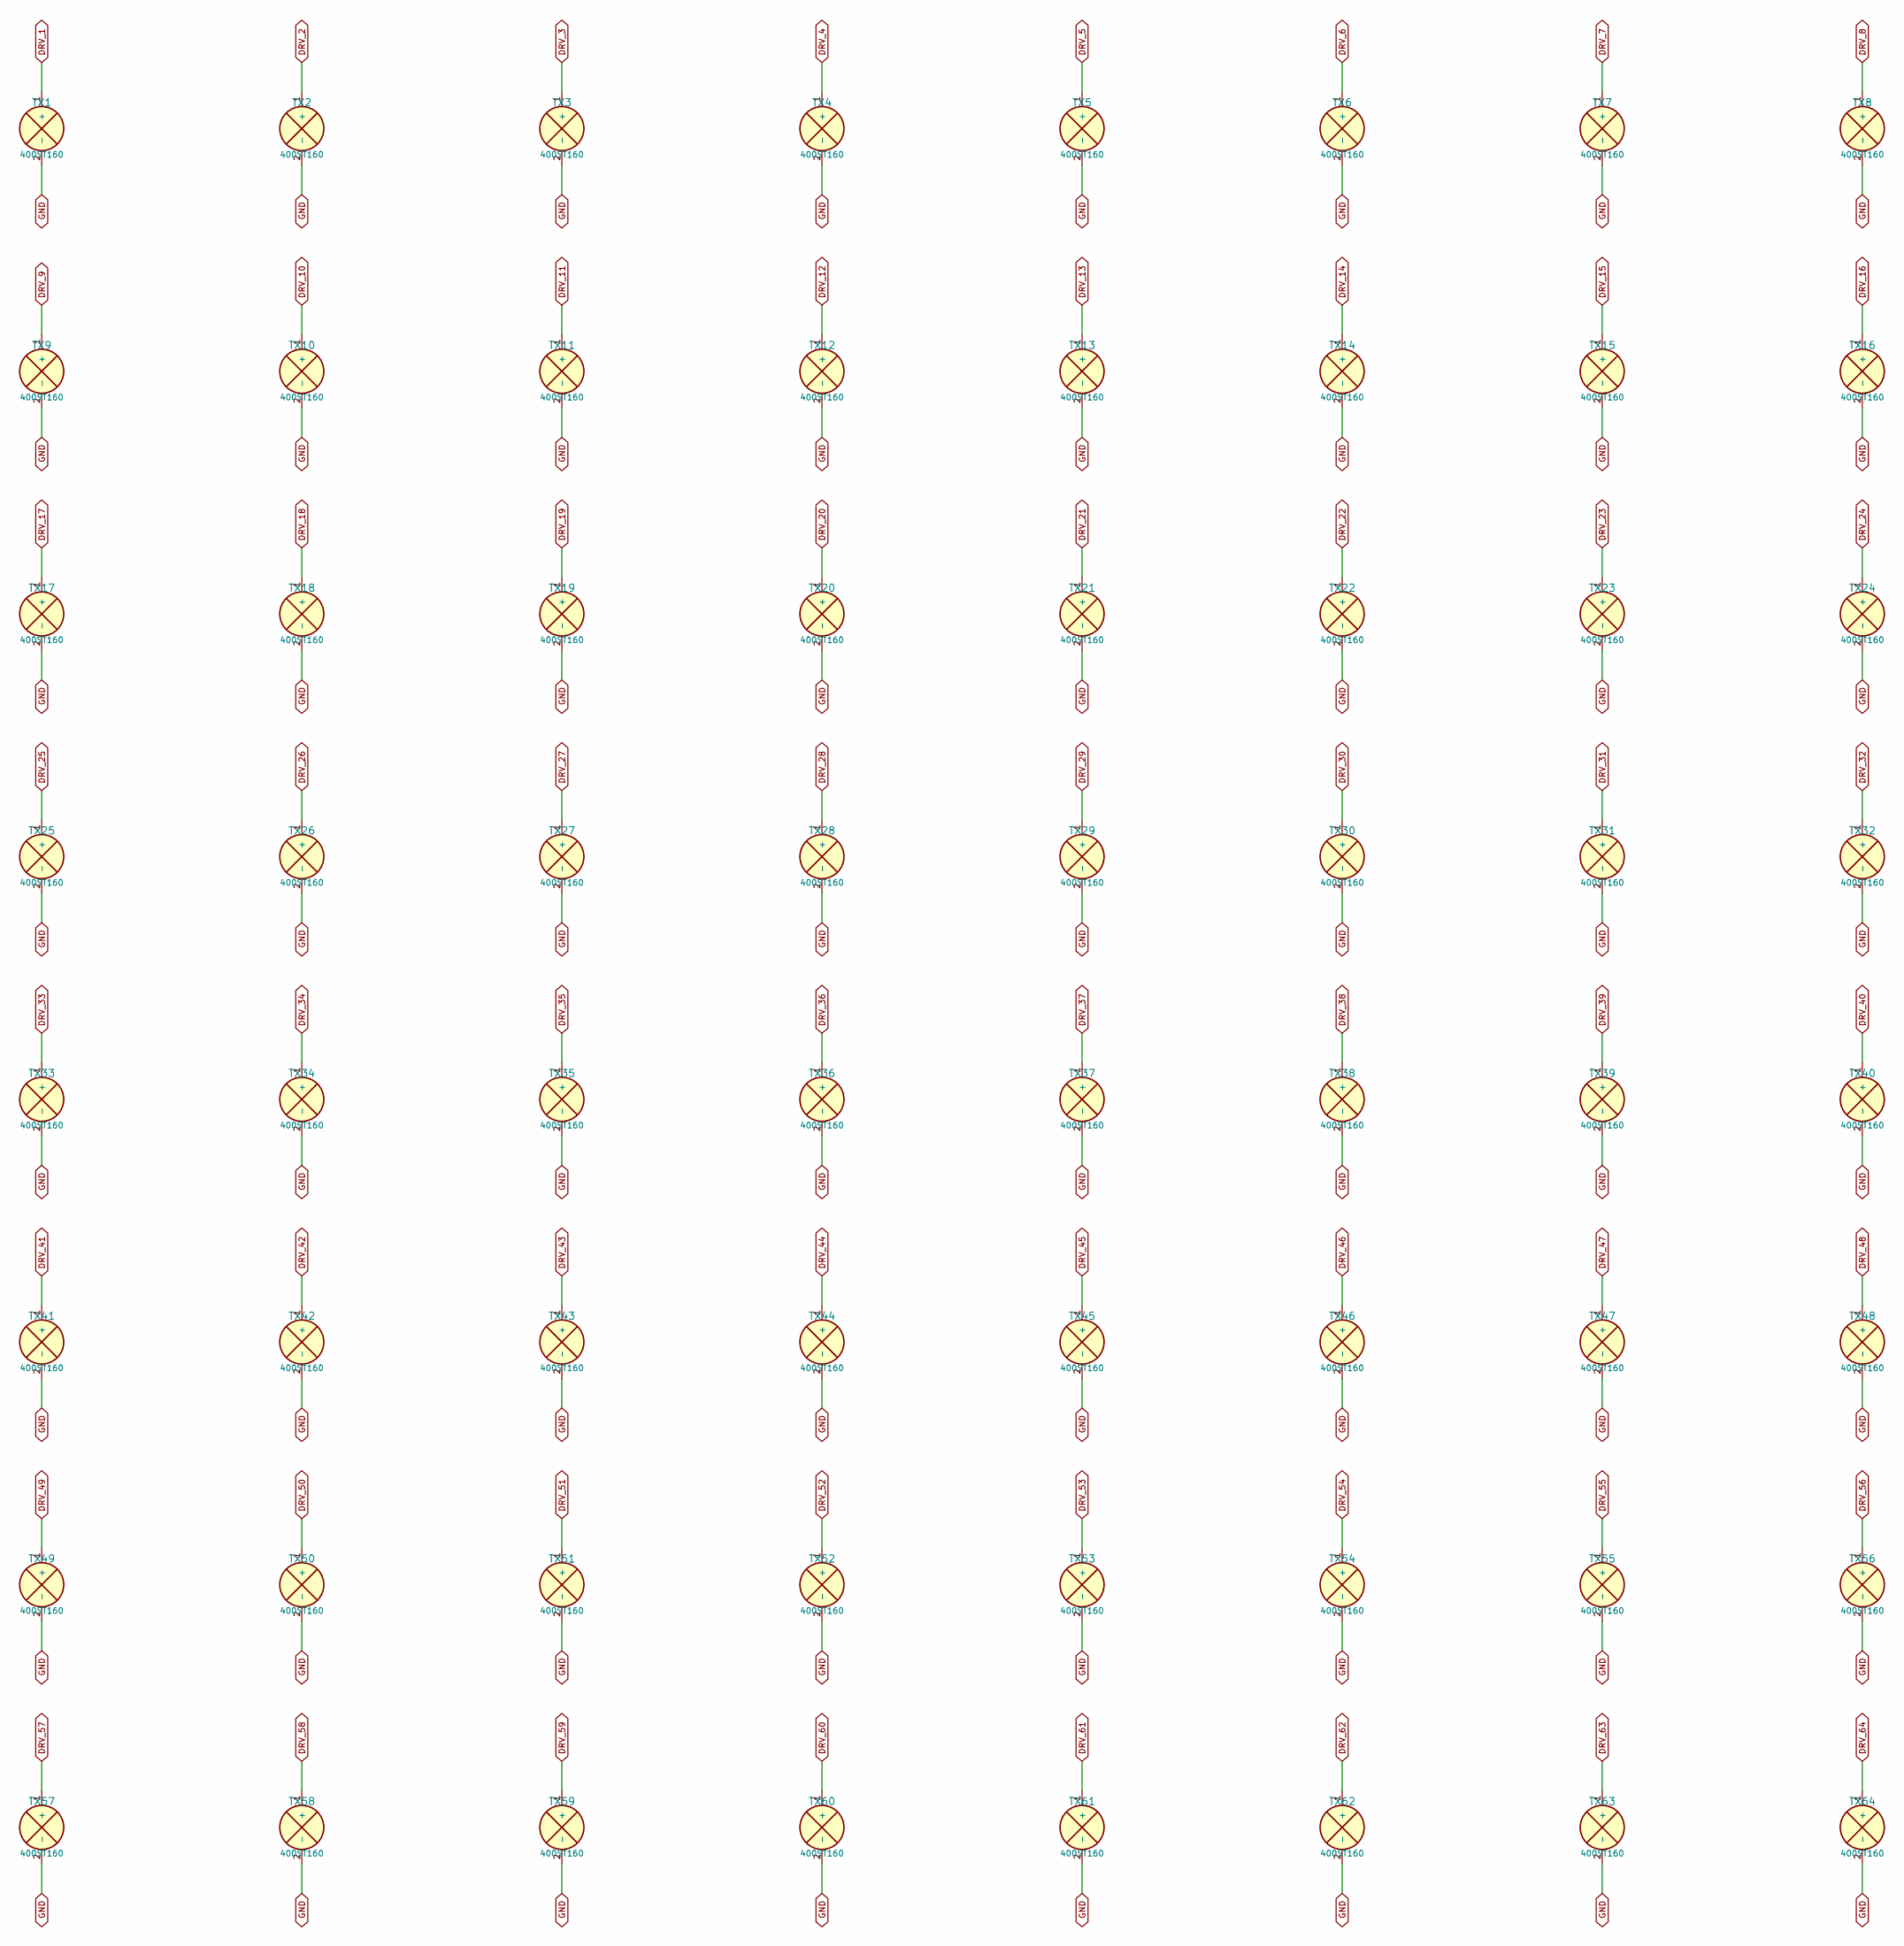
[picture p158: schematic sheet4_transducer_matrix.kicad_sch, Sheet 4: 8x8 Transducer Matrix Grid (64 Elements)]

Parts:
TX1, TX2, TX3, TX4, TX5, TX6, TX7, TX8, TX9, TX10, TX11, TX12, TX13, TX14, TX15, TX16, TX17, TX18, TX19, TX20, TX21, TX22, TX23, TX24, TX25, TX26, TX27, TX28, TX29, TX30, TX31, TX32, TX33, TX34, TX35, TX36, TX37, TX38, TX39, TX40, TX41, TX42, TX43, TX44, TX45, TX46, TX47, TX48, TX49, TX50, TX51, TX52, TX53, TX54, TX55, TX56, TX57, TX58, TX59, TX60, TX61, TX62, TX63, TX64: 400ST160; PinHeader_1x02_P2.54mm_Vertical

Connections:
DRV_1: TX1.1 (+); also elsewhere on the board
DRV_2: TX2.1 (+); also elsewhere on the board
DRV_3: TX3.1 (+); also elsewhere on the board
DRV_4: TX4.1 (+); also elsewhere on the board
DRV_5: TX5.1 (+); also elsewhere on the board
DRV_6: TX6.1 (+); also elsewhere on the board
DRV_7: TX7.1 (+); also elsewhere on the board
DRV_8: TX8.1 (+); also elsewhere on the board
DRV_9: TX9.1 (+); also elsewhere on the board
DRV_10: TX10.1 (+); also elsewhere on the board
DRV_11: TX11.1 (+); also elsewhere on the board
DRV_12: TX12.1 (+); also elsewhere on the board
DRV_13: TX13.1 (+); also elsewhere on the board
DRV_14: TX14.1 (+); also elsewhere on the board
DRV_15: TX15.1 (+); also elsewhere on the board
DRV_16: TX16.1 (+); also elsewhere on the board
DRV_17: TX17.1 (+); also elsewhere on the board
DRV_18: TX18.1 (+); also elsewhere on the board
DRV_19: TX19.1 (+); also elsewhere on the board
DRV_20: TX20.1 (+); also elsewhere on the board
DRV_21: TX21.1 (+); also elsewhere on the board
DRV_22: TX22.1 (+); also elsewhere on the board
DRV_23: TX23.1 (+); also elsewhere on the board
DRV_24: TX24.1 (+); also elsewhere on the board
DRV_25: TX25.1 (+); also elsewhere on the board
DRV_26: TX26.1 (+); also elsewhere on the board
DRV_27: TX27.1 (+); also elsewhere on the board
DRV_28: TX28.1 (+); also elsewhere on the board
DRV_29: TX29.1 (+); also elsewhere on the board
DRV_30: TX30.1 (+); also elsewhere on the board
DRV_31: TX31.1 (+); also elsewhere on the board
DRV_32: TX32.1 (+); also elsewhere on the board
DRV_33: TX33.1 (+); also elsewhere on the board
DRV_34: TX34.1 (+); also elsewhere on the board
DRV_35: TX35.1 (+); also elsewhere on the board
DRV_36: TX36.1 (+); also elsewhere on the board
DRV_37: TX37.1 (+); also elsewhere on the board
DRV_38: TX38.1 (+); also elsewhere on the board
DRV_39: TX39.1 (+); also elsewhere on the board
DRV_40: TX40.1 (+); also elsewhere on the board
DRV_41: TX41.1 (+); also elsewhere on the board
DRV_42: TX42.1 (+); also elsewhere on the board
DRV_43: TX43.1 (+); also elsewhere on the board
DRV_44: TX44.1 (+); also elsewhere on the board
DRV_45: TX45.1 (+); also elsewhere on the board
DRV_46: TX46.1 (+); also elsewhere on the board
DRV_47: TX47.1 (+); also elsewhere on the board
DRV_48: TX48.1 (+); also elsewhere on the board
DRV_49: TX49.1 (+); also elsewhere on the board
DRV_50: TX50.1 (+); also elsewhere on the board
DRV_51: TX51.1 (+); also elsewhere on the board
DRV_52: TX52.1 (+); also elsewhere on the board
DRV_53: TX53.1 (+); also elsewhere on the board
DRV_54: TX54.1 (+); also elsewhere on the board
DRV_55: TX55.1 (+); also elsewhere on the board
DRV_56: TX56.1 (+); also elsewhere on the board
DRV_57: TX57.1 (+); also elsewhere on the board
DRV_58: TX58.1 (+); also elsewhere on the board
DRV_59: TX59.1 (+); also elsewhere on the board
DRV_60: TX60.1 (+); also elsewhere on the board
DRV_61: TX61.1 (+); also elsewhere on the board
DRV_62: TX62.1 (+); also elsewhere on the board
DRV_63: TX63.1 (+); also elsewhere on the board
DRV_64: TX64.1 (+); also elsewhere on the board
GND: TX1.2 (-), TX2.2 (-), TX3.2 (-), TX4.2 (-), TX5.2 (-), TX6.2 (-), TX7.2 (-), TX8.2 (-), TX9.2 (-), TX10.2 (-), TX11.2 (-), TX12.2 (-), TX13.2 (-), TX14.2 (-), TX15.2 (-), TX16.2 (-), TX17.2 (-), TX18.2 (-), TX19.2 (-), TX20.2 (-), TX21.2 (-), TX22.2 (-), TX23.2 (-), TX24.2 (-), TX25.2 (-), TX26.2 (-), TX27.2 (-), TX28.2 (-), TX29.2 (-), TX30.2 (-), TX31.2 (-), TX32.2 (-), TX33.2 (-), TX34.2 (-), TX35.2 (-), TX36.2 (-), TX37.2 (-), TX38.2 (-), TX39.2 (-), TX40.2 (-), TX41.2 (-), TX42.2 (-), TX43.2 (-), TX44.2 (-), TX45.2 (-), TX46.2 (-), TX47.2 (-), TX48.2 (-), TX49.2 (-), TX50.2 (-), TX51.2 (-), TX52.2 (-), TX53.2 (-), TX54.2 (-), TX55.2 (-), TX56.2 (-), TX57.2 (-), TX58.2 (-), TX59.2 (-), TX60.2 (-), TX61.2 (-), TX62.2 (-), TX63.2 (-), TX64.2 (-); also elsewhere on the board

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
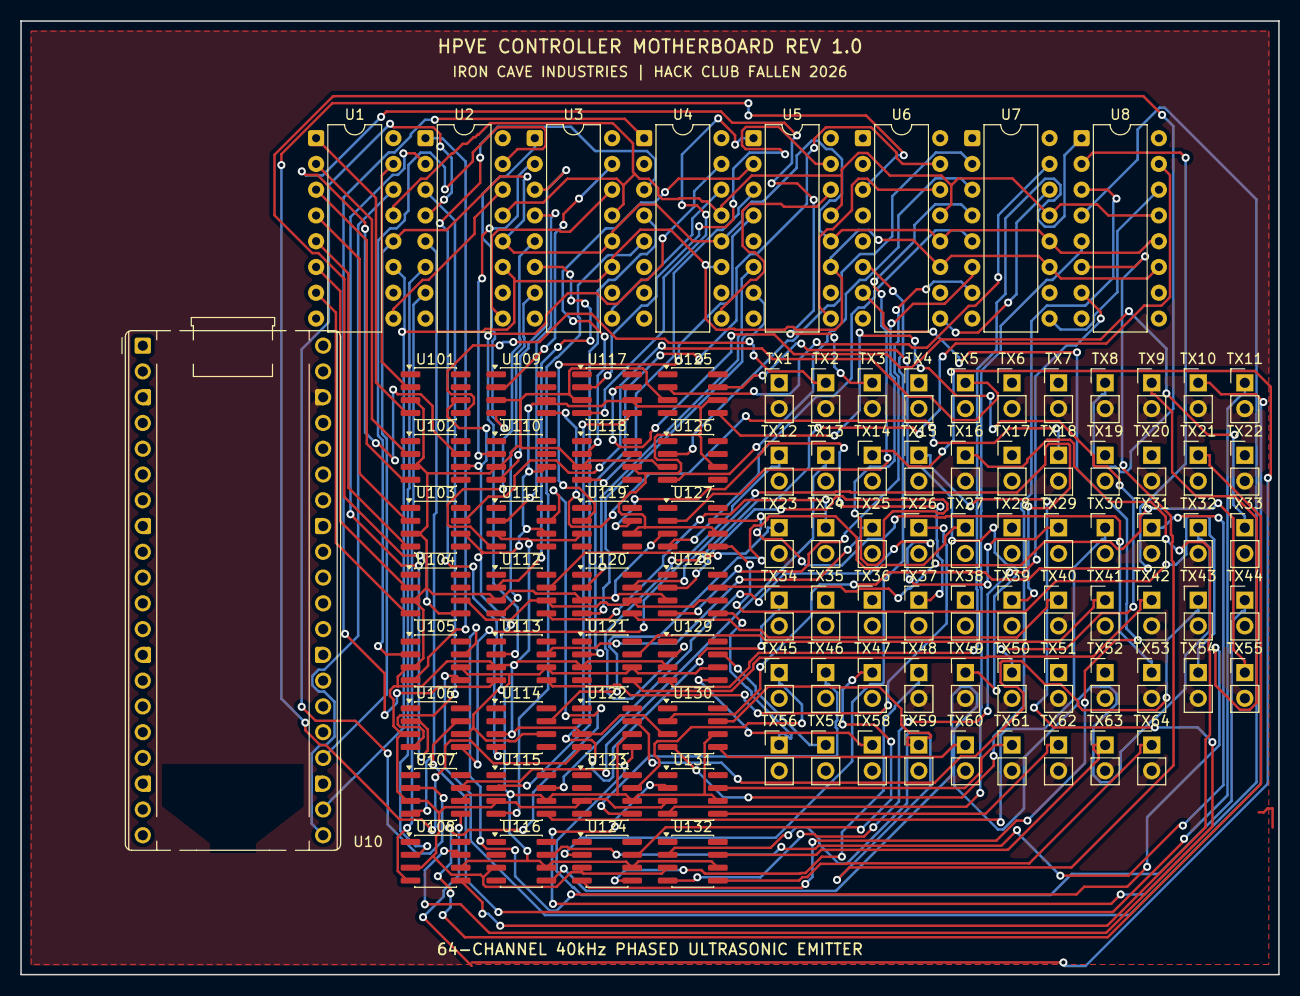
[picture p159: board HPVE_Controller.kicad_pcb from above]

Board: 2 copper layers, 124.0 x 94.0 mm, 105 parts (0 on the bottom side), 142 nets.
