triunex/HPVE-Fallen/(commit log)

2026-10-30 initial commit: project specs, simulation math, and bom
    [bom.csv]
2026-10-30 update bom: add live engineer links, test gear, and refined budget
    [bom.csv]
2026-10-30 feat: add 2D acoustic pressure field visualizer, RP2040 PIO firmware, and pinout architecture
2026-10-30 feat: complete KiCad hierarchical schematics and shift-register SPI timing simulation
    # Conflicts:
    # CAMPAIGN_ROADMAP_45_DAYS.md
    [HPVE_Controller.kicad_sch, sheet1_mcu_core.kicad_sch, sheet2_shift_registers.kicad_sch, sheet3_driver_bank.kicad_sch, sheet4_transducer_matrix.kicad_sch]
2026-10-30 docs: update 6-week roadmap with timing verification and KiCad initialization
2026-10-30 feat: populate all 4 KiCad schematic sheets with embedded symbols and wiring
    [sheet1_mcu_core.kicad_sch, sheet2_shift_registers.kicad_sch, sheet3_driver_bank.kicad_sch, sheet4_transducer_matrix.kicad_sch]
2026-10-30 chore: remove kicad lock file
2026-10-30 fix(kicad): assign valid footprints to all 105 symbols and add visible wiring
    [sheet1_mcu_core.kicad_sch, sheet2_shift_registers.kicad_sch, sheet3_driver_bank.kicad_sch, sheet4_transducer_matrix.kicad_sch]
2026-10-30 Update KiCad symbols and netlist for spotless F8 PCB sync
    [sheet1_mcu_core.kicad_sch, sheet2_shift_registers.kicad_sch, sheet3_driver_bank.kicad_sch, sheet4_transducer_matrix.kicad_sch]
2026-10-30 Auto-route 392 copper tracks for 64-channel HPVE phased array PCB
    [HPVE_Controller.kicad_pcb, sheet1_mcu_core.kicad_sch, sheet2_shift_registers.kicad_sch, sheet3_driver_bank.kicad_sch, sheet4_transducer_matrix.kicad_sch]
2026-10-30 Add 140x140mm Edge.Cuts border and 4x M3 chassis mounting holes
    [HPVE_Controller.kicad_pcb]
2026-10-30 feat(hardware): export factory-ready Gerber and NC drill package for HPVE Motherboard v1.0
    [HPVE_Controller-B_Courtyard.gbr, HPVE_Controller-B_Cu.gbl, HPVE_Controller-B_Fab.gbr, HPVE_Controller-B_Mask.gbs, HPVE_Controller-B_Paste.gbp, HPVE_Controller-B_Silkscreen.gbo, HPVE_Controller-Edge_Cuts.gm1, HPVE_Controller-F_Courtyard.gbr]
2026-10-30 docs: update Day 1 milestone with production Gerber export
2026-10-30 fix(hardware): optimize PCB outline to 108x88mm eliminating empty dead space and centering silkscreen
    [HPVE_Controller-B_Courtyard.gbr, HPVE_Controller-B_Cu.gbl, HPVE_Controller-B_Fab.gbr, HPVE_Controller-B_Mask.gbs, HPVE_Controller-B_Paste.gbp, HPVE_Controller-B_Silkscreen.gbo, HPVE_Controller-Edge_Cuts.gm1, HPVE_Controller-F_Courtyard.gbr]
2026-10-30 feat(hardware): upgrade PCB to 45-degree mitered routing, dual-layer GND copper zones, and KiCad 2D editor render
    [HPVE_Controller-B_Courtyard.gbr, HPVE_Controller-B_Cu.gbl, HPVE_Controller-B_Fab.gbr, HPVE_Controller-B_Mask.gbs, HPVE_Controller-B_Paste.gbp, HPVE_Controller-B_Silkscreen.gbo, HPVE_Controller-Edge_Cuts.gm1, HPVE_Controller-F_Courtyard.gbr]
2026-10-30 fix(hardware): replace male headers with official Pico module and flush transducer pads; polish 3D and 2D renders
    [HPVE_Controller-B_Courtyard.gbr, HPVE_Controller-B_Cu.gbl, HPVE_Controller-B_Fab.gbr, HPVE_Controller-B_Mask.gbs, HPVE_Controller-B_Paste.gbp, HPVE_Controller-B_Silkscreen.gbo, HPVE_Controller-Edge_Cuts.gm1, HPVE_Controller-F_Courtyard.gbr]
2026-10-31 hardware: render Pico U10 footprint as dual female socket receptacles
    [HPVE_Controller.kicad_pcb]
2026-10-31 physics: implement CERN-grade Butterworth-Van Dyke transducer impedance model and 64-ch driver dynamics
2026-10-31 physics: complete dynamic switching, transient spike, PDN rail droop, and RP2040 PIO phased firmware engine
2026-10-31 feat(hardware): 7-hour session 2 sprint - 2,448 tracks & 329 vias routed, 116 shorts eliminated, edge clearance fixed, 124 XP locked
    [HPVE_Controller.dsn, HPVE_Controller.kicad_pcb]
2026-11-01 feat(hardware): finalize modular 16-channel acoustic tile with 0 DRC errors, FFC connectors, and JLCPCB fabrication package
    [HPVE_Tile_16Ch-B_Cu.gbl, HPVE_Tile_16Ch-B_Mask.gbs, HPVE_Tile_16Ch-B_Paste.gbp, HPVE_Tile_16Ch-B_Silkscreen.gbo, HPVE_Tile_16Ch-Edge_Cuts.gm1, HPVE_Tile_16Ch-F_Cu.gtl, HPVE_Tile_16Ch-F_Mask.gts, HPVE_Tile_16Ch-F_Paste.gtp]
2026-11-01 docs(bom): specify X7R ceramic dielectric and LCSC part numbers for JLCPCB SMT assembly
    [HPVE_Tile_16Ch_bom.csv]
2026-11-01 docs(roadmap): update campaign roadmap to 216 XP, Stage 2 Sami evolution, and modular tile architecture
    [HPVE_Tile_16Ch.kicad_pcb]
2026-11-02 fix(production): align BOM and CPL formats with official JLCPCB SMT specification (both CSV and XLSX)
    [HPVE_Tile_16Ch.kicad_pcb, HPVE_Tile_16Ch_BOM.xlsx, HPVE_Tile_16Ch_bom.csv, Sample-BOM_JLCSMT.xlsx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]
2026-11-02 fix(bom): update exact in-stock LCSC part numbers for 74HC595 (C5947), TC4427 (C636891), and 33R (C17631)
    [HPVE_Tile_16Ch_BOM.xlsx, HPVE_Tile_16Ch_bom.csv]
2026-11-02 fix(tile): 10mm transducer lead footprint, 16.5mm pitch, 98x88mm tile; re-routed (DRC 0); regenerate JLCPCB gerbers, BOM, CPL
    [HPVE_Tile_16Ch-B_Cu.gbl, HPVE_Tile_16Ch-B_Mask.gbs, HPVE_Tile_16Ch-B_Paste.gbp, HPVE_Tile_16Ch-B_Silkscreen.gbo, HPVE_Tile_16Ch-Edge_Cuts.gm1, HPVE_Tile_16Ch-F_Cu.gtl, HPVE_Tile_16Ch-F_Mask.gts, HPVE_Tile_16Ch-F_Paste.gtp]
2026-11-02 fix(tile): 100% single-sided top SMT layout, 0 DRC violations, 0 unconnected pads, updated Gerbers/BOM/CPL for JLCPCB Economic tier
    [HPVE_Tile_16Ch-B_Cu.gbl, HPVE_Tile_16Ch-B_Mask.gbs, HPVE_Tile_16Ch-B_Paste.gbp, HPVE_Tile_16Ch-B_Silkscreen.gbo, HPVE_Tile_16Ch-Edge_Cuts.gm1, HPVE_Tile_16Ch-F_Cu.gtl, HPVE_Tile_16Ch-F_Mask.gts, HPVE_Tile_16Ch-F_Paste.gtp]
2026-11-02 feat(firmware): implement complete RP2040 PIO+DMA 64-ch 74HC595 cascade engine, Q16.16 3D wave solver, OLED HUD & HIL verification
    [HPVE_Tile_16Ch.kicad_pcb]
2026-11-03 feat(trajectory): implement Day 6 3D parametric trajectory engine (Arc Reactor SMF, Endgame Moebius strip, Trefoil knot, 200Hz STM Forcefield) & update 45-day roadmap
2026-11-05 feat(cad): generate Day 7 TVA retro-futuristic modular exoskeleton STLs, horn bezels, 2020 clamp and 3D renders
    [HPVE_2x2_Quad_Assembly.stl, HPVE_Acoustic_Horn_Bezel.stl, HPVE_Central_Dock_Sensor.stl, HPVE_Halo_Arch_Clamp.stl, HPVE_Tile_Frame_Dovetail.stl]
2026-11-05 Day 7 Complete: OpenSCAD 4-Tile Exoskeleton CAD, Horn Waveguide Bezel, Central ToF Pod, Halo Arch Rig & 517 XP Stage 3 Telemetry
    [HPVE_2x2_Quad_Assembly.stl, HPVE_Acoustic_Horn_Bezel.stl, HPVE_Central_Dock_Sensor.stl, HPVE_Halo_Arch_Clamp.stl, HPVE_Modular_Exoskeleton.scad, HPVE_Tile_16Ch.kicad_pcb, HPVE_Tile_16Ch_routed_backup_55mm.kicad_pcb, HPVE_Tile_Frame_Dovetail.stl]
2026-11-05 hardware(kicad): complete pristine HPVE_Tile_16Ch schematic with 0 ERC violations and 100% netlist sync
    [HPVE_Tile_16Ch.kicad_sch]
2026-11-05 feat(day-8): 12h marathon lockdown - pristine 0-ERC modular schematic, Anduril exoskeleton CAD, V4 STLs/renders & 628 XP telemetry
    [HPVE_Acoustic_Horn_Bezel.stl, HPVE_Interlock_Corner_Brace.stl, HPVE_Modular_Exoskeleton.scad, HPVE_Rear_Avionics_Dock_Shield.stl, HPVE_Tile_16Ch.kicad_sch, HPVE_Tile_Frame_Dovetail.stl]
2026-11-07 feat(day-9): 703 XP unlocked - VL53L5CX 6D Kalman spatial tracker, autonomous forcefield engine & 4-tile power/signal integrity validation
2026-11-10 feat(day-12): 929 XP unlocked - 35-STL modular breakdown Halo Arch CAD, v1.2 schematic lockdown & print-ready manufacturing suite
    [01_Tile_Frame_Q0_FrontLeft_x1.stl, 05_Acoustic_Horn_Bezel_16Ch_x4.stl, 06_Rear_Avionics_Gimbal_Backplane_x1.stl, 07_Central_VL53L5CX_ToF_Laser_Pod_x1.stl, 08_Halo_Arch_C_Clamp_Pedestal_x2.stl, 09_Halo_Arch_Left_Pillar_x1.stl, 10_Halo_Arch_Right_Pillar_x1.stl, 11_Halo_Arch_Top_Bridge_x1.stl]
2026-11-12 feat(hardware): add self-contained KiCad 10 symbols and 23 footprints for Master Carrier
2026-11-12 feat(hardware): author Master Carrier electrical schematic and netlist architecture
    [HPVE_Master_Carrier.kicad_sch]
2026-11-12 docs(hardware): add vector PDF and SVG schematic exports for Master Carrier
2026-11-12 feat(hardware): configure Specctra DSN and FreeRouting netclass design rules
    [HPVE_Master_Carrier.dsn]
2026-11-12 feat(hardware): add routed 2-layer Master Carrier PCB layout with 0 DRC violations
    [HPVE_Master_Carrier.kicad_pcb]
2026-11-12 feat(hardware): export JLCPCB SMT bill of materials and component centroid placement files
    [HPVE_Master_Carrier_bom.csv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]
2026-11-12 test(hardware): verify 0 DRC, 0 ERC, and 100% schematic parity audit reports
2026-11-12 docs(hardware): add high-resolution 3D raytraced PCB renders for Master Carrier
2026-11-12 docs(submission): lock Stage 3 master BOM ( total / grant), submission manifesto, and carrier Rev 1.4
    [HPVE_MASTER_SUBMISSION_BOM.csv, HPVE_Master_Carrier.kicad_pcb, bom.csv]
